eSpark-Backup/chrisbyrd-esp32iotproduct/Design Files/Adv-OLED-v2.1/Deliverables/Renderings/3D_Isometric_View.png

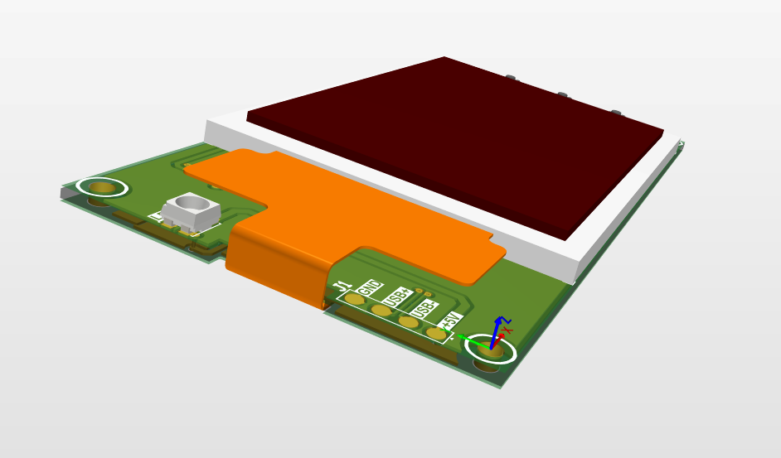
Design Files/Adv-OLED-v2.1/Deliverables/Renderings/3D_Isometric_View.png
