eSpark-Backup/chrisbyrd-esp32iotproduct/Design Files/Adv-OLED-v2.1/Deliverables/Renderings/3D_Top_View.PNG

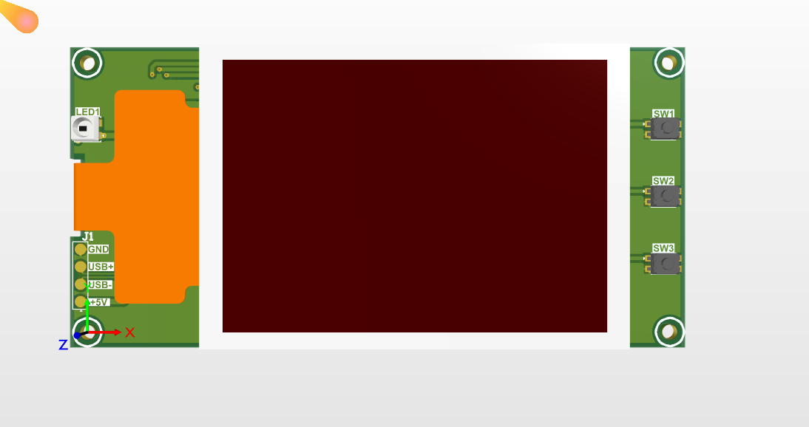
Design Files/Adv-OLED-v2.1/Deliverables/Renderings/3D_Top_View.PNG
