eSpark-Backup/chrisbyrd-esp32iotproduct/Design Files/Baseboard-v2.1/Deliverables/Renderings/2D_C_View.PNG.png

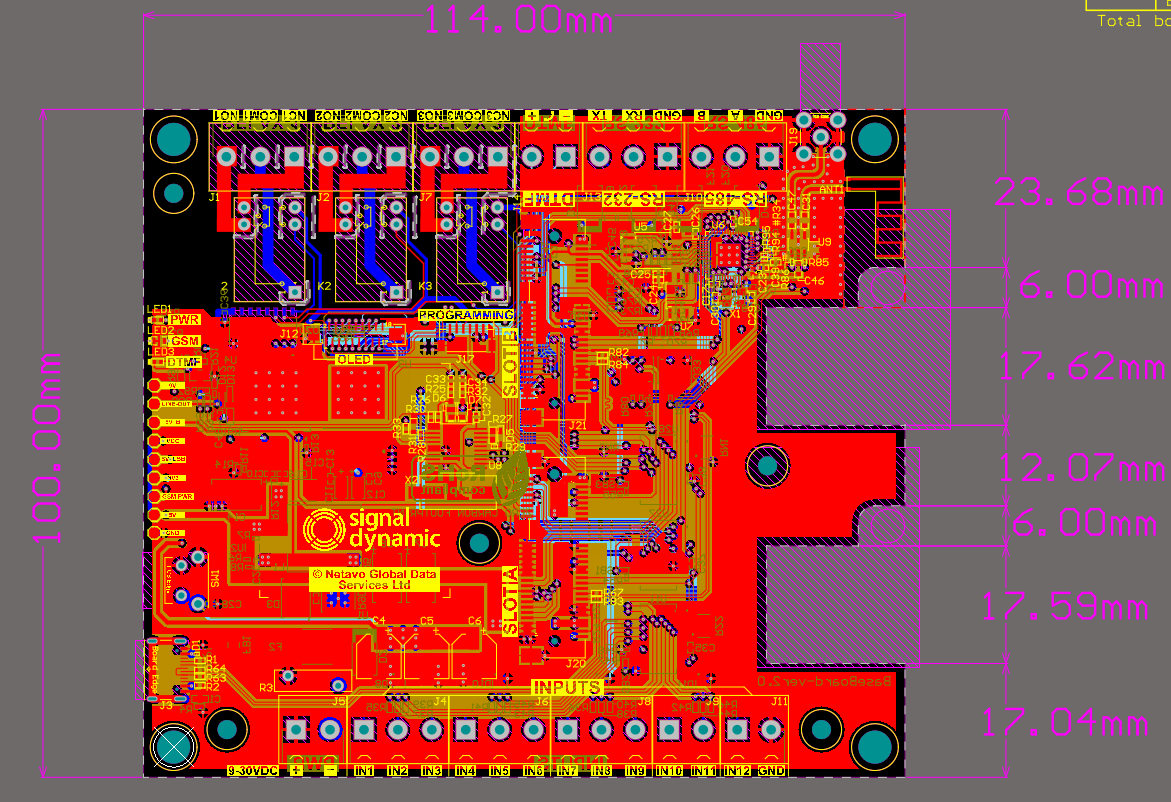
Design Files/Baseboard-v2.1/Deliverables/Renderings/2D_C_View.PNG.png
