eSpark-Backup/chrisbyrd-esp32iotproduct/Design Files/Baseboard-v2.1/Deliverables/Renderings/3D_Isometric_View.png

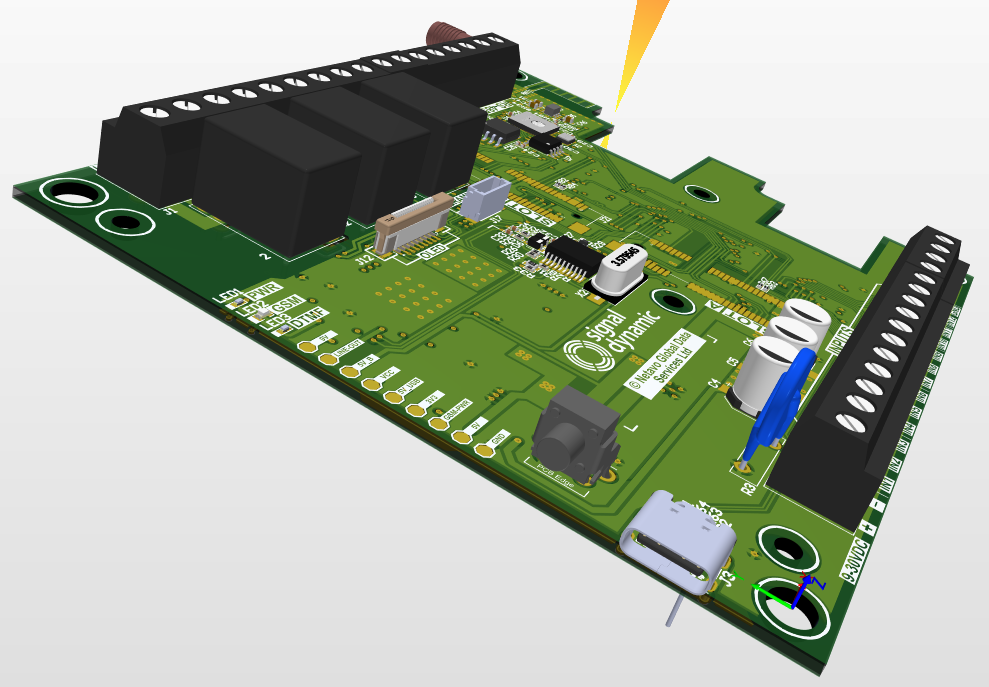
Design Files/Baseboard-v2.1/Deliverables/Renderings/3D_Isometric_View.png
