eSpark-Backup/chrisbyrd-esp32iotproduct/Design Files/LoRaWAN-Module-v2.0/Deliverables/Renderings/3d_Bottom_View.PNG

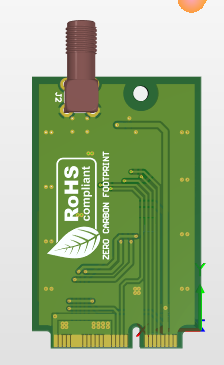
Design Files/LoRaWAN-Module-v2.0/Deliverables/Renderings/3d_Bottom_View.PNG
