eSpark-Backup/chrisbyrd-esp32iotproduct/Design Files/OLED-v2.1/Deliverables/Renderings/2D_Bottom_Layer.PNG

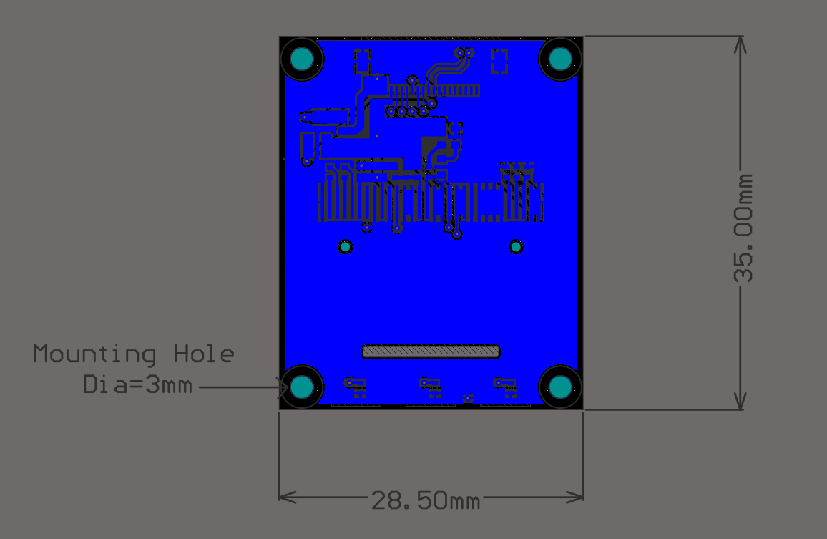
Design Files/OLED-v2.1/Deliverables/Renderings/2D_Bottom_Layer.PNG
