eSpark-Backup/chrisbyrd-esp32iotproduct/Design Files/OLED-v2.1/Deliverables/Renderings/2D_C_View.PNG

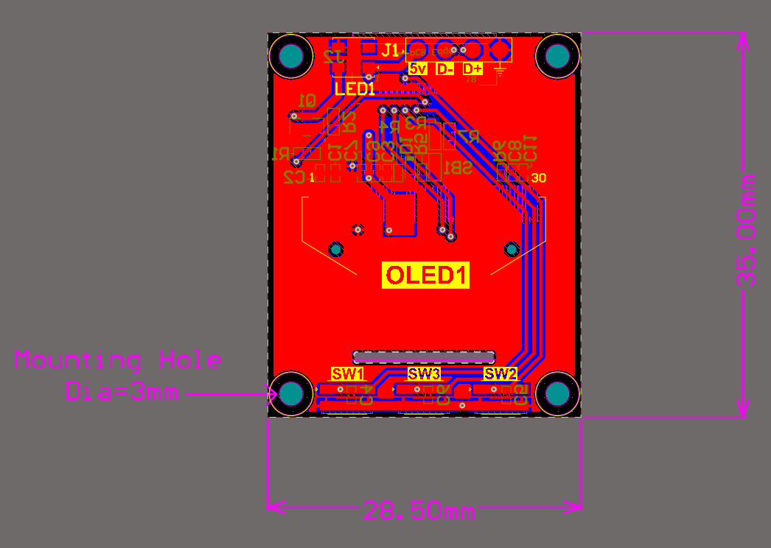
Design Files/OLED-v2.1/Deliverables/Renderings/2D_C_View.PNG
