eSpark-Backup/chrisbyrd-esp32iotproduct/Design Files/OLED-v2.1/Deliverables/Renderings/3D_Isometric_View.png

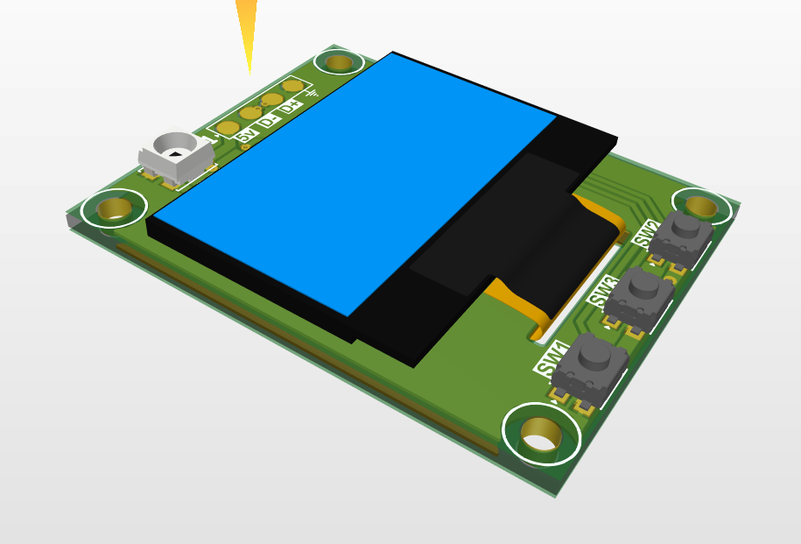
Design Files/OLED-v2.1/Deliverables/Renderings/3D_Isometric_View.png
