eSpark-Backup/chrisbyrd-esp32iotproduct/Design Files/Baseboard-v2.1/BOM/JLCPCB-BOM-Baseboard-v2.0.xlsx

Comment | Designator | Footprint | LCSC Part Number
Antenna | ANT1 | ANT*
4.7nF | C1 | Cap-0603 | C576818
0.1uf | C2, C9, C10, C13, C16, C17, C22, C23, C24, C27, C28, C32, C33, C34, C35, C36, C37, C38, C40, C41, C42, C43, C44, C45, C54 | Cap-0402 | C162178
10nF | C3, C19 | Cap-0402 | C60133
68uF | C4, C5, C6 | RVT1H680M0607 | C5221836
220uF | C7, C8 | Case-D | C8024
10uF | C11 | Case-A | C128253
47uF | C12 | Case-A | C129570
330uF | C14 | Case-E | C51599
100uF | C15 | Case-B | C7196
1uF | C18, C21, C26, C39 | Cap-0402 | C2880413
10uF | C20, C25, C48 | Cap-0402 | C315248
22PF | C29, C30 | Cap-0402 | C106203
330pF | C31, C46, C47 | Cap-0603 | C62784
PESD5V0H1BSFYL | D1 | DSN0603-2 | C477989
SMBJ36CA | D2 | SMB_ | C556189
ST20100L | D3 | TO-277 | C2693410
UDD32C03L01 | D4 | SOD-323 | C78439
1N4148WT | D5, D12, D13 | SOD-523F | C232841
BZT52C5V6S | D6, D7 | SOD-323 | C22612
BZX84C3V3TS-7-F | D8, D9, D10, D11 | SOT-363 | C5124989
SMBJ26CA | D40, D41, D42, D43 | SMB_ | C5331111
1206L300SLTHYR | F1 | Fuse 1206 (3216 Metric) | C207041
SHV2920P500-30-AA | F2 | Fuse-2920 | C495350
SMD0805P020TF | F19, F20, F21, F22 | Fuse-0805 | C20976
100MHz | FB1 | IND-1206 | C85841
DB128L-5.08-3P-BK-S | J1, J2, J4, J6, J7, J8, J10, J13 | DB128L-5.08-3P-BK-S | C430602
TYPE-C-31-M-12 | J3 | TYPE-C-31-M-12_ | C165948
DB128L-5.08-2P-BK-S | J5, J9, J11, J14 | DB128L-5.08-2P-BK-S | C430601
F0503-ZV-18-20T-R | J12 | F0503-ZV-18-20T-R | C481243
Voltlink Target | J17 | Voltlink Target | C145963
HJ-SMA175 | J19 | HJ-SMA175 | C1509213
91304-99-052R2 | J20, J21 | 91304-99-052R2 | C404126
J102K1CS35VDC.20 | K1, K2, K3 | J102K1CS35VDC.20
10uH | L1 | PSPMAA1040-100M-ANP | C2983105
2nH | L2 | IND-0603 (1608 Metric) | C370234
Green | LED1, LED3 | LED-0402 | C74338
RED | LED2 | LED-0603 | C1322287
TEST POINT | P1, P2, P3, P4, P5, P6, P7, P8, P9 | Test-point
MMBT4403LT1G | Q1 | sot-23 | C78864
5.1K | R1, R2 | Res-0402 | C542993
1M | R4 | Res-0402 | C144054
10K | R5, R7, R13, R34, R47, R48, R54, R55, R93, R94, R95, R96 | Res-0201 | C106225
1K | R6, R8, R10, R79, R80, R81, R85, R86 | Res-0201 | C3953443
3.24K | R9 | Res-0603 | C22994
100K | R11, R29 | Res-0201 | C106230
470R | R12, R20 | Res-0201 | C163491
47K | R14, R30 | Res-0402 | C93943
4.7K | R15, R16, R18, R19, R35, R36, R37, R38, R39, R40, R41, R42, R43, R44, R45, R46, R68, R69, R70, R71, R72, R77 | Res-0402 | C105871
499R | R17 | Res-0402 | C137970
0R | R21, R63, R64, R65, R66, R67, R82, R83, R84, R88, R89 | Res-0402 | C106231
100K | R22, R23, R24 | YC164-JR-070RL | C192933
56k | R25, R26, R32, R33 | Res-0402 | C114756
330K | R27 | Res-0603 | C114618
150K | R28 | Res-0402 | C137919
68K | R31 | Res-0603 | C705793
22R | R73, R74, R75, R76 | Res-0402 | C2086081
120R | R78 | Res-0603 | C114640
68R | R87 | Res-0402 | C445573
680R | R90, R91 | Res-0603 | C112310
3.3K | R92 | Res-0402 | C137992
10K | RN1, RN2 | YC164-FR-0710KL | C110924
Solder Bridge 0402 | SB1, SB2, SB3 | Solder Bridge 0402
1825027-8 | SW1 | 1825027-8 | C266196
TPS5450DDAR | U1 | 8-SO-EP_ | C114425
TPS2116DRLR | U2 | SOT-583 | C3235557
LM1084S-3.3/TR | U3 | TO263-3_ | C259972
MIC29302WU-TR | U4 | TO-263-5 (D2PAK) | C11149
W25Q64JVSSIQ TR | U5 | SOIC-8 (208 mil) | C179171
ESP32-S3R8 | U6 | 56-QFN (7x7)
ATECC608B-SSHDA-B | U7 | SOIC-8 | C5444784
MT8870DN1 | U8 | SSOP-20-208mil | C1522106
HMC221BETR | U9 | SOT-23-6 | C661296
MCP23017T-E/SS | U11, U27, U28 | SSOP-28-208mil | C558584
ULN2003A | U20 | SOP-16_150mil | C181730
MAX3232IDR | U30 | SOIC-16 | C18261
SP3485EIM/TR | U31 | SOP-8 | C519086
ADUM1201ARZ-RL7 | U32 | SOIC-8 | C9669
ADUM1200ARZ-RL7 | U33 | SOIC-8 | C15219
40MHz | X1 | X322540MPB4SI_ | C9010
3.579545MHz | X2 | HC-49S-SMD | C362352
