eSpark-Backup/chrisbyrd-esp32iotproduct/Design Files/LTE-Module-v2.0/BOM/JLCPCB-BOM-LTE_MODULE_v2.0.xlsx

Comment | Designator | Footprint | LCSC Part Number
W3011 | ANT1 | W3011
2.2pF | C1 | Cap-0603 | C282246
33pF | C2 | Cap-0402 | C441758
0.1uF | C5, C11, C13, C15, C16, C17 | Cap-0603 | C110022
220uF | C6 | Case-B | C30242
1uF | C7 | Cap-0603 | C14664
22PF | C8, C9, C10 | Cap-0402 | C106203
100nF | C12, C14 | cap-0402 | C361198
MMSZ5231BT1G | D1 | SOD-123 | C66198
ESD5651N-2/TR | D2, D3 | DFN1006-2L_ | C239784
PESD5V0H1BSFYL | D4 | DSN0603-2 | C477989
ESD5302F-3/TR | D5 | Sot-23 | C239643
SMD0603-050 | F1 | Fuse-0603 | C69679
HJ-SMA175 | J1 | HJ-SMA175 | C1509213
Mini PCIe | J2 | Mini PCIE Pad
POGO Connector 4 Pin | J3 | Pogo 4 Pin
XKNANO-113 | J4, J5 | XKNANO-113 | C381071
Yellow | LED1 | LED-0603 | C93689
RED | LED2 | LED-0603 | C1322287
MMBT3904M | Q1, Q2, Q3, Q4 | SOT-723 | C2923360
10K | R1, R2, R12 | Res-0603 | C140867
22R | R3, R5 | Res-0603 | C107701
0R | R4, R19 | Res-0603 | C100044
180R | R6, R9 | Res-0603 | C137786
4.7K | R7, R10, R13, R17 | Res-0603 | C105428
47K | R8, R11, R14, R18 | Res-0603 | C127447
SIM7500E | U1 | SIM7500E | C126259
FSA2567MPX | U2 | 16-MLP (3x3) | C512961
SMF05CT1G-ES | U3, U4 | SOT-363 | C5180312
TXB0102DCUT | U5 | VSSOP-8(2x2.3x0.5) | C2677366
