eSpark-Backup/chrisbyrd-esp32iotproduct/Design Files/OLED-v2.1/BOM/JLCPCB-BOM-OLED-v2.0.xlsx

Comment | Designator | Footprint | LCSC Part Number
1uF | C1, C2, C3, C9 | Cap-0402 | C106254
0.1uF | C4, C5, C6, C7 | Cap-0402 | C2181865
4.7uF | C8 | Cap-0402 | C326586
2.2uf | C11 | Cap-0402 | C385032
1SS355WT | D1 | SOD-523 | C2836063
POGO Connector 4 Pin | J1 | Pogo 4 Pin
F0502-B-18-15T-R | J2 | F0502-B-18-15T-R | C2889974
WS2812B-Mini | LED1 | WS2812B-Mini | C527089
N096-2864KSWEG01-H30 | OLED1 | N096-2864KSWEG01-H30 | C2890596
BSS138 | Q1 | Sot-23 | C426569
10K | R1, R2, R3, R7 | Res-0603 | C95204
4.7K | R4 | Res-0402 | C413001
0R | R5 | Res-0402 | C106231
412K | R6 | Res-0402 | C5126037
Solder Bridge 0603 | SB1 | Solder Bridge
TS-1185EC-C-D-B | SW1, SW2, SW3 | TS-1185EC-C-D-B_ | C318893
