eSpark-Backup/chrisbyrd-esp32iotproduct/Design Files/Adv-OLED-v2.1/BOM/Client_BOM_OLED-v2.0.xlsx

 |  | Component list |  | Bill of Materials for Project [OLED-v2.0.]
 |  | Source Data From: |  | OLED-v2.0.
 |  | Project: |  | OLED-v2.0.
 |  | Variant: |  | None
# | Item Type | Designator | Description | Footprint | Manufacturer Part Number | Manufacturer | Alternate Part Number | Value | Quantity | Quantity 5 Board | Remarks
1 | Capacitor | C4, C5, C6, C7 | CAP CER 0.1UF 50V X5R 0402 | Cap-0402 | C1005X5R1H104K050BB | TDK | - | 0.1uF | 4 | 20
2 | Capacitor | C9 | CAP CER 1UF 10V X5R 0402 | Cap-0402 | CC0402KRX5R6BB105 | Yageo | - | 1uF | 1 | 5
3 | Pogo Connector | ~~J1~~ | ~~Pogo Pad 2.5mm 4 Pin~~ | ~~Pogo 4 Pin~~ | ~~POGO Connector 4 Pin~~ | ~~-~~ | ~~-~~ | ~~-~~ | ~~1~~ | 5
4 | FPC Connector | J2, J3 | Clamshell -25℃~+85℃ 18P Bottom Contact Surface Mount 0.5mm SMD,P=0.5mm FFC/FPC Connectors ROHS | Custom | F0502-B-18-15T-R | XFCN | - | - | 2 | 10
5 | RGB LED | LED1 | SMD,3.5x3.5mm Light Emitting Diodes (LED) RoHS | Custom | WS2812B-Mini | Worldsemi | - | - | 1 | 5
6 | Mosfet | Q1 | 50V 220mA 3.5Ω@10V,220mA 225mW 1.6V@1mA N Channel SOT-23 MOSFETs ROHS | Sot-23 | BSS138 | Slkor(SLKORMICRO Elec.) | - | - | 1 | 5
7 | Mosfet | Q2 | Trans Gp Bjt NPN 25V 1.5A 300MW 3-PIN SOT-23 T/r | SOT-23 | SS8050-G | Comchip | - | - | 1 | 5
8 | Resistor | R1, R2, R3 | RES SMD 10K OHM 1% 1/20W 0201 | Res-0201 | RC0201FR-0710KL | Yageo | - | 10K | 3 | 15
9 | Resistor | R4 | RES 1K OHM 1% 1/20W 0201 | Res-0201 | RC0201FR-071KP | Yageo | RC0201FR-071KL | 1K | 1 | 5
10 | Resistor | R5, R6, R7, R8 | RES SMD 10 OHM 1% 1/5W 0402 | Res-0402 | CRCW040210R0FKEDHP | Vishay Dale | - | 10R | 4 | 20
11 | Switch | SW1, SW2, SW3 | 3mm 2mm Round Button 50mA Top3.65mm SPST 12V SMD Tactile Switches | Custom | TS-1185EC-C-D-B | XKB | - |  | 3 | 15
12 | Peripheral | - | 0.3mm~0.3mm 18 0.5mm Same Side 5cm P=0.5mm FFC/FPC Connect Cables ROHS | - | JS05A-18P-050-4-8 | JUSHUO | - | - | 1 | 5
12 | Peripheral | - | 2.4-inch tft LCD display SPI serial port color ST7789ILI9341 4IO port can be driven | - | ST7789ILI9341 | - | - | - | 1 | 5 | Reference Link (https://item.taobao.com/item.htm?spm=a1z09.2.0.0.41c32e8dRiNenm&id=45758568009&_u=2nd0n7r49f0)
