eSpark-Backup/chrisbyrd-esp32iotproduct/Design Files/Adv-OLED-v2.1/BOM/eSpark_BOM_OLED-v2.0.xlsx

 |  | Component list |  | Bill of Materials for Project [OLED-v2.0.]
 |  | Source Data From: |  | OLED-v2.0.
 |  | Project: |  | OLED-v2.0.
 |  | Variant: |  | None
# | Item Type | Designator | Description | Footprint | Manufacturer Part Number | Manufacturer | Alternate Part Number | LCSC Part Number | Value | Quantity | Quantity (5 Boards) | MOQ (5 Boards) | Links | Unit Cost (5 Boards) | Total Cost (5 Boards) | Remarks | Reviewer Remarks
1 | Capacitor | C4, C5, C6, C7 | CAP CER 0.1UF 50V X5R 0402 | Cap-0402 | C1005X5R1H104K050BB | TDK | - | C2181865 | 0.1uF | 4 | 20 | 25 | LCSC (https://www.lcsc.com/product-detail/Multilayer-Ceramic-Capacitors-MLCC-SMD-SMT_TDK-C1005X5R1H104K050BB_C2181865.html) | $0.0957 | $2.3925
2 | Capacitor | C9 | CAP CER 1UF 10V X5R 0402 | Cap-0402 | CC0402KRX5R6BB105 | Yageo | - | C106254 | 1uF | 1 | 5 | 100 | LCSC (https://www.lcsc.com/product-detail/Multilayer-Ceramic-Capacitors-MLCC-SMD-SMT_YAGEO-CC0402KRX5R6BB105_C106254.html) | $0.0024 | $0.2400
3 | Pogo Connector | ~~J1~~ | ~~Pogo Pad 2.5mm 4 Pin~~ | ~~Pogo 4 Pin~~ | ~~POGO Connector 4 Pin~~ | ~~-~~ | ~~-~~ | ~~-~~ | ~~-~~ | ~~1~~ | ~~5~~ | ~~-~~ | ~~-~~ | ~~-~~ | ~~-~~ | ~~-~~ | ~~-~~
4 | FPC Connector | J2, J3 | Clamshell -25℃~+85℃ 18P Bottom Contact Surface Mount 0.5mm SMD,P=0.5mm FFC/FPC Connectors ROHS | Custom | F0502-B-18-15T-R | XFCN | - | C2889974 | - | 2 | 10 | 15 | LCSC (https://www.lcsc.com/product-detail/FFC-FPC-Connectors_XFCN-F0502-B-18-15T-R_C2889974.html) | $0.0975 | $1.4625
5 | RGB LED | LED1 | SMD,3.5x3.5mm Light Emitting Diodes (LED) RoHS | Custom | WS2812B-Mini | Worldsemi | - | C527089 | - | 1 | 5 | 10 | LCSC (https://www.lcsc.com/product-detail/Light-Emitting-Diodes-LED_Worldsemi-WS2812B-Mini_C527089.html) | $0.1176 | $1.1760
6 | Mosfet | Q1 | 50V 220mA 3.5Ω@10V,220mA 225mW 1.6V@1mA N Channel SOT-23 MOSFETs ROHS | Sot-23 | BSS138 | Slkor(SLKORMICRO Elec.) | - | C426569 | - | 1 | 5 | 20 | LCSC (https://www.lcsc.com/product-detail/MOSFETs_Slkor-SLKORMICRO-Elec-BSS138_C426569.html) | $0.0215 | $0.4300
7 | Mosfet | Q2 | Trans Gp Bjt NPN 25V 1.5A 300MW 3-PIN SOT-23 T/r | SOT-23 | SS8050-G | Comchip | - | C105433 | - | 1 | 5 | 50 | LCSC (https://www.lcsc.com/product-detail/Bipolar-Transistors-BJT_Jiangsu-Changjing-Electronics-Technology-Co-Ltd-S8050_C105433.html) | $0.0154 | $0.7700
8 | Resistor | R1, R2, R3 | RES SMD 10K OHM 1% 1/20W 0201 | Res-0201 | RC0201FR-0710KL | Yageo | - | C106225 | 10K | 3 | 15 | 100 | LCSC (https://www.lcsc.com/product-detail/Chip-Resistor-Surface-Mount_YAGEO-RC0201FR-0710KL_C106225.html) | $0.0009 | $0.0900
9 | Resistor | R4 | RES 1K OHM 1% 1/20W 0201 | Res-0201 | RC0201FR-071KP | Yageo | RC0201FR-071KL | C138165 | 1K | 1 | 5 | 100 | LCSC (https://www.lcsc.com/product-detail/Chip-Resistor-Surface-Mount_YAGEO-RC0201FR-071KL_C138165.html) | $0.0009 | $0.0900
10 | Resistor | R5, R6, R7, R8 | RES SMD 10 OHM 1% 1/5W 0402 | Res-0402 | CRCW040210R0FKEDHP | Vishay Dale | - | C4013850 | 10R | 4 | 20 | 40 | LCSC (https://www.lcsc.com/product-detail/Chip-Resistor-Surface-Mount_Vishay-Intertech-CRCW040210R0FKEDHP_C4013850.html) | $0.0110 | $0.4400
11 | Switch | SW1, SW2, SW3 | 3mm 2mm Round Button 50mA Top3.65mm SPST 12V SMD Tactile Switches | Custom | TS-1185EC-C-D-B | XKB | - | C318893 |  | 3 | 15 | 20 | LCSC (https://www.lcsc.com/product-detail/Tactile-Switches_XKB-Connectivity-TS-1185EC-C-D-B_C318893.html) | $0.0555 | $1.1100
12 | Peripheral | - | 0.3mm~0.3mm 18 0.5mm Same Side 5cm P=0.5mm FFC/FPC Connect Cables ROHS | - | JS05A-18P-050-4-8 | JUSHUO | - | C2857498 | - | 1 | 5 | 10 | LCSC (https://www.lcsc.com/product-detail/FFC-FPC-Connect-Cables_JUSHUO-JS05A-18P-050-4-8_C2857498.html) | $0.0832 | $0.8320
13 | Peripheral | - | 2.4-inch tft LCD display SPI serial port color ST7789ILI9341 4IO port can be driven | - | - |  | - | - | - | 1 | 5 | 6 | Taobao (https://item.taobao.com/item.htm?spm=a1z09.2.0.0.41c32e8dRiNenm&id=45758568009&_u=2nd0n7r49f0) |  | $0.0000 |  | Quote Required
 |  |  |  |  |  |  |  |  |  |  |  | Total Component Cost |  |  | $9.03
 |  |  |  |  |  |  |  |  |  |  |  | Single Board Cost |  |  | $1.81
