eSpark-Backup/chrisbyrd-esp32iotproduct/Design Files/OLED-v2.1/BOM/Client_BOM_OLED-v2.0.xlsx

 |  | Component list |  | Bill of Materials for Project [OLED-v2.0.]
 |  | Source Data From: |  | OLED-v2.0.
 |  | Project: |  | OLED-v2.0.
 |  | Variant: |  | None
# | Item Type | Designator | Description | Footprint | Manufacturer Part Number | Alternate Part Number | Manufacturer | Value | Quantity | Quantity (10 Boards) | Remarks
1 | Capacitor | C1, C2, C3, C9 | CAP CER 1UF 10V X5R 0402 | Cap-0402 | CC0402KRX5R6BB105 | - | Yageo | 1uF | 4 | 40
2 | Capacitor | C4, C5, C6, C7 | CAP CER 0.1UF 50V X5R 0402 | Cap-0402 | C1005X5R1H104K050BB | - | TDK | 0.1uF | 4 | 40
3 | Capacitor | C8 | CAP CER 4.7UF 10V X5R 0402 | Cap-0402 | ~~CC0402KRX5R6BB475~~ | CL05A475KP5NRNC | Yageo | 4.7uF | 1 | 10
4 | Capacitor | C11 | CAP CER 2.2UF 25V X5R 0402 | Cap-0402 | GRM155R61E225KE11D | - | Murata | 2.2uf | 1 | 10
5 | Diode | D1 | 80V Single 1.2V@100mA 4ns 100mA SOD-523 Switching Diode ROHS | SOD-523 | 1SS355WT | - | CBI | - | 1 | 10
6 | Pogo Connector | ~~J1~~ | ~~Pogo Pad 2.5mm 4 Pin~~ | ~~Pogo 4 Pin~~ | ~~POGO Connector 4 Pin~~ | - | ~~-~~ | ~~-~~ | ~~1~~ | 10
7 | FPC Connector | J2 | Clamshell -25℃~+85℃ 18P Bottom Contact Surface Mount 0.5mm SMD,P=0.5mm FFC/FPC Connectors ROHS | Custom | F0502-B-18-15T-R | - | XFCN | - | 1 | 10
8 | RGB LED | LED1 | SMD,3.5x3.5mm Light Emitting Diodes (LED) RoHS | Custom | WS2812B-Mini | - | Worldsemi |  | 1 | 10
9 | OLED | OLED1 | SSD1306 0.96 - OLED Displays Modules ROHS | Custom | N096-2864KSWEG01-H30 | - | Newvisio |  | 1 | 10
10 | Mosfet | Q1 | 50V 220mA 3.5Ω@10V,220mA 225mW 1.6V@1mA N Channel SOT-23 MOSFETs ROHS | Sot-23 | BSS138 | - | Slkor(SLKORMICRO Elec.) |  | 1 | 10
11 | Resistor | R1, R2, R3, R7 | RES SMD 10K OHM 0.1% 1/10W 0603 | Res-0603 | RT0603BRD0710KL | - | Yageo | 10K | 4 | 40
12 | Resistor | R4 | RES SMD 4.7K OHM 5% 1/10W 0402 | Res-0402 | ERJ-2GEJ472X | - | Panasonic | 4.7K | 1 | 10
13 | Resistor | R5 | RES 0 OHM JUMPER 1/16W 0402 | Res-0402 | RC0402FR-070RL | - | Yageo | 0R | 1 | 10
14 | Resistor | R6 | ±1% 412kΩ 0402 Chip Resistor - Surface Mount ROHS | Res-0402 | FRC0402F4123TS | - | FOJAN | 412K | 1 | 10
15 | Solder Bridge | ~~SB1~~ | ~~Solder Bridge ON~~ | ~~Custom~~ | ~~Solder Bridge~~ | - | ~~-~~ | ~~-~~ | ~~1~~ | 10
16 | Switch | SW1, SW2, SW3 | 3mm 2mm Round Button 50mA Top3.65mm SPST 12V SMD Tactile Switches | Custom | TS-1185EC-C-D-B | - | XKB | - | 3 | 30
17 | Peripheral | - | 0.3mm~0.3mm 18 0.5mm Same Side 5cm P=0.5mm FFC/FPC Connect Cables ROHS | - | JS05A-18P-050-4-8 | - | JUSHUO | - | 1 | 10
