eSpark-Backup/chrisbyrd-esp32iotproduct/Design Files/OLED-v2.1/BOM/eSpark_BOM_OLED-v2.0.xlsx

Sheet: 5 Boards
 |  | Component list |  | Bill of Materials for Project [OLED-v2.0.]
 |  | Source Data From: |  | OLED-v2.0.
 |  | Project: |  | OLED-v2.0.
 |  | Variant: |  | None
# | Item Type | Designator | Description | Footprint | Manufacturer Part Number | Manufacturer | Alternate Part Number | LCSC Part Number | Value | Quantity | Quantity (5 Boards) | MOQ (5 Boards) | Links | Unit Cost (5 Boards) | Total Cost (5 Boards) | Remarks | Reviewer Remarks
1 | Capacitor | C1, C2, C3, C9 | CAP CER 1UF 10V X5R 0402 | Cap-0402 | CC0402KRX5R6BB105 | Yageo | - | C106254 | 1uF | 4 | 20 | 100 | LCSC (https://www.lcsc.com/product-detail/Multilayer-Ceramic-Capacitors-MLCC-SMD-SMT_YAGEO-CC0402KRX5R6BB105_C106254.html) | $0.0024 | $0.2400
2 | Capacitor | C4, C5, C6, C7 | CAP CER 0.1UF 50V X5R 0402 | Cap-0402 | C1005X5R1H104K050BB | TDK | - | C2181865 | 0.1uF | 4 | 20 | 25 | LCSC (https://www.lcsc.com/product-detail/Multilayer-Ceramic-Capacitors-MLCC-SMD-SMT_TDK-C1005X5R1H104K050BB_C2181865.html) | $0.0957 | $2.3925
3 | Capacitor | C8 | CAP CER 4.7UF 10V X5R 0402 | Cap-0402 | CC0402KRX5R6BB475 | Yageo | - | C326586 | 4.7uF | 1 | 5 | 50 | LCSC (https://www.lcsc.com/product-detail/Multilayer-Ceramic-Capacitors-MLCC-SMD-SMT_YAGEO-CC0402KRX5R6BB475_C326586.html) | $0.0146 | $0.7300
4 | Capacitor | C11 | CAP CER 2.2UF 25V X5R 0402 | Cap-0402 | GRM155R61E225KE11D | Murata | - | C385032 | 2.2uf | 1 | 5 | 20 | LCSC (https://www.lcsc.com/product-detail/Multilayer-Ceramic-Capacitors-MLCC-SMD-SMT_Murata-Electronics-GRM155R61E225KE11D_C385032.html) | $0.0317 | $0.6340
5 | Diode | D1 | 80V Single 1.2V@100mA 4ns 100mA SOD-523 Switching Diode ROHS | SOD-523 | 1SS355WT | CBI |  | C2836063 | - | 1 | 5 | 50 | LCSC (https://www.lcsc.com/product-detail/Switching-Diode_CBI-1SS355WT_C2836063.html) | $0.0099 | $0.4950
6 | Pogo Connector | ~~J1~~ | ~~Pogo Pad 2.5mm 4 Pin~~ | ~~Pogo 4 Pin~~ | ~~POGO Connector 4 Pin~~ | ~~-~~ | ~~-~~ | ~~-~~ | ~~-~~ | ~~1~~ | ~~5~~ | ~~-~~ | ~~-~~ | ~~-~~ | ~~-~~ | ~~-~~ | ~~-~~
7 | FPC Connector | J2 | Clamshell -25℃~+85℃ 18P Bottom Contact Surface Mount 0.5mm SMD,P=0.5mm FFC/FPC Connectors ROHS | Custom | F0502-B-18-15T-R | XFCN | - | C2889974 | - | 1 | 5 | 10 | LCSC (https://www.lcsc.com/product-detail/FFC-FPC-Connectors_XFCN-F0502-B-18-15T-R_C2889974.html) | $0.0981 | $0.9810
8 | RGB LED | LED1 | SMD,3.5x3.5mm Light Emitting Diodes (LED) RoHS | Custom | WS2812B-Mini | Worldsemi | - | C527089 | - | 1 | 5 | 10 | LCSC (https://www.lcsc.com/product-detail/Light-Emitting-Diodes-LED_Worldsemi-WS2812B-Mini_C527089.html) | $0.1176 | $1.1760
9 | OLED | OLED1 | SSD1306 0.96 - OLED Displays Modules ROHS | Custom | N096-2864KSWEG01-H30 | Newvisio | - | C2890596 | - | 1 | 5 | 6 | LCSC (https://www.lcsc.com/product-detail/OLED-Displays-Modules_Newvisio-N096-2864KSWEG01-H30_C2890596.html) | $1.9235 | $11.5410
10 | Mosfet | Q1 | 50V 220mA 3.5Ω@10V,220mA 225mW 1.6V@1mA N Channel SOT-23 MOSFETs ROHS | Sot-23 | BSS138 | Slkor(SLKORMICRO Elec.) | - | C426569 | - | 1 | 5 | 20 | LCSC (https://www.lcsc.com/product-detail/MOSFETs_Slkor-SLKORMICRO-Elec-BSS138_C426569.html) | $0.0215 | $0.4300
11 | Resistor | R1, R2, R3, R7 | RES SMD 10K OHM 0.1% 1/10W 0603 | Res-0603 | RT0603BRD0710KL | Yageo | - | C95204 | 10K | 4 | 20 | 40 | LCSC (https://www.lcsc.com/product-detail/Chip-Resistor-Surface-Mount_YAGEO-RT0603BRD0710KL_C95204.html) | $0.0217 | $0.8680
12 | Resistor | R4 | RES SMD 4.7K OHM 5% 1/10W 0402 | Res-0402 | ~~ERJ-2GEJ472X~~ | Panasonic | 0402WGF4701TCE | C25900 | 4.7K | 1 | 5 | 100 | LCSC (https://www.lcsc.com/product-detail/Chip-Resistor-Surface-Mount_UNI-ROYAL-Uniroyal-Elec-0402WGF4701TCE_C25900.html) | $0.0005 | $0.0500
13 | Resistor | R5 | RES 0 OHM JUMPER 1/16W 0402 | Res-0402 | RC0402FR-070RL | Yageo | - | C106231 | 0R | 1 | 5 | 100 | LCSC (https://www.lcsc.com/product-detail/Chip-Resistor-Surface-Mount_YAGEO-RC0402FR-070RL_C106231.html) | $0.0007 | $0.0700
14 | Resistor | R6 | ±1% 412kΩ 0402 Chip Resistor - Surface Mount ROHS | Res-0402 | FRC0402F4123TS | FOJAN | - | C5126037 | 412K | 1 | 5 | 100 | LCSC (https://www.lcsc.com/product-detail/Chip-Resistor-Surface-Mount_FOJAN-FRC0402F4123TS_C5126037.html) | $0.0006 | $0.0600
15 | Solder Bridge | ~~SB1~~ | ~~Solder Bridge ON~~ | ~~Custom~~ | ~~Solder Bridge~~ | ~~-~~ | ~~-~~ | ~~-~~ | ~~-~~ | ~~1~~ | ~~5~~ | ~~-~~ | ~~-~~ | ~~-~~ | ~~-~~
16 | Switch | SW1, SW2, SW3 | 3mm 2mm Round Button 50mA Top3.65mm SPST 12V SMD Tactile Switches | Custom | TS-1185EC-C-D-B | XKB | - | C318893 | - | 3 | 15 | 20 | LCSC (https://www.lcsc.com/product-detail/Tactile-Switches_XKB-Connectivity-TS-1185EC-C-D-B_C318893.html) | $0.0555 | $1.1100
17 | Peripheral | - | 0.3mm~0.3mm 18 0.5mm Same Side 5cm P=0.5mm FFC/FPC Connect Cables ROHS | - | JS05A-18P-050-4-8 | JUSHUO | - | C2857498 | - | 1 | 5 | 10 | LCSC (https://www.lcsc.com/product-detail/FFC-FPC-Connect-Cables_JUSHUO-JS05A-18P-050-4-8_C2857498.html) | $0.0832 | $0.8320
 |  |  |  |  |  |  |  |  |  |  |  | Total Component Cost |  |  | $21.61
 |  |  |  |  |  |  |  |  |  |  |  | Single Board Cost |  |  | $4.32

Sheet: 20 Boards
 |  | Component list |  | Bill of Materials for Project [OLED-v2.0.]
 |  | Source Data From: |  | OLED-v2.0.
 |  | Project: |  | OLED-v2.0.
 |  | Variant: |  | None
# | Item Type | Designator | Description | Footprint | Manufacturer Part Number | Manufacturer | Alternate Part Number | LCSC Part Number | Value | Quantity | Quantity (20 Boards) | MOQ (20 Boards) | Links | Unit Cost (20 Boards) | Total Cost (20 Boards) | Remarks | Reviewer Remarks
1 | Capacitor | C1, C2, C3, C9 | CAP CER 1UF 10V X5R 0402 | Cap-0402 | CC0402KRX5R6BB105 | Yageo | - | C106254 | 1uF | 4 | 80 | 100 | LCSC (https://www.lcsc.com/product-detail/Multilayer-Ceramic-Capacitors-MLCC-SMD-SMT_YAGEO-CC0402KRX5R6BB105_C106254.html) | $0.0024 | $0.2400
2 | Capacitor | C4, C5, C6, C7 | CAP CER 0.1UF 50V X5R 0402 | Cap-0402 | C1005X5R1H104K050BB | TDK | - | C2181865 | 0.1uF | 4 | 80 | 85 | LCSC (https://www.lcsc.com/product-detail/Multilayer-Ceramic-Capacitors-MLCC-SMD-SMT_TDK-C1005X5R1H104K050BB_C2181865.html) | $0.0790 | $6.7150
3 | Capacitor | C8 | CAP CER 4.7UF 10V X5R 0402 | Cap-0402 | CC0402KRX5R6BB475 | Yageo | - | C326586 | 4.7uF | 1 | 20 | 50 | LCSC (https://www.lcsc.com/product-detail/Multilayer-Ceramic-Capacitors-MLCC-SMD-SMT_YAGEO-CC0402KRX5R6BB475_C326586.html) | $0.0146 | $0.7300
4 | Capacitor | C11 | CAP CER 2.2UF 25V X5R 0402 | Cap-0402 | GRM155R61E225KE11D | Murata | - | C385032 | 2.2uf | 1 | 20 | 40 | LCSC (https://www.lcsc.com/product-detail/Multilayer-Ceramic-Capacitors-MLCC-SMD-SMT_Murata-Electronics-GRM155R61E225KE11D_C385032.html) | $0.0289 | $1.1560
5 | Diode | D1 | 80V Single 1.2V@100mA 4ns 100mA SOD-523 Switching Diode ROHS | SOD-523 | 1SS355WT | CBI |  | C2836063 | - | 1 | 20 | 50 | LCSC (https://www.lcsc.com/product-detail/Switching-Diode_CBI-1SS355WT_C2836063.html) | $0.0099 | $0.4950
6 | Pogo Connector | ~~J1~~ | ~~Pogo Pad 2.5mm 4 Pin~~ | ~~Pogo 4 Pin~~ | ~~POGO Connector 4 Pin~~ | ~~-~~ | ~~-~~ | ~~-~~ | ~~-~~ | ~~1~~ | ~~20~~ | ~~-~~ | ~~-~~ | ~~-~~ | ~~-~~ | ~~-~~ | ~~-~~
7 | FPC Connector | J2 | Clamshell -25℃~+85℃ 18P Bottom Contact Surface Mount 0.5mm SMD,P=0.5mm FFC/FPC Connectors ROHS | Custom | F0502-B-18-15T-R | XFCN | - | C2889974 | - | 1 | 20 | 25 | LCSC (https://www.lcsc.com/product-detail/FFC-FPC-Connectors_XFCN-F0502-B-18-15T-R_C2889974.html) | $0.0975 | $2.4375
8 | RGB LED | LED1 | SMD,3.5x3.5mm Light Emitting Diodes (LED) RoHS | Custom | WS2812B-Mini | Worldsemi | - | C527089 | - | 1 | 20 | 25 | LCSC (https://www.lcsc.com/product-detail/Light-Emitting-Diodes-LED_Worldsemi-WS2812B-Mini_C527089.html) | $0.1178 | $2.9450
9 | OLED | OLED1 | SSD1306 0.96 - OLED Displays Modules ROHS | Custom | N096-2864KSWEG01-H30 | Newvisio | - | C2890596 | - | 1 | 20 | 21 | LCSC (https://www.lcsc.com/product-detail/OLED-Displays-Modules_Newvisio-N096-2864KSWEG01-H30_C2890596.html) | $1.6689 | $35.0469
10 | Mosfet | Q1 | 50V 220mA 3.5Ω@10V,220mA 225mW 1.6V@1mA N Channel SOT-23 MOSFETs ROHS | Sot-23 | BSS138 | Slkor(SLKORMICRO Elec.) | - | C426569 | - | 1 | 20 | 40 | LCSC (https://www.lcsc.com/product-detail/MOSFETs_Slkor-SLKORMICRO-Elec-BSS138_C426569.html) | $0.0188 | $0.7520
11 | Resistor | R1, R2, R3, R7 | RES SMD 10K OHM 0.1% 1/10W 0603 | Res-0603 | RT0603BRD0710KL | Yageo | - | C95204 | 10K | 4 | 80 | 100 | LCSC (https://www.lcsc.com/product-detail/Chip-Resistor-Surface-Mount_YAGEO-RT0603BRD0710KL_C95204.html) | $0.0212 | $2.1200
12 | Resistor | R4 | RES SMD 4.7K OHM 5% 1/10W 0402 | Res-0402 | ~~ERJ-2GEJ472X~~ | Panasonic | 0402WGF4701TCE | C25900 | 4.7K | 1 | 20 | 100 | LCSC (https://www.lcsc.com/product-detail/Chip-Resistor-Surface-Mount_UNI-ROYAL-Uniroyal-Elec-0402WGF4701TCE_C25900.html) | $0.0005 | $0.0500
13 | Resistor | R5 | RES 0 OHM JUMPER 1/16W 0402 | Res-0402 | RC0402FR-070RL | Yageo | - | C106231 | 0R | 1 | 20 | 100 | LCSC (https://www.lcsc.com/product-detail/Chip-Resistor-Surface-Mount_YAGEO-RC0402FR-070RL_C106231.html) | $0.0007 | $0.0700
14 | Resistor | R6 | ±1% 412kΩ 0402 Chip Resistor - Surface Mount ROHS | Res-0402 | FRC0402F4123TS | FOJAN | - | C5126037 | 412K | 1 | 20 | 100 | LCSC (https://www.lcsc.com/product-detail/Chip-Resistor-Surface-Mount_FOJAN-FRC0402F4123TS_C5126037.html) | $0.0006 | $0.0600
15 | Solder Bridge | ~~SB1~~ | ~~Solder Bridge ON~~ | ~~Custom~~ | ~~Solder Bridge~~ | ~~-~~ | ~~-~~ | ~~-~~ | ~~-~~ | ~~1~~ | ~~20~~ | ~~-~~ | ~~-~~ | ~~-~~ | ~~-~~
16 | Switch | SW1, SW2, SW3 | 3mm 2mm Round Button 50mA Top3.65mm SPST 12V SMD Tactile Switches | Custom | TS-1185EC-C-D-B | XKB | - | C318893 | - | 3 | 60 | 70 | LCSC (https://www.lcsc.com/product-detail/Tactile-Switches_XKB-Connectivity-TS-1185EC-C-D-B_C318893.html) | $0.0555 | $3.8850
17 | Peripheral | - | 0.3mm~0.3mm 18 0.5mm Same Side 5cm P=0.5mm FFC/FPC Connect Cables ROHS | - | JS05A-18P-050-4-8 | JUSHUO | - | C2857498 | - | 1 | 20 | 25 | LCSC (https://www.lcsc.com/product-detail/FFC-FPC-Connect-Cables_JUSHUO-JS05A-18P-050-4-8_C2857498.html) | $0.0832 | $2.0800
 |  |  |  |  |  |  |  |  |  |  |  | Total Component Cost |  |  | $58.78
 |  |  |  |  |  |  |  |  |  |  |  | Single Board Cost |  |  | $2.94

Sheet: 50 Boards
 |  | Component list |  | Bill of Materials for Project [OLED-v2.0.]
 |  | Source Data From: |  | OLED-v2.0.
 |  | Project: |  | OLED-v2.0.
 |  | Variant: |  | None
# | Item Type | Designator | Description | Footprint | Manufacturer Part Number | Manufacturer | Alternate Part Number | LCSC Part Number | Value | Quantity | Quantity (50 Boards) | MOQ (50 Boards) | Links | Unit Cost (50 Boards) | Total Cost (50 Boards) | Remarks | Reviewer Remarks
1 | Capacitor | C1, C2, C3, C9 | CAP CER 1UF 10V X5R 0402 | Cap-0402 | CC0402KRX5R6BB105 | Yageo | - | C106254 | 1uF | 4 | 200 | 200 | LCSC (https://www.lcsc.com/product-detail/Multilayer-Ceramic-Capacitors-MLCC-SMD-SMT_YAGEO-CC0402KRX5R6BB105_C106254.html) | $0.0024 | $0.4800
2 | Capacitor | C4, C5, C6, C7 | CAP CER 0.1UF 50V X5R 0402 | Cap-0402 | C1005X5R1H104K050BB | TDK | - | C2181865 | 0.1uF | 4 | 200 | 205 | LCSC (https://www.lcsc.com/product-detail/Multilayer-Ceramic-Capacitors-MLCC-SMD-SMT_TDK-C1005X5R1H104K050BB_C2181865.html) | $0.0706 | $14.4730
3 | Capacitor | C8 | CAP CER 4.7UF 10V X5R 0402 | Cap-0402 | CC0402KRX5R6BB475 | Yageo | - | C326586 | 4.7uF | 1 | 50 | 100 | LCSC (https://www.lcsc.com/product-detail/Multilayer-Ceramic-Capacitors-MLCC-SMD-SMT_YAGEO-CC0402KRX5R6BB475_C326586.html) | $0.0148 | $1.4800
4 | Capacitor | C11 | CAP CER 2.2UF 25V X5R 0402 | Cap-0402 | GRM155R61E225KE11D | Murata | - | C385032 | 2.2uf | 1 | 50 | 60 | LCSC (https://www.lcsc.com/product-detail/Multilayer-Ceramic-Capacitors-MLCC-SMD-SMT_Murata-Electronics-GRM155R61E225KE11D_C385032.html) | $0.0289 | $1.7340
5 | Diode | D1 | 80V Single 1.2V@100mA 4ns 100mA SOD-523 Switching Diode ROHS | SOD-523 | 1SS355WT | CBI |  | C2836063 | - | 1 | 50 | 100 | LCSC (https://www.lcsc.com/product-detail/Switching-Diode_CBI-1SS355WT_C2836063.html) | $0.0090 | $0.9000
6 | Pogo Connector | ~~J1~~ | ~~Pogo Pad 2.5mm 4 Pin~~ | ~~Pogo 4 Pin~~ | ~~POGO Connector 4 Pin~~ | ~~-~~ | ~~-~~ | ~~-~~ | ~~-~~ | ~~1~~ | ~~50~~ | ~~-~~ | ~~-~~ | ~~-~~ | ~~-~~ | ~~-~~ | ~~-~~
7 | FPC Connector | J2 | Clamshell -25℃~+85℃ 18P Bottom Contact Surface Mount 0.5mm SMD,P=0.5mm FFC/FPC Connectors ROHS | Custom | F0502-B-18-15T-R | XFCN | - | C2889974 | - | 1 | 50 | 55 | LCSC (https://www.lcsc.com/product-detail/FFC-FPC-Connectors_XFCN-F0502-B-18-15T-R_C2889974.html) | $0.0792 | $4.3560
8 | RGB LED | LED1 | SMD,3.5x3.5mm Light Emitting Diodes (LED) RoHS | Custom | WS2812B-Mini | Worldsemi | - | C527089 | - | 1 | 50 | 55 | LCSC (https://www.lcsc.com/product-detail/Light-Emitting-Diodes-LED_Worldsemi-WS2812B-Mini_C527089.html) | $0.0987 | $5.4285
9 | OLED | OLED1 | SSD1306 0.96 - OLED Displays Modules ROHS | Custom | N096-2864KSWEG01-H30 | Newvisio | - | C2890596 | - | 1 | 50 | 51 | LCSC (https://www.lcsc.com/product-detail/OLED-Displays-Modules_Newvisio-N096-2864KSWEG01-H30_C2890596.html) | $1.6689 | $85.1139
10 | Mosfet | Q1 | 50V 220mA 3.5Ω@10V,220mA 225mW 1.6V@1mA N Channel SOT-23 MOSFETs ROHS | Sot-23 | BSS138 | Slkor(SLKORMICRO Elec.) | - | C426569 | - | 1 | 50 | 60 | LCSC (https://www.lcsc.com/product-detail/MOSFETs_Slkor-SLKORMICRO-Elec-BSS138_C426569.html) | $0.0188 | $1.1280
11 | Resistor | R1, R2, R3, R7 | RES SMD 10K OHM 0.1% 1/10W 0603 | Res-0603 | RT0603BRD0710KL | Yageo | - | C95204 | 10K | 4 | 200 | 300 | LCSC (https://www.lcsc.com/product-detail/Chip-Resistor-Surface-Mount_YAGEO-RT0603BRD0710KL_C95204.html) | $0.0212 | $6.3600
12 | Resistor | R4 | RES SMD 4.7K OHM 5% 1/10W 0402 | Res-0402 | ~~ERJ-2GEJ472X~~ | Panasonic | 0402WGF4701TCE | C25900 | 4.7K | 1 | 50 | 100 | LCSC (https://www.lcsc.com/product-detail/Chip-Resistor-Surface-Mount_UNI-ROYAL-Uniroyal-Elec-0402WGF4701TCE_C25900.html) | $0.0005 | $0.0500
13 | Resistor | R5 | RES 0 OHM JUMPER 1/16W 0402 | Res-0402 | RC0402FR-070RL | Yageo | - | C106231 | 0R | 1 | 50 | 100 | LCSC (https://www.lcsc.com/product-detail/Chip-Resistor-Surface-Mount_YAGEO-RC0402FR-070RL_C106231.html) | $0.0007 | $0.0700
14 | Resistor | R6 | ±1% 412kΩ 0402 Chip Resistor - Surface Mount ROHS | Res-0402 | FRC0402F4123TS | FOJAN | - | C5126037 | 412K | 1 | 50 | 100 | LCSC (https://www.lcsc.com/product-detail/Chip-Resistor-Surface-Mount_FOJAN-FRC0402F4123TS_C5126037.html) | $0.0006 | $0.0600
15 | Solder Bridge | ~~SB1~~ | ~~Solder Bridge ON~~ | ~~Custom~~ | ~~Solder Bridge~~ | ~~-~~ | ~~-~~ | ~~-~~ | ~~-~~ | ~~1~~ | ~~50~~ | ~~-~~ | ~~-~~ | ~~-~~ | ~~-~~
16 | Switch | SW1, SW2, SW3 | 3mm 2mm Round Button 50mA Top3.65mm SPST 12V SMD Tactile Switches | Custom | TS-1185EC-C-D-B | XKB | - | C318893 | - | 3 | 150 | 160 | LCSC (https://www.lcsc.com/product-detail/Tactile-Switches_XKB-Connectivity-TS-1185EC-C-D-B_C318893.html) | $0.0454 | $7.2640
17 | Peripheral | - | 0.3mm~0.3mm 18 0.5mm Same Side 5cm P=0.5mm FFC/FPC Connect Cables ROHS | - | JS05A-18P-050-4-8 | JUSHUO | - | C2857498 | - | 1 | 50 | 55 | LCSC (https://www.lcsc.com/product-detail/FFC-FPC-Connect-Cables_JUSHUO-JS05A-18P-050-4-8_C2857498.html) | $0.0618 | $3.3990
 |  |  |  |  |  |  |  |  |  |  |  | Total Component Cost |  |  | $132.30
 |  |  |  |  |  |  |  |  |  |  |  | Single Board Cost |  |  | $2.65

Sheet: 100 Boards
 |  | Component list |  | Bill of Materials for Project [OLED-v2.0.]
 |  | Source Data From: |  | OLED-v2.0.
 |  | Project: |  | OLED-v2.0.
 |  | Variant: |  | None
# | Item Type | Designator | Description | Footprint | Manufacturer Part Number | Manufacturer | Alternate Part Number | LCSC Part Number | Value | Quantity | Quantity (100 Boards) | MOQ (100 Boards) | Links | Unit Cost (100 Boards) | Total Cost (100 Boards) | Remarks | Reviewer Remarks
1 | Capacitor | C1, C2, C3, C9 | CAP CER 1UF 10V X5R 0402 | Cap-0402 | CC0402KRX5R6BB105 | Yageo | - | C106254 | 1uF | 4 | 400 | 500 | LCSC (https://www.lcsc.com/product-detail/Multilayer-Ceramic-Capacitors-MLCC-SMD-SMT_YAGEO-CC0402KRX5R6BB105_C106254.html) | $0.0024 | $1.2000
2 | Capacitor | C4, C5, C6, C7 | CAP CER 0.1UF 50V X5R 0402 | Cap-0402 | C1005X5R1H104K050BB | TDK | - | C2181865 | 0.1uF | 4 | 400 | 405 | LCSC (https://www.lcsc.com/product-detail/Multilayer-Ceramic-Capacitors-MLCC-SMD-SMT_TDK-C1005X5R1H104K050BB_C2181865.html) | $0.0706 | $28.5930
3 | Capacitor | C8 | CAP CER 4.7UF 10V X5R 0402 | Cap-0402 | CC0402KRX5R6BB475 | Yageo | - | C326586 | 4.7uF | 1 | 100 | 150 | LCSC (https://www.lcsc.com/product-detail/Multilayer-Ceramic-Capacitors-MLCC-SMD-SMT_YAGEO-CC0402KRX5R6BB475_C326586.html) | $0.0146 | $2.1900
4 | Capacitor | C11 | CAP CER 2.2UF 25V X5R 0402 | Cap-0402 | GRM155R61E225KE11D | Murata | - | C385032 | 2.2uf | 1 | 100 | 120 | LCSC (https://www.lcsc.com/product-detail/Multilayer-Ceramic-Capacitors-MLCC-SMD-SMT_Murata-Electronics-GRM155R61E225KE11D_C385032.html) | $0.0289 | $3.4680
5 | Diode | D1 | 80V Single 1.2V@100mA 4ns 100mA SOD-523 Switching Diode ROHS | SOD-523 | 1SS355WT | CBI |  | C2836063 | - | 1 | 100 | 150 | LCSC (https://www.lcsc.com/product-detail/Switching-Diode_CBI-1SS355WT_C2836063.html) | $0.0099 | $1.4850
6 | Pogo Connector | ~~J1~~ | ~~Pogo Pad 2.5mm 4 Pin~~ | ~~Pogo 4 Pin~~ | ~~POGO Connector 4 Pin~~ | ~~-~~ | ~~-~~ | ~~-~~ | ~~-~~ | ~~1~~ | ~~100~~ | ~~-~~ | ~~-~~ | ~~-~~ | ~~-~~ | ~~-~~ | ~~-~~
7 | FPC Connector | J2 | Clamshell -25℃~+85℃ 18P Bottom Contact Surface Mount 0.5mm SMD,P=0.5mm FFC/FPC Connectors ROHS | Custom | F0502-B-18-15T-R | XFCN | - | C2889974 | - | 1 | 100 | 105 | LCSC (https://www.lcsc.com/product-detail/FFC-FPC-Connectors_XFCN-F0502-B-18-15T-R_C2889974.html) | $0.0792 | $8.3160
8 | RGB LED | LED1 | SMD,3.5x3.5mm Light Emitting Diodes (LED) RoHS | Custom | WS2812B-Mini | Worldsemi | - | C527089 | - | 1 | 100 | 105 | LCSC (https://www.lcsc.com/product-detail/Light-Emitting-Diodes-LED_Worldsemi-WS2812B-Mini_C527089.html) | $0.0987 | $10.3635
9 | OLED | OLED1 | SSD1306 0.96 - OLED Displays Modules ROHS | Custom | N096-2864KSWEG01-H30 | Newvisio | - | C2890596 | - | 1 | 100 | 101 | LCSC (https://www.lcsc.com/product-detail/OLED-Displays-Modules_Newvisio-N096-2864KSWEG01-H30_C2890596.html) | $1.6371 | $165.3471
10 | Mosfet | Q1 | 50V 220mA 3.5Ω@10V,220mA 225mW 1.6V@1mA N Channel SOT-23 MOSFETs ROHS | Sot-23 | BSS138 | Slkor(SLKORMICRO Elec.) | - | C426569 | - | 1 | 100 | 120 | LCSC (https://www.lcsc.com/product-detail/MOSFETs_Slkor-SLKORMICRO-Elec-BSS138_C426569.html) | $0.0188 | $2.2560
11 | Resistor | R1, R2, R3, R7 | RES SMD 10K OHM 0.1% 1/10W 0603 | Res-0603 | RT0603BRD0710KL | Yageo | - | C95204 | 10K | 4 | 400 | 500 | LCSC (https://www.lcsc.com/product-detail/Chip-Resistor-Surface-Mount_YAGEO-RT0603BRD0710KL_C95204.html) | $0.0169 | $8.4500
12 | Resistor | R4 | RES SMD 4.7K OHM 5% 1/10W 0402 | Res-0402 | ~~ERJ-2GEJ472X~~ | Panasonic | 0402WGF4701TCE | C25900 | 4.7K | 1 | 100 | 200 | LCSC (https://www.lcsc.com/product-detail/Chip-Resistor-Surface-Mount_UNI-ROYAL-Uniroyal-Elec-0402WGF4701TCE_C25900.html) | $0.0005 | $0.1000
13 | Resistor | R5 | RES 0 OHM JUMPER 1/16W 0402 | Res-0402 | RC0402FR-070RL | Yageo | - | C106231 | 0R | 1 | 100 | 200 | LCSC (https://www.lcsc.com/product-detail/Chip-Resistor-Surface-Mount_YAGEO-RC0402FR-070RL_C106231.html) | $0.0007 | $0.1400
14 | Resistor | R6 | ±1% 412kΩ 0402 Chip Resistor - Surface Mount ROHS | Res-0402 | FRC0402F4123TS | FOJAN | - | C5126037 | 412K | 1 | 100 | 200 | LCSC (https://www.lcsc.com/product-detail/Chip-Resistor-Surface-Mount_FOJAN-FRC0402F4123TS_C5126037.html) | $0.0004 | $0.0800
15 | Solder Bridge | ~~SB1~~ | ~~Solder Bridge ON~~ | ~~Custom~~ | ~~Solder Bridge~~ | ~~-~~ | ~~-~~ | ~~-~~ | ~~-~~ | ~~1~~ | 100 | ~~-~~ | ~~-~~ | ~~-~~ | ~~-~~
16 | Switch | SW1, SW2, SW3 | 3mm 2mm Round Button 50mA Top3.65mm SPST 12V SMD Tactile Switches | Custom | TS-1185EC-C-D-B | XKB | - | C318893 | - | 3 | 300 | 320 | LCSC (https://www.lcsc.com/product-detail/Tactile-Switches_XKB-Connectivity-TS-1185EC-C-D-B_C318893.html) | $0.0403 | $12.8960
17 | Peripheral | - | 0.3mm~0.3mm 18 0.5mm Same Side 5cm P=0.5mm FFC/FPC Connect Cables ROHS | - | JS05A-18P-050-4-8 | JUSHUO | - | C2857498 | - | 1 | 100 | 105 | LCSC (https://www.lcsc.com/product-detail/FFC-FPC-Connect-Cables_JUSHUO-JS05A-18P-050-4-8_C2857498.html) | $0.0618 | $6.4890
 |  |  |  |  |  |  |  |  |  |  |  | Total Component Cost |  |  | $251.37
 |  |  |  |  |  |  |  |  |  |  |  | Single Board Cost |  |  | $2.51

Sheet: 500 Boards
 |  | Component list |  | Bill of Materials for Project [OLED-v2.0.]
 |  | Source Data From: |  | OLED-v2.0.
 |  | Project: |  | OLED-v2.0.
 |  | Variant: |  | None
# | Item Type | Designator | Description | Footprint | Manufacturer Part Number | Manufacturer | Alternate Part Number | LCSC Part Number | Value | Quantity | Quantity (500 Boards) | MOQ (500 Boards) | Links | Unit Cost (500 Boards) | Total Cost (500 Boards) | Remarks | Reviewer Remarks
1 | Capacitor | C1, C2, C3, C9 | CAP CER 1UF 10V X5R 0402 | Cap-0402 | CC0402KRX5R6BB105 | Yageo | - | C106254 | 1uF | 4 | 2000 | 2100 | LCSC (https://www.lcsc.com/product-detail/Multilayer-Ceramic-Capacitors-MLCC-SMD-SMT_YAGEO-CC0402KRX5R6BB105_C106254.html) | $0.0019 | $3.9900
2 | Capacitor | C4, C5, C6, C7 | CAP CER 0.1UF 50V X5R 0402 | Cap-0402 | C1005X5R1H104K050BB | TDK | - | C2181865 | 0.1uF | 4 | 2000 | 2005 | LCSC (https://www.lcsc.com/product-detail/Multilayer-Ceramic-Capacitors-MLCC-SMD-SMT_TDK-C1005X5R1H104K050BB_C2181865.html) | $0.0643 | $128.9215
3 | Capacitor | C8 | CAP CER 4.7UF 10V X5R 0402 | Cap-0402 | CC0402KRX5R6BB475 | Yageo | - | C326586 | 4.7uF | 1 | 500 | 550 | LCSC (https://www.lcsc.com/product-detail/Multilayer-Ceramic-Capacitors-MLCC-SMD-SMT_YAGEO-CC0402KRX5R6BB475_C326586.html) | $0.0121 | $6.6550
4 | Capacitor | C11 | CAP CER 2.2UF 25V X5R 0402 | Cap-0402 | GRM155R61E225KE11D | Murata | - | C385032 | 2.2uf | 1 | 500 | 520 | LCSC (https://www.lcsc.com/product-detail/Multilayer-Ceramic-Capacitors-MLCC-SMD-SMT_Murata-Electronics-GRM155R61E225KE11D_C385032.html) | $0.0235 | $12.2200
5 | Diode | D1 | 80V Single 1.2V@100mA 4ns 100mA SOD-523 Switching Diode ROHS | SOD-523 | 1SS355WT | CBI |  | C2836063 | - | 1 | 500 | 550 | LCSC (https://www.lcsc.com/product-detail/Switching-Diode_CBI-1SS355WT_C2836063.html) | $0.0072 | $3.9600
6 | Pogo Connector | ~~J1~~ | ~~Pogo Pad 2.5mm 4 Pin~~ | ~~Pogo 4 Pin~~ | ~~POGO Connector 4 Pin~~ | ~~-~~ | ~~-~~ | ~~-~~ | ~~-~~ | ~~1~~ | ~~500~~ | ~~-~~ | ~~-~~ | ~~-~~ | ~~-~~ | ~~-~~ | ~~-~~
7 | FPC Connector | J2 | Clamshell -25℃~+85℃ 18P Bottom Contact Surface Mount 0.5mm SMD,P=0.5mm FFC/FPC Connectors ROHS | Custom | F0502-B-18-15T-R | XFCN | - | C2889974 | - | 1 | 500 | 505 | LCSC (https://www.lcsc.com/product-detail/FFC-FPC-Connectors_XFCN-F0502-B-18-15T-R_C2889974.html) | $0.0632 | $31.9160
8 | RGB LED | LED1 | SMD,3.5x3.5mm Light Emitting Diodes (LED) RoHS | Custom | WS2812B-Mini | Worldsemi | - | C527089 | - | 1 | 500 | 505 | LCSC (https://www.lcsc.com/product-detail/Light-Emitting-Diodes-LED_Worldsemi-WS2812B-Mini_C527089.html) | $0.0742 | $37.4710
9 | OLED | OLED1 | SSD1306 0.96 - OLED Displays Modules ROHS | Custom | N096-2864KSWEG01-H30 | Newvisio | - | C2890596 | - | 1 | 500 | 501 | LCSC (https://www.lcsc.com/product-detail/OLED-Displays-Modules_Newvisio-N096-2864KSWEG01-H30_C2890596.html) | $1.3316 | $667.1316
10 | Mosfet | Q1 | 50V 220mA 3.5Ω@10V,220mA 225mW 1.6V@1mA N Channel SOT-23 MOSFETs ROHS | Sot-23 | BSS138 | Slkor(SLKORMICRO Elec.) | - | C426569 | - | 1 | 500 | 520 | LCSC (https://www.lcsc.com/product-detail/MOSFETs_Slkor-SLKORMICRO-Elec-BSS138_C426569.html) | $0.0150 | $7.8000
11 | Resistor | R1, R2, R3, R7 | RES SMD 10K OHM 0.1% 1/10W 0603 | Res-0603 | RT0603BRD0710KL | Yageo | - | C95204 | 10K | 4 | 2000 | 2020 | LCSC (https://www.lcsc.com/product-detail/Chip-Resistor-Surface-Mount_YAGEO-RT0603BRD0710KL_C95204.html) | $0.0150 | $30.3000
12 | Resistor | R4 | RES SMD 4.7K OHM 5% 1/10W 0402 | Res-0402 | ~~ERJ-2GEJ472X~~ | Panasonic | 0402WGF4701TCE | C25900 | 4.7K | 1 | 500 | 600 | LCSC (https://www.lcsc.com/product-detail/Chip-Resistor-Surface-Mount_UNI-ROYAL-Uniroyal-Elec-0402WGF4701TCE_C25900.html) | $0.0005 | $0.3000
13 | Resistor | R5 | RES 0 OHM JUMPER 1/16W 0402 | Res-0402 | RC0402FR-070RL | Yageo | - | C106231 | 0R | 1 | 500 | 600 | LCSC (https://www.lcsc.com/product-detail/Chip-Resistor-Surface-Mount_YAGEO-RC0402FR-070RL_C106231.html) | $0.0007 | $0.4200
14 | Resistor | R6 | ±1% 412kΩ 0402 Chip Resistor - Surface Mount ROHS | Res-0402 | FRC0402F4123TS | FOJAN | - | C5126037 | 412K | 1 | 500 | 600 | LCSC (https://www.lcsc.com/product-detail/Chip-Resistor-Surface-Mount_FOJAN-FRC0402F4123TS_C5126037.html) | $0.0006 | $0.3600
15 | Solder Bridge | ~~SB1~~ | ~~Solder Bridge ON~~ | ~~Custom~~ | ~~Solder Bridge~~ | ~~-~~ | ~~-~~ | ~~-~~ | ~~-~~ | ~~1~~ | ~~500~~ | ~~-~~ | ~~-~~ | ~~-~~ | ~~-~~
16 | Switch | SW1, SW2, SW3 | 3mm 2mm Round Button 50mA Top3.65mm SPST 12V SMD Tactile Switches | Custom | TS-1185EC-C-D-B | XKB | - | C318893 | - | 3 | 1500 | 1520 | LCSC (https://www.lcsc.com/product-detail/Tactile-Switches_XKB-Connectivity-TS-1185EC-C-D-B_C318893.html) | $0.0403 | $61.2560
17 | Peripheral | - | 0.3mm~0.3mm 18 0.5mm Same Side 5cm P=0.5mm FFC/FPC Connect Cables ROHS | - | JS05A-18P-050-4-8 | JUSHUO | - | C2857498 | - | 1 | 500 | 505 | LCSC (https://www.lcsc.com/product-detail/FFC-FPC-Connect-Cables_JUSHUO-JS05A-18P-050-4-8_C2857498.html) | $0.0483 | $24.3915
 |  |  |  |  |  |  |  |  |  |  |  | Total Component Cost |  |  | $1017.09
 |  |  |  |  |  |  |  |  |  |  |  | Single Board Cost |  |  | $2.03

Sheet: 1000 Boards
 |  | Component list |  | Bill of Materials for Project [OLED-v2.0.]
 |  | Source Data From: |  | OLED-v2.0.
 |  | Project: |  | OLED-v2.0.
 |  | Variant: |  | None
# | Item Type | Designator | Description | Footprint | Manufacturer Part Number | Manufacturer | Alternate Part Number | LCSC Part Number | Value | Quantity | Quantity (1000 Boards) | MOQ (1000 Boards) | Links | Unit Cost (1000 Boards) | Total Cost (1000 Boards) | Remarks | Reviewer Remarks
1 | Capacitor | C1, C2, C3, C9 | CAP CER 1UF 10V X5R 0402 | Cap-0402 | CC0402KRX5R6BB105 | Yageo | - | C106254 | 1uF | 4 | 4000 | 4100 | LCSC (https://www.lcsc.com/product-detail/Multilayer-Ceramic-Capacitors-MLCC-SMD-SMT_YAGEO-CC0402KRX5R6BB105_C106254.html) | $0.0016 | $6.5600
2 | Capacitor | C4, C5, C6, C7 | CAP CER 0.1UF 50V X5R 0402 | Cap-0402 | C1005X5R1H104K050BB | TDK | - | C2181865 | 0.1uF | 4 | 4000 | 4005 | LCSC (https://www.lcsc.com/product-detail/Multilayer-Ceramic-Capacitors-MLCC-SMD-SMT_TDK-C1005X5R1H104K050BB_C2181865.html) | $0.0568 | $227.4840
3 | Capacitor | C8 | CAP CER 4.7UF 10V X5R 0402 | Cap-0402 | CC0402KRX5R6BB475 | Yageo | - | C326586 | 4.7uF | 1 | 1000 | 1050 | LCSC (https://www.lcsc.com/product-detail/Multilayer-Ceramic-Capacitors-MLCC-SMD-SMT_YAGEO-CC0402KRX5R6BB475_C326586.html) | $0.0121 | $12.7050
4 | Capacitor | C11 | CAP CER 2.2UF 25V X5R 0402 | Cap-0402 | GRM155R61E225KE11D | Murata | - | C385032 | 2.2uf | 1 | 1000 | 1020 | LCSC (https://www.lcsc.com/product-detail/Multilayer-Ceramic-Capacitors-MLCC-SMD-SMT_Murata-Electronics-GRM155R61E225KE11D_C385032.html) | $0.0204 | $20.8080
5 | Diode | D1 | 80V Single 1.2V@100mA 4ns 100mA SOD-523 Switching Diode ROHS | SOD-523 | 1SS355WT | CBI |  | C2836063 | - | 1 | 1000 | 1050 | LCSC (https://www.lcsc.com/product-detail/Switching-Diode_CBI-1SS355WT_C2836063.html) | $0.0072 | $7.5600
6 | Pogo Connector | ~~J1~~ | ~~Pogo Pad 2.5mm 4 Pin~~ | ~~Pogo 4 Pin~~ | ~~POGO Connector 4 Pin~~ | ~~-~~ | ~~-~~ | ~~-~~ | ~~-~~ | ~~1~~ | ~~1000~~ | ~~-~~ | ~~-~~ | ~~-~~ | ~~-~~ | ~~-~~ | ~~-~~
7 | FPC Connector | J2 | Clamshell -25℃~+85℃ 18P Bottom Contact Surface Mount 0.5mm SMD,P=0.5mm FFC/FPC Connectors ROHS | Custom | F0502-B-18-15T-R | XFCN | - | C2889974 | - | 1 | 1000 | 1005 | LCSC (https://www.lcsc.com/product-detail/FFC-FPC-Connectors_XFCN-F0502-B-18-15T-R_C2889974.html) | $0.0632 | $63.5160
8 | RGB LED | LED1 | SMD,3.5x3.5mm Light Emitting Diodes (LED) RoHS | Custom | WS2812B-Mini | Worldsemi | - | C527089 | - | 1 | 1000 | 1005 | LCSC (https://www.lcsc.com/product-detail/Light-Emitting-Diodes-LED_Worldsemi-WS2812B-Mini_C527089.html) | $0.0742 | $74.5710
9 | OLED | OLED1 | SSD1306 0.96 - OLED Displays Modules ROHS | Custom | N096-2864KSWEG01-H30 | Newvisio | - | C2890596 | - | 1 | 1000 | 1001 | LCSC (https://www.lcsc.com/product-detail/OLED-Displays-Modules_Newvisio-N096-2864KSWEG01-H30_C2890596.html) | $1.3316 | $1332.9316
10 | Mosfet | Q1 | 50V 220mA 3.5Ω@10V,220mA 225mW 1.6V@1mA N Channel SOT-23 MOSFETs ROHS | Sot-23 | BSS138 | Slkor(SLKORMICRO Elec.) | - | C426569 | - | 1 | 1000 | 1020 | LCSC (https://www.lcsc.com/product-detail/MOSFETs_Slkor-SLKORMICRO-Elec-BSS138_C426569.html) | $0.0128 | $13.0560
11 | Resistor | R1, R2, R3, R7 | RES SMD 10K OHM 0.1% 1/10W 0603 | Res-0603 | RT0603BRD0710KL | Yageo | - | C95204 | 10K | 4 | 4000 | 4020 | LCSC (https://www.lcsc.com/product-detail/Chip-Resistor-Surface-Mount_YAGEO-RT0603BRD0710KL_C95204.html) | $0.0150 | $60.3000
12 | Resistor | R4 | RES SMD 4.7K OHM 5% 1/10W 0402 | Res-0402 | ~~ERJ-2GEJ472X~~ | Panasonic | 0402WGF4701TCE | C25900 | 4.7K | 1 | 1000 | 1100 | LCSC (https://www.lcsc.com/product-detail/Chip-Resistor-Surface-Mount_UNI-ROYAL-Uniroyal-Elec-0402WGF4701TCE_C25900.html) | $0.0004 | $0.4400
13 | Resistor | R5 | RES 0 OHM JUMPER 1/16W 0402 | Res-0402 | RC0402FR-070RL | Yageo | - | C106231 | 0R | 1 | 1000 | 1100 | LCSC (https://www.lcsc.com/product-detail/Chip-Resistor-Surface-Mount_YAGEO-RC0402FR-070RL_C106231.html) | $0.0006 | $0.6600
14 | Resistor | R6 | ±1% 412kΩ 0402 Chip Resistor - Surface Mount ROHS | Res-0402 | FRC0402F4123TS | FOJAN | - | C5126037 | 412K | 1 | 1000 | 1100 | LCSC (https://www.lcsc.com/product-detail/Chip-Resistor-Surface-Mount_FOJAN-FRC0402F4123TS_C5126037.html) | $0.0003 | $0.3300
15 | Solder Bridge | ~~SB1~~ | ~~Solder Bridge ON~~ | ~~Custom~~ | ~~Solder Bridge~~ | ~~-~~ | ~~-~~ | ~~-~~ | ~~-~~ | ~~1~~ | 1000 | ~~-~~ | ~~-~~ | ~~-~~ | ~~-~~
16 | Switch | SW1, SW2, SW3 | 3mm 2mm Round Button 50mA Top3.65mm SPST 12V SMD Tactile Switches | Custom | TS-1185EC-C-D-B | XKB | - | C318893 | - | 3 | 3000 | 3010 | LCSC (https://www.lcsc.com/product-detail/Tactile-Switches_XKB-Connectivity-TS-1185EC-C-D-B_C318893.html) | $0.0358 | $107.7580
17 | Peripheral | - | 0.3mm~0.3mm 18 0.5mm Same Side 5cm P=0.5mm FFC/FPC Connect Cables ROHS | - | JS05A-18P-050-4-8 | JUSHUO | - | C2857498 | - | 1 | 1000 | 1005 | LCSC (https://www.lcsc.com/product-detail/FFC-FPC-Connect-Cables_JUSHUO-JS05A-18P-050-4-8_C2857498.html) | $0.0483 | $48.5415
 |  |  |  |  |  |  |  |  |  |  |  | Total Component Cost |  |  | $1977.22
 |  |  |  |  |  |  |  |  |  |  |  | Single Board Cost |  |  | $1.98
