eSpark-Backup/chrisbyrd-esp32iotproduct/Design Files/LoRaWAN-Module-v2.0/BOM/Client_BOM_LoRaWAN-Module-v2.0.xlsx

 |  | Component list |  | Bill of Materials for Project [LoRaWAN-Module-v2.0.]
 |  | Source Data From: |  | LoRaWAN-Module-v2.0.
 |  | Project: |  | LoRaWAN-Module-v2.0.
 |  | Variant: |  | None
# | Item Type | Designator | Description | Footprint | Manufacturer Part Number | Alternate Part Number | Manufacturer | Value | Quantity | Quantity (5 Boards) | Links | Unit Cost (5 Boards) | Total Cost (5 Boards) | Remarks
1 | Capacitor | C1 | CAP CER 1UF 25V X5R 0603 | Cap-0603 | CC0603KRX5R8BB105 | - | Yageo | 1uF | 1 | 5 | Digikey (https://www.digikey.com/en/products/detail/yageo/CC0603KRX5R8BB105/2833610) | $0.1000 | $0.5000
2 | Capacitor | C2 | CAP CER 0.1UF 50V X5R 0603 | Cap-0603 | CC0603KRX5R9BB104 | - | Yageo | 0.1uF | 1 | 5 | Digikey (https://www.digikey.com/en/products/detail/yageo/CC0603KRX5R9BB104/5883729) | $0.1000 | $0.5000
3 | PCIE SMD PAD | ~~J1~~ | ~~PCI Express Mini Card (Mini PCIe)~~ | ~~Mini PCIE Pad~~ | ~~-~~ | - | ~~-~~ | ~~-~~ | ~~1~~ | ~~5~~ |  | ~~-~~ | ~~-~~
4 | SMA Connector | J2 | 1 Inner bore SMA Board Edge Bend 11mm 5.35mm Plugin RF Connectors / Coaxial Connectors ROHS | HJ-SMA175 | HJ-SMA175 | - | HJ Tech | - | 1 | 5 | Custom Supplier |  | $0.0000
5 | Resistor | R1, R2 | RES SMD 0R, 1%, 0.1W, 0603 | Res-0603 | RC0603FR-070RL | - | Yageo | 0R | 4 | 20 | Digikey (https://www.digikey.com/en/products/detail/yageo/RC0603FR-070RL/1304008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) | $0.1000 | $2.0000
6 | Module | U1 | SMD,16x16mm LoRa Modules ROHS | Custom | SX1276S8S+T-X1 | - | Vollgo | - | 1 | 5 | Custom Supplier |  | -
7 | Peripheral | - | 1.8 3dBi Vertical 50W - Antennas ROHS | - | BW868JWX105-10KJ | - | BAT WIRELESS | - | 1 | 5 | Custom Supplier |  | -
 |  |  |  |  |  |  |  |  |  |  |  |  | $3.00
 |  |  |  |  |  |  |  |  |  |  |  |  | $0.60
