eSpark-Backup/chrisbyrd-esp32iotproduct/Design Files/LoRaWAN-Module-v2.0/BOM/eSpark_BOM_LoRaWAN-Module-v2.0.xlsx

Sheet: 5 Boards
 |  | Component list |  | Bill of Materials for Project [LoRaWAN-Module-v2.0.]
 |  | Source Data From: |  | LoRaWAN-Module-v2.0.
 |  | Project: |  | LoRaWAN-Module-v2.0.
 |  | Variant: |  | None
# | Item Type | Designator | Description | Footprint | Manufacturer Part Number | Manufacturer | Alternate Part Number | LCSC Part Number | Value | Quantity | Quantity (5 Boards) | MOQ (5 Boards) | Links | Unit Cost (5 Boards) | Total Cost (5 Boards) | Remarks | Reviewer Remarks
1 | Capacitor | C1 | CAP CER 1UF 25V X5R 0603 | Cap-0603 | CC0603KRX5R8BB105 | Yageo | - | C14664 | 1uF | 1 | 5 | 100 | LCSC (https://www.lcsc.com/product-detail/Multilayer-Ceramic-Capacitors-MLCC-SMD-SMT_YAGEO-CC0603KRX5R8BB105_C14664.html) | $0.0052 | $0.5200
2 | Capacitor | C2 | CAP CER 0.1UF 50V X5R 0603 | Cap-0603 | ~~CC0603KRX5R9BB104~~ | Yageo | CC0603KRX7R9BB104 | C14663 | 0.1uF | 1 | 5 | 100 | LCSC (https://www.lcsc.com/product-detail/Multilayer-Ceramic-Capacitors-MLCC-SMD-SMT_YAGEO-CC0603KRX7R9BB104_C14663.html) | $0.0024 | $0.2400
3 | PCIE SMD PAD | ~~J1~~ | ~~PCI Express Mini Card (Mini PCIe)~~ | ~~Mini PCIE Pad~~ | ~~-~~ | ~~-~~ | ~~-~~ | ~~-~~ | ~~-~~ | ~~1~~ | ~~5~~ | ~~-~~ | ~~-~~ | ~~-~~ | ~~-~~
4 | SMA Connector | J2 | 1 Inner bore SMA Board Edge Bend 11mm 5.35mm Plugin RF Connectors / Coaxial Connectors ROHS | HJ-SMA175 | HJ-SMA175 | HJ Tech | - | C1509213 | - | 1 | 5 | 6 | LCSC (https://www.lcsc.com/product-detail/RF-Connectors-Coaxial-Connectors_HJ-Tech-HJ-SMA175_C1509213.html) | $0.8162 | $4.8972
5 | Resistor | R1, R2 | RES SMD 0R, 1%, 0.1W, 0603 | Res-0603 | RC0603FR-070RL | Yageo | - | C100044 | 0R | 2 | 10 | 100 | LCSC (https://www.lcsc.com/product-detail/Chip-Resistor-Surface-Mount_YAGEO-RC0603FR-070RL_C100044.html) | $0.0013 | $0.1300
6 | Module | U1 | SMD,16x16mm LoRa Modules ROHS | Custom | SX1276S8S+T-X1 | Vollgo | - | C718834 | - | 1 | 5 | 6 | LCSC (https://www.lcsc.com/product-detail/LoRa-Modules_Vollgo-SX1276S8S-T-X1_C718834.html) | $4.2380 | $25.4280
7 | Peripheral | - | 1.8 3dBi Vertical 50W - Antennas ROHS | - | BW868JWX105-10KJ | BAT WIRELESS | - | C496578 | - | 1 | 5 | 5 | LCSC (https://www.lcsc.com/product-detail/Antennas_BAT-WIRELESS-BW868JWX105-10KJ_C496578.html) | $1.0127 | $5.0635
 |  |  |  |  |  |  |  |  |  |  |  | Total Component Cost |  |  | $36.28
 |  |  |  |  |  |  |  |  |  |  |  | Single Board Cost |  |  | $7.26

Sheet: 20 Boards
 |  | Component list |  | Bill of Materials for Project [LoRaWAN-Module-v2.0.]
 |  | Source Data From: |  | LoRaWAN-Module-v2.0.
 |  | Project: |  | LoRaWAN-Module-v2.0.
 |  | Variant: |  | None
# | Item Type | Designator | Description | Footprint | Manufacturer Part Number | Manufacturer | Alternate Part Number | LCSC Part Number | Value | Quantity | Quantity (20 Boards) | MOQ (20 Boards) | Links | Unit Cost (20 Boards) | Total Cost (20 Boards) | Remarks | Reviewer Remarks
1 | Capacitor | C1 | CAP CER 1UF 25V X5R 0603 | Cap-0603 | CC0603KRX5R8BB105 | Yageo | - | C14664 | 1uF | 1 | 20 | 100 | LCSC (https://www.lcsc.com/product-detail/Multilayer-Ceramic-Capacitors-MLCC-SMD-SMT_YAGEO-CC0603KRX5R8BB105_C14664.html) | $0.0052 | $0.5200
2 | Capacitor | C2 | CAP CER 0.1UF 50V X5R 0603 | Cap-0603 | ~~CC0603KRX5R9BB104~~ | Yageo | CC0603KRX7R9BB104 | C14663 | 0.1uF | 1 | 20 | 100 | LCSC (https://www.lcsc.com/product-detail/Multilayer-Ceramic-Capacitors-MLCC-SMD-SMT_YAGEO-CC0603KRX7R9BB104_C14663.html) | $0.0024 | $0.2400
3 | PCIE SMD PAD | ~~J1~~ | ~~PCI Express Mini Card (Mini PCIe)~~ | ~~Mini PCIE Pad~~ | ~~-~~ | ~~-~~ | ~~-~~ | ~~-~~ | ~~-~~ | ~~1~~ | ~~20~~ | ~~-~~ | ~~-~~ | ~~-~~ | ~~-~~
4 | SMA Connector | J2 | 1 Inner bore SMA Board Edge Bend 11mm 5.35mm Plugin RF Connectors / Coaxial Connectors ROHS | HJ-SMA175 | HJ-SMA175 | HJ Tech | - | C1509213 | - | 1 | 20 | 21 | LCSC (https://www.lcsc.com/product-detail/RF-Connectors-Coaxial-Connectors_HJ-Tech-HJ-SMA175_C1509213.html) | $0.6666 | $13.9986
5 | Resistor | R1, R2 | RES SMD 0R, 1%, 0.1W, 0603 | Res-0603 | RC0603FR-070RL | Yageo | - | C100044 | 0R | 2 | 40 | 100 | LCSC (https://www.lcsc.com/product-detail/Chip-Resistor-Surface-Mount_YAGEO-RC0603FR-070RL_C100044.html) | $0.0013 | $0.1300
6 | Module | U1 | SMD,16x16mm LoRa Modules ROHS | Custom | SX1276S8S+T-X1 | Vollgo | - | C718834 | - | 1 | 20 | 21 | LCSC (https://www.lcsc.com/product-detail/LoRa-Modules_Vollgo-SX1276S8S-T-X1_C718834.html) | $4.4610 | $93.6810
7 | Peripheral | - | 1.8 3dBi Vertical 50W - Antennas ROHS | - | BW868JWX105-10KJ | BAT WIRELESS | - | C496578 | - | 1 | 20 | 20 | LCSC (https://www.lcsc.com/product-detail/Antennas_BAT-WIRELESS-BW868JWX105-10KJ_C496578.html) | $0.8540 | $17.0800
 |  |  |  |  |  |  |  |  |  |  |  | Total Component Cost |  |  | $125.65
 |  |  |  |  |  |  |  |  |  |  |  | Single Board Cost |  |  | $6.28

Sheet: 50 Boards
 |  | Component list |  | Bill of Materials for Project [LoRaWAN-Module-v2.0.]
 |  | Source Data From: |  | LoRaWAN-Module-v2.0.
 |  | Project: |  | LoRaWAN-Module-v2.0.
 |  | Variant: |  | None
# | Item Type | Designator | Description | Footprint | Manufacturer Part Number | Manufacturer | Alternate Part Number | LCSC Part Number | Value | Quantity | Quantity (50 Boards) | MOQ (50 Boards) | Links | Unit Cost (50 Boards) | Total Cost (50 Boards) | Remarks | Reviewer Remarks
1 | Capacitor | C1 | CAP CER 1UF 25V X5R 0603 | Cap-0603 | CC0603KRX5R8BB105 | Yageo | - | C14664 | 1uF | 1 | 50 | 100 | LCSC (https://www.lcsc.com/product-detail/Multilayer-Ceramic-Capacitors-MLCC-SMD-SMT_YAGEO-CC0603KRX5R8BB105_C14664.html) | $0.0052 | $0.5200
2 | Capacitor | C2 | CAP CER 0.1UF 50V X5R 0603 | Cap-0603 | ~~CC0603KRX5R9BB104~~ | Yageo | CC0603KRX7R9BB104 | C14663 | 0.1uF | 1 | 50 | 100 | LCSC (https://www.lcsc.com/product-detail/Multilayer-Ceramic-Capacitors-MLCC-SMD-SMT_YAGEO-CC0603KRX7R9BB104_C14663.html) | $0.0024 | $0.2400
3 | PCIE SMD PAD | ~~J1~~ | ~~PCI Express Mini Card (Mini PCIe)~~ | ~~Mini PCIE Pad~~ | ~~-~~ | ~~-~~ | ~~-~~ | ~~-~~ | ~~-~~ | ~~1~~ | ~~50~~ | ~~-~~ | ~~-~~ | ~~-~~ | ~~-~~
4 | SMA Connector | J2 | 1 Inner bore SMA Board Edge Bend 11mm 5.35mm Plugin RF Connectors / Coaxial Connectors ROHS | HJ-SMA175 | HJ-SMA175 | HJ Tech | - | C1509213 | - | 1 | 50 | 51 | LCSC (https://www.lcsc.com/product-detail/RF-Connectors-Coaxial-Connectors_HJ-Tech-HJ-SMA175_C1509213.html) | $0.5919 | $30.1869
5 | Resistor | R1, R2 | RES SMD 0R, 1%, 0.1W, 0603 | Res-0603 | RC0603FR-070RL | Yageo | - | C100044 | 0R | 2 | 100 | 200 | LCSC (https://www.lcsc.com/product-detail/Chip-Resistor-Surface-Mount_YAGEO-RC0603FR-070RL_C100044.html) | $0.0013 | $0.2600
6 | Module | U1 | SMD,16x16mm LoRa Modules ROHS | Custom | SX1276S8S+T-X1 | Vollgo | - | C718834 | - | 1 | 50 | 51 | LCSC (https://www.lcsc.com/product-detail/LoRa-Modules_Vollgo-SX1276S8S-T-X1_C718834.html) | $4.3241 | $220.5291
7 | Peripheral | - | 1.8 3dBi Vertical 50W - Antennas ROHS | - | BW868JWX105-10KJ | BAT WIRELESS | - | C496578 | - | 1 | 50 | 50 | LCSC (https://www.lcsc.com/product-detail/Antennas_BAT-WIRELESS-BW868JWX105-10KJ_C496578.html) | $0.7678 | $38.3900
 |  |  |  |  |  |  |  |  |  |  |  | Total Component Cost |  |  | $290.13
 |  |  |  |  |  |  |  |  |  |  |  | Single Board Cost |  |  | $5.80

Sheet: 100 Boards
 |  | Component list |  | Bill of Materials for Project [LoRaWAN-Module-v2.0.]
 |  | Source Data From: |  | LoRaWAN-Module-v2.0.
 |  | Project: |  | LoRaWAN-Module-v2.0.
 |  | Variant: |  | None
# | Item Type | Designator | Description | Footprint | Manufacturer Part Number | Manufacturer | Alternate Part Number | LCSC Part Number | Value | Quantity | Quantity (100 Boards) | MOQ (100 Boards) | Links | Unit Cost (100 Boards) | Total Cost (100 Boards) | Remarks | Reviewer Remarks
1 | Capacitor | C1 | CAP CER 1UF 25V X5R 0603 | Cap-0603 | CC0603KRX5R8BB105 | Yageo | - | C14664 | 1uF | 1 | 100 | 200 | LCSC (https://www.lcsc.com/product-detail/Multilayer-Ceramic-Capacitors-MLCC-SMD-SMT_YAGEO-CC0603KRX5R8BB105_C14664.html) | $0.0052 | $1.0400
2 | Capacitor | C2 | CAP CER 0.1UF 50V X5R 0603 | Cap-0603 | ~~CC0603KRX5R9BB104~~ | Yageo | CC0603KRX7R9BB104 | C14663 | 0.1uF | 1 | 100 | 200 | LCSC (https://www.lcsc.com/product-detail/Multilayer-Ceramic-Capacitors-MLCC-SMD-SMT_YAGEO-CC0603KRX7R9BB104_C14663.html) | $0.0024 | $0.4800
3 | PCIE SMD PAD | ~~J1~~ | ~~PCI Express Mini Card (Mini PCIe)~~ | ~~Mini PCIE Pad~~ | ~~-~~ | ~~-~~ | ~~-~~ | ~~-~~ | ~~-~~ | ~~1~~ | ~~100~~ | ~~-~~ | ~~-~~ | ~~-~~ | ~~-~~
4 | SMA Connector | J2 | 1 Inner bore SMA Board Edge Bend 11mm 5.35mm Plugin RF Connectors / Coaxial Connectors ROHS | HJ-SMA175 | HJ-SMA175 | HJ Tech | - | C1509213 | - | 1 | 100 | 101 | LCSC (https://www.lcsc.com/product-detail/RF-Connectors-Coaxial-Connectors_HJ-Tech-HJ-SMA175_C1509213.html) | $0.5187 | $52.3887
5 | Resistor | R1, R2 | RES SMD 0R, 1%, 0.1W, 0603 | Res-0603 | RC0603FR-070RL | Yageo | - | C100044 | 0R | 2 | 200 | 300 | LCSC (https://www.lcsc.com/product-detail/Chip-Resistor-Surface-Mount_YAGEO-RC0603FR-070RL_C100044.html) | $0.0013 | $0.3900
6 | Module | U1 | SMD,16x16mm LoRa Modules ROHS | Custom | SX1276S8S+T-X1 | Vollgo | - | C718834 | - | 1 | 100 | 101 | LCSC (https://www.lcsc.com/product-detail/LoRa-Modules_Vollgo-SX1276S8S-T-X1_C718834.html) | $4.3241 | $436.7341
7 | Peripheral | - | 1.8 3dBi Vertical 50W - Antennas ROHS | - | BW868JWX105-10KJ | BAT WIRELESS | - | C496578 | - | 1 | 100 | 100 | LCSC (https://www.lcsc.com/product-detail/Antennas_BAT-WIRELESS-BW868JWX105-10KJ_C496578.html) | $0.6409 | $64.0900
 |  |  |  |  |  |  |  |  |  |  |  | Total Component Cost |  |  | $555.12
 |  |  |  |  |  |  |  |  |  |  |  | Single Board Cost |  |  | $5.55

Sheet: 500 Boards
 |  | Component list |  | Bill of Materials for Project [LoRaWAN-Module-v2.0.]
 |  | Source Data From: |  | LoRaWAN-Module-v2.0.
 |  | Project: |  | LoRaWAN-Module-v2.0.
 |  | Variant: |  | None
# | Item Type | Designator | Description | Footprint | Manufacturer Part Number | Manufacturer | Alternate Part Number | LCSC Part Number | Value | Quantity | Quantity (500 Boards) | MOQ (500 Boards) | Links | Unit Cost (500 Boards) | Total Cost (500 Boards) | Remarks | Reviewer Remarks
1 | Capacitor | C1 | CAP CER 1UF 25V X5R 0603 | Cap-0603 | CC0603KRX5R8BB105 | Yageo | - | C14664 | 1uF | 1 | 500 | 600 | LCSC (https://www.lcsc.com/product-detail/Multilayer-Ceramic-Capacitors-MLCC-SMD-SMT_YAGEO-CC0603KRX5R8BB105_C14664.html) | $0.0052 | $3.1200
2 | Capacitor | C2 | CAP CER 0.1UF 50V X5R 0603 | Cap-0603 | ~~CC0603KRX5R9BB104~~ | Yageo | CC0603KRX7R9BB104 | C14663 | 0.1uF | 1 | 500 | 600 | LCSC (https://www.lcsc.com/product-detail/Multilayer-Ceramic-Capacitors-MLCC-SMD-SMT_YAGEO-CC0603KRX7R9BB104_C14663.html) | $0.0024 | $1.4400
3 | PCIE SMD PAD | ~~J1~~ | ~~PCI Express Mini Card (Mini PCIe)~~ | ~~Mini PCIE Pad~~ | ~~-~~ | ~~-~~ | ~~-~~ | ~~-~~ | ~~-~~ | ~~1~~ | 500 | ~~-~~ | ~~-~~ | ~~-~~ | ~~-~~
4 | SMA Connector | J2 | 1 Inner bore SMA Board Edge Bend 11mm 5.35mm Plugin RF Connectors / Coaxial Connectors ROHS | HJ-SMA175 | HJ-SMA175 | HJ Tech | - | C1509213 | - | 1 | 500 | 502 | LCSC (https://www.lcsc.com/product-detail/RF-Connectors-Coaxial-Connectors_HJ-Tech-HJ-SMA175_C1509213.html) | $0.4741 | $237.9982
5 | Resistor | R1, R2 | RES SMD 0R, 1%, 0.1W, 0603 | Res-0603 | RC0603FR-070RL | Yageo | - | C100044 | 0R | 2 | 1000 | 1100 | LCSC (https://www.lcsc.com/product-detail/Chip-Resistor-Surface-Mount_YAGEO-RC0603FR-070RL_C100044.html) | $0.0010 | $1.1000
6 | Module | U1 | SMD,16x16mm LoRa Modules ROHS | Custom | SX1276S8S+T-X1 | Vollgo | - | C718834 | - | 1 | 500 | 502 | LCSC (https://www.lcsc.com/product-detail/LoRa-Modules_Vollgo-SX1276S8S-T-X1_C718834.html) | $4.3241 | $2170.6982
7 | Peripheral | - | 1.8 3dBi Vertical 50W - Antennas ROHS | - | BW868JWX105-10KJ | BAT WIRELESS | - | C496578 | - | 1 | 500 | 500 | LCSC (https://www.lcsc.com/product-detail/Antennas_BAT-WIRELESS-BW868JWX105-10KJ_C496578.html) | $0.5971 | $298.5500
 |  |  |  |  |  |  |  |  |  |  |  | Total Component Cost |  |  | $2712.91
 |  |  |  |  |  |  |  |  |  |  |  | Single Board Cost |  |  | $5.43

Sheet: 1000 Boards
 |  | Component list |  | Bill of Materials for Project [LoRaWAN-Module-v2.0.]
 |  | Source Data From: |  | LoRaWAN-Module-v2.0.
 |  | Project: |  | LoRaWAN-Module-v2.0.
 |  | Variant: |  | None
# | Item Type | Designator | Description | Footprint | Manufacturer Part Number | Manufacturer | Alternate Part Number | LCSC Part Number | Value | Quantity | Quantity (1000 Boards) | MOQ (1000 Boards) | Links | Unit Cost (1000 Boards) | Total Cost (1000 Boards) | Remarks | Reviewer Remarks
1 | Capacitor | C1 | CAP CER 1UF 25V X5R 0603 | Cap-0603 | CC0603KRX5R8BB105 | Yageo | - | C14664 | 1uF | 1 | 1000 | 1100 | LCSC (https://www.lcsc.com/product-detail/Multilayer-Ceramic-Capacitors-MLCC-SMD-SMT_YAGEO-CC0603KRX5R8BB105_C14664.html) | $0.0041 | $4.5100
2 | Capacitor | C2 | CAP CER 0.1UF 50V X5R 0603 | Cap-0603 | ~~CC0603KRX5R9BB104~~ | Yageo | CC0603KRX7R9BB104 | C14663 | 0.1uF | 1 | 1000 | 1100 | LCSC (https://www.lcsc.com/product-detail/Multilayer-Ceramic-Capacitors-MLCC-SMD-SMT_YAGEO-CC0603KRX7R9BB104_C14663.html) | $0.0018 | $1.9800
3 | PCIE SMD PAD | ~~J1~~ | ~~PCI Express Mini Card (Mini PCIe)~~ | ~~Mini PCIE Pad~~ | ~~-~~ | ~~-~~ | ~~-~~ | ~~-~~ | ~~-~~ | ~~1~~ | ~~1000~~ | ~~-~~ | ~~-~~ | ~~-~~ | ~~-~~
4 | SMA Connector | J2 | 1 Inner bore SMA Board Edge Bend 11mm 5.35mm Plugin RF Connectors / Coaxial Connectors ROHS | HJ-SMA175 | HJ-SMA175 | HJ Tech | - | C1509213 | - | 1 | 1000 | 1002 | LCSC (https://www.lcsc.com/product-detail/RF-Connectors-Coaxial-Connectors_HJ-Tech-HJ-SMA175_C1509213.html) | $0.4519 | $452.8038
5 | Resistor | R1, R2 | RES SMD 0R, 1%, 0.1W, 0603 | Res-0603 | RC0603FR-070RL | Yageo | - | C100044 | 0R | 2 | 2000 | 2100 | LCSC (https://www.lcsc.com/product-detail/Chip-Resistor-Surface-Mount_YAGEO-RC0603FR-070RL_C100044.html) | $0.0010 | $2.1000
6 | Module | U1 | SMD,16x16mm LoRa Modules ROHS | Custom | SX1276S8S+T-X1 | Vollgo | - | C718834 | - | 1 | 1000 | 1002 | LCSC (https://www.lcsc.com/product-detail/LoRa-Modules_Vollgo-SX1276S8S-T-X1_C718834.html) | $4.3241 | $4332.7482
7 | Peripheral | - | 1.8 3dBi Vertical 50W - Antennas ROHS | - | BW868JWX105-10KJ | BAT WIRELESS | - | C496578 | - | 1 | 1000 | 1000 | LCSC (https://www.lcsc.com/product-detail/Antennas_BAT-WIRELESS-BW868JWX105-10KJ_C496578.html) | $0.5775 | $577.5000
 |  |  |  |  |  |  |  |  |  |  |  | Total Component Cost |  |  | $5371.64
 |  |  |  |  |  |  |  |  |  |  |  | Single Board Cost |  |  | $5.37
