eSpark-Backup/chrisbyrd-esp32iotproduct/Design Files/EthPoE-Module-v2.0/BOM/Client_BOM_EthPoE-Module-v2.0.xlsx

 |  | Component list |  | Bill of Materials for Project [EthPoE-Module-v2.0.]
 |  | Source Data From: |  | EthPoE-Module-v2.0.
 |  | Project: |  | EthPoE-Module-v2.0
 |  | Variant: |  | None
# | Item Type | Designator | Description | Footprint | Manufacturer Part Number | Manufacturer | Value | Quantity (1 Board) | Quantity (5 Boards) | Remarks
1 | Capacitor | C1, C3, C8, C9, C10, C11, C12, C13, C14, C17 | CAP CER 0.1UF 100V X5R 0402 | Cap-0402 | GRM155R62A104KE14D | Murata | 0.1uf | 10 | 50
2 | Capacitor | C2 | 15uF 63V ±20% SMD,D6.3xL5.7mm Aluminum Electrolytic Capacitors - SMD ROHS | Custom | VMMC0571J150MV | Ymin | 15uF | 1 | 5
3 | Capacitor | C4, C24, C25 | CAP CER 12PF 100V C0G/NP0 0603 | Cap-0603 | GCM1885C2A120JA16D | Murata | 12pF | 3 | 15
4 | Capacitor | C5 | CAP TANT 470UF 10% 10V 2917 | Case-E | TAJE477K010RNJ | Kyocera AVX | 470uF | 1 | 5
5 | Capacitor | C6 | CAP CER 220PF 50V C0G/NPO 0402 | Cap-0402 | CC0402JRNPO9BN221 | Yageo | 220pF | 1 | 5
6 | Capacitor | C7, C15, C20 | CAP CER 0.022UF 16V X5R 0402 | Cap-0402 | CC0402KRX5R7BB223 | Yageo | 22nF | 3 | 15
7 | Capacitor | C16 | CAP CER 10UF 25V X5R 0603 | Cap-0603 | C1608X5R1E106M080AC | TDK | 10uF | 1 | 5
8 | Capacitor | C18, C19 | 50V 6.8nF X7R ±10% 0603 | Cap-0603 | 0603B682K500NT | FH | 6.8nF | 2 | 10
9 | Capacitor | C21, C22 | CAP CER 10000PF 100V X7R 0603 | Cap-0603 | AC0603KRX7R0BB103 | Yageo | 10nF | 2 | 10
10 | Capacitor | C23 | CAP CER, 4.7 µF, 25 V, 0603 | Cap-0603 | C1608X5R1E475KT000E | TDK | 4.7uF | 1 | 5
11 | Diode | D1 | 93.6V 64.4V 58V SMA(DO-214AC) TVS ROHS | SMA | SMAJ58A | Yangzhou Yangjie Elec Tech | - | 1 | 5
12 | Diode | D2 | SCHOTTKY DIODE SMB 100V 5A | SMB_ | SS510B | MDD | - | 1 | 5
13 | TVS Diode | D3, D4 | TVS DIODE 5.5VWM 8.5VC SOT23-3 | SOT-23 | SP0502BAHTG | Littelfuse | - | 2 | 10
14 | Fuse | F1 | 6V 2A 50A 1W -40℃~+85℃ 4A 4mΩ 5s 45mΩ 0805 Resettable Fuses ROHS | Fuse-0805 | BSMD0805L-200 | BHFUSE | - | 1 | 5
15 | Ferrite Bead | FB1, FB2 | FERRITE BEAD 600 OHM 1210 1LN | IND-1210 | FBMH3225HM601NT | Taiyo Yuden | - | 2 | 10
16 | Mini PCIe Connector | ~~J1~~ | ~~PCI Express Mini Card (Mini PCIe)~~ | ~~Custom~~ | ~~Mini PCIE Pad~~ | ~~-~~ | ~~-~~ | 1 | 5
17 | Ethernet Connector | J2 | CONN JACK 1PORT 100 BASE-T PCB | Custom | ARJM11D7-114-AB-EW2 | Abracon | - | 1 | 5
18 | Inductor | L1 | 33uH 2.3A ±20% SMD,6.6x7.3mm Inductors | Custom | MDA7050-330M | KOHERelec | 33uH | 1 | 5
19 | Mosfet | Q1 | 40V 100mW 100@10mA,1V 200mA 300MHz 300mV@50mA,5mA NPN -55℃~+150℃@(Tj) SOT-723 Bipolar Transistors - BJT ROHS | SOT-723 | MMBT3904M | TECH PUBLIC | - | 1 | 5
20 | Mosfet | Q2 | MOSFET P-CH 12V 2.6A SUPERSOT3 | SOT-23 | FDN306P | ON Semiconductor / Fairchild | - | 1 | 5
21 | Resistor | R1 | 50mW ±5% -100ppm/℃~+350ppm/℃ 4.7Ω 0201 Chip Resistor - Surface Mount ROHS | Res-0201 | NQ01WMJ047JTEE | UNI-ROYAL | 4.7R | 1 | 5
22 | Resistor | R2 | RES 24.9K OHM 0.5% 1/20W 0201 | Res-0201 | RC0201DR-0724K9L | Yageo | 24.9K | 1 | 5
23 | Resistor | R3, R11 | RES 4.7K OHM 1% 1/16W 0402 | Res-0402 | RC0402FR-074K7L | Yageo | 4.7K | 2 | 10
24 | Resistor | R4 | RES 0.03 OHM 1% 1/2W 0805 | RES-0805 | PE0805FRF470R03L | Yageo | 30mR | 1 | 5
25 | Resistor | R5 | RES 180K OHM 5% 1/20W 0201 | Res-0201 | RC0201JR-07180KL | Yageo | 180K | 1 | 5
26 | Resistor | R6 | 4.42kΩ 0201 Chip Resistor - Surface Mount ROHS | Res-0201 | 0201WMF4421TEE | UNI-ROYAL | 4.42k | 1 | 5
27 | Resistor | R7 | RES SMD 22 OHM 5% 1/3W 0603 | Res-0603 | CRCW060322R0JNEAHP | Vishay Dale | 22R | 1 | 5
28 | Resistor | R8 | RES 300K OHM 1% 1/20W 0201 | Res-0201 | RC0201FR-07300KL | Yageo | 300K | 1 | 5
29 | Resistor | R9 | RES 57.6K OHM 0.5% 1/20W 0201 | Res-0201 | RC0201DR-0757K6L | Yageo | 57.6k | 1 | 5
30 | Resistor | R10, R14, R23, R25, R29, R30, R31, R34, R35, R36, R37, R38, R39 | RES SMD 10K OHM 1% 1/20W 0201 | Res-0201 | RC0201FR-0710KL | Yageo | 10K | 13 | 65
31 | Resistor | R12, R17, R33 | RES SMD 0R, 1%, 0.1W, 0603 | Res-0603 | RC0603FR-070RL | Yageo | 0R | 3 | 15
32 | Resistor | R13 | RES SMD 1K OHM 1% 1/10W 0603 | Res-0603 | RC0603FR-071KL | Yageo | 1K | 1 | 5
33 | Resistor | R15, R16 | RES SMD 330R 100 mW 0603 | Res-0603 | RC0603JR-07330RL | Yageo | 330R | 2 | 10
34 | Resistor | R18, R19, R27, R28 | RES SMD 49.9 OHM 1% 1/20W 0201 | Res-0201 | RC0201FR-0749R9L | Yageo | 49.9R | 4 | 20
35 | Resistor | R20 | RES SMD 10 OHM 1% 1/10W 0603 | Res-0603 | RC0603FR-0710RL | Yageo | 10R | 1 | 5
36 | Resistor | R21, R22, R24, R26 | RES SMD 0603 33 Ohm 1% 1/10W | Res-0603 | RC0603FR-0733RL | Yageo | 33R | 4 | 20
37 | Resistor | R32 | RES SMD 1M OHM 1% 1/10W 0603 | Res-0603 | RC0603FR-071ML | Yageo | 1M | 1 | 5
38 | Resistor | R40 | RES SMD 12.4K OHM 1% 1/10W 0603 | Res-0603 | RC0603FR-0712K4L | Yageo | 12.4K | 1 | 5
39 | IC | U1 | IC POE CNTRL 1 CHANNEL 8SOIC | SOIC-8 | TPS2375DR | Texas Instruments | - | 1 | 5
40 | IC | U2 | Step-down type SOIC-8-EP DC-DC Converters ROHS | 8-SOIC-EP | TX4138 | XDS | - | 1 | 5
41 | IC | U3 | SPI LQFP-48(7x7) Ethernet ICs ROHS | 48-LQFP (7x7)_ | W5500 | WIZNET | - | 1 | 5
42 | Crystal | X1 | SMD3225-4P Crystals ROHS | Custom | NX3225GA-25MHZ-STD-CRG-2 | NDK | - | 1 | 5
43 | Peripheral | - | - | - | LC-2030C | Shengwei | - | 1 | 5
44 | Peripheral | - | - | - | POE Injector |  | - | 1 | 1 | Refrence Link (https://fr.aliexpress.com/item/1005001356576287.html?pdp_n)
