eSpark-Backup/chrisbyrd-esp32iotproduct/Design Files/Ethernet-Module-v2.0/BOM/Client_BOM_Ethernet-Module-v2.0.xlsx

 |  | Component list |  | Bill of Materials for Project [Ethernet-Module-v2.0.]
 |  | Source Data From: |  | Ethernet-Module-v2.0.
 |  | Project: |  | Ethernet-Module-v2.0.
 |  | Variant: |  | None
# | Item Type | Designator | Description | Footprint | Manufacturer Part Number | Alternate Part Number | Manufacturer | Value | Quantity | Quantity (5 Boards) | Remarks
1 | Capacitor | C1, C9 | CAP CER 22UF 10V X5R 0603 | Cap-0603 | CC0603MRX5R6BB226 | - | Yageo | 22uF | 2 | 10
2 | Capacitor | C2, C3, C4, C5, C6, C7, C11 | CAP CER 0.1UF 50V X5R 0603 | Cap-0603 | CC0603KRX5R9BB104 | - | Yageo | 0.1uF | 7 | 35
3 | Capacitor | C8, C10 | CAP CER 10UF 25V X5R 0603 | Cap-0603 | C1608X5R1E106M080AC | - | TDK | 10uF | 2 | 10
4 | Capacitor | C12, C13 | 50V 6.8nF X7R ±10% 0603 | Cap-0603 | 0603B682K500NT | - | FH | 6.8nF | 2 | 10
5 | Capacitor | C14 | CAP CER 0.022UF 100V X7R 0603 | Cap-0603 | CGA3E2X7R2A223K080AA | - | TDK | 22nF | 1 | 5
6 | Capacitor | C15, C16 | CAP CER 10000PF 100V X7R 0603 | Cap-0603 | AC0603KRX7R0BB103 | - | Yageo | 10nF | 2 | 10
7 | Capacitor | C17 | CAP CER, 4.7 µF, 25 V, 0603 | Cap-0603 | C1608X5R1E475KT000E | - | TDK | 4.7uF | 1 | 5
8 | Capacitor | C18, C19 | CAP CER 12PF 100V C0G/NP0 0603 | Cap-0603 | GCM1885C2A120JA16D | - | Murata | 12pF | 2 | 10
9 | TVS Diode | D1, D2 | TVS DIODE 5.5VWM 8.5VC SOT23-3 | SOT-23 | SP0502BAHTG | - | Littelfuse | - | 2 | 10
10 | Ferrite Bead | FB1, FB2 | FERRITE BEAD 600 OHM 1210 1LN | IND-1210 | FBMH3225HM601NT | - | Taiyo Yuden | - | 2 | 10
11 | Ethernet Connector | J1 | CONN JACK 1PORT 100 BASE-T PCB | Custom | ARJM11D7-114-AB-EW2 | - | Abracon | - | 1 | 5
12 | Mini PCIe SMD Pad | ~~J3~~ | ~~PCI Express Mini Card (Mini PCIe)~~ | ~~Custom~~ | ~~-~~ | ~~-~~ | ~~-~~ | ~~-~~ | ~~1~~ | ~~5~~ | ~~DO NOT MOUNT~~
13 | Mosfet | Q1 | 40V 100mW 100@10mA,1V 200mA 300MHz 300mV@50mA,5mA NPN -55℃~+150℃@(Tj) SOT-723 Bipolar Transistors - BJT ROHS | SOT-723 | MMBT3904M | - | TECH PUBLIC | - | 1 | 5
14 | Mosfet | Q2 | MOSFET P-CH 12V 2.6A SUPERSOT3 | SOT-23 | FDN306P | - | ON Semiconductor / Fairchild | - | 1 | 5
15 | Resistor | R1 | RES SMD 1K OHM 1% 1/10W 0603 | Res-0603 | RC0603FR-071KL | - | Yageo | 1K | 1 | 5
16 | Resistor | R2, R9, R12, R17, R18, R19, R22, R23, R24, R25, R26, R27 | RES SMD 10K OHM 1% 1/20W 0201 | Res-0201 | RC0201FR-0710KL | - | Yageo | 10K | 12 | 60
17 | Resistor | R3, R21, R29 | RES SMD 0R, 1%, 0.1W, 0603 | Res-0603 | RC0603FR-070RL | - | Yageo | 0R | 3 | 15
18 | Resistor | R4, R5, R15, R16 | RES 49.9 OHM 1% 1/10W 0603 | Res-0603 | RC0603FR-0749R9L | - | Yageo | 49.9R | 4 | 20
19 | Resistor | R6 | RES SMD 10 OHM 1% 1/10W 0603 | Res-0603 | RC0603FR-0710RL | - | Yageo | 10R | 1 | 5
20 | Resistor | R7, R8, R11, R13 | RES SMD 0603 33 Ohm 1% 1/10W | Res-0603 | RC0603FR-0733RL | - | Yageo | 33R | 4 | 20
21 | Resistor | R10, R14 | RES SMD 330R 100 mW 0603 | Res-0603 | RC0603JR-07330RL | - | Yageo | 330R | 2 | 10
22 | Resistor | R20 | RES SMD 1M OHM 1% 1/10W 0603 | Res-0603 | RC0603FR-071ML | - | Yageo | 1M | 1 | 5
23 | Resistor | R28 | RES SMD 12.4K OHM 1% 1/10W 0603 | Res-0603 | RC0603FR-0712K4L | - | Yageo | 12.4K | 1 | 5
24 | Resistor | R30 | RES 4.7K OHM 1% 1/16W 0402 | Res-0402 | RC0402FR-074K7L | - | Yageo | 4.7K | 1 | 5
25 | IC | U1 | SPI LQFP-48(7x7) Ethernet ICs ROHS | 48-LQFP (7x7)_ | W5500 | - | WIZNET | - | 1 | 5
26 | Crystal | X1 | SMD3225-4P Crystals ROHS | Custom | NX3225GA-25MHZ-STD-CRG-2 | - | NDK | 25MHZ | 1 | 5
27 | Peripheral | - | Eternet Cable | - | LC-2030C | - | Shengwei | - | 1 | 5
