eSpark-Backup/chrisbyrd-esp32iotproduct/Design Files/Ethernet-Module-v2.0/BOM/eSpark_BOM_Ethernet-Module-v2.0.xlsx

Sheet: 5 Boards
 |  | Component list |  | Bill of Materials for Project [Ethernet-Module-v2.0.]
 |  | Source Data From: |  | Ethernet-Module-v2.0.
 |  | Project: |  | Ethernet-Module-v2.0.
 |  | Variant: |  | None
# | Item Type | Designator | Description | Footprint | Manufacturer Part Number | Manufacturer | Alternate Part Number | LCSC Part Number | Value | Quantity | Quantity (5 Boards) | MOQ (5 Boards) | Links | Unit Cost (5 Boards) | Total Cost (5 Boards) | Remarks | Reviewer Remarks
1 | Capacitor | C1, C9 | CAP CER 22UF 10V X5R 0603 | Cap-0603 | CC0603MRX5R6BB226 | Yageo | - | C109447 | 22uF | 2 | 10 | 20 | LCSC (https://www.lcsc.com/product-detail/Multilayer-Ceramic-Capacitors-MLCC-SMD-SMT_YAGEO-CC0603MRX5R6BB226_C109447.html) | $0.0352 | $0.7040
2 | Capacitor | C2, C3, C4, C5, C6, C7, C11 | CAP CER 0.1UF 50V X5R 0603 | Cap-0603 | CC0603KRX5R9BB104 | Yageo | - | C110022 | 0.1uF | 7 | 35 | 100 | LCSC (https://www.lcsc.com/product-detail/Multilayer-Ceramic-Capacitors-MLCC-SMD-SMT_YAGEO-CC0603KRX5R9BB104_C110022.html) | $0.0036 | $0.3600
3 | Capacitor | C8, C10 | CAP CER 10UF 25V X5R 0603 | Cap-0603 | C1608X5R1E106M080AC | TDK | - | C2168289 | 10uF | 2 | 10 | 11 | LCSC (https://www.lcsc.com/product-detail/Multilayer-Ceramic-Capacitors-MLCC-SMD-SMT_TDK-C1608X5R1E106M080AC_C2168289.html) | $0.7526 | $8.2786
4 | Capacitor | C12, C13 | 50V 6.8nF X7R ±10% 0603 | Cap-0603 | 0603B682K500NT | FH | - | C1631 | 6.8nF | 2 | 10 | 100 | LCSC (https://www.lcsc.com/product-detail/Multilayer-Ceramic-Capacitors-MLCC-SMD-SMT_FH-Guangdong-Fenghua-Advanced-Tech-0603B682K500NT_C1631.html) | $0.0028 | $0.2800
5 | Capacitor | C14 | CAP CER 0.022UF 100V X7R 0603 | Cap-0603 | ~~CGA3E2X7R2A223K080AA~~ | TDK |  | C426087 | 22nF | 1 | 5 | 50 | LCSC (https://www.lcsc.com/product-detail/Multilayer-Ceramic-Capacitors-MLCC-SMD-SMT_Murata-Electronics-GRM188R72A223KAC4D_C426087.html) | $0.0158 | $0.7900
6 | Capacitor | C15, C16 | CAP CER 10000PF 100V X7R 0603 | Cap-0603 | AC0603KRX7R0BB103 | Yageo | - | C149602 | 10nF | 2 | 10 | 100 | LCSC (https://www.lcsc.com/product-detail/Multilayer-Ceramic-Capacitors-MLCC-SMD-SMT_YAGEO-AC0603KRX7R0BB103_C149602.html) | $0.0074 | $0.7400
7 | Capacitor | C17 | CAP CER, 4.7 µF, 25 V, 0603 | Cap-0603 | C1608X5R1E475KT000E | TDK | - | C76615 | 4.7uF | 1 | 5 | 10 | LCSC (https://www.lcsc.com/product-detail/Multilayer-Ceramic-Capacitors-MLCC-SMD-SMT_TDK-C1608X5R1E475KT000E_C76615.html) | $0.0423 | $0.4230
8 | Capacitor | C18, C19 | CAP CER 12PF 100V C0G/NP0 0603 | Cap-0603 | ~~GCM1885C2A120JA16D~~ | Murata | 0603N120J101CT | C3858995 | 12pF | 2 | 10 | 100 | LCSC (https://www.lcsc.com/product-detail/Multilayer-Ceramic-Capacitors-MLCC-SMD-SMT_Walsin-Tech-Corp-0603N120J101CT_C3858995.html) | $0.0058 | $0.5800
9 | TVS Diode | D1, D2 | TVS DIODE 5.5VWM 8.5VC SOT23-3 | SOT-23 | SP0502BAHTG | Littelfuse | - | C207261 | - | 2 | 10 | 15 | LCSC (https://www.lcsc.com/product-detail/TVS_Littelfuse-SP0502BAHTG_C207261.html) | $0.1379 | $2.0685
10 | Ferrite Bead | FB1, FB2 | FERRITE BEAD 600 OHM 1210 1LN | IND-1210 | FBMH3225HM601NT | Taiyo Yuden | - | C268004 | - | 2 | 10 | 15 | LCSC (https://www.lcsc.com/product-detail/Ferrite-Beads_Taiyo-Yuden-FBMH3225HM601NT_C268004.html) | $0.1879 | $2.8185
11 | Ethernet Connector | J1 | CONN JACK 1PORT 100 BASE-T PCB | Custom | ARJM11D7-114-AB-EW2 | Abracon | - | - | - | 1 | 5 | 6 | Mouser (https://eu.mouser.com/ProductDetail/ABRACON/ARJM11D7-114-AB-EW2?qs=YCa%2FAAYMW02ICsJcHu%252BNJg%3D%3D) | $3.4700 | $20.8200
12 | Mini PCIe SMD Pad | ~~J2~~ | ~~PCI Express Mini Card (Mini PCIe)~~ | ~~Custom~~ | ~~-~~ | ~~-~~ | ~~-~~ | ~~-~~ | - | ~~1~~ | ~~5~~ | ~~-~~ | ~~-~~ | ~~-~~ | ~~-~~ | ~~DO NOT MOUNT~~
13 | Mosfet | Q1 | 40V 100mW 100@10mA,1V 200mA 300MHz 300mV@50mA,5mA NPN -55℃~+150℃@(Tj) SOT-723 Bipolar Transistors - BJT ROHS | SOT-723 | MMBT3904M | TECH PUBLIC | - | C2923360 | - | 1 | 5 | 20 | LCSC (https://www.lcsc.com/product-detail/Bipolar-Transistors-BJT_TECH-PUBLIC-MMBT3904M_C2923360.html) | $0.0335 | $0.6700
14 | Mosfet | Q2 | MOSFET P-CH 12V 2.6A SUPERSOT3 | SOT-23 | FDN306P | ON Semiconductor / Fairchild | - | C5236682 | - | 1 | 5 | 10 | LCSC (https://www.lcsc.com/product-detail/MOSFETs_UMW-Youtai-Semiconductor-Co-Ltd-FDN306P_C5236682.html) | $0.0605 | $0.6050
15 | Resistor | R1 | RES SMD 1K OHM 1% 1/10W 0603 | Res-0603 | RC0603FR-071KL | Yageo | - | C22548 | 1K | 1 | 5 | 100 | LCSC (https://www.lcsc.com/product-detail/Chip-Resistor-Surface-Mount_YAGEO-RC0603FR-071KL_C22548.html) | $0.0010 | $0.1000
16 | Resistor | R2, R9, R12, R17, R18, R19, R22, R23, R24, R25, R26, R27 | RES SMD 10K OHM 1% 1/20W 0201 | Res-0201 | RC0201FR-0710KL | Yageo | - | C106225 | 10K | 12 | 60 | 100 | LCSC (https://www.lcsc.com/product-detail/Chip-Resistor-Surface-Mount_YAGEO-RC0201FR-0710KL_C106225.html) | $0.0009 | $0.0900
17 | Resistor | R3, R21, R29 | RES SMD 0R, 1%, 0.1W, 0603 | Res-0603 | RC0603FR-070RL | Yageo | - | C100044 | 0R | 3 | 15 | 100 | LCSC (https://www.lcsc.com/product-detail/Chip-Resistor-Surface-Mount_YAGEO-RC0603FR-070RL_C100044.html) | $0.0013 | $0.1300
18 | Resistor | R4, R5, R15, R16 | RES 49.9 OHM 1% 1/10W 0603 | Res-0603 | RC0603FR-0749R9L | Yageo | - | C114625 | 49.9R | 4 | 20 | 100 | LCSC (https://www.lcsc.com/product-detail/Chip-Resistor-Surface-Mount_YAGEO-RC0603FR-0749R9L_C114625.html) | $0.0012 | $0.1200
19 | Resistor | R6 | RES SMD 10 OHM 1% 1/10W 0603 | Res-0603 | RC0603FR-0710RL | Yageo | - | C109318 | 10R | 1 | 5 | 100 | LCSC (https://www.lcsc.com/product-detail/Chip-Resistor-Surface-Mount_YAGEO-RC0603FR-0710RL_C109318.html) | $0.0032 | $0.3200
20 | Resistor | R7, R8, R11, R13 | RES SMD 0603 33 Ohm 1% 1/10W | Res-0603 | RC0603FR-0733RL | Yageo | - | C108661 | 33R | 4 | 20 | 100 | LCSC (https://www.lcsc.com/product-detail/Chip-Resistor-Surface-Mount_YAGEO-RC0603FR-0733RL_C108661.html) | $0.0012 | $0.1200
21 | Resistor | R10, R14 | RES SMD 330R 100 mW 0603 | Res-0603 | RC0603JR-07330RL | Yageo | - | C105879 | 330R | 2 | 10 | 100 | LCSC (https://www.lcsc.com/product-detail/Chip-Resistor-Surface-Mount_YAGEO-RC0603JR-07330RL_C105879.html) | $0.0011 | $0.1100
22 | Resistor | R20 | RES SMD 1M OHM 1% 1/10W 0603 | Res-0603 | RC0603FR-071ML | Yageo | - | C105578 | 1M | 1 | 5 | 100 | LCSC (https://www.lcsc.com/product-detail/Chip-Resistor-Surface-Mount_YAGEO-RC0603FR-071ML_C105578.html) | $0.0013 | $0.1300
23 | Resistor | R28 | RES SMD 12.4K OHM 1% 1/10W 0603 | Res-0603 | RC0603FR-0712K4L | Yageo | - | C137798 | 12.4K | 1 | 5 | 100 | LCSC (https://www.lcsc.com/product-detail/Chip-Resistor-Surface-Mount_YAGEO-RC0603FR-0712K4L_C137798.html) | $0.0012 | $0.1200
24 | Resistor | R30 | RES 4.7K OHM 1% 1/16W 0402 | Res-0402 | RC0402FR-074K7L | Yageo | - | C105871 | 4.7K | 1 | 5 | 100 | LCSC (https://www.lcsc.com/product-detail/Chip-Resistor-Surface-Mount_YAGEO-RC0402FR-074K7L_C105871.html) | $0.0007 | $0.0700
25 | IC | U1 | SPI LQFP-48(7x7) Ethernet ICs ROHS | 48-LQFP (7x7)_ | W5500 | WIZNET | - | C32843 | - | 1 | 5 | 6 | LCSC (https://www.lcsc.com/product-detail/Ethernet-ICs_WIZNET-W5500_C32843.html) | $2.6410 | $15.8460
26 | Crystal | X1 | SMD3225-4P Crystals ROHS | Custom | NX3225GA-25MHZ-STD-CRG-2 | NDK | - | C438901 | 25MHZ | 1 | 5 | 6 | LCSC (https://www.lcsc.com/product-detail/Crystals_NDK-NX3225GA-25MHZ-STD-CRG-2_C438901.html) | $0.2524 | $1.5144
27 | Peripheral | - | Eternet Cable | - | LC-2030C | Shengwei | - | C3011736 | - | 1 | 5 | 5 | LCSC (https://www.lcsc.com/product-detail/Cable_Shengwei-LC-2030C_C3011736.html) | $1.3189 | $6.5945
 |  |  |  |  |  |  |  |  |  |  |  | Total Component Cost |  |  | $64.40
 |  |  |  |  |  |  |  |  |  |  |  | Single Board Cost |  |  | $12.88

Sheet: 20 Boards
 |  | Component list |  | Bill of Materials for Project [Ethernet-Module-v2.0.]
 |  | Source Data From: |  | Ethernet-Module-v2.0.
 |  | Project: |  | Ethernet-Module-v2.0.
 |  | Variant: |  | None
# | Item Type | Designator | Description | Footprint | Manufacturer Part Number | Manufacturer | Alternate Part Number | LCSC Part Number | Value | Quantity | Quantity (20 Boards) | MOQ (20 Boards) | Links | Unit Cost (20 Boards) | Total Cost (20 Boards) | Remarks | Reviewer Remarks
1 | Capacitor | C1, C9 | CAP CER 22UF 10V X5R 0603 | Cap-0603 | CC0603MRX5R6BB226 | Yageo | - | C109447 | 22uF | 2 | 40 | 60 | LCSC (https://www.lcsc.com/product-detail/Multilayer-Ceramic-Capacitors-MLCC-SMD-SMT_YAGEO-CC0603MRX5R6BB226_C109447.html) | $0.0352 | $2.1120
2 | Capacitor | C2, C3, C4, C5, C6, C7, C11 | CAP CER 0.1UF 50V X5R 0603 | Cap-0603 | CC0603KRX5R9BB104 | Yageo | - | C110022 | 0.1uF | 7 | 140 | 200 | LCSC (https://www.lcsc.com/product-detail/Multilayer-Ceramic-Capacitors-MLCC-SMD-SMT_YAGEO-CC0603KRX5R9BB104_C110022.html) | $0.0036 | $0.7200
3 | Capacitor | C8, C10 | CAP CER 10UF 25V X5R 0603 | Cap-0603 | C1608X5R1E106M080AC | TDK | - | C2168289 | 10uF | 2 | 40 | 41 | LCSC (https://www.lcsc.com/product-detail/Multilayer-Ceramic-Capacitors-MLCC-SMD-SMT_TDK-C1608X5R1E106M080AC_C2168289.html) | $0.7366 | $30.2006
4 | Capacitor | C12, C13 | 50V 6.8nF X7R ±10% 0603 | Cap-0603 | 0603B682K500NT | FH | - | C1631 | 6.8nF | 2 | 40 | 100 | LCSC (https://www.lcsc.com/product-detail/Multilayer-Ceramic-Capacitors-MLCC-SMD-SMT_FH-Guangdong-Fenghua-Advanced-Tech-0603B682K500NT_C1631.html) | $0.0028 | $0.2800
5 | Capacitor | C14 | CAP CER 0.022UF 100V X7R 0603 | Cap-0603 | ~~CGA3E2X7R2A223K080AA~~ | TDK |  | C426087 | 22nF | 1 | 20 | 50 | LCSC (https://www.lcsc.com/product-detail/Multilayer-Ceramic-Capacitors-MLCC-SMD-SMT_Murata-Electronics-GRM188R72A223KAC4D_C426087.html) | $0.0154 | $0.7700
6 | Capacitor | C15, C16 | CAP CER 10000PF 100V X7R 0603 | Cap-0603 | AC0603KRX7R0BB103 | Yageo | - | C149602 | 10nF | 2 | 40 | 100 | LCSC (https://www.lcsc.com/product-detail/Multilayer-Ceramic-Capacitors-MLCC-SMD-SMT_YAGEO-AC0603KRX7R0BB103_C149602.html) | $0.0068 | $0.6800
7 | Capacitor | C17 | CAP CER, 4.7 µF, 25 V, 0603 | Cap-0603 | C1608X5R1E475KT000E | TDK | - | C76615 | 4.7uF | 1 | 20 | 30 | LCSC (https://www.lcsc.com/product-detail/Multilayer-Ceramic-Capacitors-MLCC-SMD-SMT_TDK-C1608X5R1E475KT000E_C76615.html) | $0.0417 | $1.2510
8 | Capacitor | C18, C19 | CAP CER 12PF 100V C0G/NP0 0603 | Cap-0603 | ~~GCM1885C2A120JA16D~~ | Murata | 0603N120J101CT | C3858995 | 12pF | 2 | 40 | 100 | LCSC (https://www.lcsc.com/product-detail/Multilayer-Ceramic-Capacitors-MLCC-SMD-SMT_Walsin-Tech-Corp-0603N120J101CT_C3858995.html) | $0.0058 | $0.5800
9 | TVS Diode | D1, D2 | TVS DIODE 5.5VWM 8.5VC SOT23-3 | SOT-23 | SP0502BAHTG | Littelfuse | - | C207261 |  | 2 | 40 | 45 | LCSC (https://www.lcsc.com/product-detail/TVS_Littelfuse-SP0502BAHTG_C207261.html) | $0.1379 | $6.2055
10 | Ferrite Bead | FB1, FB2 | FERRITE BEAD 600 OHM 1210 1LN | IND-1210 | FBMH3225HM601NT | Taiyo Yuden | - | C268004 | - | 2 | 40 | 45 | LCSC (https://www.lcsc.com/product-detail/Ferrite-Beads_Taiyo-Yuden-FBMH3225HM601NT_C268004.html) | $0.1422 | $6.3990
11 | Ethernet Connector | J1 | CONN JACK 1PORT 100 BASE-T PCB | Custom | ARJM11D7-114-AB-EW2 | Abracon | - | - | - | 1 | 20 | 21 | Mouser (https://eu.mouser.com/ProductDetail/ABRACON/ARJM11D7-114-AB-EW2?qs=YCa%2FAAYMW02ICsJcHu%252BNJg%3D%3D) | $3.3200 | $69.7200
12 | Mini PCIe SMD Pad | ~~J2~~ | ~~PCI Express Mini Card (Mini PCIe)~~ | ~~Custom~~ | ~~-~~ | ~~-~~ | ~~-~~ | ~~-~~ | - | ~~1~~ | ~~20~~ | ~~-~~ | ~~-~~ | ~~-~~ | ~~-~~ | ~~DO NOT MOUNT~~
13 | Mosfet | Q1 | 40V 100mW 100@10mA,1V 200mA 300MHz 300mV@50mA,5mA NPN -55℃~+150℃@(Tj) SOT-723 Bipolar Transistors - BJT ROHS | SOT-723 | MMBT3904M | TECH PUBLIC | - | C2923360 | - | 1 | 20 | 40 | LCSC (https://www.lcsc.com/product-detail/Bipolar-Transistors-BJT_TECH-PUBLIC-MMBT3904M_C2923360.html) | $0.0335 | $1.3400
14 | Mosfet | Q2 | MOSFET P-CH 12V 2.6A SUPERSOT3 | SOT-23 | FDN306P | ON Semiconductor / Fairchild | - | C5236682 | - | 1 | 20 | 30 | LCSC (https://www.lcsc.com/product-detail/MOSFETs_UMW-Youtai-Semiconductor-Co-Ltd-FDN306P_C5236682.html) | $0.0605 | $1.8150
15 | Resistor | R1 | RES SMD 1K OHM 1% 1/10W 0603 | Res-0603 | RC0603FR-071KL | Yageo | - | C22548 | 1K | 1 | 20 | 100 | LCSC (https://www.lcsc.com/product-detail/Chip-Resistor-Surface-Mount_YAGEO-RC0603FR-071KL_C22548.html) | $0.0010 | $0.1000
16 | Resistor | R2, R9, R12, R17, R18, R19, R22, R23, R24, R25, R26, R27 | RES SMD 10K OHM 1% 1/20W 0201 | Res-0201 | RC0201FR-0710KL | Yageo | - | C106225 | 10K | 12 | 240 | 300 | LCSC (https://www.lcsc.com/product-detail/Chip-Resistor-Surface-Mount_YAGEO-RC0201FR-0710KL_C106225.html) | $0.0009 | $0.2700
17 | Resistor | R3, R21, R29 | RES SMD 0R, 1%, 0.1W, 0603 | Res-0603 | RC0603FR-070RL | Yageo | - | C100044 | 0R | 3 | 60 | 100 | LCSC (https://www.lcsc.com/product-detail/Chip-Resistor-Surface-Mount_YAGEO-RC0603FR-070RL_C100044.html) | $0.0013 | $0.1300
18 | Resistor | R4, R5, R15, R16 | RES 49.9 OHM 1% 1/10W 0603 | Res-0603 | RC0603FR-0749R9L | Yageo | - | C114625 | 49.9R | 4 | 80 | 100 | LCSC (https://www.lcsc.com/product-detail/Chip-Resistor-Surface-Mount_YAGEO-RC0603FR-0749R9L_C114625.html) | $0.0012 | $0.1200
19 | Resistor | R6 | RES SMD 10 OHM 1% 1/10W 0603 | Res-0603 | RC0603FR-0710RL | Yageo | - | C109318 | 10R | 1 | 20 | 100 | LCSC (https://www.lcsc.com/product-detail/Chip-Resistor-Surface-Mount_YAGEO-RC0603FR-0710RL_C109318.html) | $0.0032 | $0.3200
20 | Resistor | R7, R8, R11, R13 | RES SMD 0603 33 Ohm 1% 1/10W | Res-0603 | RC0603FR-0733RL | Yageo | - | C108661 | 33R | 4 | 80 | 100 | LCSC (https://www.lcsc.com/product-detail/Chip-Resistor-Surface-Mount_YAGEO-RC0603FR-0733RL_C108661.html) | $0.0012 | $0.1200
21 | Resistor | R10, R14 | RES SMD 330R 100 mW 0603 | Res-0603 | RC0603JR-07330RL | Yageo | - | C105879 | 330R | 2 | 40 | 100 | LCSC (https://www.lcsc.com/product-detail/Chip-Resistor-Surface-Mount_YAGEO-RC0603JR-07330RL_C105879.html) | $0.0011 | $0.1100
22 | Resistor | R20 | RES SMD 1M OHM 1% 1/10W 0603 | Res-0603 | RC0603FR-071ML | Yageo | - | C105578 | 1M | 1 | 20 | 100 | LCSC (https://www.lcsc.com/product-detail/Chip-Resistor-Surface-Mount_YAGEO-RC0603FR-071ML_C105578.html) | $0.0013 | $0.1300
23 | Resistor | R28 | RES SMD 12.4K OHM 1% 1/10W 0603 | Res-0603 | RC0603FR-0712K4L | Yageo | - | C137798 | 12.4K | 1 | 20 | 100 | LCSC (https://www.lcsc.com/product-detail/Chip-Resistor-Surface-Mount_YAGEO-RC0603FR-0712K4L_C137798.html) | $0.0012 | $0.1200
24 | Resistor | R30 | RES 4.7K OHM 1% 1/16W 0402 | Res-0402 | RC0402FR-074K7L | Yageo | - | C105871 | 4.7K | 1 | 20 | 100 | LCSC (https://www.lcsc.com/product-detail/Chip-Resistor-Surface-Mount_YAGEO-RC0402FR-074K7L_C105871.html) | $0.0007 | $0.0700
25 | IC | U1 | SPI LQFP-48(7x7) Ethernet ICs ROHS | 48-LQFP (7x7)_ | W5500 | WIZNET | - | C32843 | - | 1 | 20 | 21 | LCSC (https://www.lcsc.com/product-detail/Ethernet-ICs_WIZNET-W5500_C32843.html) | $2.3896 | $50.1816
26 | Crystal | X1 | SMD3225-4P Crystals ROHS | Custom | NX3225GA-25MHZ-STD-CRG-2 | NDK | - | C438901 | 25MHZ | 1 | 20 | 21 | LCSC (https://www.lcsc.com/product-detail/Crystals_NDK-NX3225GA-25MHZ-STD-CRG-2_C438901.html) | $0.2036 | $4.2756
27 | Peripheral | - | Eternet Cable | - | LC-2030C | Shengwei | - | C3011736 | - | 1 | 20 | 20 | LCSC (https://www.lcsc.com/product-detail/Cable_Shengwei-LC-2030C_C3011736.html) | $1.2712 | $25.4240
 |  |  |  |  |  |  |  |  |  |  |  | Total Component Cost |  |  | $203.44
 |  |  |  |  |  |  |  |  |  |  |  | Single Board Cost |  |  | $10.17

Sheet: 50 Boards
 |  | Component list |  | Bill of Materials for Project [Ethernet-Module-v2.0.]
 |  | Source Data From: |  | Ethernet-Module-v2.0.
 |  | Project: |  | Ethernet-Module-v2.0.
 |  | Variant: |  | None
# | Item Type | Designator | Description | Footprint | Manufacturer Part Number | Manufacturer | Alternate Part Number | LCSC Part Number | Value | Quantity | Quantity (50 Boards) | MOQ (50 Boards) | Links | Unit Cost (50 Boards) | Total Cost (50 Boards) | Remarks | Reviewer Remarks
1 | Capacitor | C1, C9 | CAP CER 22UF 10V X5R 0603 | Cap-0603 | CC0603MRX5R6BB226 | Yageo | - | C109447 | 22uF | 2 | 100 | 120 | LCSC (https://www.lcsc.com/product-detail/Multilayer-Ceramic-Capacitors-MLCC-SMD-SMT_YAGEO-CC0603MRX5R6BB226_C109447.html) | $0.0352 | $4.2240
2 | Capacitor | C2, C3, C4, C5, C6, C7, C11 | CAP CER 0.1UF 50V X5R 0603 | Cap-0603 | CC0603KRX5R9BB104 | Yageo | - | C110022 | 0.1uF | 7 | 350 | 400 | LCSC (https://www.lcsc.com/product-detail/Multilayer-Ceramic-Capacitors-MLCC-SMD-SMT_YAGEO-CC0603KRX5R9BB104_C110022.html) | $0.0036 | $1.4400
3 | Capacitor | C8, C10 | CAP CER 10UF 25V X5R 0603 | Cap-0603 | C1608X5R1E106M080AC | TDK | - | C2168289 | 10uF | 2 | 100 | 101 | LCSC (https://www.lcsc.com/product-detail/Multilayer-Ceramic-Capacitors-MLCC-SMD-SMT_TDK-C1608X5R1E106M080AC_C2168289.html) | $0.6746 | $68.1346
4 | Capacitor | C12, C13 | 50V 6.8nF X7R ±10% 0603 | Cap-0603 | 0603B682K500NT | FH | - | C1631 | 6.8nF | 2 | 100 | 200 | LCSC (https://www.lcsc.com/product-detail/Multilayer-Ceramic-Capacitors-MLCC-SMD-SMT_FH-Guangdong-Fenghua-Advanced-Tech-0603B682K500NT_C1631.html) | $0.0028 | $0.5600
5 | Capacitor | C14 | CAP CER 0.022UF 100V X7R 0603 | Cap-0603 | ~~CGA3E2X7R2A223K080AA~~ | TDK |  | C426087 | 22nF | 1 | 50 | 100 | LCSC (https://www.lcsc.com/product-detail/Multilayer-Ceramic-Capacitors-MLCC-SMD-SMT_Murata-Electronics-GRM188R72A223KAC4D_C426087.html) | $0.0154 | $1.5400
6 | Capacitor | C15, C16 | CAP CER 10000PF 100V X7R 0603 | Cap-0603 | AC0603KRX7R0BB103 | Yageo | - | C149602 | 10nF | 2 | 100 | 200 | LCSC (https://www.lcsc.com/product-detail/Multilayer-Ceramic-Capacitors-MLCC-SMD-SMT_YAGEO-AC0603KRX7R0BB103_C149602.html) | $0.0068 | $1.3600
7 | Capacitor | C17 | CAP CER, 4.7 µF, 25 V, 0603 | Cap-0603 | C1608X5R1E475KT000E | TDK | - | C76615 | 4.7uF | 1 | 50 | 60 | LCSC (https://www.lcsc.com/product-detail/Multilayer-Ceramic-Capacitors-MLCC-SMD-SMT_TDK-C1608X5R1E475KT000E_C76615.html) | $0.0417 | $2.5020
8 | Capacitor | C18, C19 | CAP CER 12PF 100V C0G/NP0 0603 | Cap-0603 | ~~GCM1885C2A120JA16D~~ | Murata | 0603N120J101CT | C3858995 | 12pF | 2 | 100 | 200 | LCSC (https://www.lcsc.com/product-detail/Multilayer-Ceramic-Capacitors-MLCC-SMD-SMT_Walsin-Tech-Corp-0603N120J101CT_C3858995.html) | $0.0058 | $1.1600
9 | TVS Diode | D1, D2 | TVS DIODE 5.5VWM 8.5VC SOT23-3 | SOT-23 | SP0502BAHTG | Littelfuse | - | C207261 |  | 2 | 100 | 105 | LCSC (https://www.lcsc.com/product-detail/TVS_Littelfuse-SP0502BAHTG_C207261.html) | $0.1108 | $11.6340
10 | Ferrite Bead | FB1, FB2 | FERRITE BEAD 600 OHM 1210 1LN | IND-1210 | FBMH3225HM601NT | Taiyo Yuden | - | C268004 | - | 2 | 100 | 105 | LCSC (https://www.lcsc.com/product-detail/Ferrite-Beads_Taiyo-Yuden-FBMH3225HM601NT_C268004.html) | $0.1179 | $12.3795
11 | Ethernet Connector | J1 | CONN JACK 1PORT 100 BASE-T PCB | Custom | ARJM11D7-114-AB-EW2 | Abracon | - | - | - | 1 | 50 | 51 | Mouser (https://eu.mouser.com/ProductDetail/ABRACON/ARJM11D7-114-AB-EW2?qs=YCa%2FAAYMW02ICsJcHu%252BNJg%3D%3D) | $2.9000 | $147.9000
12 | Mini PCIe SMD Pad | ~~J2~~ | ~~PCI Express Mini Card (Mini PCIe)~~ | ~~Custom~~ | ~~-~~ | ~~-~~ | ~~-~~ | ~~-~~ | - | ~~1~~ | ~~50~~ | ~~-~~ | ~~-~~ | ~~-~~ | ~~-~~ | ~~DO NOT MOUNT~~
13 | Mosfet | Q1 | 40V 100mW 100@10mA,1V 200mA 300MHz 300mV@50mA,5mA NPN -55℃~+150℃@(Tj) SOT-723 Bipolar Transistors - BJT ROHS | SOT-723 | MMBT3904M | TECH PUBLIC | - | C2923360 | - | 1 | 50 | 60 | LCSC (https://www.lcsc.com/product-detail/Bipolar-Transistors-BJT_TECH-PUBLIC-MMBT3904M_C2923360.html) | $0.0335 | $2.0100
14 | Mosfet | Q2 | MOSFET P-CH 12V 2.6A SUPERSOT3 | SOT-23 | FDN306P | ON Semiconductor / Fairchild |  | C5236682 | - | 1 | 50 | 60 | LCSC (https://www.lcsc.com/product-detail/MOSFETs_UMW-Youtai-Semiconductor-Co-Ltd-FDN306P_C5236682.html) | $0.0605 | $3.6300
15 | Resistor | R1 | RES SMD 1K OHM 1% 1/10W 0603 | Res-0603 | RC0603FR-071KL | Yageo | - | C22548 | 1K | 1 | 50 | 100 | LCSC (https://www.lcsc.com/product-detail/Chip-Resistor-Surface-Mount_YAGEO-RC0603FR-071KL_C22548.html) | $0.0010 | $0.1000
16 | Resistor | R2, R9, R12, R17, R18, R19, R22, R23, R24, R25, R26, R27 | RES SMD 10K OHM 1% 1/20W 0201 | Res-0201 | RC0201FR-0710KL | Yageo | - | C106225 | 10K | 12 | 600 | 700 | LCSC (https://www.lcsc.com/product-detail/Chip-Resistor-Surface-Mount_YAGEO-RC0201FR-0710KL_C106225.html) | $0.0009 | $0.6300
17 | Resistor | R3, R21, R29 | RES SMD 0R, 1%, 0.1W, 0603 | Res-0603 | RC0603FR-070RL | Yageo | - | C100044 | 0R | 3 | 150 | 200 | LCSC (https://www.lcsc.com/product-detail/Chip-Resistor-Surface-Mount_YAGEO-RC0603FR-070RL_C100044.html) | $0.0013 | $0.2600
18 | Resistor | R4, R5, R15, R16 | RES 49.9 OHM 1% 1/10W 0603 | Res-0603 | RC0603FR-0749R9L | Yageo | - | C114625 | 49.9R | 4 | 200 | 300 | LCSC (https://www.lcsc.com/product-detail/Chip-Resistor-Surface-Mount_YAGEO-RC0603FR-0749R9L_C114625.html) | $0.0012 | $0.3600
19 | Resistor | R6 | RES SMD 10 OHM 1% 1/10W 0603 | Res-0603 | RC0603FR-0710RL | Yageo | - | C109318 | 10R | 1 | 50 | 100 | LCSC (https://www.lcsc.com/product-detail/Chip-Resistor-Surface-Mount_YAGEO-RC0603FR-0710RL_C109318.html) | $0.0030 | $0.3000
20 | Resistor | R7, R8, R11, R13 | RES SMD 0603 33 Ohm 1% 1/10W | Res-0603 | RC0603FR-0733RL | Yageo | - | C108661 | 33R | 4 | 200 | 300 | LCSC (https://www.lcsc.com/product-detail/Chip-Resistor-Surface-Mount_YAGEO-RC0603FR-0733RL_C108661.html) | $0.0012 | $0.3600
21 | Resistor | R10, R14 | RES SMD 330R 100 mW 0603 | Res-0603 | RC0603JR-07330RL | Yageo | - | C105879 | 330R | 2 | 100 | 200 | LCSC (https://www.lcsc.com/product-detail/Chip-Resistor-Surface-Mount_YAGEO-RC0603JR-07330RL_C105879.html) | $0.0011 | $0.2200
22 | Resistor | R20 | RES SMD 1M OHM 1% 1/10W 0603 | Res-0603 | RC0603FR-071ML | Yageo | - | C105578 | 1M | 1 | 50 | 100 | LCSC (https://www.lcsc.com/product-detail/Chip-Resistor-Surface-Mount_YAGEO-RC0603FR-071ML_C105578.html) | $0.0012 | $0.1200
23 | Resistor | R28 | RES SMD 12.4K OHM 1% 1/10W 0603 | Res-0603 | RC0603FR-0712K4L | Yageo | - | C137798 | 12.4K | 1 | 50 | 100 | LCSC (https://www.lcsc.com/product-detail/Chip-Resistor-Surface-Mount_YAGEO-RC0603FR-0712K4L_C137798.html) | $0.0012 | $0.1200
24 | Resistor | R30 | RES 4.7K OHM 1% 1/16W 0402 | Res-0402 | RC0402FR-074K7L | Yageo | - | C105871 | 4.7K | 1 | 50 | 100 | LCSC (https://www.lcsc.com/product-detail/Chip-Resistor-Surface-Mount_YAGEO-RC0402FR-074K7L_C105871.html) | $0.0007 | $0.0700
25 | IC | U1 | SPI LQFP-48(7x7) Ethernet ICs ROHS | 48-LQFP (7x7)_ | W5500 | WIZNET | - | C32843 | - | 1 | 50 | 51 | LCSC (https://www.lcsc.com/product-detail/Ethernet-ICs_WIZNET-W5500_C32843.html) | $2.2337 | $113.9187
26 | Crystal | X1 | SMD3225-4P Crystals ROHS | Custom | NX3225GA-25MHZ-STD-CRG-2 | NDK | - | C438901 | 25MHZ | 1 | 50 | 51 | LCSC (https://www.lcsc.com/product-detail/Crystals_NDK-NX3225GA-25MHZ-STD-CRG-2_C438901.html) | $0.1827 | $9.3177
27 | Peripheral | - | Eternet Cable | - | LC-2030C | Shengwei | - | C3011736 | - | 1 | 50 | 50 | LCSC (https://www.lcsc.com/product-detail/Cable_Shengwei-LC-2030C_C3011736.html) | $1.2712 | $63.5600
 |  |  |  |  |  |  |  |  |  |  |  | Total Component Cost |  |  | $447.81
 |  |  |  |  |  |  |  |  |  |  |  | Single Board Cost |  |  | $8.96

Sheet: 100 Boards
 |  | Component list |  | Bill of Materials for Project [Ethernet-Module-v2.0.]
 |  | Source Data From: |  | Ethernet-Module-v2.0.
 |  | Project: |  | Ethernet-Module-v2.0.
 |  | Variant: |  | None
# | Item Type | Designator | Description | Footprint | Manufacturer Part Number | Manufacturer | Alternate Part Number | LCSC Part Number | Value | Quantity | Quantity (100 Boards) | MOQ (100 Boards) | Links | Unit Cost (100 Boards) | Total Cost (100 Boards) | Remarks | Reviewer Remarks
1 | Capacitor | C1, C9 | CAP CER 22UF 10V X5R 0603 | Cap-0603 | CC0603MRX5R6BB226 | Yageo | - | C109447 | 22uF | 2 | 200 | 220 | LCSC (https://www.lcsc.com/product-detail/Multilayer-Ceramic-Capacitors-MLCC-SMD-SMT_YAGEO-CC0603MRX5R6BB226_C109447.html) | $0.0289 | $6.3580
2 | Capacitor | C2, C3, C4, C5, C6, C7, C11 | CAP CER 0.1UF 50V X5R 0603 | Cap-0603 | CC0603KRX5R9BB104 | Yageo | - | C110022 | 0.1uF | 7 | 700 | 800 | LCSC (https://www.lcsc.com/product-detail/Multilayer-Ceramic-Capacitors-MLCC-SMD-SMT_YAGEO-CC0603KRX5R9BB104_C110022.html) | $0.0036 | $2.8800
3 | Capacitor | C8, C10 | CAP CER 10UF 25V X5R 0603 | Cap-0603 | C1608X5R1E106M080AC | TDK | - | C2168289 | 10uF | 2 | 200 | 202 | LCSC (https://www.lcsc.com/product-detail/Multilayer-Ceramic-Capacitors-MLCC-SMD-SMT_TDK-C1608X5R1E106M080AC_C2168289.html) | $0.6746 | $136.2692
4 | Capacitor | C12, C13 | 50V 6.8nF X7R ±10% 0603 | Cap-0603 | 0603B682K500NT | FH | - | C1631 | 6.8nF | 2 | 200 | 300 | LCSC (https://www.lcsc.com/product-detail/Multilayer-Ceramic-Capacitors-MLCC-SMD-SMT_FH-Guangdong-Fenghua-Advanced-Tech-0603B682K500NT_C1631.html) | $0.0028 | $0.8400
5 | Capacitor | C14 | CAP CER 0.022UF 100V X7R 0603 | Cap-0603 | ~~CGA3E2X7R2A223K080AA~~ | TDK |  | C426087 | 22nF | 1 | 100 | 150 | LCSC (https://www.lcsc.com/product-detail/Multilayer-Ceramic-Capacitors-MLCC-SMD-SMT_Murata-Electronics-GRM188R72A223KAC4D_C426087.html) | $0.0158 | $2.3700
6 | Capacitor | C15, C16 | CAP CER 10000PF 100V X7R 0603 | Cap-0603 | AC0603KRX7R0BB103 | Yageo | - | C149602 | 10nF | 2 | 200 | 300 | LCSC (https://www.lcsc.com/product-detail/Multilayer-Ceramic-Capacitors-MLCC-SMD-SMT_YAGEO-AC0603KRX7R0BB103_C149602.html) | $0.0074 | $2.2200
7 | Capacitor | C17 | CAP CER, 4.7 µF, 25 V, 0603 | Cap-0603 | C1608X5R1E475KT000E | TDK | - | C76615 | 4.7uF | 1 | 100 | 110 | LCSC (https://www.lcsc.com/product-detail/Multilayer-Ceramic-Capacitors-MLCC-SMD-SMT_TDK-C1608X5R1E475KT000E_C76615.html) | $0.0350 | $3.8500
8 | Capacitor | C18, C19 | CAP CER 12PF 100V C0G/NP0 0603 | Cap-0603 | ~~GCM1885C2A120JA16D~~ | Murata | 0603N120J101CT | C3858995 | 12pF | 2 | 200 | 300 | LCSC (https://www.lcsc.com/product-detail/Multilayer-Ceramic-Capacitors-MLCC-SMD-SMT_Walsin-Tech-Corp-0603N120J101CT_C3858995.html) | $0.0058 | $1.7400
9 | TVS Diode | D1, D2 | TVS DIODE 5.5VWM 8.5VC SOT23-3 | SOT-23 | SP0502BAHTG | Littelfuse | - | C207261 |  | 2 | 200 | 205 | LCSC (https://www.lcsc.com/product-detail/TVS_Littelfuse-SP0502BAHTG_C207261.html) | $0.0992 | $20.3360
10 | Ferrite Bead | FB1, FB2 | FERRITE BEAD 600 OHM 1210 1LN | IND-1210 | FBMH3225HM601NT | Taiyo Yuden | - | C268004 | - | 2 | 200 | 205 | LCSC (https://www.lcsc.com/product-detail/Ferrite-Beads_Taiyo-Yuden-FBMH3225HM601NT_C268004.html) | $0.1058 | $21.6890
11 | Ethernet Connector | J1 | CONN JACK 1PORT 100 BASE-T PCB | Custom | ARJM11D7-114-AB-EW2 | Abracon | - | - | - | 1 | 100 | 101 | Mouser (https://eu.mouser.com/ProductDetail/ABRACON/ARJM11D7-114-AB-EW2?qs=YCa%2FAAYMW02ICsJcHu%252BNJg%3D%3D) | $2.7600 | $278.7600
12 | Mini PCIe SMD Pad | ~~J2~~ | ~~PCI Express Mini Card (Mini PCIe)~~ | ~~Custom~~ | ~~-~~ | ~~-~~ | ~~-~~ | ~~-~~ | - | ~~1~~ | ~~100~~ | ~~-~~ | ~~-~~ | ~~-~~ | ~~-~~ | ~~DO NOT MOUNT~~
13 | Mosfet | Q1 | 40V 100mW 100@10mA,1V 200mA 300MHz 300mV@50mA,5mA NPN -55℃~+150℃@(Tj) SOT-723 Bipolar Transistors - BJT ROHS | SOT-723 | MMBT3904M | TECH PUBLIC | - | C2923360 | - | 1 | 100 | 120 | LCSC (https://www.lcsc.com/product-detail/Bipolar-Transistors-BJT_TECH-PUBLIC-MMBT3904M_C2923360.html) | $0.0335 | $4.0200
14 | Mosfet | Q2 | MOSFET P-CH 12V 2.6A SUPERSOT3 | SOT-23 | FDN306P | ON Semiconductor / Fairchild | - | C5236682 | - | 1 | 100 | 110 | LCSC (https://www.lcsc.com/product-detail/Bipolar-Transistors-BJT_TECH-PUBLIC-MMBT3904M_C2923360.html) | $0.0490 | $5.3900
15 | Resistor | R1 | RES SMD 1K OHM 1% 1/10W 0603 | Res-0603 | RC0603FR-071KL | Yageo | - | C22548 | 1K | 1 | 100 | 200 | LCSC (https://www.lcsc.com/product-detail/Chip-Resistor-Surface-Mount_YAGEO-RC0603FR-071KL_C22548.html) | $0.0010 | $0.2000
16 | Resistor | R2, R9, R12, R17, R18, R19, R22, R23, R24, R25, R26, R27 | RES SMD 10K OHM 1% 1/20W 0201 | Res-0201 | RC0201FR-0710KL | Yageo | - | C106225 | 10K | 12 | 1200 | 1300 | LCSC (https://www.lcsc.com/product-detail/Chip-Resistor-Surface-Mount_YAGEO-RC0201FR-0710KL_C106225.html) | $0.0007 | $0.9100
17 | Resistor | R3, R21, R29 | RES SMD 0R, 1%, 0.1W, 0603 | Res-0603 | RC0603FR-070RL | Yageo | - | C100044 | 0R | 3 | 300 | 400 | LCSC (https://www.lcsc.com/product-detail/Chip-Resistor-Surface-Mount_YAGEO-RC0603FR-070RL_C100044.html) | $0.0013 | $0.5200
18 | Resistor | R4, R5, R15, R16 | RES 49.9 OHM 1% 1/10W 0603 | Res-0603 | RC0603FR-0749R9L | Yageo | - | C114625 | 49.9R | 4 | 400 | 500 | LCSC (https://www.lcsc.com/product-detail/Chip-Resistor-Surface-Mount_YAGEO-RC0603FR-0749R9L_C114625.html) | $0.0012 | $0.6000
19 | Resistor | R6 | RES SMD 10 OHM 1% 1/10W 0603 | Res-0603 | RC0603FR-0710RL | Yageo | - | C109318 | 10R | 1 | 100 | 200 | LCSC (https://www.lcsc.com/product-detail/Chip-Resistor-Surface-Mount_YAGEO-RC0603FR-0710RL_C109318.html) | $0.0032 | $0.6400
20 | Resistor | R7, R8, R11, R13 | RES SMD 0603 33 Ohm 1% 1/10W | Res-0603 | RC0603FR-0733RL | Yageo | - | C108661 | 33R | 4 | 400 | 500 | LCSC (https://www.lcsc.com/product-detail/Chip-Resistor-Surface-Mount_YAGEO-RC0603FR-0733RL_C108661.html) | $0.0012 | $0.6000
21 | Resistor | R10, R14 | RES SMD 330R 100 mW 0603 | Res-0603 | RC0603JR-07330RL | Yageo | - | C105879 | 330R | 2 | 200 | 300 | LCSC (https://www.lcsc.com/product-detail/Chip-Resistor-Surface-Mount_YAGEO-RC0603JR-07330RL_C105879.html) | $0.0011 | $0.3300
22 | Resistor | R20 | RES SMD 1M OHM 1% 1/10W 0603 | Res-0603 | RC0603FR-071ML | Yageo | - | C105578 | 1M | 1 | 100 | 200 | LCSC (https://www.lcsc.com/product-detail/Chip-Resistor-Surface-Mount_YAGEO-RC0603FR-071ML_C105578.html) | $0.0012 | $0.2400
23 | Resistor | R28 | RES SMD 12.4K OHM 1% 1/10W 0603 | Res-0603 | RC0603FR-0712K4L | Yageo | - | C137798 | 12.4K | 1 | 100 | 200 | LCSC (https://www.lcsc.com/product-detail/Chip-Resistor-Surface-Mount_YAGEO-RC0603FR-0712K4L_C137798.html) | $0.0012 | $0.2400
24 | Resistor | R30 | RES 4.7K OHM 1% 1/16W 0402 | Res-0402 | RC0402FR-074K7L | Yageo | - | C105871 | 4.7K | 1 | 100 | 200 | LCSC (https://www.lcsc.com/product-detail/Chip-Resistor-Surface-Mount_YAGEO-RC0402FR-074K7L_C105871.html) | $0.0007 | $0.1400
25 | IC | U1 | SPI LQFP-48(7x7) Ethernet ICs ROHS | 48-LQFP (7x7)_ | W5500 | WIZNET | - | C32843 | - | 1 | 100 | 101 | LCSC (https://www.lcsc.com/product-detail/Ethernet-ICs_WIZNET-W5500_C32843.html) | $2.0237 | $204.3937
26 | Crystal | X1 | SMD3225-4P Crystals ROHS | Custom | NX3225GA-25MHZ-STD-CRG-2 | NDK | - | C438901 | 25MHZ | 1 | 100 | 101 | LCSC (https://www.lcsc.com/product-detail/Crystals_NDK-NX3225GA-25MHZ-STD-CRG-2_C438901.html) | $0.1566 | $15.8166
27 | Peripheral | - | Eternet Cable | - | LC-2030C | Shengwei | - | C3011736 | - | 1 | 100 | 100 | LCSC (https://www.lcsc.com/product-detail/Cable_Shengwei-LC-2030C_C3011736.html) | $1.2712 | $127.1200
 |  |  |  |  |  |  |  |  |  |  |  | Total Component Cost |  |  | $838.47
 |  |  |  |  |  |  |  |  |  |  |  | Single Board Cost |  |  | $8.38

Sheet: 500 Boards
 |  | Component list |  | Bill of Materials for Project [Ethernet-Module-v2.0.]
 |  | Source Data From: |  | Ethernet-Module-v2.0.
 |  | Project: |  | Ethernet-Module-v2.0.
 |  | Variant: |  | None
# | Item Type | Designator | Description | Footprint | Manufacturer Part Number | Manufacturer | Alternate Part Number | LCSC Part Number | Value | Quantity | Quantity (500 Boards) | MOQ (500 Boards) | Links | Unit Cost (500 Boards) | Total Cost (500 Boards) | Remarks | Reviewer Remarks
1 | Capacitor | C1, C9 | CAP CER 22UF 10V X5R 0603 | Cap-0603 | CC0603MRX5R6BB226 | Yageo | - | C109447 | 22uF | 2 | 1000 | 1020 | LCSC (https://www.lcsc.com/product-detail/Multilayer-Ceramic-Capacitors-MLCC-SMD-SMT_YAGEO-CC0603MRX5R6BB226_C109447.html) | $0.0254 | $25.9080
2 | Capacitor | C2, C3, C4, C5, C6, C7, C11 | CAP CER 0.1UF 50V X5R 0603 | Cap-0603 | CC0603KRX5R9BB104 | Yageo | - | C110022 | 0.1uF | 7 | 3500 | 3600 | LCSC (https://www.lcsc.com/product-detail/Multilayer-Ceramic-Capacitors-MLCC-SMD-SMT_YAGEO-CC0603KRX5R9BB104_C110022.html) | $0.0029 | $10.4400
3 | Capacitor | C8, C10 | CAP CER 10UF 25V X5R 0603 | Cap-0603 | C1608X5R1E106M080AC | TDK | - | C2168289 | 10uF | 2 | 1000 | 1010 | LCSC (https://www.lcsc.com/product-detail/Multilayer-Ceramic-Capacitors-MLCC-SMD-SMT_TDK-C1608X5R1E106M080AC_C2168289.html) | $0.6746 | $681.3460
4 | Capacitor | C12, C13 | 50V 6.8nF X7R ±10% 0603 | Cap-0603 | 0603B682K500NT | FH | - | C1631 | 6.8nF | 2 | 1000 | 1100 | LCSC (https://www.lcsc.com/product-detail/Multilayer-Ceramic-Capacitors-MLCC-SMD-SMT_FH-Guangdong-Fenghua-Advanced-Tech-0603B682K500NT_C1631.html) | $0.0022 | $2.4200
5 | Capacitor | C14 | CAP CER 0.022UF 100V X7R 0603 | Cap-0603 | ~~CGA3E2X7R2A223K080AA~~ | TDK |  | C426087 | 22nF | 1 | 500 | 550 | LCSC (https://www.lcsc.com/product-detail/Multilayer-Ceramic-Capacitors-MLCC-SMD-SMT_Murata-Electronics-GRM188R72A223KAC4D_C426087.html) | $0.0127 | $6.9850
6 | Capacitor | C15, C16 | CAP CER 10000PF 100V X7R 0603 | Cap-0603 | AC0603KRX7R0BB103 | Yageo | - | C149602 | 10nF | 2 | 1000 | 1100 | LCSC (https://www.lcsc.com/product-detail/Multilayer-Ceramic-Capacitors-MLCC-SMD-SMT_YAGEO-AC0603KRX7R0BB103_C149602.html) | $0.0056 | $6.1600
7 | Capacitor | C17 | CAP CER, 4.7 µF, 25 V, 0603 | Cap-0603 | C1608X5R1E475KT000E | TDK | - | C76615 | 4.7uF | 1 | 500 | 510 | LCSC (https://www.lcsc.com/product-detail/Multilayer-Ceramic-Capacitors-MLCC-SMD-SMT_TDK-C1608X5R1E475KT000E_C76615.html) | $0.0316 | $16.1160
8 | Capacitor | C18, C19 | CAP CER 12PF 100V C0G/NP0 0603 | Cap-0603 | ~~GCM1885C2A120JA16D~~ | Murata | 0603N120J101CT | C3858995 | 12pF | 2 | 1000 | 1100 | LCSC (https://www.lcsc.com/product-detail/Multilayer-Ceramic-Capacitors-MLCC-SMD-SMT_Walsin-Tech-Corp-0603N120J101CT_C3858995.html) | $0.0047 | $5.1700
9 | TVS Diode | D1, D2 | TVS DIODE 5.5VWM 8.5VC SOT23-3 | SOT-23 | SP0502BAHTG | Littelfuse | - | C207261 |  | 2 | 1000 | 1010 | LCSC (https://www.lcsc.com/product-detail/TVS_Littelfuse-SP0502BAHTG_C207261.html) | $0.0847 | $85.5470
10 | Ferrite Bead | FB1, FB2 | FERRITE BEAD 600 OHM 1210 1LN | IND-1210 | FBMH3225HM601NT | Taiyo Yuden | - | C268004 | - | 2 | 1000 | 1010 | LCSC (https://www.lcsc.com/product-detail/Ferrite-Beads_Taiyo-Yuden-FBMH3225HM601NT_C268004.html) | $0.0967 | $97.6670
11 | Ethernet Connector | J1 | CONN JACK 1PORT 100 BASE-T PCB | Custom | ARJM11D7-114-AB-EW2 | Abracon | - | - | - | 1 | 500 | 501 | Mouser (https://eu.mouser.com/ProductDetail/ABRACON/ARJM11D7-114-AB-EW2?qs=YCa%2FAAYMW02ICsJcHu%252BNJg%3D%3D) | $2.1400 | $1072.1400
12 | Mini PCIe SMD Pad | ~~J2~~ | ~~PCI Express Mini Card (Mini PCIe)~~ | ~~Custom~~ | ~~-~~ | ~~-~~ | ~~-~~ | ~~-~~ | - | ~~1~~ | 500 | ~~-~~ | ~~-~~ | ~~-~~ | ~~-~~ | ~~DO NOT MOUNT~~
13 | Mosfet | Q1 | 40V 100mW 100@10mA,1V 200mA 300MHz 300mV@50mA,5mA NPN -55℃~+150℃@(Tj) SOT-723 Bipolar Transistors - BJT ROHS | SOT-723 | MMBT3904M | TECH PUBLIC | - | C2923360 | - | 1 | 500 | 520 | LCSC (https://www.lcsc.com/product-detail/Bipolar-Transistors-BJT_TECH-PUBLIC-MMBT3904M_C2923360.html) | $0.0271 | $14.0920
14 | Mosfet | Q2 | MOSFET P-CH 12V 2.6A SUPERSOT3 | SOT-23 | FDN306P | ON Semiconductor / Fairchild | - | C5236682 | - | 1 | 500 | 510 | LCSC (https://www.lcsc.com/product-detail/Bipolar-Transistors-BJT_TECH-PUBLIC-MMBT3904M_C2923360.html) | $0.0432 | $22.0320
15 | Resistor | R1 | RES SMD 1K OHM 1% 1/10W 0603 | Res-0603 | RC0603FR-071KL | Yageo | - | C22548 | 1K | 1 | 500 | 600 | LCSC (https://www.lcsc.com/product-detail/Chip-Resistor-Surface-Mount_YAGEO-RC0603FR-071KL_C22548.html) | $0.0010 | $0.6000
16 | Resistor | R2, R9, R12, R17, R18, R19, R22, R23, R24, R25, R26, R27 | RES SMD 10K OHM 1% 1/20W 0201 | Res-0201 | RC0201FR-0710KL | Yageo | - | C106225 | 10K | 12 | 6000 | 6100 | LCSC (https://www.lcsc.com/product-detail/Chip-Resistor-Surface-Mount_YAGEO-RC0201FR-0710KL_C106225.html) | $0.0005 | $3.0500
17 | Resistor | R3, R21, R29 | RES SMD 0R, 1%, 0.1W, 0603 | Res-0603 | RC0603FR-070RL | Yageo | - | C100044 | 0R | 3 | 1500 | 1600 | LCSC (https://www.lcsc.com/product-detail/Chip-Resistor-Surface-Mount_YAGEO-RC0603FR-070RL_C100044.html) | $0.0010 | $1.6000
18 | Resistor | R4, R5, R15, R16 | RES 49.9 OHM 1% 1/10W 0603 | Res-0603 | RC0603FR-0749R9L | Yageo | - | C114625 | 49.9R | 4 | 2000 | 2100 | LCSC (https://www.lcsc.com/product-detail/Chip-Resistor-Surface-Mount_YAGEO-RC0603FR-0749R9L_C114625.html) | $0.0010 | $2.1000
19 | Resistor | R6 | RES SMD 10 OHM 1% 1/10W 0603 | Res-0603 | RC0603FR-0710RL | Yageo | - | C109318 | 10R | 1 | 500 | 600 | LCSC (https://www.lcsc.com/product-detail/Chip-Resistor-Surface-Mount_YAGEO-RC0603FR-0710RL_C109318.html) | $0.0030 | $1.8000
20 | Resistor | R7, R8, R11, R13 | RES SMD 0603 33 Ohm 1% 1/10W | Res-0603 | RC0603FR-0733RL | Yageo | - | C108661 | 33R | 4 | 2000 | 2100 | LCSC (https://www.lcsc.com/product-detail/Chip-Resistor-Surface-Mount_YAGEO-RC0603FR-0733RL_C108661.html) | $0.0010 | $2.1000
21 | Resistor | R10, R14 | RES SMD 330R 100 mW 0603 | Res-0603 | RC0603JR-07330RL | Yageo | - | C105879 | 330R | 2 | 1000 | 1100 | LCSC (https://www.lcsc.com/product-detail/Chip-Resistor-Surface-Mount_YAGEO-RC0603JR-07330RL_C105879.html) | $0.0008 | $0.8800
22 | Resistor | R20 | RES SMD 1M OHM 1% 1/10W 0603 | Res-0603 | RC0603FR-071ML | Yageo | - | C105578 | 1M | 1 | 500 | 600 | LCSC (https://www.lcsc.com/product-detail/Chip-Resistor-Surface-Mount_YAGEO-RC0603FR-071ML_C105578.html) | $0.0012 | $0.7200
23 | Resistor | R28 | RES SMD 12.4K OHM 1% 1/10W 0603 | Res-0603 | RC0603FR-0712K4L | Yageo | - | C137798 | 12.4K | 1 | 500 | 600 | LCSC (https://www.lcsc.com/product-detail/Chip-Resistor-Surface-Mount_YAGEO-RC0603FR-0712K4L_C137798.html) | $0.0012 | $0.7200
24 | Resistor | R30 | RES 4.7K OHM 1% 1/16W 0402 | Res-0402 | RC0402FR-074K7L | Yageo | - | C105871 | 4.7K | 1 | 500 | 600 | LCSC (https://www.lcsc.com/product-detail/Chip-Resistor-Surface-Mount_YAGEO-RC0402FR-074K7L_C105871.html) | $0.0007 | $0.4200
25 | IC | U1 | SPI LQFP-48(7x7) Ethernet ICs ROHS | 48-LQFP (7x7)_ | W5500 | WIZNET | - | C32843 | - | 1 | 500 | 502 | LCSC (https://www.lcsc.com/product-detail/Ethernet-ICs_WIZNET-W5500_C32843.html) | $1.9489 | $978.3478
26 | Crystal | X1 | SMD3225-4P Crystals ROHS | Custom | NX3225GA-25MHZ-STD-CRG-2 | NDK | - | C438901 | 25MHZ | 1 | 500 | 502 | LCSC (https://www.lcsc.com/product-detail/Crystals_NDK-NX3225GA-25MHZ-STD-CRG-2_C438901.html) | $0.1450 | $72.7900
27 | Peripheral | - | Eternet Cable | - | LC-2030C | Shengwei | - | C3011736 | - | 1 | 500 | 502 | LCSC (https://www.lcsc.com/product-detail/Cable_Shengwei-LC-2030C_C3011736.html) | $1.2712 | $638.1424
 |  |  |  |  |  |  |  |  |  |  |  | Total Component Cost |  |  | $3749.29
 |  |  |  |  |  |  |  |  |  |  |  | Single Board Cost |  |  | $7.50

Sheet: 1000 Boards
 |  | Component list |  | Bill of Materials for Project [Ethernet-Module-v2.0.]
 |  | Source Data From: |  | Ethernet-Module-v2.0.
 |  | Project: |  | Ethernet-Module-v2.0.
 |  | Variant: |  | None
# | Item Type | Designator | Description | Footprint | Manufacturer Part Number | Manufacturer | Alternate Part Number | LCSC Part Number | Value | Quantity | Quantity (1000 Boards) | MOQ (1000 Boards) | Links | Unit Cost (1000 Boards) | Total Cost (1000 Boards) | Remarks | Reviewer Remarks
1 | Capacitor | C1, C9 | CAP CER 22UF 10V X5R 0603 | Cap-0603 | CC0603MRX5R6BB226 | Yageo | - | C109447 | 22uF | 2 | 2000 | 2020 | LCSC (https://www.lcsc.com/product-detail/Multilayer-Ceramic-Capacitors-MLCC-SMD-SMT_YAGEO-CC0603MRX5R6BB226_C109447.html) | $0.0254 | $51.3080
2 | Capacitor | C2, C3, C4, C5, C6, C7, C11 | CAP CER 0.1UF 50V X5R 0603 | Cap-0603 | CC0603KRX5R9BB104 | Yageo | - | C110022 | 0.1uF | 7 | 7000 | 7100 | LCSC (https://www.lcsc.com/product-detail/Multilayer-Ceramic-Capacitors-MLCC-SMD-SMT_YAGEO-CC0603KRX5R9BB104_C110022.html) | $0.0026 | $18.4600
3 | Capacitor | C8, C10 | CAP CER 10UF 25V X5R 0603 | Cap-0603 | C1608X5R1E106M080AC | TDK | - | C2168289 | 10uF | 2 | 2000 | 2010 | LCSC (https://www.lcsc.com/product-detail/Multilayer-Ceramic-Capacitors-MLCC-SMD-SMT_TDK-C1608X5R1E106M080AC_C2168289.html) | $0.6746 | $1355.9460
4 | Capacitor | C12, C13 | 50V 6.8nF X7R ±10% 0603 | Cap-0603 | 0603B682K500NT | FH | - | C1631 | 6.8nF | 2 | 2000 | 2100 | LCSC (https://www.lcsc.com/product-detail/Multilayer-Ceramic-Capacitors-MLCC-SMD-SMT_FH-Guangdong-Fenghua-Advanced-Tech-0603B682K500NT_C1631.html) | $0.0022 | $4.6200
5 | Capacitor | C14 | CAP CER 0.022UF 100V X7R 0603 | Cap-0603 | ~~CGA3E2X7R2A223K080AA~~ | TDK |  | C426087 | 22nF | 1 | 1000 | 1050 | LCSC (https://www.lcsc.com/product-detail/Multilayer-Ceramic-Capacitors-MLCC-SMD-SMT_Murata-Electronics-GRM188R72A223KAC4D_C426087.html) | $0.0127 | $13.3350
6 | Capacitor | C15, C16 | CAP CER 10000PF 100V X7R 0603 | Cap-0603 | AC0603KRX7R0BB103 | Yageo | - | C149602 | 10nF | 2 | 2000 | 2100 | LCSC (https://www.lcsc.com/product-detail/Multilayer-Ceramic-Capacitors-MLCC-SMD-SMT_YAGEO-AC0603KRX7R0BB103_C149602.html) | $0.0056 | $11.7600
7 | Capacitor | C17 | CAP CER, 4.7 µF, 25 V, 0603 | Cap-0603 | C1608X5R1E475KT000E | TDK | - | C76615 | 4.7uF | 1 | 1000 | 1010 | LCSC (https://www.lcsc.com/product-detail/Multilayer-Ceramic-Capacitors-MLCC-SMD-SMT_TDK-C1608X5R1E475KT000E_C76615.html) | $0.0290 | $29.2900
8 | Capacitor | C18, C19 | CAP CER 12PF 100V C0G/NP0 0603 | Cap-0603 | ~~GCM1885C2A120JA16D~~ | Murata | 0603N120J101CT | C3858995 | 12pF | 2 | 2000 | 2100 | LCSC (https://www.lcsc.com/product-detail/Multilayer-Ceramic-Capacitors-MLCC-SMD-SMT_Walsin-Tech-Corp-0603N120J101CT_C3858995.html) | $0.0047 | $9.8700
9 | TVS Diode | D1, D2 | TVS DIODE 5.5VWM 8.5VC SOT23-3 | SOT-23 | SP0502BAHTG | Littelfuse | - | C207261 |  | 2 | 2000 | 2010 | LCSC (https://www.lcsc.com/product-detail/TVS_Littelfuse-SP0502BAHTG_C207261.html) | $0.0847 | $170.2470
10 | Ferrite Bead | FB1, FB2 | FERRITE BEAD 600 OHM 1210 1LN | IND-1210 | FBMH3225HM601NT | Taiyo Yuden | - | C268004 | - | 2 | 2000 | 2100 | LCSC (https://www.lcsc.com/product-detail/Ferrite-Beads_Taiyo-Yuden-FBMH3225HM601NT_C268004.html) | $0.0967 | $203.0700
11 | Ethernet Connector | J1 | CONN JACK 1PORT 100 BASE-T PCB | Custom | ARJM11D7-114-AB-EW2 | Abracon | - | - | - | 1 | 1000 | 1001 | Mouser (https://eu.mouser.com/ProductDetail/ABRACON/ARJM11D7-114-AB-EW2?qs=YCa%2FAAYMW02ICsJcHu%252BNJg%3D%3D) | $1.9900 | $1991.9900
12 | Mini PCIe SMD Pad | ~~J2~~ | ~~PCI Express Mini Card (Mini PCIe)~~ | ~~Custom~~ | ~~-~~ | ~~-~~ | ~~-~~ | ~~-~~ | - | ~~1~~ | 1000 | ~~-~~ | ~~-~~ | ~~-~~ | ~~-~~ | ~~DO NOT MOUNT~~
13 | Mosfet | Q1 | 40V 100mW 100@10mA,1V 200mA 300MHz 300mV@50mA,5mA NPN -55℃~+150℃@(Tj) SOT-723 Bipolar Transistors - BJT ROHS | SOT-723 | MMBT3904M | TECH PUBLIC | - | C2923360 | - | 1 | 1000 | 1020 | LCSC (https://www.lcsc.com/product-detail/Bipolar-Transistors-BJT_TECH-PUBLIC-MMBT3904M_C2923360.html) | $0.0235 | $23.9700
14 | Mosfet | Q2 | MOSFET P-CH 12V 2.6A SUPERSOT3 | SOT-23 | FDN306P | ON Semiconductor / Fairchild | - | C5236682 | - | 1 | 1000 | 1010 | LCSC (https://www.lcsc.com/product-detail/Bipolar-Transistors-BJT_TECH-PUBLIC-MMBT3904M_C2923360.html) | $0.0432 | $43.6320
15 | Resistor | R1 | RES SMD 1K OHM 1% 1/10W 0603 | Res-0603 | RC0603FR-071KL | Yageo | - | C22548 | 1K | 1 | 1000 | 1100 | LCSC (https://www.lcsc.com/product-detail/Chip-Resistor-Surface-Mount_YAGEO-RC0603FR-071KL_C22548.html) | $0.0010 | $1.1000
16 | Resistor | R2, R9, R12, R17, R18, R19, R22, R23, R24, R25, R26, R27 | RES SMD 10K OHM 1% 1/20W 0201 | Res-0201 | RC0201FR-0710KL | Yageo | - | C106225 | 10K | 12 | 12000 | 12100 | LCSC (https://www.lcsc.com/product-detail/Chip-Resistor-Surface-Mount_YAGEO-RC0201FR-0710KL_C106225.html) | $0.0005 | $6.0500
17 | Resistor | R3, R21, R29 | RES SMD 0R, 1%, 0.1W, 0603 | Res-0603 | RC0603FR-070RL | Yageo | - | C100044 | 0R | 3 | 3000 | 3100 | LCSC (https://www.lcsc.com/product-detail/Chip-Resistor-Surface-Mount_YAGEO-RC0603FR-070RL_C100044.html) | $0.0010 | $3.1000
18 | Resistor | R4, R5, R15, R16 | RES 49.9 OHM 1% 1/10W 0603 | Res-0603 | RC0603FR-0749R9L | Yageo | - | C114625 | 49.9R | 4 | 4000 | 4100 | LCSC (https://www.lcsc.com/product-detail/Chip-Resistor-Surface-Mount_YAGEO-RC0603FR-0749R9L_C114625.html) | $0.0010 | $4.1000
19 | Resistor | R6 | RES SMD 10 OHM 1% 1/10W 0603 | Res-0603 | RC0603FR-0710RL | Yageo | - | C109318 | 10R | 1 | 1000 | 1100 | LCSC (https://www.lcsc.com/product-detail/Chip-Resistor-Surface-Mount_YAGEO-RC0603FR-0710RL_C109318.html) | $0.0024 | $2.6400
20 | Resistor | R7, R8, R11, R13 | RES SMD 0603 33 Ohm 1% 1/10W | Res-0603 | RC0603FR-0733RL | Yageo | - | C108661 | 33R | 4 | 4000 | 4100 | LCSC (https://www.lcsc.com/product-detail/Chip-Resistor-Surface-Mount_YAGEO-RC0603FR-0733RL_C108661.html) | $0.0010 | $4.1000
21 | Resistor | R10, R14 | RES SMD 330R 100 mW 0603 | Res-0603 | RC0603JR-07330RL | Yageo | - | C105879 | 330R | 2 | 2000 | 2100 | LCSC (https://www.lcsc.com/product-detail/Chip-Resistor-Surface-Mount_YAGEO-RC0603JR-07330RL_C105879.html) | $0.0008 | $1.6800
22 | Resistor | R20 | RES SMD 1M OHM 1% 1/10W 0603 | Res-0603 | RC0603FR-071ML | Yageo | - | C105578 | 1M | 1 | 1000 | 1100 | LCSC (https://www.lcsc.com/product-detail/Chip-Resistor-Surface-Mount_YAGEO-RC0603FR-071ML_C105578.html) | $0.0010 | $1.1000
23 | Resistor | R28 | RES SMD 12.4K OHM 1% 1/10W 0603 | Res-0603 | RC0603FR-0712K4L | Yageo | - | C137798 | 12.4K | 1 | 1000 | 1100 | LCSC (https://www.lcsc.com/product-detail/Chip-Resistor-Surface-Mount_YAGEO-RC0603FR-0712K4L_C137798.html) | $0.0010 | $1.1000
24 | Resistor | R30 | RES 4.7K OHM 1% 1/16W 0402 | Res-0402 | RC0402FR-074K7L | Yageo | - | C105871 | 4.7K | 1 | 1000 | 1100 | LCSC (https://www.lcsc.com/product-detail/Chip-Resistor-Surface-Mount_YAGEO-RC0402FR-074K7L_C105871.html) | $0.0005 | $0.5500
25 | IC | U1 | SPI LQFP-48(7x7) Ethernet ICs ROHS | 48-LQFP (7x7)_ | W5500 | WIZNET | - | C32843 | - | 1 | 1000 | 1002 | LCSC (https://www.lcsc.com/product-detail/Ethernet-ICs_WIZNET-W5500_C32843.html) | $1.9155 | $1919.3310
26 | Crystal | X1 | SMD3225-4P Crystals ROHS | Custom | NX3225GA-25MHZ-STD-CRG-2 | NDK | - | C438901 | 25MHZ | 1 | 1000 | 1002 | LCSC (https://www.lcsc.com/product-detail/Crystals_NDK-NX3225GA-25MHZ-STD-CRG-2_C438901.html) | $0.1381 | $138.3762
27 | Peripheral | - | Eternet Cable | - | LC-2030C | Shengwei | - | C3011736 | - | 1 | 1000 | 1002 | LCSC (https://www.lcsc.com/product-detail/Cable_Shengwei-LC-2030C_C3011736.html) | $1.2712 | $1273.7424
 |  |  |  |  |  |  |  |  |  |  |  | Total Component Cost |  |  | $7284.47
 |  |  |  |  |  |  |  |  |  |  |  | Single Board Cost |  |  | $7.28
