eSpark-Backup/chrisbyrd-esp32iotproduct/Design Files/LTE-Module-v2.0/BOM/Client_BOM_v2.0.xlsx

 |  | Component list |  | Bill of Materials for Project [LTE_MODULE_v2.0.]
 |  | Source Data From: |  | LTE_MODULE_v2.0
 |  | Project: |  | LTE_MODULE_v2.0
 |  | Variant: |  | None
# | Item Type | Designator | Description | Footprint | Manufacturer Part Number | Manufacturer | Value | Quantity | Quantity (5 Boards) | Remarks
1 | Antenna | ANT1 | RF ANT 1.575GHZ CHIP SOLDER SMD | Custom | W3011 | Pulse | - | 1 | 5
2 | Capacitor | C1 | CAP CER 2.2PF 50V C0G/NPO 0603 | Cap-0603 | CC0603CRNPO9BN2R2 | Yageo | 2.2pF | 1 | 5
3 | Capacitor | C2 | CAP CER 33PF 25V C0G/NP0 0402 | Cap-0402 | GRM1555C1E330JA01D | Murata | 33pF | 1 | 5
4 | Capacitor | C5, C11, C13, C15, C16, C17 | CAP CER 0.1UF 50V X5R 0603 | Cap-0603 | CC0603KRX5R9BB104 | Yageo | 0.1uF | 6 | 30
5 | Capacitor | C6 | CAP TANT 220UF 20% 6.3V SMD | Case-B | TLJB227M006R0500 | Kyocera AVX | 220uF | 1 | 5
6 | Capacitor | C7 | CAP CER 1UF 25V X5R 0603 | Cap-0603 | CC0603KRX5R8BB105 | Yageo | 1uF | 1 | 5
7 | Capacitor | C8, C9, C10 | CAP CER 22PF 50V C0G/NPO 0402 | Cap-0402 | CC0402JRNPO9BN220 | Yageo | 22PF | 3 | 15
8 | Capacitor | C12, C14 | CAP CER 0.1UF 50V X7R 0402 | cap-0402 | C1005X7R1H104KT000F | TDK | 100nF | 2 | 10
9 | Diode | D1 | DIODE ZENER 5.1V 500MW SOD123 | SOD-123 | MMSZ5231BT1G | ON Semiconductor | - | 1 | 5
10 | Diode | D2, D3 | 35A@8/20us 15V 4.5V@Max Unidirectional DFN1006 TVS ROHS | DFN1006-2L_ | ESD5651N-2/TR | WILLSEMI(Will Semicon) | - | 2 | 10
11 | Diode | D4 | TVS DIODE 5VWM 6.3VC DSN0603-2 | DSN0603-2 | PESD5V0H1BSFYL | Nexperia | - | 1 | 5
12 | Diode | D5 | 16A 20V 7V 5V@Max Unidirectional SOT-23 TVS ROHS | Sot-23 | ESD5302F-3/TR | WILLSEMI | - | 1 | 5
13 | Fuse | F1 | 6V 500mA 40A 1A 0603 Resettable Fuses ROHS | Fuse-0603 | SMD0603-050 | TECHFUSE | - | 1 | 5
14 | SMA Connector | J1 | 1 Inner bore SMA Board Edge Bend 11mm 5.35mm Plugin RF Connectors / Coaxial Connectors ROHS | Custom | HJ-SMA175 | HJ Tech | - | 1 | 5
15 | PCIE SMD PAD | J2 | PCI Express Mini Card (Mini PCIe) | ~~Custom~~ | - | - | ~~-~~ | 1 | 5
16 | Pogo Connector | J3 | Pogo Pad 2.5mm 4 Pin | Custom | POGO Connector 4 Pin | - | ~~-~~ | 1 | 5
17 | SIM Card Connectors | J4, J5 | Copper Alloy Self bomb Gold plating 1.25mm Deck -40℃~+85℃ 260℃ NanoSIM SMD SIM Card Connectors ROHS | Custom | XKNANO-113 | XKB Connectivity | - | 2 | 10
18 | LED | LED1 | Yellow-Green 572nm LED Indication - Discrete 2.05V 0603 (1608 Metric) | LED-0603 | 19-21/G6C-FM1N2B/3T | Everlight Elec | - | 1 | 5
19 | LED | LED2 | Red 632nm LED Indication - Discrete 2.05V 0603 (1608 Metric) | LED-0603 | 19-21/R7C-AK1L2BY/3T | Everlight Elec | - | 1 | 5
20 | Mosfet | Q1, Q2, Q3, Q4 | 40V 100mW 100@10mA,1V 200mA 300MHz 300mV@50mA,5mA NPN -55℃~+150℃@(Tj) SOT-723 Bipolar Transistors - BJT ROHS | SOT-723 | MMBT3904M | TECH PUBLIC | - | 4 | 20
21 | Resistor | R1, R2, R12 | RES SMD 10K OHM 5% 1/10W 0603 | Res-0603 | AC0603JR-0710KL | Yageo | 10K | 3 | 15
22 | Resistor | R3, R5 | RES 22 OHM 1% 1/10W 0603 | Res-0603 | RC0603FR-0722RL | Yageo | 22R | 2 | 10
23 | Resistor | R4, R19 | RES SMD 0R, 1%, 0.1W, 0603 | Res-0603 | RC0603FR-070RL | Yageo | 0R | 2 | 10
24 | Resistor | R6, R9 | RES 180 OHM 1% 1/10W 0603 | Res-0603 | RC0603FR-07180RL | Yageo | 180R | 2 | 10
25 | Resistor | R7, R10, R13, R17 | RES SMD 4.7K OHM 5% 1/10W 0603 | Res-0603 | RC0603JR-074K7L | Yageo | 4.7K | 4 | 20
26 | Resistor | R8, R11, R14, R18 | RES 47K OHM 5% 1/10W 0603 | Res-0603 | RC0603JR-0747KL | Yageo | 47K | 4 | 20
27 | IC | U1 | SMD,30x30mm 2G/3G/4G/5G Modules ROHS | Custom | SIM7500E | SIMCom | - | 1 | 5
28 | IC | U2 | IC SWITCH 4PDT 16MLP | 16-MLP (3x3) | FSA2567MPX | ON Semiconductor / Fairchild | - | 1 | 5
29 | ESD Diode | U3,U4 | 15V 5 Unidirectional 5V SOT-363 ESD Protection Devices ROHS | SOT-363 | SMF05CT1G-ES | ElecSuper | - | 1 | 5
30 | IC | U5 | IC TRNSLTR BIDIRECTIONAL US8 | VSSOP-8(2x2.3x0.5) | TXB0102DCUT | Texas Instruments | - | 1 | 5
31 | Peripheral | - | 1.8 3dBi Vertical 50W - Antennas ROHS |  | BWGSMJWX105-7KJ | BAT WIRELESS | - | 1 | 5
32 | Peripheral | - | 2 5dBi 4GAntenna Vertical 2.4GHz 10W - Antennas ROHS | - | 801-4G | DreamLNK | - | 1 | 5
