eSpark-Backup/chrisbyrd-esp32iotproduct/Design Files/LTE-Module-v2.0/BOM/eSpark_BOM_v2.0.xlsx

Sheet: 5 Boards
 |  | Component list |  | Bill of Materials for Project [LTE_MODULE_v2.0.]
 |  | Source Data From: |  | LTE_MODULE_v2.0
 |  | Project: |  | LTE_MODULE_v2.0
 |  | Variant: |  | None
# | Item Type | Designator | Description | Footprint | Manufacturer Part Number | Manufacturer | Alternate Part Number | LCSC Part Number | Value | Quantity | Quantity (5 Boards) | MOQ (5 Boards) | Links | Unit Cost (5 Boards) | Total Cost (5 Boards) | Remarks | Reviewer Remarks
1 | Antenna | ANT1 | RF ANT 1.575GHZ CHIP SOLDER SMD | Custom | W3011 | Pulse | - | - | - | 1 | 5 | 6 | Digikey (https://www.digikey.com/en/products/detail/pulse-electronics/W3011/3025804) | $1.5900 | $9.5400 | Not Available in LCSC
2 | Capacitor | C1 | CAP CER 2.2PF 50V C0G/NPO 0603 | Cap-0603 | CC0603CRNPO9BN2R2 | Yageo | - | C282246 | 2.2pF | 1 | 5 | 100 | LCSC (https://www.lcsc.com/product-detail/Multilayer-Ceramic-Capacitors-MLCC-SMD-SMT_YAGEO-CC0603CRNPO9BN2R2_C282246.html) | $0.0040 | $0.4000
3 | Capacitor | C2 | CAP CER 33PF 25V C0G/NP0 0402 | Cap-0402 | ~~GRM1555C1E330JA01D~~ | Murata | 0402N330J250CT | C458864 | 33pF | 1 | 5 | 100 | LCSC (https://www.lcsc.com/product-detail/Multilayer-Ceramic-Capacitors-MLCC-SMD-SMT_Walsin-Tech-Corp-0402N330J250CT_C458864.html) | $0.0016 | $0.1600
4 | Capacitor | C5, C11, C13, C15, C16, C17 | CAP CER 0.1UF 50V X5R 0603 | Cap-0603 | ~~CC0603KRX5R9BB104~~ | Yageo | CC0603KRX7R9BB104 | C14663 | 0.1uF | 6 | 30 | 100 | LCSC (https://www.lcsc.com/product-detail/Multilayer-Ceramic-Capacitors-MLCC-SMD-SMT_YAGEO-CC0603KRX7R9BB104_C14663.html) | $0.0024 | $0.2400
5 | Capacitor | C6 | CAP TANT 220UF 20% 6.3V SMD | Case-B | TLJB227M006R0500 | Kyocera AVX | - | C30242 | 220uF | 1 | 5 | 10 | LCSC (https://www.lcsc.com/product-detail/Tantalum-Capacitors_Kyocera-AVX-TLJB227M006R0500_C30242.html) | $0.2178 | $2.1780
6 | Capacitor | C7 | CAP CER 1UF 25V X5R 0603 | Cap-0603 | CC0603KRX5R8BB105 | Yageo | - | C14664 | 1uF | 1 | 5 | 100 | LCSC (https://www.lcsc.com/product-detail/Multilayer-Ceramic-Capacitors-MLCC-SMD-SMT_YAGEO-CC0603KRX5R8BB105_C14664.html) | $0.0052 | $0.5200
7 | Capacitor | C8, C9, C10 | CAP CER 22PF 50V C0G/NPO 0402 | Cap-0402 | CC0402JRNPO9BN220 | Yageo | - | C106203 | 22PF | 3 | 15 | 100 | LCSC (https://www.lcsc.com/product-detail/Multilayer-Ceramic-Capacitors-MLCC-SMD-SMT_YAGEO-CC0402JRNPO9BN220_C106203.html) | $0.0010 | $0.1000
8 | Capacitor | C12, C14 | CAP CER 0.1UF 50V X7R 0402 | cap-0402 | C1005X7R1H104KT000F | TDK | - | C361198 | 100nF | 2 | 10 | 50 | LCSC (https://www.lcsc.com/product-detail/Multilayer-Ceramic-Capacitors-MLCC-SMD-SMT_TDK-C1005X7R1H104KT000F_C361198.html) | $0.0141 | $0.7050
9 | Diode | D1 | DIODE ZENER 5.1V 500MW SOD123 | SOD-123 | ~~MMSZ5231BT1G~~ | ON Semiconductor | SZMMSZ5231BT1G | C231290 | - | 1 | 5 | 10 | LCSC (https://www.lcsc.com/product-detail/Zener-Diodes_onsemi-SZMMSZ5231BT1G_C231290.html) | $0.1037 | $1.0370
10 | Diode | D2, D3 | 35A@8/20us 15V 4.5V@Max Unidirectional DFN1006 TVS ROHS | DFN1006-2L_ | ESD5651N-2/TR | WILLSEMI(Will Semicon) | - | C239784 | - | 2 | 10 | 20 | LCSC (https://www.lcsc.com/product-detail/TVS_WILLSEMI-Will-Semicon-ESD5651N-2-TR_C239784.html) | $0.0317 | $0.6340
11 | Diode | D4 | TVS DIODE 5VWM 6.3VC DSN0603-2 | DSN0603-2 | PESD5V0H1BSFYL | Nexperia | - | C477989 | - | 1 | 5 | 10 | LCSC (https://www.lcsc.com/product-detail/ESD-Protection-Devices_Nexperia-PESD5V0H1BSF_C477989.html) | $0.0556 | $0.5560
12 | Diode | D5 | 16A 20V 7V 5V@Max Unidirectional SOT-23 TVS ROHS | Sot-23 | ESD5302F-3/TR | WILLSEMI | - | C239643 | - | 1 | 5 | 10 | LCSC (https://www.lcsc.com/product-detail/TVS_WILLSEMI-Will-Semicon-ESD5302F-3-TR_C239643.html) | $0.0864 | $0.8640
13 | Fuse | F1 | 6V 500mA 40A 1A 0603 Resettable Fuses ROHS | Fuse-0603 | SMD0603-050 | TECHFUSE | - | C69679 | - | 1 | 5 | 10 | LCSC (https://www.lcsc.com/product-detail/Resettable-Fuses_TECHFUSE-SMD0603-050_C69679.html) | $0.0432 | $0.4320
14 | SMA Connector | J1 | 1 Inner bore SMA Board Edge Bend 11mm 5.35mm Plugin RF Connectors / Coaxial Connectors ROHS | Custom | HJ-SMA175 | HJ Tech | - | C1509213 | - | 1 | 5 | 6 | LCSC (https://www.lcsc.com/product-detail/RF-Connectors-Coaxial-Connectors_HJ-Tech-HJ-SMA175_C1509213.html) | $0.8162 | $4.8972
15 | PCIE SMD PAD | ~~J2~~ | ~~PCI Express Mini Card (Mini PCIe)~~ | ~~Custom~~ | ~~-~~ | ~~-~~ | ~~-~~ | ~~-~~ | ~~-~~ | ~~1~~ | ~~5~~ | ~~-~~ | ~~-~~ | ~~-~~ | ~~-~~
16 | Pogo Connector | ~~J3~~ | ~~Pogo Pad 2.5mm 4 Pin~~ | ~~Custom~~ | ~~POGO Connector 4 Pin~~ | ~~-~~ | ~~-~~ | ~~-~~ | ~~-~~ | ~~1~~ | ~~5~~ | ~~-~~ | ~~-~~ | ~~-~~ | ~~-~~
17 | SIM Card Connectors | J4, J5 | Copper Alloy Self bomb Gold plating 1.25mm Deck -40℃~+85℃ 260℃ NanoSIM SMD SIM Card Connectors ROHS | Custom | XKNANO-113 | XKB Connectivity | - | C381071 | - | 2 | 10 | 11 | LCSC (https://www.lcsc.com/product-detail/SIM-Card-Connectors_XKB-Connectivity-XKNANO-113_C381071.html) | $0.6714 | $7.3854
18 | LED | LED1 | Yellow-Green 572nm LED Indication - Discrete 2.05V 0603 (1608 Metric) | LED-0603 | 19-21/G6C-FM1N2B/3T | Everlight Elec | - | C93689 | - | 1 | 5 | 20 | LCSC (https://www.lcsc.com/product-detail/Light-Emitting-Diodes-LED_Everlight-Elec-19-21-G6C-FM1N2B-3T_C93689.html) | $0.0348 | $0.6960
19 | LED | LED2 | Red 632nm LED Indication - Discrete 2.05V 0603 (1608 Metric) | LED-0603 | 19-21/R7C-AK1L2BY/3T | Everlight Elec | - | C1322287 | - | 1 | 5 | 10 | LCSC (https://www.lcsc.com/product-detail/Light-Emitting-Diodes-LED_Everlight-Elec-19-21-R7C-AK1L2BY-3T_C1322287.html) | $0.0515 | $0.5150
20 | Transistor | Q1, Q2, Q3, Q4 | 40V 100mW 100@10mA,1V 200mA 300MHz 300mV@50mA,5mA NPN -55℃~+150℃@(Tj) SOT-723 Bipolar Transistors - BJT ROHS | SOT-723 | MMBT3904M | TECH PUBLIC | - | C2923360 | - | 4 | 20 | 40 | LCSC (https://www.lcsc.com/product-detail/Bipolar-Transistors-BJT_TECH-PUBLIC-MMBT3904M_C2923360.html) | $0.0335 | $1.3400
21 | Resistor | R1, R2, R12 | RES SMD 10K OHM 5% 1/10W 0603 | Res-0603 | AC0603JR-0710KL | Yageo | - | C140867 | 10K | 3 | 15 | 100 | LCSC (https://www.lcsc.com/product-detail/Chip-Resistor-Surface-Mount_YAGEO-AC0603JR-0710KL_C140867.html) | $0.0015 | $0.1500
22 | Resistor | R3, R5 | RES 22 OHM 1% 1/10W 0603 | Res-0603 | RC0603FR-0722RL | Yageo | - | C107701 | 22R | 2 | 10 | 100 | LCSC (https://www.lcsc.com/product-detail/Chip-Resistor-Surface-Mount_YAGEO-RC0603FR-0722RL_C107701.html) | $0.0012 | $0.1200
23 | Resistor | R4, R19 | RES SMD 0R, 1%, 0.1W, 0603 | Res-0603 | RC0603FR-070RL | Yageo | - | C100044 | 0R | 2 | 10 | 100 | LCSC (https://www.lcsc.com/product-detail/Chip-Resistor-Surface-Mount_YAGEO-RC0603FR-070RL_C100044.html) | $0.0013 | $0.1300
24 | Resistor | R6, R9 | RES 180 OHM 1% 1/10W 0603 | Res-0603 | RC0603FR-07180RL | Yageo | - | C137786 | 180R | 2 | 10 | 100 | LCSC (https://www.lcsc.com/product-detail/Chip-Resistor-Surface-Mount_YAGEO-RC0603FR-07180RL_C137786.html) | $0.0013 | $0.1300
25 | Resistor | R7, R10, R13, R17 | RES SMD 4.7K OHM 5% 1/10W 0603 | Res-0603 | RC0603JR-074K7L | Yageo | - | C105428 | 4.7K | 4 | 20 | 100 | LCSC (https://www.lcsc.com/product-detail/Chip-Resistor-Surface-Mount_YAGEO-RC0603JR-074K7L_C105428.html) | $0.0012 | $0.1200
26 | Resistor | R8, R11, R14, R18 | RES 47K OHM 5% 1/10W 0603 | Res-0603 | RC0603JR-0747KL | Yageo | - | C127447 | 47K | 4 | 20 | 100 | LCSC (https://www.lcsc.com/product-detail/Chip-Resistor-Surface-Mount_YAGEO-RC0603JR-0747KL_C127447.html) | $0.0011 | $0.1100
27 | IC | U1 | SMD,30x30mm 2G/3G/4G/5G Modules ROHS | Custom | SIM7500E | SIMCom | - | - | - | 1 | 5 | 6 | Chipsmall (https://www.chipsmall.com/Products/SIM7500E_SIMCom-Wireless-Solutions_20290450.html) | $62.9870 | $377.9220
28 | IC | U2 | IC SWITCH 4PDT 16MLP | 16-MLP (3x3) | FSA2567MPX | ON Semiconductor / Fairchild | - | C512961 | - | 1 | 5 | 6 | LCSC (https://www.lcsc.com/product-detail/Analog-Switches-Multiplexers_onsemi-FSA2567MPX_C512961.html) | $0.6460 | $3.8760
29 | ESD Diode | U3,U4 | 15V 5 Unidirectional 5V SOT-363 ESD Protection Devices ROHS | SOT-363 | SMF05CT1G-ES | ElecSuper | - | C5180312 | - | 2 | 10 | 20 | LCSC (https://www.lcsc.com/product-detail/ESD-Protection-Devices_ElecSuper-SMF05CT1G-ES_C5180312.html) | $0.0385 | $0.7700
30 | IC | U5 | IC TRNSLTR BIDIRECTIONAL US8 | VSSOP-8(2x2.3x0.5) | TXB0102DCUT | Texas Instruments | - | C2677366 | - | 1 | 5 | 6 | LCSC (https://www.lcsc.com/product-detail/Translators-Level-Shifters_Texas-Instruments-TXB0102DCUT_C2677366.html) | $0.4328 | $2.5968
31 | Peripheral | - | 2 5dBi 4GAntenna Vertical 2.4GHz 10W - Antennas ROHS | - | 801-4G | DreamLNK | - | C779858 | - | 1 | 5 | 5 | LCSC (https://www.lcsc.com/product-detail/Antennas_DreamLNK-801-4G_C779858.html) | $1.8885 | $9.4425
32 | Peripheral | - | 1.8 3dBi Vertical 50W - Antennas ROHS |  | BWGSMJWX105-7KJ | BAT WIRELESS | - | C497021 | - | 1 | 5 | 5 | LCSC (https://www.lcsc.com/product-detail/Antennas_BAT-WIRELESS-BWGSMJWX105-7KJ_C497021.html) | $1.0505 | $5.2525
 |  |  |  |  |  |  |  |  |  |  |  | Total Component Cost |  |  | $432.82
 |  |  |  |  |  |  |  |  |  |  |  | Single Board Cost |  |  | $86.56

Sheet: 20 Boards
 |  | Component list |  | Bill of Materials for Project [LTE_MODULE_v2.0.]
 |  | Source Data From: |  | LTE_MODULE_v2.0
 |  | Project: |  | LTE_MODULE_v2.0
 |  | Variant: |  | None
# | Item Type | Designator | Description | Footprint | Manufacturer Part Number | Manufacturer | Alternate Part Number | LCSC Part Number | Value | Quantity | Quantity (20 Boards) | MOQ (20 Boards) | Links | Unit Cost (20 Boards) | Total Cost (20 Boards) | Remarks | Reviewer Remarks
1 | Antenna | ANT1 | RF ANT 1.575GHZ CHIP SOLDER SMD | Custom | W3011 | Pulse | - | - | - | 1 | 20 | 21 | Digikey (https://www.digikey.com/en/products/detail/pulse-electronics/W3011/3025804) | $1.4310 | $30.0510 | Not Available in LCSC
2 | Capacitor | C1 | CAP CER 2.2PF 50V C0G/NPO 0603 | Cap-0603 | CC0603CRNPO9BN2R2 | Yageo | - | C282246 | 2.2pF | 1 | 20 | 100 | LCSC (https://www.lcsc.com/product-detail/Multilayer-Ceramic-Capacitors-MLCC-SMD-SMT_YAGEO-CC0603CRNPO9BN2R2_C282246.html) | $0.0040 | $0.4000
3 | Capacitor | C2 | CAP CER 33PF 25V C0G/NP0 0402 | Cap-0402 | ~~GRM1555C1E330JA01D~~ | Murata | 0402N330J250CT | C458864 | 33pF | 1 | 20 | 100 | LCSC (https://www.lcsc.com/product-detail/Multilayer-Ceramic-Capacitors-MLCC-SMD-SMT_Walsin-Tech-Corp-0402N330J250CT_C458864.html) | $0.0016 | $0.1600
4 | Capacitor | C5, C11, C13, C15, C16, C17 | CAP CER 0.1UF 50V X5R 0603 | Cap-0603 | ~~CC0603KRX5R9BB104~~ | Yageo | CC0603KRX7R9BB104 | C14663 | 0.1uF | 6 | 120 | 200 | LCSC (https://www.lcsc.com/product-detail/Multilayer-Ceramic-Capacitors-MLCC-SMD-SMT_YAGEO-CC0603KRX7R9BB104_C14663.html) | $0.0023 | $0.4600
5 | Capacitor | C6 | CAP TANT 220UF 20% 6.3V SMD | Case-B | TLJB227M006R0500 | Kyocera AVX | - | C30242 | 220uF | 1 | 20 | 25 | LCSC (https://www.lcsc.com/product-detail/Tantalum-Capacitors_Kyocera-AVX-TLJB227M006R0500_C30242.html) | $0.2178 | $5.4450
6 | Capacitor | C7 | CAP CER 1UF 25V X5R 0603 | Cap-0603 | CC0603KRX5R8BB105 | Yageo | - | C14664 | 1uF | 1 | 20 | 100 | LCSC (https://www.lcsc.com/product-detail/Multilayer-Ceramic-Capacitors-MLCC-SMD-SMT_YAGEO-CC0603KRX5R8BB105_C14664.html) | $0.0052 | $0.5200
7 | Capacitor | C8, C9, C10 | CAP CER 22PF 50V C0G/NPO 0402 | Cap-0402 | CC0402JRNPO9BN220 | Yageo | - | C106203 | 22PF | 3 | 60 | 100 | LCSC (https://www.lcsc.com/product-detail/Multilayer-Ceramic-Capacitors-MLCC-SMD-SMT_YAGEO-CC0402JRNPO9BN220_C106203.html) | $0.0010 | $0.1000
8 | Capacitor | C12, C14 | CAP CER 0.1UF 50V X7R 0402 | cap-0402 | C1005X7R1H104KT000F | TDK | - | C361198 | 100nF | 2 | 40 | 50 | LCSC (https://www.lcsc.com/product-detail/Multilayer-Ceramic-Capacitors-MLCC-SMD-SMT_TDK-C1005X7R1H104KT000F_C361198.html) | $0.0141 | $0.7050
9 | Diode | D1 | DIODE ZENER 5.1V 500MW SOD123 | SOD-123 | ~~MMSZ5231BT1G~~ | ON Semiconductor | SZMMSZ5231BT1G | C231290 | - | 1 | 20 | 25 | LCSC (https://www.lcsc.com/product-detail/Zener-Diodes_onsemi-SZMMSZ5231BT1G_C231290.html) | $0.1037 | $2.5925
10 | Diode | D2, D3 | 35A@8/20us 15V 4.5V@Max Unidirectional DFN1006 TVS ROHS | DFN1006-2L_ | ESD5651N-2/TR | WILLSEMI(Will Semicon) | - | C239784 | - | 2 | 40 | 60 | LCSC (https://www.lcsc.com/product-detail/TVS_WILLSEMI-Will-Semicon-ESD5651N-2-TR_C239784.html) | $0.0317 | $1.9020
11 | Diode | D4 | TVS DIODE 5VWM 6.3VC DSN0603-2 | DSN0603-2 | PESD5V0H1BSFYL | Nexperia | - | C477989 | - | 1 | 20 | 30 | LCSC (https://www.lcsc.com/product-detail/ESD-Protection-Devices_Nexperia-PESD5V0H1BSF_C477989.html) | $0.0544 | $1.6320
12 | Diode | D5 | 16A 20V 7V 5V@Max Unidirectional SOT-23 TVS ROHS | Sot-23 | ESD5302F-3/TR | WILLSEMI | - | C239643 | - | 1 | 20 | 30 | LCSC (https://www.lcsc.com/product-detail/TVS_WILLSEMI-Will-Semicon-ESD5302F-3-TR_C239643.html) | $0.0864 | $2.5920
13 | Fuse | F1 | 6V 500mA 40A 1A 0603 Resettable Fuses ROHS | Fuse-0603 | SMD0603-050 | TECHFUSE | - | C69679 | - | 1 | 20 | 30 | LCSC (https://www.lcsc.com/product-detail/Resettable-Fuses_TECHFUSE-SMD0603-050_C69679.html) | $0.0451 | $1.3530
14 | SMA Connector | J1 | 1 Inner bore SMA Board Edge Bend 11mm 5.35mm Plugin RF Connectors / Coaxial Connectors ROHS | Custom | HJ-SMA175 | HJ Tech | - | C1509213 | - | 1 | 20 | 21 | LCSC (https://www.lcsc.com/product-detail/RF-Connectors-Coaxial-Connectors_HJ-Tech-HJ-SMA175_C1509213.html) | $0.6666 | $13.9986
15 | PCIE SMD PAD | ~~J2~~ | ~~PCI Express Mini Card (Mini PCIe)~~ | ~~Custom~~ | ~~-~~ | ~~-~~ | ~~-~~ | ~~-~~ | ~~-~~ | ~~1~~ | 20 | ~~-~~ | ~~-~~ | ~~-~~ | ~~-~~
16 | Pogo Connector | ~~J3~~ | ~~Pogo Pad 2.5mm 4 Pin~~ | ~~Custom~~ | ~~POGO Connector 4 Pin~~ | ~~-~~ | ~~-~~ | ~~-~~ | ~~-~~ | ~~1~~ | 20 | ~~-~~ | ~~-~~ | ~~-~~ | ~~-~~
17 | SIM Card Connectors | J4, J5 | Copper Alloy Self bomb Gold plating 1.25mm Deck -40℃~+85℃ 260℃ NanoSIM SMD SIM Card Connectors ROHS | Custom | XKNANO-113 | XKB Connectivity | - | C381071 | - | 2 | 40 | 41 | LCSC (https://www.lcsc.com/product-detail/SIM-Card-Connectors_XKB-Connectivity-XKNANO-113_C381071.html) | $0.5028 | $20.6148
18 | LED | LED1 | Yellow-Green 572nm LED Indication - Discrete 2.05V 0603 (1608 Metric) | LED-0603 | 19-21/G6C-FM1N2B/3T | Everlight Elec | - | C93689 | - | 1 | 20 | 40 | LCSC (https://www.lcsc.com/product-detail/Light-Emitting-Diodes-LED_Everlight-Elec-19-21-G6C-FM1N2B-3T_C93689.html) | $0.0348 | $1.3920
19 | LED | LED2 | Red 632nm LED Indication - Discrete 2.05V 0603 (1608 Metric) | LED-0603 | 19-21/R7C-AK1L2BY/3T | Everlight Elec | - | C1322287 | - | 1 | 20 | 30 | LCSC (https://www.lcsc.com/product-detail/Light-Emitting-Diodes-LED_Everlight-Elec-19-21-R7C-AK1L2BY-3T_C1322287.html) | $0.0515 | $1.5450
20 | Transistor | Q1, Q2, Q3, Q4 | 40V 100mW 100@10mA,1V 200mA 300MHz 300mV@50mA,5mA NPN -55℃~+150℃@(Tj) SOT-723 Bipolar Transistors - BJT ROHS | SOT-723 | MMBT3904M | TECH PUBLIC | - | C2923360 | - | 4 | 80 | 100 | LCSC (https://www.lcsc.com/product-detail/Bipolar-Transistors-BJT_TECH-PUBLIC-MMBT3904M_C2923360.html) | $0.0335 | $3.3500
21 | Resistor | R1, R2, R12 | RES SMD 10K OHM 5% 1/10W 0603 | Res-0603 | AC0603JR-0710KL | Yageo | - | C140867 | 10K | 3 | 60 | 100 | LCSC (https://www.lcsc.com/product-detail/Chip-Resistor-Surface-Mount_YAGEO-AC0603JR-0710KL_C140867.html) | $0.0015 | $0.1500
22 | Resistor | R3, R5 | RES 22 OHM 1% 1/10W 0603 | Res-0603 | RC0603FR-0722RL | Yageo | - | C107701 | 22R | 2 | 40 | 100 | LCSC (https://www.lcsc.com/product-detail/Chip-Resistor-Surface-Mount_YAGEO-RC0603FR-0722RL_C107701.html) | $0.0012 | $0.1200
23 | Resistor | R4, R19 | RES SMD 0R, 1%, 0.1W, 0603 | Res-0603 | RC0603FR-070RL | Yageo | - | C100044 | 0R | 2 | 40 | 100 | LCSC (https://www.lcsc.com/product-detail/Chip-Resistor-Surface-Mount_YAGEO-RC0603FR-070RL_C100044.html) | $0.0013 | $0.1300
24 | Resistor | R6, R9 | RES 180 OHM 1% 1/10W 0603 | Res-0603 | RC0603FR-07180RL | Yageo | - | C137786 | 180R | 2 | 40 | 100 | LCSC (https://www.lcsc.com/product-detail/Chip-Resistor-Surface-Mount_YAGEO-RC0603FR-07180RL_C137786.html) | $0.0013 | $0.1300
25 | Resistor | R7, R10, R13, R17 | RES SMD 4.7K OHM 5% 1/10W 0603 | Res-0603 | RC0603JR-074K7L | Yageo | - | C105428 | 4.7K | 4 | 80 | 100 | LCSC (https://www.lcsc.com/product-detail/Chip-Resistor-Surface-Mount_YAGEO-RC0603JR-074K7L_C105428.html) | $0.0012 | $0.1200
26 | Resistor | R8, R11, R14, R18 | RES 47K OHM 5% 1/10W 0603 | Res-0603 | RC0603JR-0747KL | Yageo | - | C127447 | 47K | 4 | 80 | 100 | LCSC (https://www.lcsc.com/product-detail/Chip-Resistor-Surface-Mount_YAGEO-RC0603JR-0747KL_C127447.html) | $0.0011 | $0.1100
27 | IC | U1 | SMD,30x30mm 2G/3G/4G/5G Modules ROHS | Custom | SIM7500E | SIMCom | - | C126259 | - | 1 | 20 | 21 | Chipsmall (https://www.chipsmall.com/Products/SIM7500E_SIMCom-Wireless-Solutions_20290450.html) | $47.2403 | $992.0453
28 | IC | U2 | IC SWITCH 4PDT 16MLP | 16-MLP (3x3) | FSA2567MPX | ON Semiconductor / Fairchild | - | C512961 | - | 1 | 20 | 21 | LCSC (https://www.lcsc.com/product-detail/Analog-Switches-Multiplexers_onsemi-FSA2567MPX_C512961.html) | $0.5330 | $11.1930
29 | ESD Diode | U3,U4 | 15V 5 Unidirectional 5V SOT-363 ESD Protection Devices ROHS | SOT-363 | SMF05CT1G-ES | ElecSuper | - | C5180312 | - | 2 | 40 | 60 | LCSC (https://www.lcsc.com/product-detail/ESD-Protection-Devices_ElecSuper-SMF05CT1G-ES_C5180312.html) | $0.0538 | $3.2280
30 | IC | U5 | IC TRNSLTR BIDIRECTIONAL US8 | VSSOP-8(2x2.3x0.5) | TXB0102DCUT | Texas Instruments | - | C2677366 | - | 1 | 20 | 21 | LCSC (https://www.lcsc.com/product-detail/Translators-Level-Shifters_Texas-Instruments-TXB0102DCUT_C2677366.html) | $0.4328 | $9.0888
31 | Peripheral | - | 2 5dBi 4GAntenna Vertical 2.4GHz 10W - Antennas ROHS | - | 801-4G | DreamLNK | - | C779858 | - | 1 | 20 | 20 | LCSC (https://www.lcsc.com/product-detail/Antennas_DreamLNK-801-4G_C779858.html) | $1.6785 | $33.5700
32 | Peripheral | - | 1.8 3dBi Vertical 50W - Antennas ROHS |  | BWGSMJWX105-7KJ | BAT WIRELESS | - | C497021 | - | 1 | 20 | 5 | LCSC (https://www.lcsc.com/product-detail/Antennas_BAT-WIRELESS-BWGSMJWX105-7KJ_C497021.html) | $0.8918 | $4.4590
 |  |  |  |  |  |  |  |  |  |  |  | Total Component Cost |  |  | $1143.16
 |  |  |  |  |  |  |  |  |  |  |  | Single Board Cost |  |  | $57.16

Sheet: 50 Boards
 |  | Component list |  | Bill of Materials for Project [LTE_MODULE_v2.0.]
 |  | Source Data From: |  | LTE_MODULE_v2.0
 |  | Project: |  | LTE_MODULE_v2.0
 |  | Variant: |  | None
# | Item Type | Designator | Description | Footprint | Manufacturer Part Number | Manufacturer | Alternate Part Number | LCSC Part Number | Value | Quantity | Quantity (50 Boards) | MOQ (50 Boards) | Links | Unit Cost (50 Boards) | Total Cost (50 Boards) | Remarks | Reviewer Remarks
1 | Antenna | ANT1 | RF ANT 1.575GHZ CHIP SOLDER SMD | Custom | W3011 | Pulse | - | - | - | 1 | 50 | 51 | Digikey (https://www.digikey.com/en/products/detail/pulse-electronics/W3011/3025804) | $1.3500 | $68.8500 | Not Available in LCSC
2 | Capacitor | C1 | CAP CER 2.2PF 50V C0G/NPO 0603 | Cap-0603 | CC0603CRNPO9BN2R2 | Yageo | - | C282246 | 2.2pF | 1 | 50 | 100 | LCSC (https://www.lcsc.com/product-detail/Multilayer-Ceramic-Capacitors-MLCC-SMD-SMT_YAGEO-CC0603CRNPO9BN2R2_C282246.html) | $0.0040 | $0.4000
3 | Capacitor | C2 | CAP CER 33PF 25V C0G/NP0 0402 | Cap-0402 | ~~GRM1555C1E330JA01D~~ | Murata | 0402N330J250CT | C458864 | 33pF | 1 | 50 | 100 | LCSC (https://www.lcsc.com/product-detail/Multilayer-Ceramic-Capacitors-MLCC-SMD-SMT_Walsin-Tech-Corp-0402N330J250CT_C458864.html) | $0.0016 | $0.1600
4 | Capacitor | C5, C11, C13, C15, C16, C17 | CAP CER 0.1UF 50V X5R 0603 | Cap-0603 | ~~CC0603KRX5R9BB104~~ | Yageo | CC0603KRX7R9BB104 | C14663 | 0.1uF | 6 | 300 | 400 | LCSC (https://www.lcsc.com/product-detail/Multilayer-Ceramic-Capacitors-MLCC-SMD-SMT_YAGEO-CC0603KRX7R9BB104_C14663.html) | $0.0024 | $0.9600
5 | Capacitor | C6 | CAP TANT 220UF 20% 6.3V SMD | Case-B | TLJB227M006R0500 | Kyocera AVX | - | C30242 | 220uF | 1 | 50 | 55 | LCSC (https://www.lcsc.com/product-detail/Tantalum-Capacitors_Kyocera-AVX-TLJB227M006R0500_C30242.html) | $0.1684 | $9.2620
6 | Capacitor | C7 | CAP CER 1UF 25V X5R 0603 | Cap-0603 | CC0603KRX5R8BB105 | Yageo | - | C14664 | 1uF | 1 | 50 | 100 | LCSC (https://www.lcsc.com/product-detail/Multilayer-Ceramic-Capacitors-MLCC-SMD-SMT_YAGEO-CC0603KRX5R8BB105_C14664.html) | $0.0052 | $0.5200
7 | Capacitor | C8, C9, C10 | CAP CER 22PF 50V C0G/NPO 0402 | Cap-0402 | CC0402JRNPO9BN220 | Yageo | - | C106203 | 22PF | 3 | 150 | 200 | LCSC (https://www.lcsc.com/product-detail/Multilayer-Ceramic-Capacitors-MLCC-SMD-SMT_YAGEO-CC0402JRNPO9BN220_C106203.html) | $0.0010 | $0.2000
8 | Capacitor | C12, C14 | CAP CER 0.1UF 50V X7R 0402 | cap-0402 | C1005X7R1H104KT000F | TDK | - | C361198 | 100nF | 2 | 100 | 150 | LCSC (https://www.lcsc.com/product-detail/Multilayer-Ceramic-Capacitors-MLCC-SMD-SMT_TDK-C1005X7R1H104KT000F_C361198.html) | $0.0141 | $2.1150
9 | Diode | D1 | DIODE ZENER 5.1V 500MW SOD123 | SOD-123 | ~~MMSZ5231BT1G~~ | ON Semiconductor | SZMMSZ5231BT1G | C231290 | - | 1 | 50 | 55 | LCSC (https://www.lcsc.com/product-detail/Zener-Diodes_onsemi-SZMMSZ5231BT1G_C231290.html) | $0.0848 | $4.6640
10 | Diode | D2, D3 | 35A@8/20us 15V 4.5V@Max Unidirectional DFN1006 TVS ROHS | DFN1006-2L_ | ESD5651N-2/TR | WILLSEMI(Will Semicon) | - | C239784 | - | 2 | 100 | 20 | LCSC (https://www.lcsc.com/product-detail/TVS_WILLSEMI-Will-Semicon-ESD5651N-2-TR_C239784.html) | $0.0317 | $0.6340
11 | Diode | D4 | TVS DIODE 5VWM 6.3VC DSN0603-2 | DSN0603-2 | PESD5V0H1BSFYL | Nexperia | - | C477989 | - | 1 | 50 | 10 | LCSC (https://www.lcsc.com/product-detail/ESD-Protection-Devices_Nexperia-PESD5V0H1BSF_C477989.html) | $0.0556 | $0.5560
12 | Diode | D5 | 16A 20V 7V 5V@Max Unidirectional SOT-23 TVS ROHS | Sot-23 | ESD5302F-3/TR | WILLSEMI | - | C239643 | - | 1 | 50 | 10 | LCSC (https://www.lcsc.com/product-detail/TVS_WILLSEMI-Will-Semicon-ESD5302F-3-TR_C239643.html) | $0.0864 | $0.8640
13 | Fuse | F1 | 6V 500mA 40A 1A 0603 Resettable Fuses ROHS | Fuse-0603 | SMD0603-050 | TECHFUSE | - | C69679 | - | 1 | 50 | 10 | LCSC (https://www.lcsc.com/product-detail/Resettable-Fuses_TECHFUSE-SMD0603-050_C69679.html) | $0.0432 | $0.4320
14 | SMA Connector | J1 | 1 Inner bore SMA Board Edge Bend 11mm 5.35mm Plugin RF Connectors / Coaxial Connectors ROHS | Custom | HJ-SMA175 | HJ Tech | - | C1509213 |  | 1 | 50 | 51 | LCSC (https://www.lcsc.com/product-detail/RF-Connectors-Coaxial-Connectors_HJ-Tech-HJ-SMA175_C1509213.html) | $0.5919 | $30.1869
15 | PCIE SMD PAD | ~~J2~~ | ~~PCI Express Mini Card (Mini PCIe)~~ | ~~Custom~~ | ~~-~~ | ~~-~~ | ~~-~~ | ~~-~~ | ~~-~~ | ~~1~~ | 50 | ~~-~~ | ~~-~~ | ~~-~~ | ~~-~~
16 | Pogo Connector | ~~J3~~ | ~~Pogo Pad 2.5mm 4 Pin~~ | ~~Custom~~ | ~~POGO Connector 4 Pin~~ | ~~-~~ | ~~-~~ | ~~-~~ | ~~-~~ | ~~1~~ | 50 | ~~-~~ | ~~-~~ | ~~-~~ | ~~-~~
17 | SIM Card Connectors | J4, J5 | Copper Alloy Self bomb Gold plating 1.25mm Deck -40℃~+85℃ 260℃ NanoSIM SMD SIM Card Connectors ROHS | Custom | XKNANO-113 | XKB Connectivity | - | C381071 | - | 2 | 100 | 101 | LCSC (https://www.lcsc.com/product-detail/SIM-Card-Connectors_XKB-Connectivity-XKNANO-113_C381071.html) | $0.2236 | $22.5836
18 | LED | LED1 | Yellow-Green 572nm LED Indication - Discrete 2.05V 0603 (1608 Metric) | LED-0603 | 19-21/G6C-FM1N2B/3T | Everlight Elec | - | C93689 | - | 1 | 50 | 60 | LCSC (https://www.lcsc.com/product-detail/Light-Emitting-Diodes-LED_Everlight-Elec-19-21-G6C-FM1N2B-3T_C93689.html) | $0.0348 | $2.0880
19 | LED | LED2 | Red 632nm LED Indication - Discrete 2.05V 0603 (1608 Metric) | LED-0603 | 19-21/R7C-AK1L2BY/3T | Everlight Elec | - | C1322287 | - | 1 | 50 | 60 | LCSC (https://www.lcsc.com/product-detail/Light-Emitting-Diodes-LED_Everlight-Elec-19-21-R7C-AK1L2BY-3T_C1322287.html) | $0.0515 | $3.0900
20 | Transistor | Q1, Q2, Q3, Q4 | 40V 100mW 100@10mA,1V 200mA 300MHz 300mV@50mA,5mA NPN -55℃~+150℃@(Tj) SOT-723 Bipolar Transistors - BJT ROHS | SOT-723 | MMBT3904M | TECH PUBLIC | - | C2923360 | - | 4 | 200 | 220 | LCSC (https://www.lcsc.com/product-detail/Bipolar-Transistors-BJT_TECH-PUBLIC-MMBT3904M_C2923360.html) | $0.0271 | $5.9620
21 | Resistor | R1, R2, R12 | RES SMD 10K OHM 5% 1/10W 0603 | Res-0603 | AC0603JR-0710KL | Yageo | - | C140867 | 10K | 3 | 150 | 200 | LCSC (https://www.lcsc.com/product-detail/Chip-Resistor-Surface-Mount_YAGEO-AC0603JR-0710KL_C140867.html) | $0.0015 | $0.3000
22 | Resistor | R3, R5 | RES 22 OHM 1% 1/10W 0603 | Res-0603 | RC0603FR-0722RL | Yageo | - | C107701 | 22R | 2 | 100 | 200 | LCSC (https://www.lcsc.com/product-detail/Chip-Resistor-Surface-Mount_YAGEO-RC0603FR-0722RL_C107701.html) | $0.0012 | $0.2400
23 | Resistor | R4, R19 | RES SMD 0R, 1%, 0.1W, 0603 | Res-0603 | RC0603FR-070RL | Yageo | - | C100044 | 0R | 2 | 100 | 200 | LCSC (https://www.lcsc.com/product-detail/Chip-Resistor-Surface-Mount_YAGEO-RC0603FR-070RL_C100044.html) | $0.0013 | $0.2600
24 | Resistor | R6, R9 | RES 180 OHM 1% 1/10W 0603 | Res-0603 | RC0603FR-07180RL | Yageo | - | C137786 | 180R | 2 | 100 | 200 | LCSC (https://www.lcsc.com/product-detail/Chip-Resistor-Surface-Mount_YAGEO-RC0603FR-07180RL_C137786.html) | $0.0013 | $0.2600
25 | Resistor | R7, R10, R13, R17 | RES SMD 4.7K OHM 5% 1/10W 0603 | Res-0603 | RC0603JR-074K7L | Yageo | - | C105428 | 4.7K | 4 | 200 | 300 | LCSC (https://www.lcsc.com/product-detail/Chip-Resistor-Surface-Mount_YAGEO-RC0603JR-074K7L_C105428.html) | $0.0012 | $0.3600
26 | Resistor | R8, R11, R14, R18 | RES 47K OHM 5% 1/10W 0603 | Res-0603 | RC0603JR-0747KL | Yageo | - | C127447 | 47K | 4 | 200 | 300 | LCSC (https://www.lcsc.com/product-detail/Chip-Resistor-Surface-Mount_YAGEO-RC0603JR-0747KL_C127447.html) | $0.0011 | $0.3300
27 | IC | U1 | SMD,30x30mm 2G/3G/4G/5G Modules ROHS | Custom | SIM7500E | SIMCom | - | C126259 | - | 1 | 50 | 51 | Chipsmall (https://www.chipsmall.com/Products/SIM7500E_SIMCom-Wireless-Solutions_20290450.html) | $40.9415 | $2088.0190
28 | IC | U2 | IC SWITCH 4PDT 16MLP | 16-MLP (3x3) | FSA2567MPX | ON Semiconductor / Fairchild | - | C512961 | - | 1 | 50 | 51 | LCSC (https://www.lcsc.com/product-detail/Analog-Switches-Multiplexers_onsemi-FSA2567MPX_C512961.html) | $0.4741 | $24.1791
29 | ESD Diode | U3,U4 | 15V 5 Unidirectional 5V SOT-363 ESD Protection Devices ROHS | SOT-363 | SMF05CT1G-ES | ElecSuper | - | C5180312 | - | 2 | 100 | 120 | LCSC (https://www.lcsc.com/product-detail/ESD-Protection-Devices_ElecSuper-SMF05CT1G-ES_C5180312.html) | $0.0538 | $6.4560
30 | IC | U5 | IC TRNSLTR BIDIRECTIONAL US8 | VSSOP-8(2x2.3x0.5) | TXB0102DCUT | Texas Instruments | - | C2677366 | - | 1 | 50 | 51 | LCSC (https://www.lcsc.com/product-detail/Translators-Level-Shifters_Texas-Instruments-TXB0102DCUT_C2677366.html) | $0.3866 | $19.7166
31 | Peripheral | - | 2 5dBi 4GAntenna Vertical 2.4GHz 10W - Antennas ROHS | - | 801-4G | DreamLNK | - | C779858 | - | 1 | 50 | 50 | LCSC (https://www.lcsc.com/product-detail/Antennas_DreamLNK-801-4G_C779858.html) | $1.6466 | $82.3300
32 | Peripheral | - | 1.8 3dBi Vertical 50W - Antennas ROHS |  | BWGSMJWX105-7KJ | BAT WIRELESS | - | C497021 | - | 1 | 50 | 50 | LCSC (https://www.lcsc.com/product-detail/Antennas_BAT-WIRELESS-BWGSMJWX105-7KJ_C497021.html) | $0.8056 | $40.2800
 |  |  |  |  |  |  |  |  |  |  |  | Total Component Cost |  |  | $2416.26
 |  |  |  |  |  |  |  |  |  |  |  | Single Board Cost |  |  | $48.33

Sheet: 100 Boards
 |  | Component list |  | Bill of Materials for Project [LTE_MODULE_v2.0.]
 |  | Source Data From: |  | LTE_MODULE_v2.0
 |  | Project: |  | LTE_MODULE_v2.0
 |  | Variant: |  | None
# | Item Type | Designator | Description | Footprint | Manufacturer Part Number | Manufacturer | Alternate Part Number | LCSC Part Number | Value | Quantity | Quantity (100 Boards) | MOQ (100 Boards) | Links | Unit Cost (100 Boards) | Total Cost (100 Boards) | Remarks | Reviewer Remarks
1 | Antenna | ANT1 | RF ANT 1.575GHZ CHIP SOLDER SMD | Custom | W3011 | Pulse | - | - | - | 1 | 100 | 101 | Digikey (https://www.digikey.com/en/products/detail/pulse-electronics/W3011/3025804) | $1.1502 | $116.1702 | Not Available in LCSC
2 | Capacitor | C1 | CAP CER 2.2PF 50V C0G/NPO 0603 | Cap-0603 | CC0603CRNPO9BN2R2 | Yageo | - | C282246 | 2.2pF | 1 | 100 | 200 | LCSC (https://www.lcsc.com/product-detail/Multilayer-Ceramic-Capacitors-MLCC-SMD-SMT_YAGEO-CC0603CRNPO9BN2R2_C282246.html) | $0.0040 | $0.8000
3 | Capacitor | C2 | CAP CER 33PF 25V C0G/NP0 0402 | Cap-0402 | ~~GRM1555C1E330JA01D~~ | Murata | 0402N330J250CT | C458864 | 33pF | 1 | 100 | 200 | LCSC (https://www.lcsc.com/product-detail/Multilayer-Ceramic-Capacitors-MLCC-SMD-SMT_Walsin-Tech-Corp-0402N330J250CT_C458864.html) | $0.0016 | $0.3200
4 | Capacitor | C5, C11, C13, C15, C16, C17 | CAP CER 0.1UF 50V X5R 0603 | Cap-0603 | ~~CC0603KRX5R9BB104~~ | Yageo | CC0603KRX7R9BB104 | C14663 | 0.1uF | 6 | 600 | 700 | LCSC (https://www.lcsc.com/product-detail/Multilayer-Ceramic-Capacitors-MLCC-SMD-SMT_YAGEO-CC0603KRX7R9BB104_C14663.html) | $0.0024 | $1.6800
5 | Capacitor | C6 | CAP TANT 220UF 20% 6.3V SMD | Case-B | TLJB227M006R0500 | Kyocera AVX | - | C30242 | 220uF | 1 | 100 | 105 | LCSC (https://www.lcsc.com/product-detail/Tantalum-Capacitors_Kyocera-AVX-TLJB227M006R0500_C30242.html) | $0.1684 | $17.6820
6 | Capacitor | C7 | CAP CER 1UF 25V X5R 0603 | Cap-0603 | CC0603KRX5R8BB105 | Yageo | - | C14664 | 1uF | 1 | 100 | 200 | LCSC (https://www.lcsc.com/product-detail/Multilayer-Ceramic-Capacitors-MLCC-SMD-SMT_YAGEO-CC0603KRX5R8BB105_C14664.html) | $0.0052 | $1.0400
7 | Capacitor | C8, C9, C10 | CAP CER 22PF 50V C0G/NPO 0402 | Cap-0402 | CC0402JRNPO9BN220 | Yageo | - | C106203 | 22PF | 3 | 300 | 400 | LCSC (https://www.lcsc.com/product-detail/Multilayer-Ceramic-Capacitors-MLCC-SMD-SMT_YAGEO-CC0402JRNPO9BN220_C106203.html) | $0.0010 | $0.4000
8 | Capacitor | C12, C14 | CAP CER 0.1UF 50V X7R 0402 | cap-0402 | C1005X7R1H104KT000F | TDK | - | C361198 | 100nF | 2 | 200 | 250 | LCSC (https://www.lcsc.com/product-detail/Multilayer-Ceramic-Capacitors-MLCC-SMD-SMT_TDK-C1005X7R1H104KT000F_C361198.html) | $0.0141 | $3.5250
9 | Diode | D1 | DIODE ZENER 5.1V 500MW SOD123 | SOD-123 | ~~MMSZ5231BT1G~~ | ON Semiconductor | SZMMSZ5231BT1G | C231290 | - | 1 | 100 | 105 | LCSC (https://www.lcsc.com/product-detail/Zener-Diodes_onsemi-SZMMSZ5231BT1G_C231290.html) | $0.0848 | $8.9040
10 | Diode | D2, D3 | 35A@8/20us 15V 4.5V@Max Unidirectional DFN1006 TVS ROHS | DFN1006-2L_ | ESD5651N-2/TR | WILLSEMI(Will Semicon) | - | C239784 | - | 2 | 200 | 220 | LCSC (https://www.lcsc.com/product-detail/TVS_WILLSEMI-Will-Semicon-ESD5651N-2-TR_C239784.html) | $0.0257 | $5.6540
11 | Diode | D4 | TVS DIODE 5VWM 6.3VC DSN0603-2 | DSN0603-2 | PESD5V0H1BSFYL | Nexperia | - | C477989 | - | 1 | 100 | 110 | LCSC (https://www.lcsc.com/product-detail/ESD-Protection-Devices_Nexperia-PESD5V0H1BSF_C477989.html) | $0.0439 | $4.8290
12 | Diode | D5 | 16A 20V 7V 5V@Max Unidirectional SOT-23 TVS ROHS | Sot-23 | ESD5302F-3/TR | WILLSEMI | - | C239643 | - | 1 | 100 | 110 | LCSC (https://www.lcsc.com/product-detail/TVS_WILLSEMI-Will-Semicon-ESD5302F-3-TR_C239643.html) | $0.0710 | $7.8100
13 | Fuse | F1 | 6V 500mA 40A 1A 0603 Resettable Fuses ROHS | Fuse-0603 | SMD0603-050 | TECHFUSE | - | C69679 | - | 1 | 100 | 110 | LCSC (https://www.lcsc.com/product-detail/Resettable-Fuses_TECHFUSE-SMD0603-050_C69679.html) | $0.0377 | $4.1470
14 | SMA Connector | J1 | 1 Inner bore SMA Board Edge Bend 11mm 5.35mm Plugin RF Connectors / Coaxial Connectors ROHS | Custom | HJ-SMA175 | HJ Tech | - | C1509213 | - | 1 | 100 | 101 | LCSC (https://www.lcsc.com/product-detail/RF-Connectors-Coaxial-Connectors_HJ-Tech-HJ-SMA175_C1509213.html) | $0.5187 | $52.3887
15 | PCIE SMD PAD | ~~J2~~ | ~~PCI Express Mini Card (Mini PCIe)~~ | ~~Custom~~ | ~~-~~ | ~~-~~ | ~~-~~ | ~~-~~ | ~~-~~ | ~~1~~ | 100 | ~~-~~ | ~~-~~ | ~~-~~ | ~~-~~
16 | Pogo Connector | ~~J3~~ | ~~Pogo Pad 2.5mm 4 Pin~~ | ~~Custom~~ | ~~POGO Connector 4 Pin~~ | ~~-~~ | ~~-~~ | ~~-~~ | ~~-~~ | ~~1~~ | 100 | ~~-~~ | ~~-~~ | ~~-~~ | ~~-~~
17 | SIM Card Connectors | J4, J5 | Copper Alloy Self bomb Gold plating 1.25mm Deck -40℃~+85℃ 260℃ NanoSIM SMD SIM Card Connectors ROHS | Custom | XKNANO-113 | XKB Connectivity | - | C381071 | - | 2 | 200 | 201 | LCSC (https://www.lcsc.com/product-detail/SIM-Card-Connectors_XKB-Connectivity-XKNANO-113_C381071.html) | $0.2236 | $44.9436
18 | LED | LED1 | Yellow-Green 572nm LED Indication - Discrete 2.05V 0603 (1608 Metric) | LED-0603 | 19-21/G6C-FM1N2B/3T | Everlight Elec | - | C93689 | - | 1 | 100 | 120 | LCSC (https://www.lcsc.com/product-detail/Light-Emitting-Diodes-LED_Everlight-Elec-19-21-G6C-FM1N2B-3T_C93689.html) | $0.0313 | $3.7560
19 | LED | LED2 | Red 632nm LED Indication - Discrete 2.05V 0603 (1608 Metric) | LED-0603 | 19-21/R7C-AK1L2BY/3T | Everlight Elec | - | C1322287 | - | 1 | 100 | 110 | LCSC (https://www.lcsc.com/product-detail/Light-Emitting-Diodes-LED_Everlight-Elec-19-21-R7C-AK1L2BY-3T_C1322287.html) | $0.0426 | $4.6860
20 | Transistor | Q1, Q2, Q3, Q4 | 40V 100mW 100@10mA,1V 200mA 300MHz 300mV@50mA,5mA NPN -55℃~+150℃@(Tj) SOT-723 Bipolar Transistors - BJT ROHS | SOT-723 | MMBT3904M | TECH PUBLIC | - | C2923360 | - | 4 | 400 | 420 | LCSC (https://www.lcsc.com/product-detail/Bipolar-Transistors-BJT_TECH-PUBLIC-MMBT3904M_C2923360.html) | $0.0271 | $11.3820
21 | Resistor | R1, R2, R12 | RES SMD 10K OHM 5% 1/10W 0603 | Res-0603 | AC0603JR-0710KL | Yageo | - | C140867 | 10K | 3 | 300 | 400 | LCSC (https://www.lcsc.com/product-detail/Chip-Resistor-Surface-Mount_YAGEO-AC0603JR-0710KL_C140867.html) | $0.0015 | $0.6000
22 | Resistor | R3, R5 | RES 22 OHM 1% 1/10W 0603 | Res-0603 | RC0603FR-0722RL | Yageo | - | C107701 | 22R | 2 | 200 | 300 | LCSC (https://www.lcsc.com/product-detail/Chip-Resistor-Surface-Mount_YAGEO-RC0603FR-0722RL_C107701.html) | $0.0012 | $0.3600
23 | Resistor | R4, R19 | RES SMD 0R, 1%, 0.1W, 0603 | Res-0603 | RC0603FR-070RL | Yageo | - | C100044 | 0R | 2 | 200 | 300 | LCSC (https://www.lcsc.com/product-detail/Chip-Resistor-Surface-Mount_YAGEO-RC0603FR-070RL_C100044.html) | $0.0013 | $0.3900
24 | Resistor | R6, R9 | RES 180 OHM 1% 1/10W 0603 | Res-0603 | RC0603FR-07180RL | Yageo | - | C137786 | 180R | 2 | 200 | 300 | LCSC (https://www.lcsc.com/product-detail/Chip-Resistor-Surface-Mount_YAGEO-RC0603FR-07180RL_C137786.html) | $0.0013 | $0.3900
25 | Resistor | R7, R10, R13, R17 | RES SMD 4.7K OHM 5% 1/10W 0603 | Res-0603 | RC0603JR-074K7L | Yageo | - | C105428 | 4.7K | 4 | 400 | 500 | LCSC (https://www.lcsc.com/product-detail/Chip-Resistor-Surface-Mount_YAGEO-RC0603JR-074K7L_C105428.html) | $0.0012 | $0.6000
26 | Resistor | R8, R11, R14, R18 | RES 47K OHM 5% 1/10W 0603 | Res-0603 | RC0603JR-0747KL | Yageo | - | C127447 | 47K | 4 | 400 | 500 | LCSC (https://www.lcsc.com/product-detail/Chip-Resistor-Surface-Mount_YAGEO-RC0603JR-0747KL_C127447.html) | $0.0011 | $0.5500
27 | IC | U1 | SMD,30x30mm 2G/3G/4G/5G Modules ROHS | Custom | SIM7500E | SIMCom | - | C126259 | - | 1 | 100 | 101 | Chipsmall (https://www.chipsmall.com/Products/SIM7500E_SIMCom-Wireless-Solutions_20290450.html) | $36.2175 | $3657.9695
28 | IC | U2 | IC SWITCH 4PDT 16MLP | 16-MLP (3x3) | FSA2567MPX | ON Semiconductor / Fairchild | - | C512961 | - | 1 | 100 | 101 | LCSC (https://www.lcsc.com/product-detail/Analog-Switches-Multiplexers_onsemi-FSA2567MPX_C512961.html) | $0.4128 | $41.6928
29 | ESD Diode | U3,U4 | 15V 5 Unidirectional 5V SOT-363 ESD Protection Devices ROHS | SOT-363 | SMF05CT1G-ES | ElecSuper | - | C5180312 | - | 2 | 200 | 220 | LCSC (https://www.lcsc.com/product-detail/ESD-Protection-Devices_ElecSuper-SMF05CT1G-ES_C5180312.html) | $0.0427 | $9.3940
30 | IC | U5 | IC TRNSLTR BIDIRECTIONAL US8 | VSSOP-8(2x2.3x0.5) | TXB0102DCUT | Texas Instruments | - | C2677366 | - | 1 | 100 | 101 | LCSC (https://www.lcsc.com/product-detail/Translators-Level-Shifters_Texas-Instruments-TXB0102DCUT_C2677366.html) | $0.3866 | $39.0466
31 | Peripheral | - | 2 5dBi 4GAntenna Vertical 2.4GHz 10W - Antennas ROHS | - | 801-4G | DreamLNK | - | C779858 | - | 1 | 100 | 100 | LCSC (https://www.lcsc.com/product-detail/Antennas_DreamLNK-801-4G_C779858.html) | $1.4732 | $147.3200
32 | Peripheral | - | 1.8 3dBi Vertical 50W - Antennas ROHS |  | BWGSMJWX105-7KJ | BAT WIRELESS | - | C497021 | - | 1 | 100 | 100 | LCSC (https://www.lcsc.com/product-detail/Antennas_BAT-WIRELESS-BWGSMJWX105-7KJ_C497021.html) | $0.6379 | $63.7900
 |  |  |  |  |  |  |  |  |  |  |  | Total Component Cost |  |  | $4252.22
 |  |  |  |  |  |  |  |  |  |  |  | Single Board Cost |  |  | $42.52

Sheet: 500 Boards
 |  | Component list |  | Bill of Materials for Project [LTE_MODULE_v2.0.]
 |  | Source Data From: |  | LTE_MODULE_v2.0
 |  | Project: |  | LTE_MODULE_v2.0
 |  | Variant: |  | None
# | Item Type | Designator | Description | Footprint | Manufacturer Part Number | Manufacturer | Alternate Part Number | LCSC Part Number | Value | Quantity | Quantity (500 Boards) | MOQ (500 Boards) | Links | Unit Cost (500 Boards) | Total Cost (500 Boards) | Remarks | Reviewer Remarks
1 | Antenna | ANT1 | RF ANT 1.575GHZ CHIP SOLDER SMD | Custom | W3011 | Pulse | - | - | - | 1 | 500 | 501 | Digikey (https://www.digikey.com/en/products/detail/pulse-electronics/W3011/3025804) | $0.9450 | $473.4450 | Not Available in LCSC
2 | Capacitor | C1 | CAP CER 2.2PF 50V C0G/NPO 0603 | Cap-0603 | CC0603CRNPO9BN2R2 | Yageo | - | C282246 | 2.2pF | 1 | 500 | 600 | LCSC (https://www.lcsc.com/product-detail/Multilayer-Ceramic-Capacitors-MLCC-SMD-SMT_YAGEO-CC0603CRNPO9BN2R2_C282246.html) | $0.0040 | $2.4000
3 | Capacitor | C2 | CAP CER 33PF 25V C0G/NP0 0402 | Cap-0402 | ~~GRM1555C1E330JA01D~~ | Murata | 0402N330J250CT | C458864 | 33pF | 1 | 500 | 600 | LCSC (https://www.lcsc.com/product-detail/Multilayer-Ceramic-Capacitors-MLCC-SMD-SMT_Walsin-Tech-Corp-0402N330J250CT_C458864.html) | $0.0016 | $0.9600
4 | Capacitor | C5, C11, C13, C15, C16, C17 | CAP CER 0.1UF 50V X5R 0603 | Cap-0603 | ~~CC0603KRX5R9BB104~~ | Yageo | CC0603KRX7R9BB104 | C14663 | 0.1uF | 6 | 3000 | 3100 | LCSC (https://www.lcsc.com/product-detail/Multilayer-Ceramic-Capacitors-MLCC-SMD-SMT_YAGEO-CC0603KRX7R9BB104_C14663.html) | $0.0018 | $5.5800
5 | Capacitor | C6 | CAP TANT 220UF 20% 6.3V SMD | Case-B | TLJB227M006R0500 | Kyocera AVX | - | C30242 | 220uF | 1 | 500 | 505 | LCSC (https://www.lcsc.com/product-detail/Tantalum-Capacitors_Kyocera-AVX-TLJB227M006R0500_C30242.html) | $0.1271 | $64.1855
6 | Capacitor | C7 | CAP CER 1UF 25V X5R 0603 | Cap-0603 | CC0603KRX5R8BB105 | Yageo | - | C14664 | 1uF | 1 | 500 | 600 | LCSC (https://www.lcsc.com/product-detail/Multilayer-Ceramic-Capacitors-MLCC-SMD-SMT_YAGEO-CC0603KRX5R8BB105_C14664.html) | $0.0052 | $3.1200
7 | Capacitor | C8, C9, C10 | CAP CER 22PF 50V C0G/NPO 0402 | Cap-0402 | CC0402JRNPO9BN220 | Yageo | - | C106203 | 22PF | 3 | 1500 | 1600 | LCSC (https://www.lcsc.com/product-detail/Multilayer-Ceramic-Capacitors-MLCC-SMD-SMT_YAGEO-CC0402JRNPO9BN220_C106203.html) | $0.0008 | $1.2800
8 | Capacitor | C12, C14 | CAP CER 0.1UF 50V X7R 0402 | cap-0402 | C1005X7R1H104KT000F | TDK | - | C361198 | 100nF | 2 | 1000 | 1050 | LCSC (https://www.lcsc.com/product-detail/Multilayer-Ceramic-Capacitors-MLCC-SMD-SMT_TDK-C1005X7R1H104KT000F_C361198.html) | $0.0112 | $11.7600
9 | Diode | D1 | DIODE ZENER 5.1V 500MW SOD123 | SOD-123 | ~~MMSZ5231BT1G~~ | ON Semiconductor | SZMMSZ5231BT1G | C231290 | - | 1 | 500 | 510 | LCSC (https://www.lcsc.com/product-detail/Zener-Diodes_onsemi-SZMMSZ5231BT1G_C231290.html) | $0.0652 | $33.2520
10 | Diode | D2, D3 | 35A@8/20us 15V 4.5V@Max Unidirectional DFN1006 TVS ROHS | DFN1006-2L_ | ESD5651N-2/TR | WILLSEMI(Will Semicon) | - | C239784 | - | 2 | 1000 | 1020 | LCSC (https://www.lcsc.com/product-detail/TVS_WILLSEMI-Will-Semicon-ESD5651N-2-TR_C239784.html) | $0.0213 | $21.7260
11 | Diode | D4 | TVS DIODE 5VWM 6.3VC DSN0603-2 | DSN0603-2 | PESD5V0H1BSFYL | Nexperia | - | C477989 | - | 1 | 500 | 510 | LCSC (https://www.lcsc.com/product-detail/ESD-Protection-Devices_Nexperia-PESD5V0H1BSF_C477989.html) | $0.0387 | $19.7370
12 | Diode | D5 | 16A 20V 7V 5V@Max Unidirectional SOT-23 TVS ROHS | Sot-23 | ESD5302F-3/TR | WILLSEMI | - | C239643 | - | 1 | 500 | 510 | LCSC (https://www.lcsc.com/product-detail/TVS_WILLSEMI-Will-Semicon-ESD5302F-3-TR_C239643.html) | $0.0598 | $30.4980
13 | Fuse | F1 | 6V 500mA 40A 1A 0603 Resettable Fuses ROHS | Fuse-0603 | SMD0603-050 | TECHFUSE | - | C69679 | - | 1 | 500 | 510 | LCSC (https://www.lcsc.com/product-detail/Resettable-Fuses_TECHFUSE-SMD0603-050_C69679.html) | $0.0339 | $17.2890
14 | SMA Connector | J1 | 1 Inner bore SMA Board Edge Bend 11mm 5.35mm Plugin RF Connectors / Coaxial Connectors ROHS | Custom | HJ-SMA175 | HJ Tech | - | C1509213 | - | 1 | 500 | 501 | LCSC (https://www.lcsc.com/product-detail/RF-Connectors-Coaxial-Connectors_HJ-Tech-HJ-SMA175_C1509213.html) | $0.4741 | $237.5241
15 | PCIE SMD PAD | ~~J2~~ | ~~PCI Express Mini Card (Mini PCIe)~~ | ~~Custom~~ | ~~-~~ | ~~-~~ | ~~-~~ | ~~-~~ | ~~-~~ | ~~1~~ | 500 | ~~-~~ | ~~-~~ | ~~-~~ | ~~-~~
16 | Pogo Connector | ~~J3~~ | ~~Pogo Pad 2.5mm 4 Pin~~ | ~~Custom~~ | ~~POGO Connector 4 Pin~~ | ~~-~~ | ~~-~~ | ~~-~~ | ~~-~~ | ~~1~~ | 500 | ~~-~~ | ~~-~~ | ~~-~~ | ~~-~~
17 | SIM Card Connectors | J4, J5 | Copper Alloy Self bomb Gold plating 1.25mm Deck -40℃~+85℃ 260℃ NanoSIM SMD SIM Card Connectors ROHS | Custom | XKNANO-113 | XKB Connectivity | - | C381071 | - | 2 | 1000 | 1001 | LCSC (https://www.lcsc.com/product-detail/SIM-Card-Connectors_XKB-Connectivity-XKNANO-113_C381071.html) | $0.2061 | $206.3061
18 | LED | LED1 | Yellow-Green 572nm LED Indication - Discrete 2.05V 0603 (1608 Metric) | LED-0603 | 19-21/G6C-FM1N2B/3T | Everlight Elec | - | C93689 | - | 1 | 500 | 520 | LCSC (https://www.lcsc.com/product-detail/Light-Emitting-Diodes-LED_Everlight-Elec-19-21-G6C-FM1N2B-3T_C93689.html) | $0.0251 | $13.0520
19 | LED | LED2 | Red 632nm LED Indication - Discrete 2.05V 0603 (1608 Metric) | LED-0603 | 19-21/R7C-AK1L2BY/3T | Everlight Elec | - | C1322287 | - | 1 | 500 | 510 | LCSC (https://www.lcsc.com/product-detail/Light-Emitting-Diodes-LED_Everlight-Elec-19-21-R7C-AK1L2BY-3T_C1322287.html) | $0.0381 | $19.4310
20 | Transistor | Q1, Q2, Q3, Q4 | 40V 100mW 100@10mA,1V 200mA 300MHz 300mV@50mA,5mA NPN -55℃~+150℃@(Tj) SOT-723 Bipolar Transistors - BJT ROHS | SOT-723 | MMBT3904M | TECH PUBLIC | - | C2923360 | - | 4 | 2000 | 2020 | LCSC (https://www.lcsc.com/product-detail/Bipolar-Transistors-BJT_TECH-PUBLIC-MMBT3904M_C2923360.html) | $0.0190 | $38.3800
21 | Resistor | R1, R2, R12 | RES SMD 10K OHM 5% 1/10W 0603 | Res-0603 | AC0603JR-0710KL | Yageo | - | C140867 | 10K | 3 | 1500 | 1600 | LCSC (https://www.lcsc.com/product-detail/Chip-Resistor-Surface-Mount_YAGEO-AC0603JR-0710KL_C140867.html) | $0.0015 | $2.4000
22 | Resistor | R3, R5 | RES 22 OHM 1% 1/10W 0603 | Res-0603 | RC0603FR-0722RL | Yageo | - | C107701 | 22R | 2 | 1000 | 1100 | LCSC (https://www.lcsc.com/product-detail/Chip-Resistor-Surface-Mount_YAGEO-RC0603FR-0722RL_C107701.html) | $0.0010 | $1.1000
23 | Resistor | R4, R19 | RES SMD 0R, 1%, 0.1W, 0603 | Res-0603 | RC0603FR-070RL | Yageo | - | C100044 | 0R | 2 | 1000 | 1100 | LCSC (https://www.lcsc.com/product-detail/Chip-Resistor-Surface-Mount_YAGEO-RC0603FR-070RL_C100044.html) | $0.0010 | $1.1000
24 | Resistor | R6, R9 | RES 180 OHM 1% 1/10W 0603 | Res-0603 | RC0603FR-07180RL | Yageo | - | C137786 | 180R | 2 | 1000 | 1100 | LCSC (https://www.lcsc.com/product-detail/Chip-Resistor-Surface-Mount_YAGEO-RC0603FR-07180RL_C137786.html) | $0.0010 | $1.1000
25 | Resistor | R7, R10, R13, R17 | RES SMD 4.7K OHM 5% 1/10W 0603 | Res-0603 | RC0603JR-074K7L | Yageo | - | C105428 | 4.7K | 4 | 2000 | 2100 | LCSC (https://www.lcsc.com/product-detail/Chip-Resistor-Surface-Mount_YAGEO-RC0603JR-074K7L_C105428.html) | $0.0009 | $1.8900
26 | Resistor | R8, R11, R14, R18 | RES 47K OHM 5% 1/10W 0603 | Res-0603 | RC0603JR-0747KL | Yageo | - | C127447 | 47K | 4 | 2000 | 2100 | LCSC (https://www.lcsc.com/product-detail/Chip-Resistor-Surface-Mount_YAGEO-RC0603JR-0747KL_C127447.html) | $0.0008 | $1.6800
27 | IC | U1 | SMD,30x30mm 2G/3G/4G/5G Modules ROHS | Custom | SIM7500E | SIMCom | - | C126259 | - | 1 | 500 | 501 | Chipsmall (https://www.chipsmall.com/Products/SIM7500E_SIMCom-Wireless-Solutions_20290450.html) | $34.0130 | $17040.5030
28 | IC | U2 | IC SWITCH 4PDT 16MLP | 16-MLP (3x3) | FSA2567MPX | ON Semiconductor / Fairchild | - | C512961 | - | 1 | 500 | 501 | LCSC (https://www.lcsc.com/product-detail/Analog-Switches-Multiplexers_onsemi-FSA2567MPX_C512961.html) | $0.3781 | $189.4281
29 | ESD Diode | U3,U4 | 15V 5 Unidirectional 5V SOT-363 ESD Protection Devices ROHS | SOT-363 | SMF05CT1G-ES | ElecSuper | - | C5180312 | - | 2 | 1000 | 1020 | LCSC (https://www.lcsc.com/product-detail/ESD-Protection-Devices_ElecSuper-SMF05CT1G-ES_C5180312.html) | $0.0371 | $37.8420
30 | IC | U5 | IC TRNSLTR BIDIRECTIONAL US8 | VSSOP-8(2x2.3x0.5) | TXB0102DCUT | Texas Instruments | - | C2677366 | - | 1 | 500 | 501 | LCSC (https://www.lcsc.com/product-detail/Translators-Level-Shifters_Texas-Instruments-TXB0102DCUT_C2677366.html) | $0.4328 | $216.8328
31 | Peripheral | - | 2 5dBi 4GAntenna Vertical 2.4GHz 10W - Antennas ROHS | - | 801-4G | DreamLNK | - | C779858 | - | 1 | 500 | 500 | LCSC (https://www.lcsc.com/product-detail/Antennas_DreamLNK-801-4G_C779858.html) | $1.4732 | $736.6000
32 | Peripheral | - | 1.8 3dBi Vertical 50W - Antennas ROHS |  | BWGSMJWX105-7KJ | BAT WIRELESS | - | C497021 | - | 1 | 500 | 500 | LCSC (https://www.lcsc.com/product-detail/Antennas_BAT-WIRELESS-BWGSMJWX105-7KJ_C497021.html) | $0.5941 | $297.0500
 |  |  |  |  |  |  |  |  |  |  |  | Total Component Cost |  |  | $19727.45
 |  |  |  |  |  |  |  |  |  |  |  | Single Board Cost |  |  | $39.45

Sheet: 1000 Boards
 |  | Component list |  | Bill of Materials for Project [LTE_MODULE_v2.0.]
 |  | Source Data From: |  | LTE_MODULE_v2.0
 |  | Project: |  | LTE_MODULE_v2.0
 |  | Variant: |  | None
# | Item Type | Designator | Description | Footprint | Manufacturer Part Number | Manufacturer | Alternate Part Number | LCSC Part Number | Value | Quantity | Quantity (1000 Boards) | MOQ (1000 Boards) | Links | Unit Cost (1000 Boards) | Total Cost (1000 Boards) | Remarks | Reviewer Remarks
1 | Antenna | ANT1 | RF ANT 1.575GHZ CHIP SOLDER SMD | Custom | W3011 | Pulse | - | - | - | 1 | 1000 | 1002 | Digikey (https://www.digikey.com/en/products/detail/pulse-electronics/W3011/3025804) | $0.7830 | $784.5660 | Not Available in LCSC
2 | Capacitor | C1 | CAP CER 2.2PF 50V C0G/NPO 0603 | Cap-0603 | CC0603CRNPO9BN2R2 | Yageo | - | C282246 | 2.2pF | 1 | 1000 | 1100 | LCSC (https://www.lcsc.com/product-detail/Multilayer-Ceramic-Capacitors-MLCC-SMD-SMT_YAGEO-CC0603CRNPO9BN2R2_C282246.html) | $0.0032 | $3.5200
3 | Capacitor | C2 | CAP CER 33PF 25V C0G/NP0 0402 | Cap-0402 | ~~GRM1555C1E330JA01D~~ | Murata | 0402N330J250CT | C458864 | 33pF | 1 | 1000 | 1100 | LCSC (https://www.lcsc.com/product-detail/Multilayer-Ceramic-Capacitors-MLCC-SMD-SMT_Walsin-Tech-Corp-0402N330J250CT_C458864.html) | $0.0013 | $1.4300
4 | Capacitor | C5, C11, C13, C15, C16, C17 | CAP CER 0.1UF 50V X5R 0603 | Cap-0603 | ~~CC0603KRX5R9BB104~~ | Yageo | CC0603KRX7R9BB104 | C14663 | 0.1uF | 6 | 6000 | 6100 | LCSC (https://www.lcsc.com/product-detail/Multilayer-Ceramic-Capacitors-MLCC-SMD-SMT_YAGEO-CC0603KRX7R9BB104_C14663.html) | $0.0024 | $14.6400
5 | Capacitor | C6 | CAP TANT 220UF 20% 6.3V SMD | Case-B | TLJB227M006R0500 | Kyocera AVX | - | C30242 | 220uF | 1 | 1000 | 1005 | LCSC (https://www.lcsc.com/product-detail/Tantalum-Capacitors_Kyocera-AVX-TLJB227M006R0500_C30242.html) | $0.1271 | $127.7355
6 | Capacitor | C7 | CAP CER 1UF 25V X5R 0603 | Cap-0603 | CC0603KRX5R8BB105 | Yageo | - | C14664 | 1uF | 1 | 1000 | 1100 | LCSC (https://www.lcsc.com/product-detail/Multilayer-Ceramic-Capacitors-MLCC-SMD-SMT_YAGEO-CC0603KRX5R8BB105_C14664.html) | $0.0041 | $4.5100
7 | Capacitor | C8, C9, C10 | CAP CER 22PF 50V C0G/NPO 0402 | Cap-0402 | CC0402JRNPO9BN220 | Yageo | - | C106203 | 22PF | 3 | 3000 | 3100 | LCSC (https://www.lcsc.com/product-detail/Multilayer-Ceramic-Capacitors-MLCC-SMD-SMT_YAGEO-CC0402JRNPO9BN220_C106203.html) | $0.0007 | $2.1700
8 | Capacitor | C12, C14 | CAP CER 0.1UF 50V X7R 0402 | cap-0402 | C1005X7R1H104KT000F | TDK | - | C361198 | 100nF | 2 | 2000 | 2050 | LCSC (https://www.lcsc.com/product-detail/Multilayer-Ceramic-Capacitors-MLCC-SMD-SMT_TDK-C1005X7R1H104KT000F_C361198.html) | $0.0095 | $19.4750
9 | Diode | D1 | DIODE ZENER 5.1V 500MW SOD123 | SOD-123 | ~~MMSZ5231BT1G~~ | ON Semiconductor | SZMMSZ5231BT1G | C231290 | - | 1 | 1000 | 1005 | LCSC (https://www.lcsc.com/product-detail/Zener-Diodes_onsemi-SZMMSZ5231BT1G_C231290.html) | $0.0652 | $65.5260
10 | Diode | D2, D3 | 35A@8/20us 15V 4.5V@Max Unidirectional DFN1006 TVS ROHS | DFN1006-2L_ | ESD5651N-2/TR | WILLSEMI(Will Semicon) | - | C239784 | - | 2 | 2000 | 2060 | LCSC (https://www.lcsc.com/product-detail/TVS_WILLSEMI-Will-Semicon-ESD5651N-2-TR_C239784.html) | $0.0176 | $36.2560
11 | Diode | D4 | TVS DIODE 5VWM 6.3VC DSN0603-2 | DSN0603-2 | PESD5V0H1BSFYL | Nexperia | - | C477989 | - | 1 | 1000 | 1010 | LCSC (https://www.lcsc.com/product-detail/ESD-Protection-Devices_Nexperia-PESD5V0H1BSF_C477989.html) | $0.0347 | $35.0470
12 | Diode | D5 | 16A 20V 7V 5V@Max Unidirectional SOT-23 TVS ROHS | Sot-23 | ESD5302F-3/TR | WILLSEMI | - | C239643 | - | 1 | 1000 | 1010 | LCSC (https://www.lcsc.com/product-detail/TVS_WILLSEMI-Will-Semicon-ESD5302F-3-TR_C239643.html) | $0.0506 | $51.1060
13 | Fuse | F1 | 6V 500mA 40A 1A 0603 Resettable Fuses ROHS | Fuse-0603 | SMD0603-050 | TECHFUSE | - | C69679 | - | 1 | 1000 | 1010 | LCSC (https://www.lcsc.com/product-detail/Resettable-Fuses_TECHFUSE-SMD0603-050_C69679.html) | $0.0311 | $31.4110
14 | SMA Connector | J1 | 1 Inner bore SMA Board Edge Bend 11mm 5.35mm Plugin RF Connectors / Coaxial Connectors ROHS | Custom | HJ-SMA175 | HJ Tech | - | C1509213 | - | 1 | 1000 | 1001 | LCSC (https://www.lcsc.com/product-detail/RF-Connectors-Coaxial-Connectors_HJ-Tech-HJ-SMA175_C1509213.html) | $0.4519 | $452.3519
15 | PCIE SMD PAD | ~~J2~~ | ~~PCI Express Mini Card (Mini PCIe)~~ | ~~Custom~~ | ~~-~~ | ~~-~~ | ~~-~~ | ~~-~~ | ~~-~~ | ~~1~~ | 1000 | ~~-~~ | ~~-~~ | ~~-~~ | ~~-~~
16 | Pogo Connector | ~~J3~~ | ~~Pogo Pad 2.5mm 4 Pin~~ | ~~Custom~~ | ~~POGO Connector 4 Pin~~ | ~~-~~ | ~~-~~ | ~~-~~ | ~~-~~ | ~~1~~ | 1000 | ~~-~~ | ~~-~~ | ~~-~~ | ~~-~~
17 | SIM Card Connectors | J4, J5 | Copper Alloy Self bomb Gold plating 1.25mm Deck -40℃~+85℃ 260℃ NanoSIM SMD SIM Card Connectors ROHS | Custom | XKNANO-113 | XKB Connectivity | - | C381071 | - | 2 | 2000 | 2001 | LCSC (https://www.lcsc.com/product-detail/SIM-Card-Connectors_XKB-Connectivity-XKNANO-113_C381071.html) | $0.1981 | $396.3981
18 | LED | LED1 | Yellow-Green 572nm LED Indication - Discrete 2.05V 0603 (1608 Metric) | LED-0603 | 19-21/G6C-FM1N2B/3T | Everlight Elec | - | C93689 | - | 1 | 1000 | 1020 | LCSC (https://www.lcsc.com/product-detail/Light-Emitting-Diodes-LED_Everlight-Elec-19-21-G6C-FM1N2B-3T_C93689.html) | $0.0217 | $22.1340
19 | LED | LED2 | Red 632nm LED Indication - Discrete 2.05V 0603 (1608 Metric) | LED-0603 | 19-21/R7C-AK1L2BY/3T | Everlight Elec | - | C1322287 | - | 1 | 1000 | 1010 | LCSC (https://www.lcsc.com/product-detail/Light-Emitting-Diodes-LED_Everlight-Elec-19-21-R7C-AK1L2BY-3T_C1322287.html) | $0.0381 | $38.4810
20 | Transistor | Q1, Q2, Q3, Q4 | 40V 100mW 100@10mA,1V 200mA 300MHz 300mV@50mA,5mA NPN -55℃~+150℃@(Tj) SOT-723 Bipolar Transistors - BJT ROHS | SOT-723 | MMBT3904M | TECH PUBLIC | - | C2923360 | - | 4 | 4000 | 4020 | LCSC (https://www.lcsc.com/product-detail/Bipolar-Transistors-BJT_TECH-PUBLIC-MMBT3904M_C2923360.html) | $0.0190 | $76.3800
21 | Resistor | R1, R2, R12 | RES SMD 10K OHM 5% 1/10W 0603 | Res-0603 | AC0603JR-0710KL | Yageo | - | C140867 | 10K | 3 | 3000 | 3100 | LCSC (https://www.lcsc.com/product-detail/Chip-Resistor-Surface-Mount_YAGEO-AC0603JR-0710KL_C140867.html) | $0.0012 | $3.7200
22 | Resistor | R3, R5 | RES 22 OHM 1% 1/10W 0603 | Res-0603 | RC0603FR-0722RL | Yageo | - | C107701 | 22R | 2 | 2000 | 2100 | LCSC (https://www.lcsc.com/product-detail/Chip-Resistor-Surface-Mount_YAGEO-RC0603FR-0722RL_C107701.html) | $0.0012 | $2.5200
23 | Resistor | R4, R19 | RES SMD 0R, 1%, 0.1W, 0603 | Res-0603 | RC0603FR-070RL | Yageo | - | C100044 | 0R | 2 | 2000 | 2100 | LCSC (https://www.lcsc.com/product-detail/Chip-Resistor-Surface-Mount_YAGEO-RC0603FR-070RL_C100044.html) | $0.0010 | $2.1000
24 | Resistor | R6, R9 | RES 180 OHM 1% 1/10W 0603 | Res-0603 | RC0603FR-07180RL | Yageo | - | C137786 | 180R | 2 | 2000 | 2100 | LCSC (https://www.lcsc.com/product-detail/Chip-Resistor-Surface-Mount_YAGEO-RC0603FR-07180RL_C137786.html) | $0.0010 | $2.1000
25 | Resistor | R7, R10, R13, R17 | RES SMD 4.7K OHM 5% 1/10W 0603 | Res-0603 | RC0603JR-074K7L | Yageo | - | C105428 | 4.7K | 4 | 4000 | 4100 | LCSC (https://www.lcsc.com/product-detail/Chip-Resistor-Surface-Mount_YAGEO-RC0603JR-074K7L_C105428.html) | $0.0009 | $3.6900
26 | Resistor | R8, R11, R14, R18 | RES 47K OHM 5% 1/10W 0603 | Res-0603 | RC0603JR-0747KL | Yageo | - | C127447 | 47K | 4 | 4000 | 4100 | LCSC (https://www.lcsc.com/product-detail/Chip-Resistor-Surface-Mount_YAGEO-RC0603JR-0747KL_C127447.html) | $0.0008 | $3.2800
27 | IC | U1 | SMD,30x30mm 2G/3G/4G/5G Modules ROHS | Custom | SIM7500E | SIMCom | - | C126259 | - | 1 | 1000 | 1001 | Chipsmall (https://www.chipsmall.com/Products/SIM7500E_SIMCom-Wireless-Solutions_20290450.html) | $31.4935 | $31524.9935
28 | IC | U2 | IC SWITCH 4PDT 16MLP | 16-MLP (3x3) | FSA2567MPX | ON Semiconductor / Fairchild | - | C512961 | - | 1 | 1000 | 1001 | LCSC (https://www.lcsc.com/product-detail/Analog-Switches-Multiplexers_onsemi-FSA2567MPX_C512961.html) | $0.3608 | $361.1608
29 | ESD Diode | U3,U4 | 15V 5 Unidirectional 5V SOT-363 ESD Protection Devices ROHS | SOT-363 | SMF05CT1G-ES | ElecSuper | - | C5180312 | - | 2 | 2000 | 2020 | LCSC (https://www.lcsc.com/product-detail/ESD-Protection-Devices_ElecSuper-SMF05CT1G-ES_C5180312.html) | $0.0371 | $74.9420
30 | IC | U5 | IC TRNSLTR BIDIRECTIONAL US8 | VSSOP-8(2x2.3x0.5) | TXB0102DCUT | Texas Instruments | - | C2677366 | - | 1 | 1000 | 1001 | LCSC (https://www.lcsc.com/product-detail/Translators-Level-Shifters_Texas-Instruments-TXB0102DCUT_C2677366.html) | $0.3866 | $386.9866
31 | Peripheral | - | 2 5dBi 4GAntenna Vertical 2.4GHz 10W - Antennas ROHS | - | 801-4G | DreamLNK | - | C779858 | - | 1 | 1000 | 1000 | LCSC (https://www.lcsc.com/product-detail/Antennas_DreamLNK-801-4G_C779858.html) | $1.4732 | $1473.2000
32 | Peripheral | - | 1.8 3dBi Vertical 50W - Antennas ROHS |  | BWGSMJWX105-7KJ | BAT WIRELESS | - | C497021 | - | 1 | 1000 | 1000 | LCSC (https://www.lcsc.com/product-detail/Antennas_BAT-WIRELESS-BWGSMJWX105-7KJ_C497021.html) | $0.5744 | $574.4000
 |  |  |  |  |  |  |  |  |  |  |  | Total Component Cost |  |  | $36576.23
 |  |  |  |  |  |  |  |  |  |  |  | Single Board Cost |  |  | $36.58
