eSpark-Backup/chrisbyrd-esp32iotproduct/Design Files/Baseboard-v2.1/BOM/Client_BOM_Baseboard-v2.0.xlsx

 |  | Component list |  | Bill of Materials for Project [Baseboard-v2.0.]
 |  | Source Data From: |  | Baseboard-v2.0
 |  | Project: |  | Baseboard-v2.0
 |  | Variant: |  | None
# | Item Type | Designator | Description | Footprint | Manufacturer Part Number | Alternate Part Number | Manufacturer | Value | Quantity | Quantity (5 Boards) | Remarks
1 | Antenna | ~~ANT1~~ | ~~-~~ | ~~ANT*~~ | ~~Antenna~~ | ~~-~~ | ~~-~~ | ~~-~~ | ~~1~~ | ~~5~~ | DO NOT MOUNT
2 | Capacitor | C1 | CAP CER 4700PF 50V C0G/NPO 0603 | Cap-0603 | CC0603JRNPO9BN472 | - | Yageo | 4.7nF | 1 | 5
3 | Capacitor | C2, C9, C10, C13, C16, C17, C22, C23, C24, C27, C28, C32, C33, C34, C35, C36, C37, C38, C40, C41, C42, C43, C44, C45, C54 | CAP CER 0.1UF 100V X5R 0402 | Cap-0402 | GRM155R62A104KE14D | - | Murata | 0.1uf | 25 | 125
4 | Capacitor | C3, C19 | CAP CER 10000PF 50V X7R 0402 | Cap-0402 | CC0402KRX7R9BB103 | - | Yageo | 10nF | 2 | 10
5 | Capacitor | C4, C5, C6 | 68uF 50V SMD,D6.3xL7.7mm Aluminum Electrolytic Capacitors - SMD ROHS | Custom | RVT1H680M0607 | - | ROQANG | 68uF | 3 | 15
6 | Capacitor | C7, C8 | CAP TANT 220UF 10% 10V 2917 | Case-D | TAJD227K010RNJ | - | Kyocera AVX | 220uF | 2 | 10
7 | Capacitor | C11 | 10uF 10V 8Ω@100kHz ±10% CASE-A-3216 Tantalum Capacitors ROHS | Case-A | CA45-A-10V-10uF-K | - | CEC(Shenzhen Zhenhua XinYun Elec) | 10uF | 1 | 5
8 | Capacitor | C12 | 47uF 6.3V 5Ω@100kHz ±10% CASE-A-3216 Tantalum Capacitors ROHS | Case-A | CA45-A-6.3V-47uF-K | - | CEC | 47uF | 1 | 5
9 | Capacitor | C14 | CAP TANT 330UF 20% 16V 2917 | Case-E | TAJE337M016RNJ | - | Kyocera AVX | 330uF | 1 | 5
10 | Capacitor | C15 | CAP TANT 100UF 20% 10V 1411 | Case-B | TAJB107M010RNJ | - | Kyocera AVX | 100uF | 1 | 5
11 | Capacitor | C18, C21, C26, C39 | CAP CER 1UF 50V X5R 0402 | Cap-0402 | ~~UMK105CBJ105MV-F~~ | GRM155R61H105KE05D | Taiyo Yuden | 1uF | 4 | 20
12 | Capacitor | C20, C25, C48 | CAP CER 10UF 10V X5R 0402 | Cap-0402 | CL05A106MP5NUNC | - | Samsung | 10uF | 3 | 15
13 | Capacitor | C29, C30 | CAP CER 22PF 50V C0G/NPO 0402 | Cap-0402 | CC0402JRNPO9BN220 | - | Yageo | 22PF | 2 | 10
14 | Capacitor | C31, C46, C47 | CAP CER 330PF 50V C0G/NPO 0603 | Cap-0603 | CC0603JRNPO9BN331 | - | Yageo | 330pF | 3 | 15
15 | Diode | D1 | TVS DIODE 5VWM 6.3VC DSN0603-2 | DSN0603-2 | PESD5V0H1BSFYL | - | Nexperia | - | 1 | 5
16 | Diode | D2 | 58.1V 40V 36V Bi-Directional SMB(DO-214AA) TVS ROHS | SMB_ | SMBJ36CA | - | Slkor(SLKORMICRO Elec.) | - | 1 | 5
17 | Diode | D3 | 100V Single 650mV@20A 20A TO-277 Schottky Barrier Diodes (SBD) ROHS | TO-277 | ST20100L | - | Jiangsu Changjing Electronics Technology Co., Ltd. | - | 1 | 5
18 | Diode | D4 | 15V 19A 3.3V 4V Bidirectional SOD-323 ESD Protection Devices ROHS | SOD-323 | UDD32C03L01 | - | Brightking | - | 1 | 5
19 | Diode | D5, D12, D13 | DIODE GEN PURP 75V 200MA SOD523F | SOD-523F | 1N4148WT | - | ON Semiconductor / Fairchild | - | 3 | 15
20 | Diode | D6, D7 | Single 5.2V~6V 200mW 5.6V SOD-323 Zener Diodes ROHS | SOD-323 | BZT52C5V6S | - | Jiangsu Changjing Electronics Technology Co. | - | 2 | 10
21 | Diode | D8, D9, D10, D11 | DIODE ZENER ARRAY 3.3V SOT363 | SOT-363 | BZX84C3V3TS-7-F | - | Diodes Incorporated | - | 4 | 20
22 | Diode | D40, D41, D42, D43 | SMB(DO-214AA) TVS ROHS | SMB_ | SMBJ26CA | - | MSKSEMI | - | 4 | 20
23 | Fuse | F1 | PTC RESET FUSE 6V 3A 1206 | Fuse 1206 (3216 Metric) | 1206L300SLTHYR | - | Littelfuse | - | 1 | 5
24 | Fuse | F2 | 30V 5A 5A 2920 Resettable Fuses ROHS | Fuse-2920 | SHV2920P500-30-AA | - | PTTC(Polytronics Tech) | - | 1 | 5
25 | Fuse | F19, F20, F21, F22 | 9V 200mA 100A 500mA 0805 Resettable Fuses ROHS | Fuse-0805 | SMD0805P020TF | - | RUILON | - | 4 | 20
26 | Ferrite Bead | FB1 | FERRITE BEAD 120 OHM 1206 1LN | IND-1206 | BLM31PG121SN1L | -- | Murata | 100MHz | 1 | 5
27 | Terminal Block | J1, J2, J4, J6, J7, J8, J10, J13 | 1x3P 18A -40℃~+105℃ 250V Black 12~30 Straight pin 5.08mm 2.5 1 3 Plugin,P=5.08mm Screw terminal ROHS | Custom | DB128L-5.08-3P-BK-S | - | DIBO | - | 8 | 40
28 | USB Connector | J3 | 250mA 1 16 Female Type-C SMD USB Connectors ROHS | Custom | TYPE-C-31-M-12 | - | Korean Hroparts Elec | - | 1 | 5
29 | Terminal Block | J5, J9, J11, J14 | 1x2P 18A -40℃~+105℃ 250V Black 12~30 Straight pin 5.08mm 2.5 1 2 Plugin,P=5.08mm Screw terminal ROHS | Custom | DB128L-5.08-2P-BK-S | - | DIBO | - | 4 | 20
30 | FPC Connector | J12 | Slide Lock 18P Contact, Vertical - One Side Brick nogging 0.5mm SMD,P=0.5mm FFC/FPC Connectors ROHS | Custom | F0503-ZV-18-20T-R | - | XFCN | - | 1 | 5
31 | Connector | J17 | 1x6P SH 1 1mm 6 SMD,P=1mm Wire To Board / Wire To Wire Connector ROHS | Custom | C145963 | - | BOOMELE | - | 1 | 5
32 | SMA Connector | J19 | 1 Inner bore SMA Board Edge Bend 11mm 5.35mm Plugin RF Connectors / Coaxial Connectors ROHS | Custom | HJ-SMA175 |  | HJ Tech | - | 1 | 5
33 | mPCI-E Connector | J20, J21 | 0.8mm mPCI-E Surface Mount 52 SMD,P=0.8mm Card Edge Connectors ROHS | Custom | 91304-99-052R2 | - | UMAX | - | 2 | 10
34 | Relay | K1, K2, K3 | RELAY GEN PURPOSE SPDT 3A 5V | Custom | J102K1CS35VDC.20 | - | CIT Relay & Switch | - | 3 | 15
35 | Inductor | L1 | 7A 10uH ±20% 10A SMD,10.3x10.5mm Power Inductors ROHS | Custom | PSPMAA1040-100M-ANP | - | PROD Tech | 10uH | 1 | 5
36 | Inductor | L2 | 2nH ±0.3nH 0603 Inductors | IND-0603 (1608 Metric) | SDCL1608C2N0STDF | - | Sunlord | 2nH | 1 | 5
37 | LED | LED1, LED3 | Green 520~535nm 0402 Light Emitting Diodes (LED) RoHS | LED-0402 | 16-213/GHC-YR1S1/3T | - | Everlight Elec | - | 2 | 10
38 | LED | LED2 | Red 632nm LED Indication - Discrete 2.05V 0603 (1608 Metric) | LED-0603 | 19-21/R7C-AK1L2BY/3T | -- | Everlight Elec | - | 1 | 5
39 | Test Point | ~~P1, P2, P3, P4, P5, P6, P7, P8, P9, P10~~ | ~~Test Point ON~~ | ~~Custom~~ | ~~Test-point~~ | ~~-~~ | ~~-~~ | ~~-~~ | ~~10~~ | ~~50~~ | DO NOT MOUNT
40 | Mosfet | Q1 | TRANS PNP 40V 600MA SOT23-3 | sot-23 | MMBT4403LT1G | - | ON Semiconductor | - | 1 | 5
41 | Resistor | R1, R2 | RES SMD 5.1 KOHM 1% 1/5W 0402 | Res-0402 | ~~ERJ-PA2F5101X~~ | RT0402BRE075K1L | Panasonic | 5.1K | 2 | 10
42 | Varistor | R3 | VARISTOR 47V 500A DISC 10MM | Custom | B72210S0300K101 | - | TDK EPCOS | - | 1 | 5 | DO NOT MOUNT
43 | Resistor | R4 | RES SMD 1M OHM 5% 1/16W 0402 | Res-0402 | AF0402JR-071ML | - | Yageo | 1M | 1 | 5
44 | Resistor | R5, R7, R13, R34, R47, R48, R54, R55, R93, R94, R95, R96 | RES SMD 10K OHM 1% 1/20W 0201 | Res-0201 | RC0201FR-0710KL | - | Yageo | 10K | 12 | 60
45 | Resistor | R6, R8, R10, R79, R80, R81, R85, R86 | RES 1K OHM 1% 1/20W 0201 | Res-0201 | ~~RC0201FR-071KP~~ | RC0201FR-071KL | Yageo | 1K | 8 | 40
46 | Resistor | R9 | 100mW Thick Film Resistors ±1% 3.24kΩ 0603 Chip Resistor - Surface Mount ROHS | Res-0603 | 0603WAF3241T5E | - | UNI-ROYAL | 3.24K | 1 | 5
47 | Resistor | R11, R29 | RES SMD 100K OHM 5% 1/20W 0201 | Res-0201 | RC0201JR-07100KL | - | Yageo | 100K | 2 | 10
48 | Resistor | R12, R20 | RES 470 OHM 5% 1/20W 0201 | Res-0201 | RC0201JR-07470RL | - | Yageo | 470R | 2 | 10
49 | Resistor | R14, R30 | RES 47K OHM 1% 1/16W 0402 | Res-0402 | RC0402FR-0747KL | - | Yageo | 47K | 2 | 10
50 | Resistor | R15, R16, R18, R19, R35, R36, R37, R38, R39, R40, R41, R42, R43, R44, R45, R46, R68, R69, R70, R71, R72, R77 | RES 4.7K OHM 1% 1/16W 0402 | Res-0402 | RC0402FR-074K7L | - | Yageo | 4.7K | 22 | 110
51 | Resistor | R17 | RES 499 OHM 1% 1/16W 0402 | Res-0402 | RC0402FR-07499RL | - | Yageo | 499R | 1 | 5
52 | Resistor | R21, R63, R64, R65, R66, R67, R82, R83, R84, R88, R89 | RES 0 OHM JUMPER 1/16W 0402 | Res-0402 | RC0402FR-070RL | - | Yageo | 0R | 11 | 55
53 | Resistor Array | R22, R23, R24 | RES ARRAY 4 RES 100K OHM 1206 | Custom | YC164-JR-07100KL | - | Yageo | 100K | 3 | 15
54 | Resistor | R25, R26, R32, R33 | RES 56K OHM 1% 1/16W 0402 | Res-0402 | RC0402FR-0756KL | - | Yageo | 56k | 4 | 20
55 | Resistor | R27 | RES 330K OHM 1% 1/10W 0603 | Res-0603 | RC0603FR-07330KL | - | Yageo | 330K | 1 | 5
56 | Resistor | R28 | RES SMD 0402 150kOhm 5% Paper T/R | Res-0402 | RC0402JR-07150KL | - | Yageo | 150K | 1 | 5
57 | Resistor | R31 | RES SMD 68K OHM 0.1% 1/10W 0603 | Res-0603 | RT0603BRD0768KL | - | Yageo | 68K | 1 | 5
58 | Resistor | R73, R74, R75, R76 | RES SMD 22 OHM 1% 1/5W 0402 | Res-0402 | RCS040222R0FKED | CRCW040222R0FKEDHP | Vishay Dale | 22R | 4 | 20
59 | Resistor | R78 | RES 120 OHM 1% 1/10W 0603 | Res-0603 | RC0603FR-07120RL | - | Yageo | 120R | 1 | 5
60 | Resistor | R87 | RES SMD 68 OHM 0.1% 1/16W 0402 | Res-0402 | ERA-2AEB680X | - | Panasonic | 68R | 1 | 5
61 | Resistor | R90, R91 | RES SMD 680 OHM 1% 1/10W 0603 | Res-0603 | RC0603FR-07680RL | - | Yageo | 680R | 2 | 10
62 | Resistor | R92 | RES 3.3K OHM 1% 1/16W 0402 | Res-0402 | RC0402FR-073K3L | - | Yageo | 3.3K | 1 | 5
63 | Resistor Array | RN1, RN2, RN3, RN4, RN5 | RES ARRAY 4 RES 10K OHM 1206 | Custom | YC164-FR-0710KL | - | Yageo | 10K | 5 | 25
64 | Solder Bridge | ~~SB1, SB2~~ | ~~Solder Bridge ON~~ | ~~Custom~~ | ~~Solder Bridge 0402~~ | ~~-~~ | ~~-~~ | ~~-~~ | ~~2~~ | ~~10~~
65 | Tactile Switch | SW1 | 50mA Lying SPST 24V Plugin Tactile Switches ROHS | Custom | 1825027-8 | - | TE Connectivity | - | 1 | 5
66 | IC | U1 | IC REG BUCK ADJUSTABLE 5A 8SOPWR | 8-SO-EP_ | TPS5450DDAR | - | Texas Instruments | - | 1 | 5
67 | IC | U2 | 1.6-V TO 5.5-V, 40-M, 2.5-A, LOW | SOT-583 | TPS2116DRLR | - | Texas Instruments | - | 1 | 5
68 | IC | U3 | 72dB@(120Hz) 5A Fixed 3.3V~3.3V Positive 12V TO-263-3 Linear Voltage Regulators (LDO) ROHS | TO263-3_ | LM1084S-3.3/TR | - | HGSEMI | - | 1 | 5
69 | IC | U4 | IC REG LDO ADJ 3A TO263-5 | TO-263-5 (D2PAK) | MIC29302WU-TR | - | Microchip | - | 1 | 5
70 | IC | U5 | IC FLASH 64M SPI 133MHZ 8SOIC | SOIC-8 (208 mil) | W25Q64JVSSIQ TR |  | Winbond | - | 1 | 5
71 | IC | U6 | SMD IC ESP32-S3R8, DUAL-CORE MCU | 56-QFN (7x7) | ESP32-S3R8 | - | Espressif Systems | - | 1 | 5
72 | IC | U7 | IC AUTHENTICATION CHIP 8SOIC | SOIC-8 | ATECC608B-SSHDA-B | - | Microchip | - | 1 | 5
73 | IC | U8 | IC TELECOM INTERFACE 20SSOP | SSOP-20-5.2mm | MT8870DN1 |  | Microsemi | - | 1 | 5
74 | IC | U9 | IC RF SWITCH SPDT 3GHZ SOT23-6 | SOT-23-6 | HMC221BETR | - | Analog Devices | - | 1 | 5
75 | IC | U11, U27, U28 | IC XPNDR 1.7MHZ I2C 28SSOP | SSOP-28-208mil | MCP23017T-E/SS | - | Microchip | - | 3 | 15
76 | IC | U20 | 100uA@50V 3V@2V,300mA 1.6V@350mA 4mA@12V 100uA@50V 1.25V@350mA 500mA 25pF SOP-16_150mil Darlington Transistor Arrays ROHS | SOP-16_150mil | ULN2003A | - | Mixic | - | 1 | 5
77 | IC | U30 | IC TRANSCEIVER FULL 2/2 16SOIC | SOIC-16 | MAX3232IDR | - | Texas Instruments | - | 1 | 5
78 | IC | U31 | SOP-8 RS-485/RS-422 ICs ROHS | SOP-8 | SP3485EIM/TR | - | HGSEMI | - | 1 | 5
79 | IC | U32 | DGTL ISO 2.5KV GEN PURP 8SOIC | SOIC-8 | ADUM1201ARZ-RL7 | - | Analog Devices | - | 1 | 5
80 | IC | U33 | DGTL ISO 2.5KV GEN PURP 8SOIC | SOIC-8 | ADUM1200ARZ-RL7 | - | Analog Devices | - | 1 | 5
81 | Crystal | X1 | 40MHz SMD Crystal Resonator 15pF SMD3225-4P Crystals ROHS | Custom | X322540MPB4SI | - | Yangxing Tech | 40MHz | 1 | 5
82 | Crystal | X2 | 3.579545MHz 20pF ±30ppm HC-49S-SMD Crystals ROHS | HC-49S-SMD | TAXM3.579M2ILFBET2T | - | TAE | 3.579545MHz | 1 | 5
83 | peripheral | - | 1.8 8dBi Vertical 50W - Antennas ROHS | - | BW2.4JWX195-13KJ | - | BAT WIRELESS | - | 1 | 5
84 | peripheral |  | DIA 2mm Light Pipe Plastic LED Light Pipe RoHS Light Pipe Guide PDPLC-2.0-Series (PDPLC-2.0-2.54) | - | PDPLC-2.0-2.54 | - | - | - | 3 | 15
