eSpark-Backup/chrisbyrd-esp32iotproduct/Design Files/Adv-OLED-v2.1/Deliverables/Supporting Files/Adv-OLED_v2.0.step

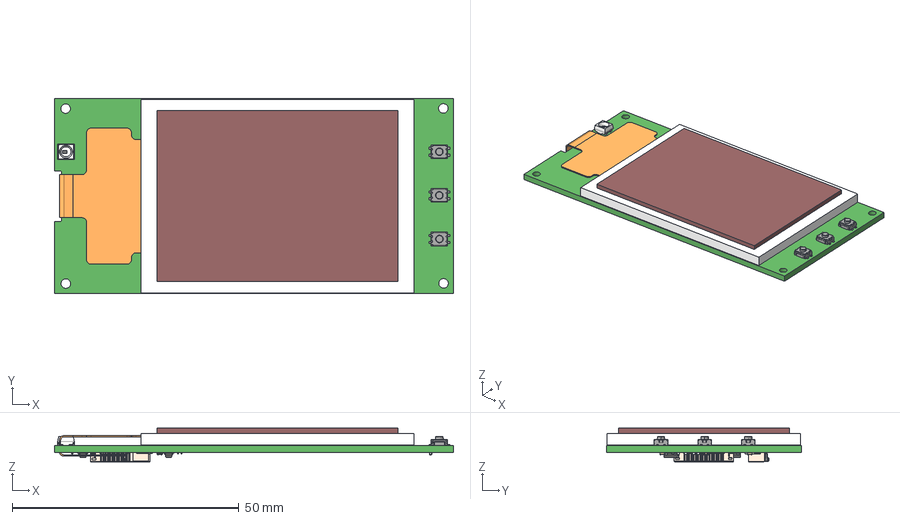
[picture p27: CAD file, 2024-01-11]
Design Files/Adv-OLED-v2.1/Deliverables/Supporting Files/Adv-OLED_v2.0.step
88.0 x 43.0 x 7.43 mm
ts-1185ec-c-d-b_RGB6710886 x 3
User_Library-RES_1005-0402 x 4
User_Library-0201(0603M)_Res x 4
CircuitWorks-SOT-23 x 2
SMD_WS2812B_Mini
COMPOUND.step x 2
User_Library-Capacitor_0402 x 5
eBom-FreeParts
COMPOUND$1$ATF.dwg
