eSpark-Backup/chrisbyrd-esp32iotproduct/Design Files/Adv-OLED-v2.1/Sample PCB.step

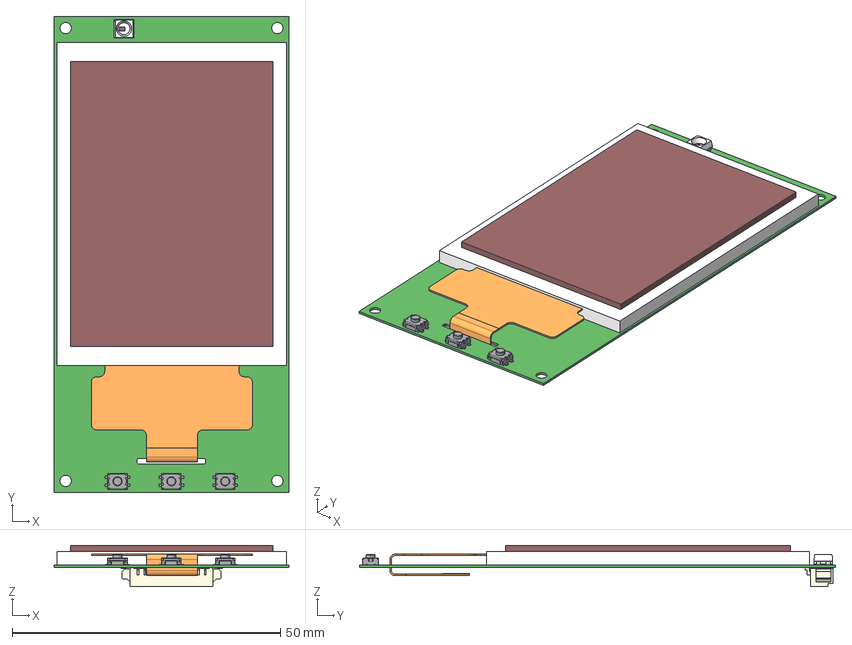
[picture p28: CAD file, 2024-01-11]
Design Files/Adv-OLED-v2.1/Sample PCB.step
43.7 x 88.6 x 7.72 mm
SMD_WS2812B_Mini
Tab
Pins
New_Marking
Molex_Logo-LAPTOP-NQA1DCQ3
ts-1185ec-c-d-b_RGB6710886 x 3
HT240S030
