eSpark-Backup/chrisbyrd-esp32iotproduct/Design Files/Ethernet-Module-v2.0/Deliverables/Supporting_Files/Ethernet-Module.step

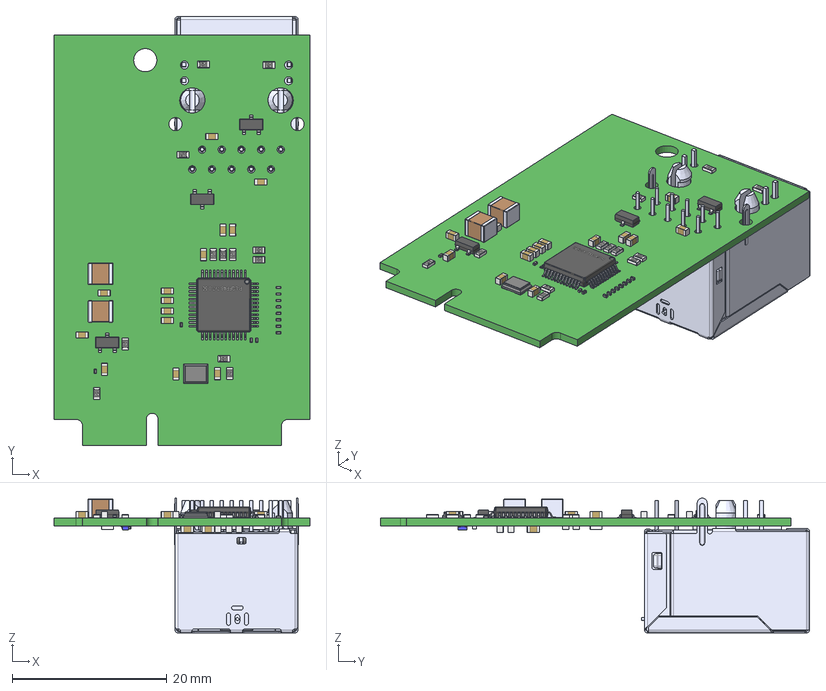
[picture p29: CAD file, 2024-01-11]
Design Files/Ethernet-Module-v2.0/Deliverables/Supporting_Files/Ethernet-Module.step
33.0 x 55.4 x 17.4 mm
CircuitWorks-SOT-23 x 3
User Library-RES_1005-0402
NX3225GA-25MHZ-STD-CRG-2
User Library-P-LQFP48-7x7-0_50
User Library-RESC1608X05N x 17
User Library-0201(0603M) Res x 12
VESM
11H_HOUSING_1^11H_HOUSING_LED_ASM_7_ASM_ASM_11H_HOUSING_LED_COVER_ASM_ 1_ASM_ASM_11H_HOUSING_MODULE_ASM_1_ASM_ASM_11H_ASSEMBLE_BOTTOM_PCB_ASM_ 2_A_ASM_11H_ASSY_
11H_LED_LEFT_2^11H_HOUSING_LED_ASM_7_ASM_ASM_11H_HOUSING_LED_COVER_ASM_ 1_ASM_ASM_11H_HOUSING_MODULE_ASM_1_ASM_ASM_11H_ASSEMBLE_BOTTOM_PCB_ASM_ 2_A_ASM_11H_ASSY
11H_LED_RIGHT_3^11H_HOUSING_LED_ASM_7_ASM_ASM_11H_HOUSING_LED_COVER_ ASM_1_ASM_ASM_11H_HOUSING_MODULE_ASM_1_ASM_ASM_11H_ASSEMBLE_BOTTOM_PCB_ ASM_2_A_ASM_11H_ASS
PCB_3^PCBA_ASM_3_ASM_ASM_11H_MODULE_PCBA_ASM_3_ASM_ASM_11H_MODULE_ INSERT_ASM_5_ASM_ASM_11H_HOUSING_MODULE_ASM_1_ASM_ASM_11H_ASSEMBLE_ BOTTOM_PCB_ASM_2_A_ASM_11
4D03_3^PCBA_ASM_3_ASM_ASM_11H_MODULE_PCBA_ASM_3_ASM_ASM_11H_MODULE_ INSERT_ASM_5_ASM_ASM_11H_HOUSING_MODULE_ASM_1_ASM_ASM_11H_ASSEMBLE_ BOTTOM_PCB_ASM_2_A_ASM_1
C_1206_3^PCBA_ASM_3_ASM_ASM_11H_MODULE_PCBA_ASM_3_ASM_ASM_11H_MODULE_ INSERT_ASM_5_ASM_ASM_11H_HOUSING_MODULE_ASM_1_ASM_ASM_11H_ASSEMBLE_ BOTTOM_PCB_ASM_2_A_ASM
MANIFOLD_SOLID_BREP_57161^CP_1_3_ASM_ASM_MODULE_CASE_11H_ASM_9_AF0_ASM_ ASM_MODULE_11H_ASM_3_ASM_ASM_11H_MODULE_PCBA_ASM_3_ASM_ASM_11H_MODULE_ INSERT_ASM_5_ASM_
MANIFOLD_SOLID_BREP_57406^CP_1_3_ASM_ASM_MODULE_CASE_11H_ASM_9_AF0_ASM_ ASM_MODULE_11H_ASM_3_ASM_ASM_11H_MODULE_PCBA_ASM_3_ASM_ASM_11H_MODULE_ INSERT_ASM_5_ASM_
MANIFOLD_SOLID_BREP_57651^CP_1_3_ASM_ASM_MODULE_CASE_11H_ASM_9_AF0_ASM_ ASM_MODULE_11H_ASM_3_ASM_ASM_11H_MODULE_PCBA_ASM_3_ASM_ASM_11H_MODULE_ INSERT_ASM_5_ASM_
MANIFOLD_SOLID_BREP_57896^CP_1_3_ASM_ASM_MODULE_CASE_11H_ASM_9_AF0_ASM_ ASM_MODULE_11H_ASM_3_ASM_ASM_11H_MODULE_PCBA_ASM_3_ASM_ASM_11H_MODULE_ INSERT_ASM_5_ASM_
MANIFOLD_SOLID_BREP_58141^CP_1_3_ASM_ASM_MODULE_CASE_11H_ASM_9_AF0_ASM_ ASM_MODULE_11H_ASM_3_ASM_ASM_11H_MODULE_PCBA_ASM_3_ASM_ASM_11H_MODULE_ INSERT_ASM_5_ASM_
MANIFOLD_SOLID_BREP_58386^CP_1_3_ASM_ASM_MODULE_CASE_11H_ASM_9_AF0_ASM_ ASM_MODULE_11H_ASM_3_ASM_ASM_11H_MODULE_PCBA_ASM_3_ASM_ASM_11H_MODULE_ INSERT_ASM_5_ASM_
MANIFOLD_SOLID_BREP_57161_AF0^CP_1_3_AF0_ASM_ASM_MODULE_CASE_11H_ASM_9_ AF0_ASM_ASM_MODULE_11H_ASM_3_ASM_ASM_11H_MODULE_PCBA_ASM_3_ASM_ASM_11H_ MODULE_INSERT_AS
MANIFOLD_SOLID_BREP_57406_AF0^CP_1_3_AF0_ASM_ASM_MODULE_CASE_11H_ASM_9_ AF0_ASM_ASM_MODULE_11H_ASM_3_ASM_ASM_11H_MODULE_PCBA_ASM_3_ASM_ASM_11H_ MODULE_INSERT_AS
MANIFOLD_SOLID_BREP_57651_AF0^CP_1_3_AF0_ASM_ASM_MODULE_CASE_11H_ASM_9_ AF0_ASM_ASM_MODULE_11H_ASM_3_ASM_ASM_11H_MODULE_PCBA_ASM_3_ASM_ASM_11H_ MODULE_INSERT_AS
MANIFOLD_SOLID_BREP_57896_AF0^CP_1_3_AF0_ASM_ASM_MODULE_CASE_11H_ASM_9_ AF0_ASM_ASM_MODULE_11H_ASM_3_ASM_ASM_11H_MODULE_PCBA_ASM_3_ASM_ASM_11H_ MODULE_INSERT_AS
MANIFOLD_SOLID_BREP_58141_AF0^CP_1_3_AF0_ASM_ASM_MODULE_CASE_11H_ASM_9_ AF0_ASM_ASM_MODULE_11H_ASM_3_ASM_ASM_11H_MODULE_PCBA_ASM_3_ASM_ASM_11H_ MODULE_INSERT_AS
MANIFOLD_SOLID_BREP_58386_AF0^CP_1_3_AF0_ASM_ASM_MODULE_CASE_11H_ASM_9_ AF0_ASM_ASM_MODULE_11H_ASM_3_ASM_ASM_11H_MODULE_PCBA_ASM_3_ASM_ASM_11H_ MODULE_INSERT_AS
MANIFOLD_SOLID_BREP_58677^CP_2_11_ASM_ASM_MODULE_CASE_11H_ASM_9_AF0_ ASM_ASM_MODULE_11H_ASM_3_ASM_ASM_11H_MODULE_PCBA_ASM_3_ASM_ASM_11H_ MODULE_INSERT_ASM_5_ASM
MANIFOLD_SOLID_BREP_58922^CP_2_11_ASM_ASM_MODULE_CASE_11H_ASM_9_AF0_ ASM_ASM_MODULE_11H_ASM_3_ASM_ASM_11H_MODULE_PCBA_ASM_3_ASM_ASM_11H_ MODULE_INSERT_ASM_5_ASM
MANIFOLD_SOLID_BREP_59167^CP_2_11_ASM_ASM_MODULE_CASE_11H_ASM_9_AF0_ ASM_ASM_MODULE_11H_ASM_3_ASM_ASM_11H_MODULE_PCBA_ASM_3_ASM_ASM_11H_ MODULE_INSERT_ASM_5_ASM
MANIFOLD_SOLID_BREP_59412^CP_2_11_ASM_ASM_MODULE_CASE_11H_ASM_9_AF0_ ASM_ASM_MODULE_11H_ASM_3_ASM_ASM_11H_MODULE_PCBA_ASM_3_ASM_ASM_11H_ MODULE_INSERT_ASM_5_ASM
MANIFOLD_SOLID_BREP_59657^CP_2_11_ASM_ASM_MODULE_CASE_11H_ASM_9_AF0_ ASM_ASM_MODULE_11H_ASM_3_ASM_ASM_11H_MODULE_PCBA_ASM_3_ASM_ASM_11H_ MODULE_INSERT_ASM_5_ASM
MODULE_CASE_6_AF0^MODULE_CASE_11H_ASM_9_AF0_ASM_ASM_MODULE_11H_ASM_3_ ASM_ASM_11H_MODULE_PCBA_ASM_3_ASM_ASM_11H_MODULE_INSERT_ASM_5_ASM_ASM_ 11H_HOUSING_MODULE_
CP_4_3^MODULE_CASE_11H_ASM_9_AF0_ASM_ASM_MODULE_11H_ASM_3_ASM_ASM_11H_ MODULE_PCBA_ASM_3_ASM_ASM_11H_MODULE_INSERT_ASM_5_ASM_ASM_11H_HOUSING_ MODULE_ASM_1_ASM_A
CP_3_GND_1067_3^MODULE_CASE_11H_ASM_9_AF0_ASM_ASM_MODULE_11H_ASM_3_ASM_ ASM_11H_MODULE_PCBA_ASM_3_ASM_ASM_11H_MODULE_INSERT_ASM_5_ASM_ASM_11H_ HOUSING_MODULE_AS
MANIFOLD_SOLID_BREP_60505_AF0^CORE_T_3_AF0_ASM_ASM_COIL_ASM_3_AF0_ASM_ ASM_MODULE_11H_ASM_3_ASM_ASM_11H_MODULE_PCBA_ASM_3_ASM_ASM_11H_MODULE_ INSERT_ASM_5_ASM_A
MANIFOLD_SOLID_BREP_60966_AF0^CORE_T_3_AF0_ASM_ASM_COIL_ASM_3_AF0_ASM_ ASM_MODULE_11H_ASM_3_ASM_ASM_11H_MODULE_PCBA_ASM_3_ASM_ASM_11H_MODULE_ INSERT_ASM_5_ASM_A
MANIFOLD_SOLID_BREP_61427_AF0^CORE_T_3_AF0_ASM_ASM_COIL_ASM_3_AF0_ASM_ ASM_MODULE_11H_ASM_3_ASM_ASM_11H_MODULE_PCBA_ASM_3_ASM_ASM_11H_MODULE_ INSERT_ASM_5_ASM_A
MANIFOLD_SOLID_BREP_61888_AF0^CORE_T_3_AF0_ASM_ASM_COIL_ASM_3_AF0_ASM_ ASM_MODULE_11H_ASM_3_ASM_ASM_11H_MODULE_PCBA_ASM_3_ASM_ASM_11H_MODULE_ INSERT_ASM_5_ASM_A
MANIFOLD_SOLID_BREP_62349_AF0^CORE_T_3_AF0_ASM_ASM_COIL_ASM_3_AF0_ASM_ ASM_MODULE_11H_ASM_3_ASM_ASM_11H_MODULE_PCBA_ASM_3_ASM_ASM_11H_MODULE_ INSERT_ASM_5_ASM_A
MANIFOLD_SOLID_BREP_62810_AF0^CORE_T_3_AF0_ASM_ASM_COIL_ASM_3_AF0_ASM_ ASM_MODULE_11H_ASM_3_ASM_ASM_11H_MODULE_PCBA_ASM_3_ASM_ASM_11H_MODULE_ INSERT_ASM_5_ASM_A
MANIFOLD_SOLID_BREP_63271_AF0^CORE_T_3_AF0_ASM_ASM_COIL_ASM_3_AF0_ASM_ ASM_MODULE_11H_ASM_3_ASM_ASM_11H_MODULE_PCBA_ASM_3_ASM_ASM_11H_MODULE_ INSERT_ASM_5_ASM_A
MANIFOLD_SOLID_BREP_63732_AF0^CORE_T_3_AF0_ASM_ASM_COIL_ASM_3_AF0_ASM_ ASM_MODULE_11H_ASM_3_ASM_ASM_11H_MODULE_PCBA_ASM_3_ASM_ASM_11H_MODULE_ INSERT_ASM_5_ASM_A
MANIFOLD_SOLID_BREP_64193_AF0^CORE_T_3_AF0_ASM_ASM_COIL_ASM_3_AF0_ASM_ ASM_MODULE_11H_ASM_3_ASM_ASM_11H_MODULE_PCBA_ASM_3_ASM_ASM_11H_MODULE_ INSERT_ASM_5_ASM_A
MANIFOLD_SOLID_BREP_64654_AF0^CORE_T_3_AF0_ASM_ASM_COIL_ASM_3_AF0_ASM_ ASM_MODULE_11H_ASM_3_ASM_ASM_11H_MODULE_PCBA_ASM_3_ASM_ASM_11H_MODULE_ INSERT_ASM_5_ASM_A
MANIFOLD_SOLID_BREP_65115_AF0^CORE_T_3_AF0_ASM_ASM_COIL_ASM_3_AF0_ASM_ ASM_MODULE_11H_ASM_3_ASM_ASM_11H_MODULE_PCBA_ASM_3_ASM_ASM_11H_MODULE_ INSERT_ASM_5_ASM_A
MANIFOLD_SOLID_BREP_65521_AF0^CORE_K_3_AF0_ASM_ASM_COIL_ASM_3_AF0_ASM_ ASM_MODULE_11H_ASM_3_ASM_ASM_11H_MODULE_PCBA_ASM_3_ASM_ASM_11H_MODULE_ INSERT_ASM_5_ASM_A
MANIFOLD_SOLID_BREP_65982^CORE_K_3_AF0_ASM_ASM_COIL_ASM_3_AF0_ASM_ASM_ MODULE_11H_ASM_3_ASM_ASM_11H_MODULE_PCBA_ASM_3_ASM_ASM_11H_MODULE_ INSERT_ASM_5_ASM_ASM_1
MANIFOLD_SOLID_BREP_66443_AF0^CORE_K_3_AF0_ASM_ASM_COIL_ASM_3_AF0_ASM_ ASM_MODULE_11H_ASM_3_ASM_ASM_11H_MODULE_PCBA_ASM_3_ASM_ASM_11H_MODULE_ INSERT_ASM_5_ASM_A
MANIFOLD_SOLID_BREP_66904_AF0^CORE_K_3_AF0_ASM_ASM_COIL_ASM_3_AF0_ASM_ ASM_MODULE_11H_ASM_3_ASM_ASM_11H_MODULE_PCBA_ASM_3_ASM_ASM_11H_MODULE_ INSERT_ASM_5_ASM_A
MANIFOLD_SOLID_BREP_67365_AF0^CORE_K_3_AF0_ASM_ASM_COIL_ASM_3_AF0_ASM_ ASM_MODULE_11H_ASM_3_ASM_ASM_11H_MODULE_PCBA_ASM_3_ASM_ASM_11H_MODULE_ INSERT_ASM_5_ASM_A
MANIFOLD_SOLID_BREP_67826_AF0^CORE_K_3_AF0_ASM_ASM_COIL_ASM_3_AF0_ASM_ ASM_MODULE_11H_ASM_3_ASM_ASM_11H_MODULE_PCBA_ASM_3_ASM_ASM_11H_MODULE_ INSERT_ASM_5_ASM_A
MANIFOLD_SOLID_BREP_68287^CORE_K_3_AF0_ASM_ASM_COIL_ASM_3_AF0_ASM_ASM_ MODULE_11H_ASM_3_ASM_ASM_11H_MODULE_PCBA_ASM_3_ASM_ASM_11H_MODULE_ INSERT_ASM_5_ASM_ASM_1
MANIFOLD_SOLID_BREP_68748^CORE_K_3_AF0_ASM_ASM_COIL_ASM_3_AF0_ASM_ASM_ MODULE_11H_ASM_3_ASM_ASM_11H_MODULE_PCBA_ASM_3_ASM_ASM_11H_MODULE_ INSERT_ASM_5_ASM_ASM_1
MANIFOLD_SOLID_BREP_69209^CORE_K_3_AF0_ASM_ASM_COIL_ASM_3_AF0_ASM_ASM_ MODULE_11H_ASM_3_ASM_ASM_11H_MODULE_PCBA_ASM_3_ASM_ASM_11H_MODULE_ INSERT_ASM_5_ASM_ASM_1
MANIFOLD_SOLID_BREP_69670^CORE_K_3_AF0_ASM_ASM_COIL_ASM_3_AF0_ASM_ASM_ MODULE_11H_ASM_3_ASM_ASM_11H_MODULE_PCBA_ASM_3_ASM_ASM_11H_MODULE_ INSERT_ASM_5_ASM_ASM_1
MANIFOLD_SOLID_BREP_70131^CORE_K_3_AF0_ASM_ASM_COIL_ASM_3_AF0_ASM_ASM_ MODULE_11H_ASM_3_ASM_ASM_11H_MODULE_PCBA_ASM_3_ASM_ASM_11H_MODULE_ INSERT_ASM_5_ASM_ASM_1
MANIFOLD_SOLID_BREP_60505_AF1^CORE_T_3_AF1_ASM_ASM_COIL_ASM_3_AF1_ASM_ ASM_MODULE_11H_ASM_3_ASM_ASM_11H_MODULE_PCBA_ASM_3_ASM_ASM_11H_MODULE_ INSERT_ASM_5_ASM_A
MANIFOLD_SOLID_BREP_64193_AF1^CORE_T_3_AF1_ASM_ASM_COIL_ASM_3_AF1_ASM_ ASM_MODULE_11H_ASM_3_ASM_ASM_11H_MODULE_PCBA_ASM_3_ASM_ASM_11H_MODULE_ INSERT_ASM_5_ASM_A
MANIFOLD_SOLID_BREP_64654_AF1^CORE_T_3_AF1_ASM_ASM_COIL_ASM_3_AF1_ASM_ ASM_MODULE_11H_ASM_3_ASM_ASM_11H_MODULE_PCBA_ASM_3_ASM_ASM_11H_MODULE_ INSERT_ASM_5_ASM_A
MANIFOLD_SOLID_BREP_60505_AF2^CORE_T_3_AF2_ASM_ASM_COIL_ASM_3_AF2_ASM_ ASM_MODULE_11H_ASM_3_ASM_ASM_11H_MODULE_PCBA_ASM_3_ASM_ASM_11H_MODULE_ INSERT_ASM_5_ASM_A
MANIFOLD_SOLID_BREP_64193_AF2^CORE_T_3_AF2_ASM_ASM_COIL_ASM_3_AF2_ASM_ ASM_MODULE_11H_ASM_3_ASM_ASM_11H_MODULE_PCBA_ASM_3_ASM_ASM_11H_MODULE_ INSERT_ASM_5_ASM_A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
