eSpark-Backup/chrisbyrd-esp32iotproduct/Design Files/LoRaWAN-Module-v2.0/Deliverables/Supporting_Files/LoRaWAN_v2.0.step

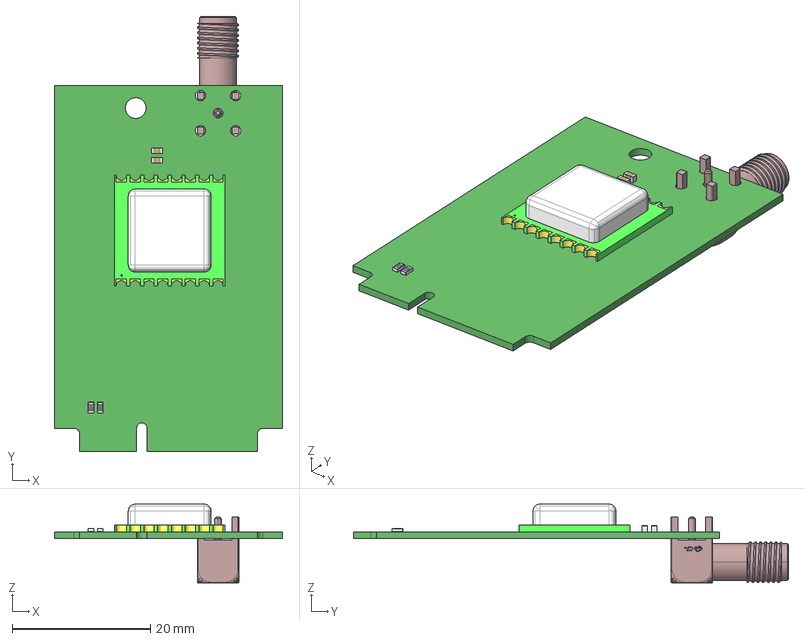
[picture p31: CAD file, 2024-01-11]
Design Files/LoRaWAN-Module-v2.0/Deliverables/Supporting_Files/LoRaWAN_v2.0.step
33.0 x 63.0 x 11.4 mm
Vollgo SX1276S8S+T-X1
User Library-RESC1608X05N x 2
COMPOUND.step.STEP
User Library-CAPC1608X09 x 2
