eSpark-Backup/chrisbyrd-esp32iotproduct/Design Files/LTE-Module-v2.0/Deliverables/Supporting_Files/LTE-Module.step

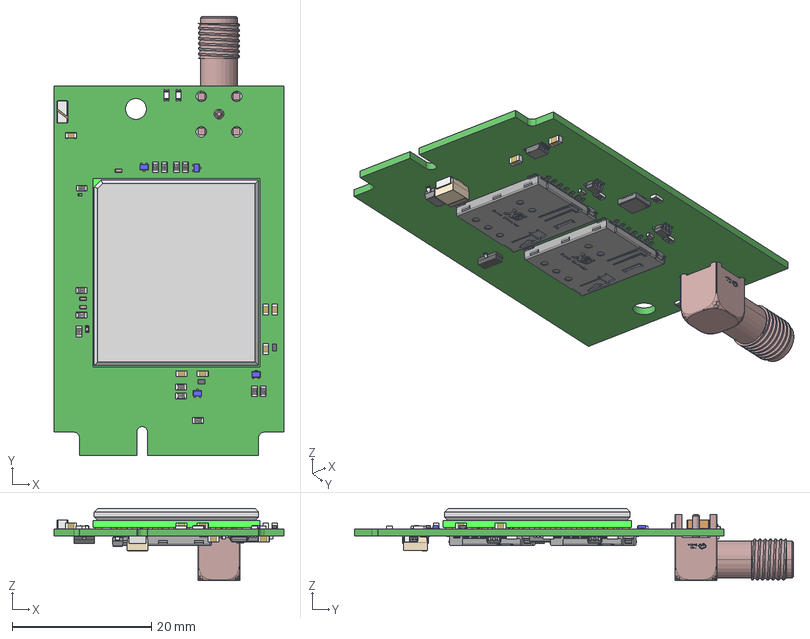
[picture p32: CAD file, 2024-01-11]
Design Files/LTE-Module-v2.0/Deliverables/Supporting_Files/LTE-Module.step
33.0 x 63.0 x 10.4 mm
CircuitWorks-SOT-23
xb-xknano-113_RGB6710886 x 2
User Library-sot363 x 2
SIM7500E
FSA2567MPX
User Library-CAPC1608X09 x 8
User Library-RESC1608X05N x 18
PESD5V0H1BSF
COMPOUND.step.STEP
Ant_PulseLarsen_Antennas_W3011A_eec x 10
PCA9306DCUR
VESM x 4
User Library-LED SMD0603 x 2
SOD882 body x 2
SOD882A3 singulated LF unit x 2
1N5819HW-7-F--3DModel-STEP-56544
User Library-Capacitor 0402 x 6
TAJB_AVX
