eSpark-Backup/chrisbyrd-esp32iotproduct/Design Files/OLED-v2.1/Deliverables/Supporting Files/OLED_v2.0.step

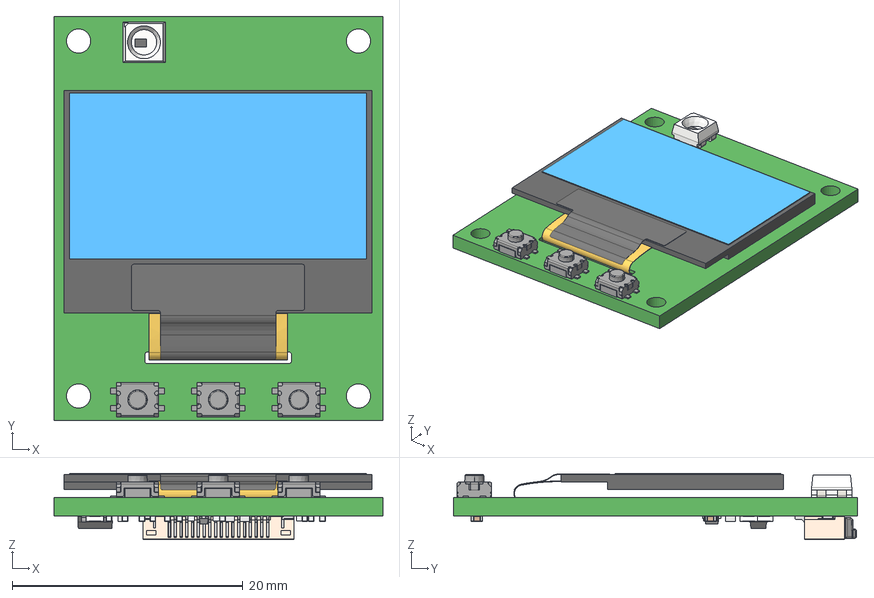
[picture p33: CAD file, 2024-01-11]
Design Files/OLED-v2.1/Deliverables/Supporting Files/OLED_v2.0.step
28.5 x 35.0 x 5.73 mm
ts-1185ec-c-d-b_RGB6710886 x 3
User_Library-RESC1608X05N x 4
User_Library-RES_1005-0402 x 3
CircuitWorks-SOT-23
lcd_curve_ribbon
SMD_WS2812B_Mini
COMPOUND.step
User_Library-SOD-523F
User_Library-Capacitor_0402 x 10
