eSpark-Backup/chrisbyrd-esp32iotproduct/(list of files, cad)

Other CAD files:
Design Files/Baseboard-v2.1/Deliverables/Supporting Files/Baseboard-v2.0.DWG
Design Files/Adv-OLED-v2.1/Deliverables/Supporting Files/Adv-OLED_v2.0.DWG
Design Files/Adv-OLED-v2.1/Deliverables/Supporting Files/Adv-OLED_v2.0.DXF
Design Files/EthPoE-Module-v2.0/Deliverables/Supporting_Files/Eth_PoE.DWG
Design Files/EthPoE-Module-v2.0/Deliverables/Supporting_Files/Eth_PoE.DXF
Design Files/Ethernet-Module-v2.0/Deliverables/Supporting_Files/Ethernet-Module.DWG
Design Files/Ethernet-Module-v2.0/Deliverables/Supporting_Files/Ethernet-Module.DXF
Design Files/LTE-Module-v2.0/Deliverables/Supporting_Files/LTE-Module.DWG
Design Files/LTE-Module-v2.0/Deliverables/Supporting_Files/LTE-Module.DXF
Design Files/LoRaWAN-Module-v2.0/Deliverables/Supporting_Files/LoRaWAN_v2.0.DWG
Design Files/LoRaWAN-Module-v2.0/Deliverables/Supporting_Files/LoRaWAN_v2.0.DXF
Design Files/OLED-v2.1/Deliverables/Supporting Files/OLED_v2.0.DWG
Design Files/OLED-v2.1/Deliverables/Supporting Files/OLED_v2.0.DXF
