eSpark-Backup/chrisbyrd-esp32iotproduct/Design Files/Baseboard-v2.1/Deliverables/Schematics/Baseboard-v2.0.pdf

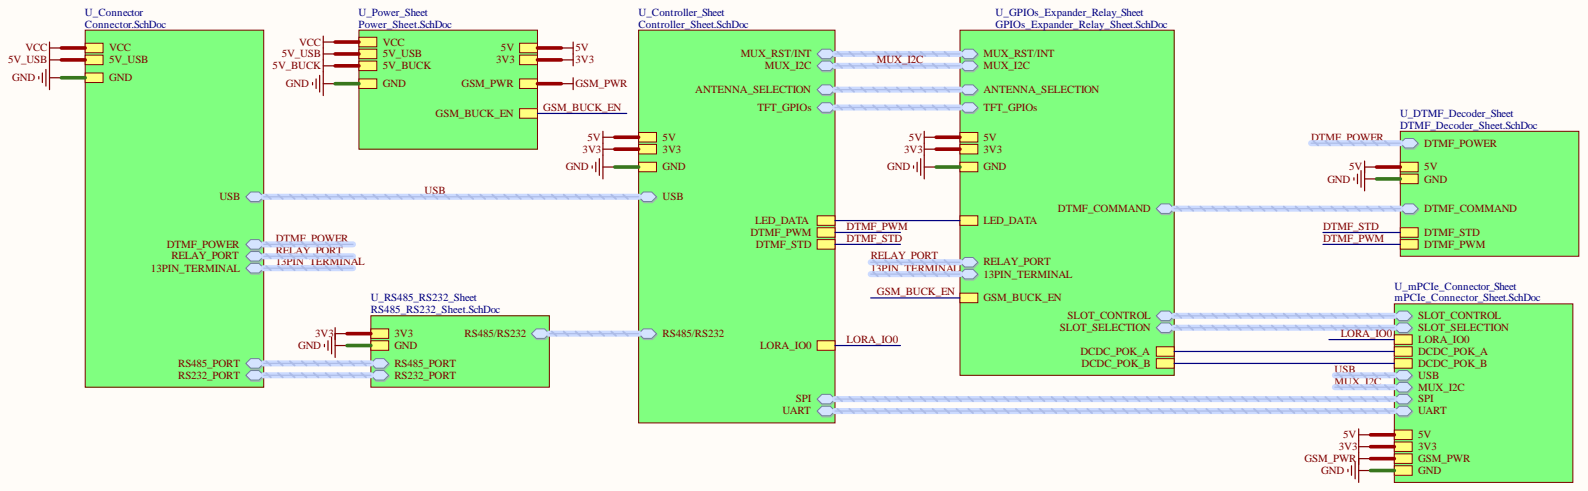
[picture p34: page 1]

Date: 2/13/2024 | Page Num: 1

Drawn By: Huzaifa Ali | Page Total: 8

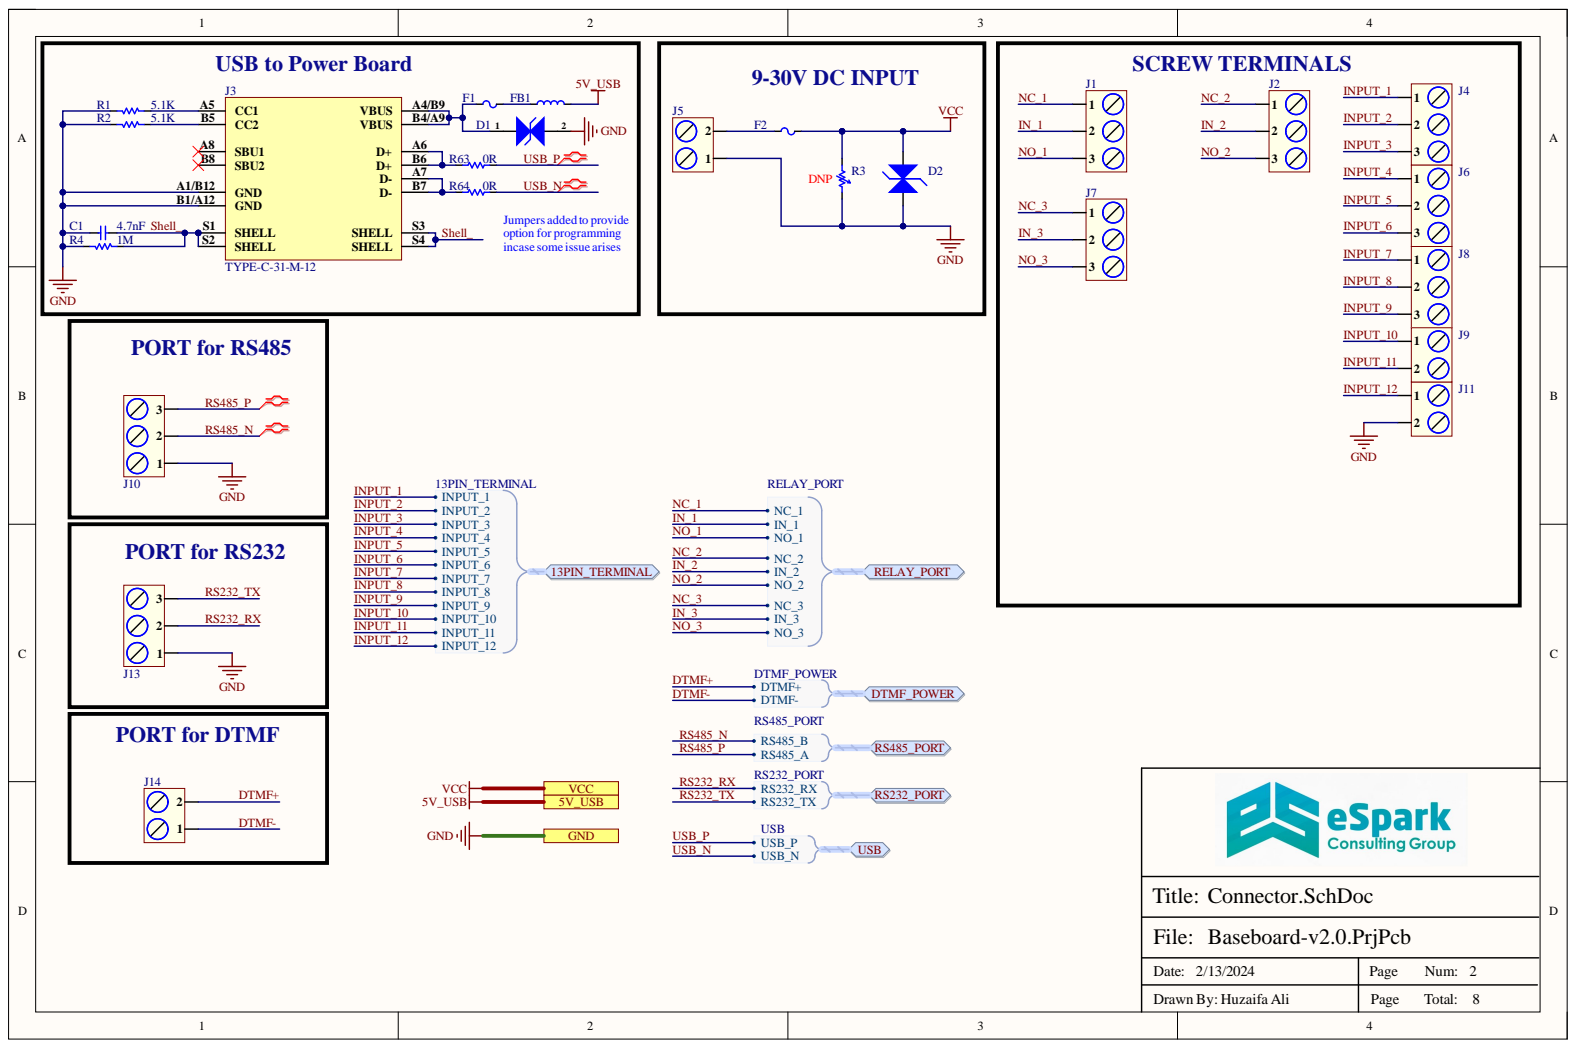
[picture p35: page 2]

Dat e : 2 / 1 3 / 2 0 2 4 | Pag e N u m : 28

D raw n B y : H uzai fa A l i | Pag e To t al :

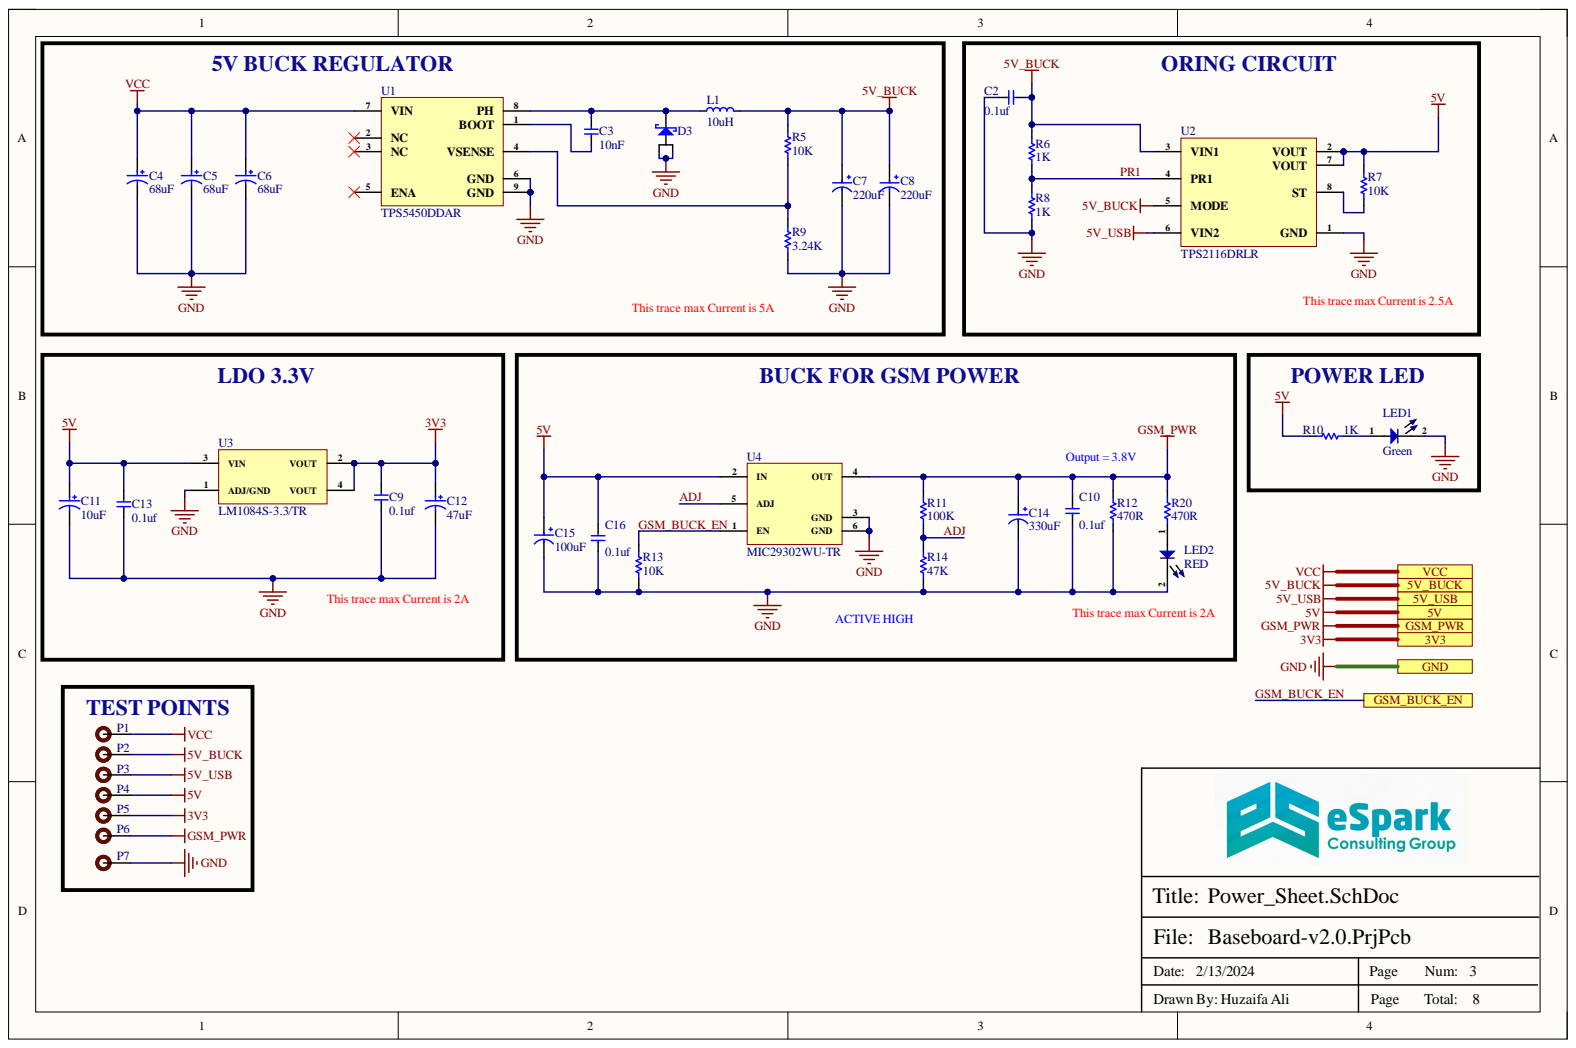
[picture p36: page 3]

This trace max Current is 5A

This trace max Current is 2.5A

BUCK FOR GSM POWER

This trace max Current is 2A

This trace max Current is 2A ACTIVE HIGH

Date: 2/13/2024 | Page Num: 3

Drawn By: Huzaifa Ali | Page Total: 8

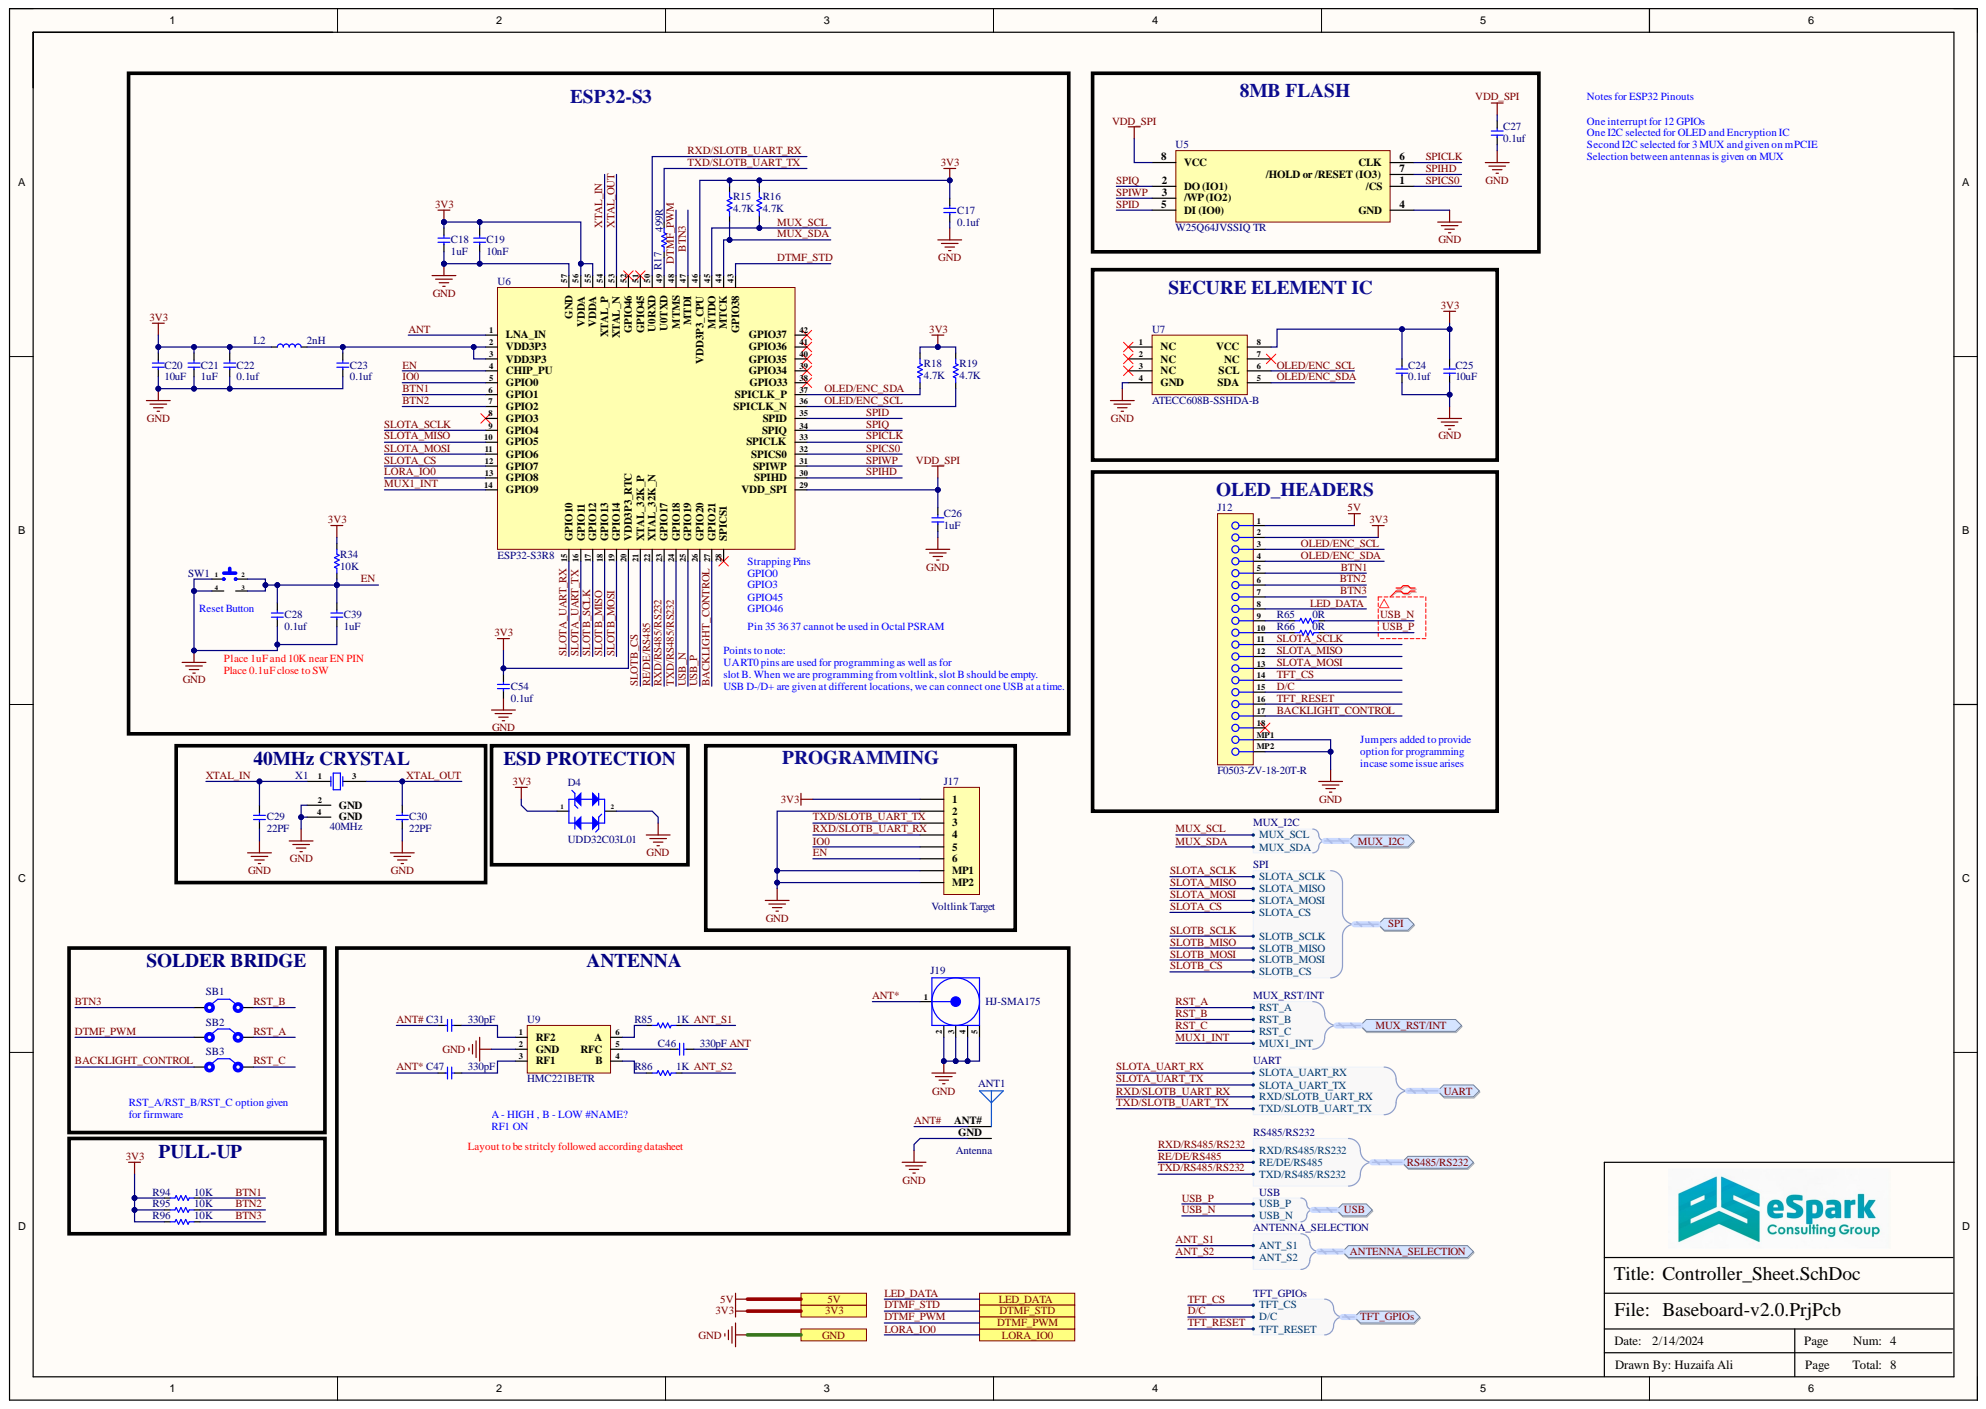
[picture p37: page 4]

One interrupt for 12 GPIOs
One I2C selected for OLED and Encryption IC
Second I2C selected for 3 MUX and given on mPCIE
Selection between antennas is given on MUX

42 PIO38 43 MTCK 44 MTDO 45 VDD3P3_CPU 46 MTDI 47 MTMS 48 U0TXD 49 U0RXD 50 GPIO45 51 GPIO46 52 XTAL_N 53 XTAL_P 54 VDDA 55 VDDA 56 GND 57

Points to note:
UART0 pins are used for programming as well as for
slot B. When we are programming from voltlink,slot B should be empty.
USB D-/D+ are given at different locations, we can connect one USB at a time.

Place 1uF and 10K near EN PIN
Place 0.1uF close to SW

Jumpers added to provide
option for programming
incase some issue arises

Layout to be stritcly followed according datasheet

Date: 2/14/2024 | Page Num: 4

Drawn By: Huzaifa Ali | Page Total: 8

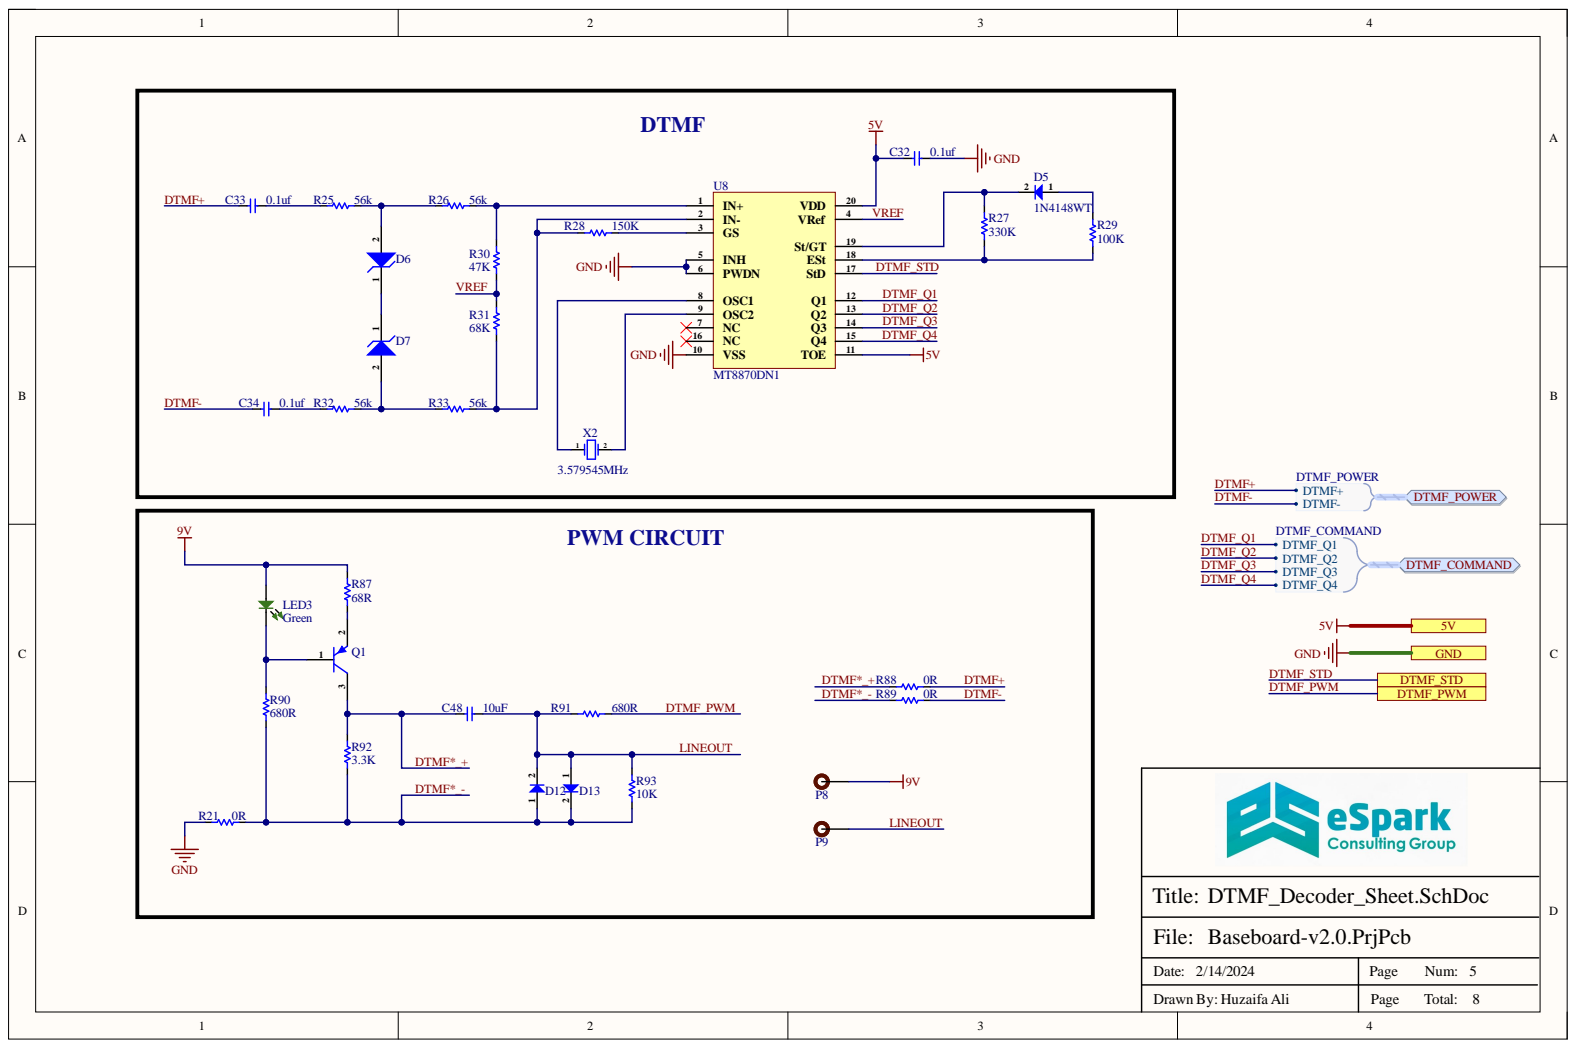
[picture p38: page 5]

Dat e : 2 / 1 4 / 2 0 2 4 | Pag e N u m :

D raw n B y : H uzai fa A l i | Pag e To t al :

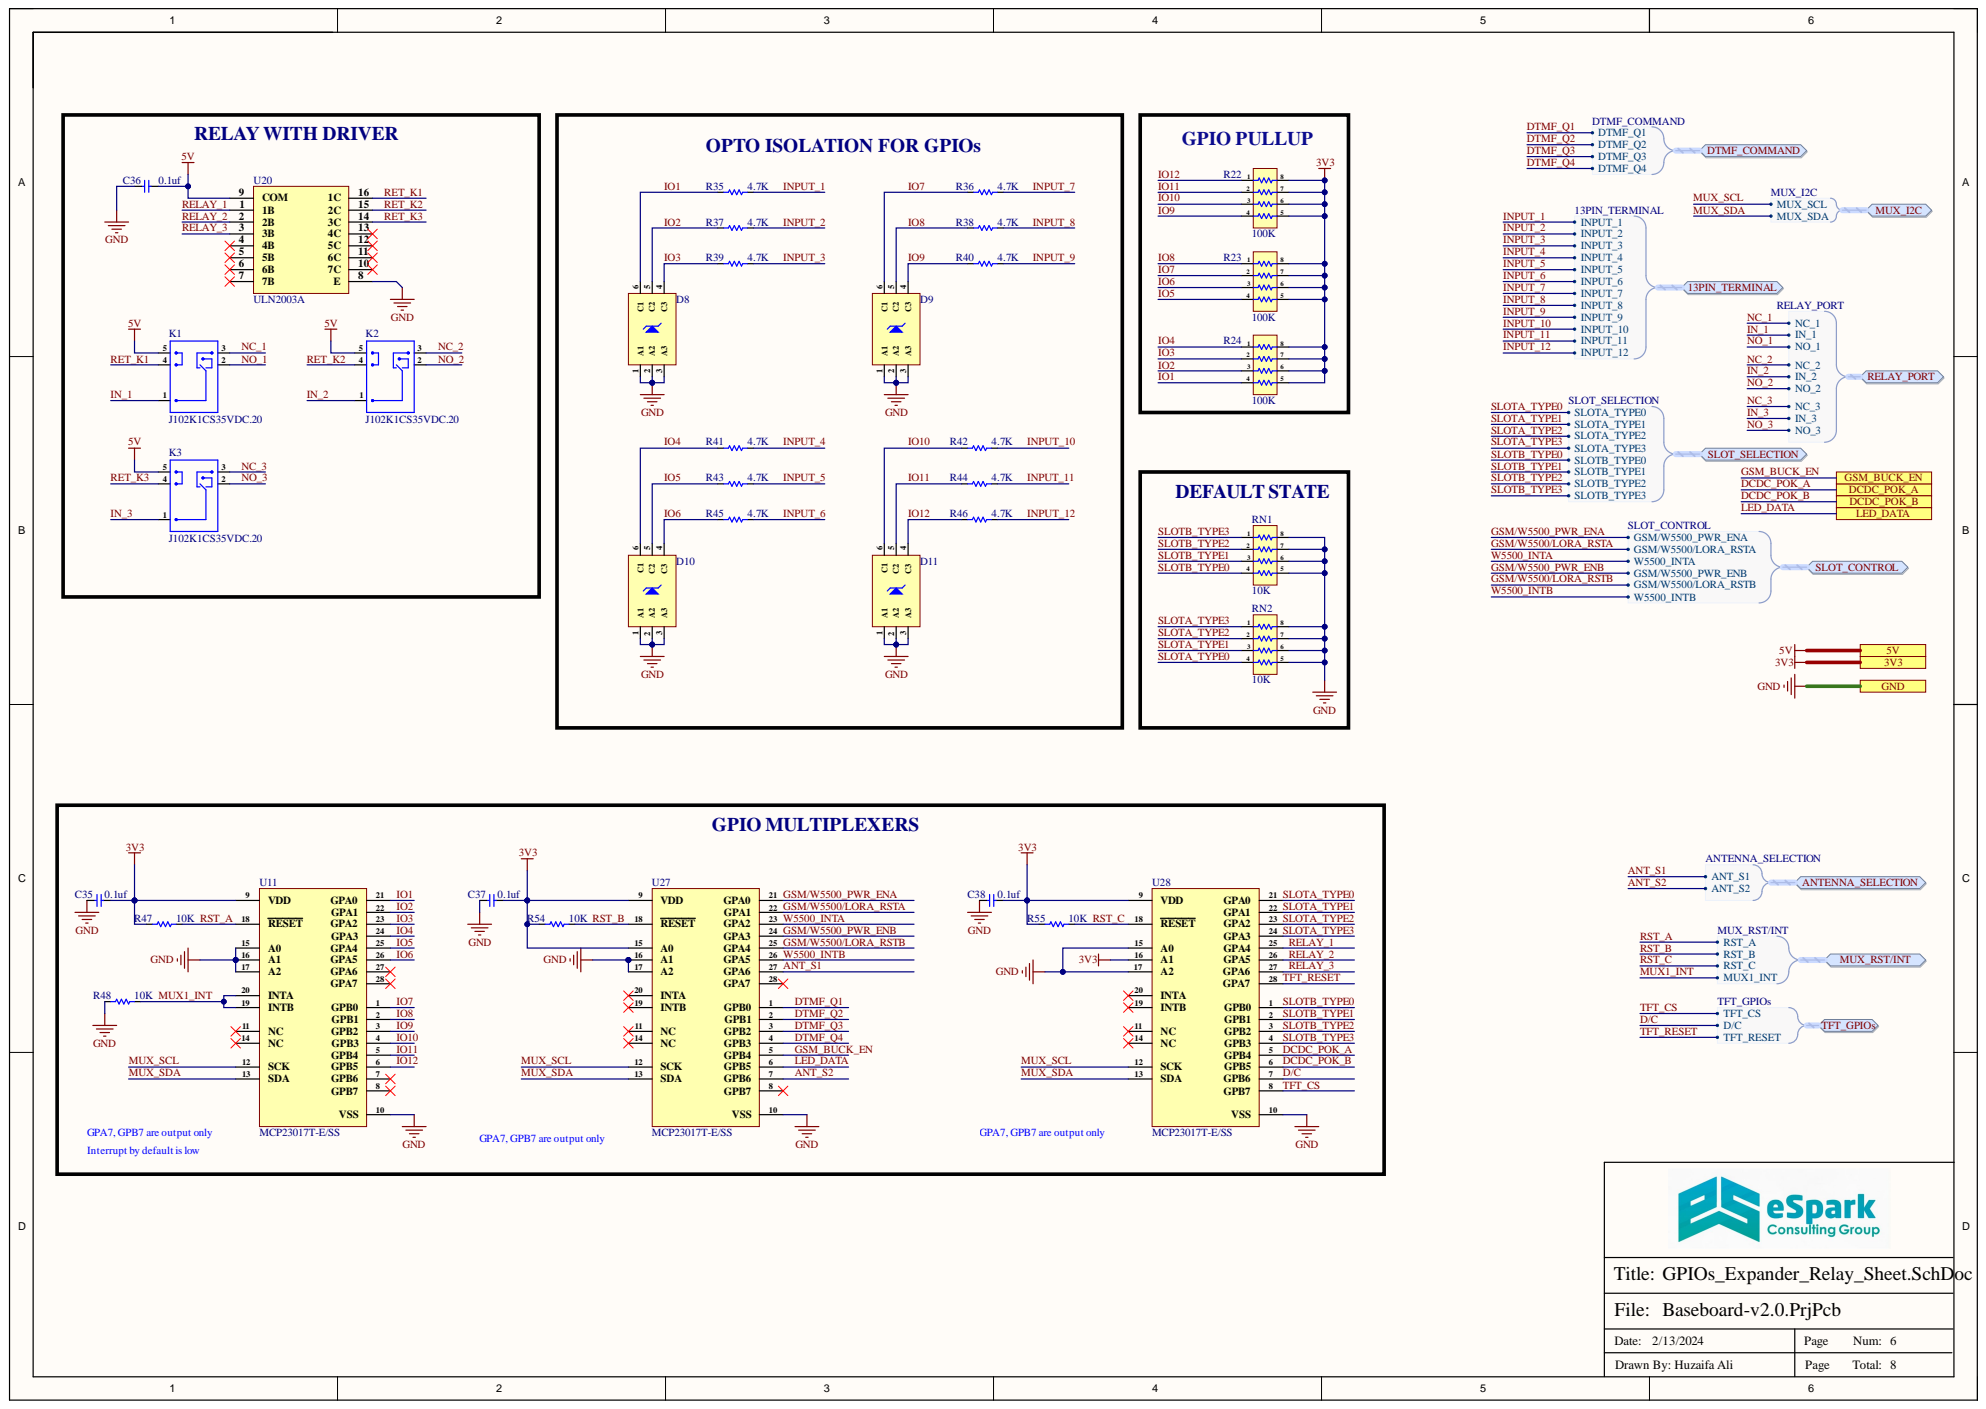
[picture p39: page 6]

OPTO ISOLATION FOR GPIOs

GPA7, GPB7 are output only
Interrupt by default is low

Date: 2/13/2024 | Page Num: 6

Drawn By: Huzaifa Ali | Page Total: 8

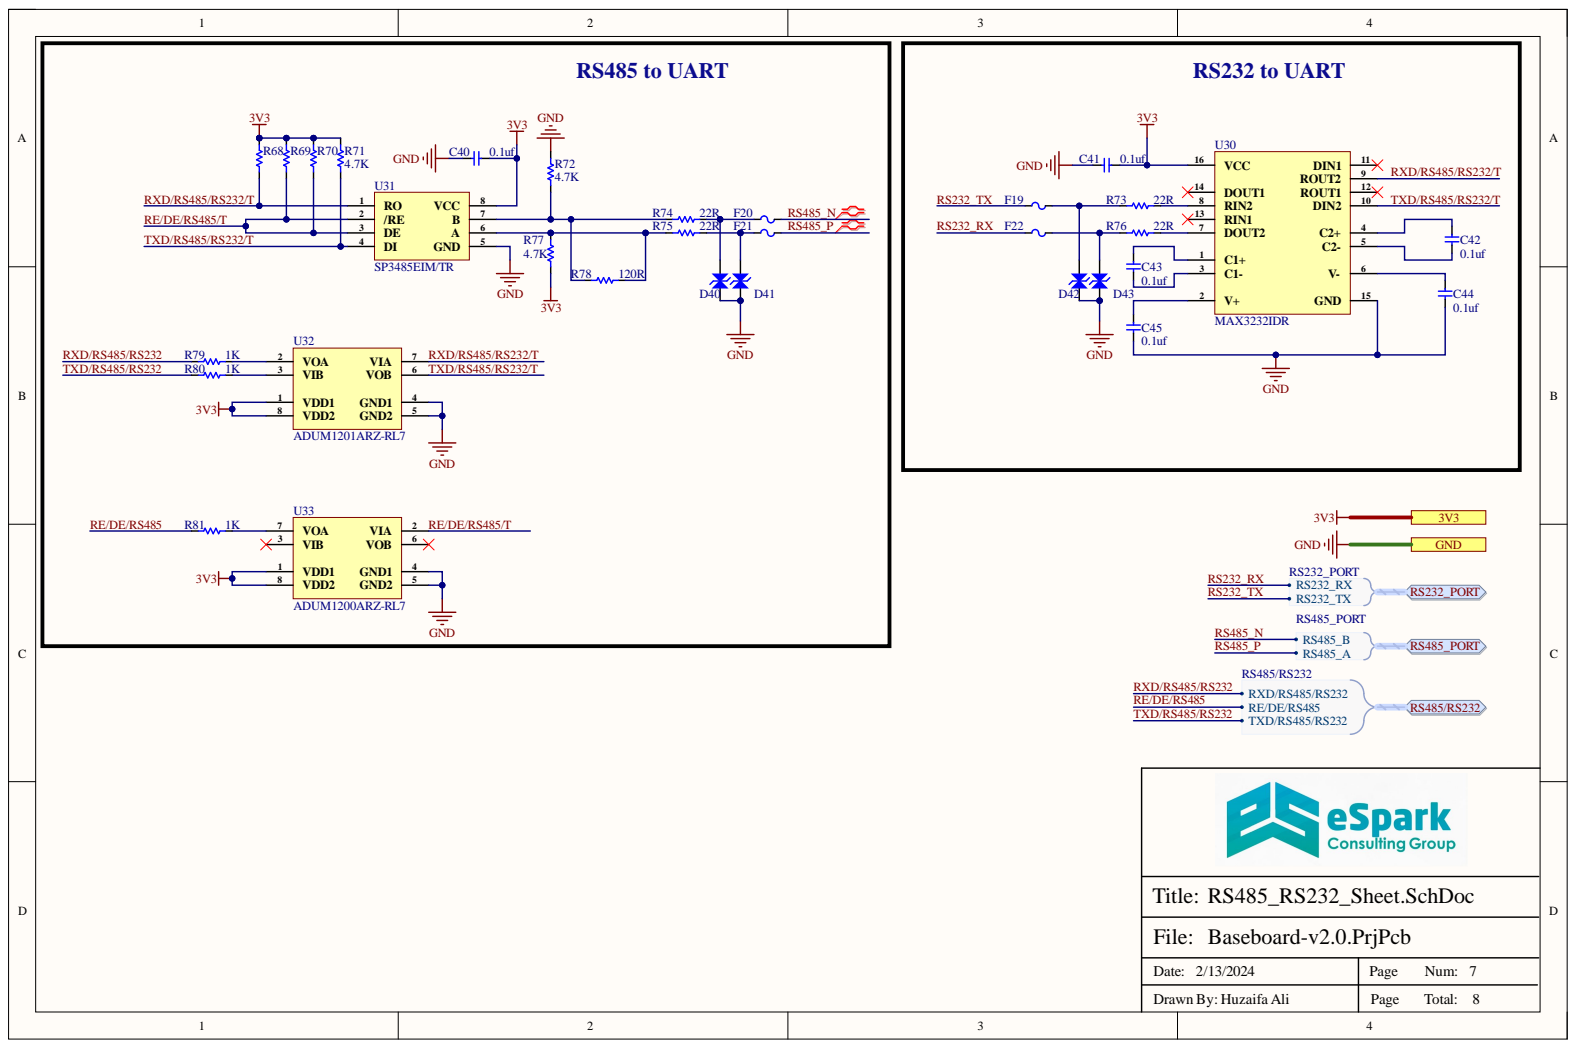
[picture p40: page 7]

Date: 2/13/2024 | Page Num: 7

Drawn By: Huzaifa Ali | Page Total: 8

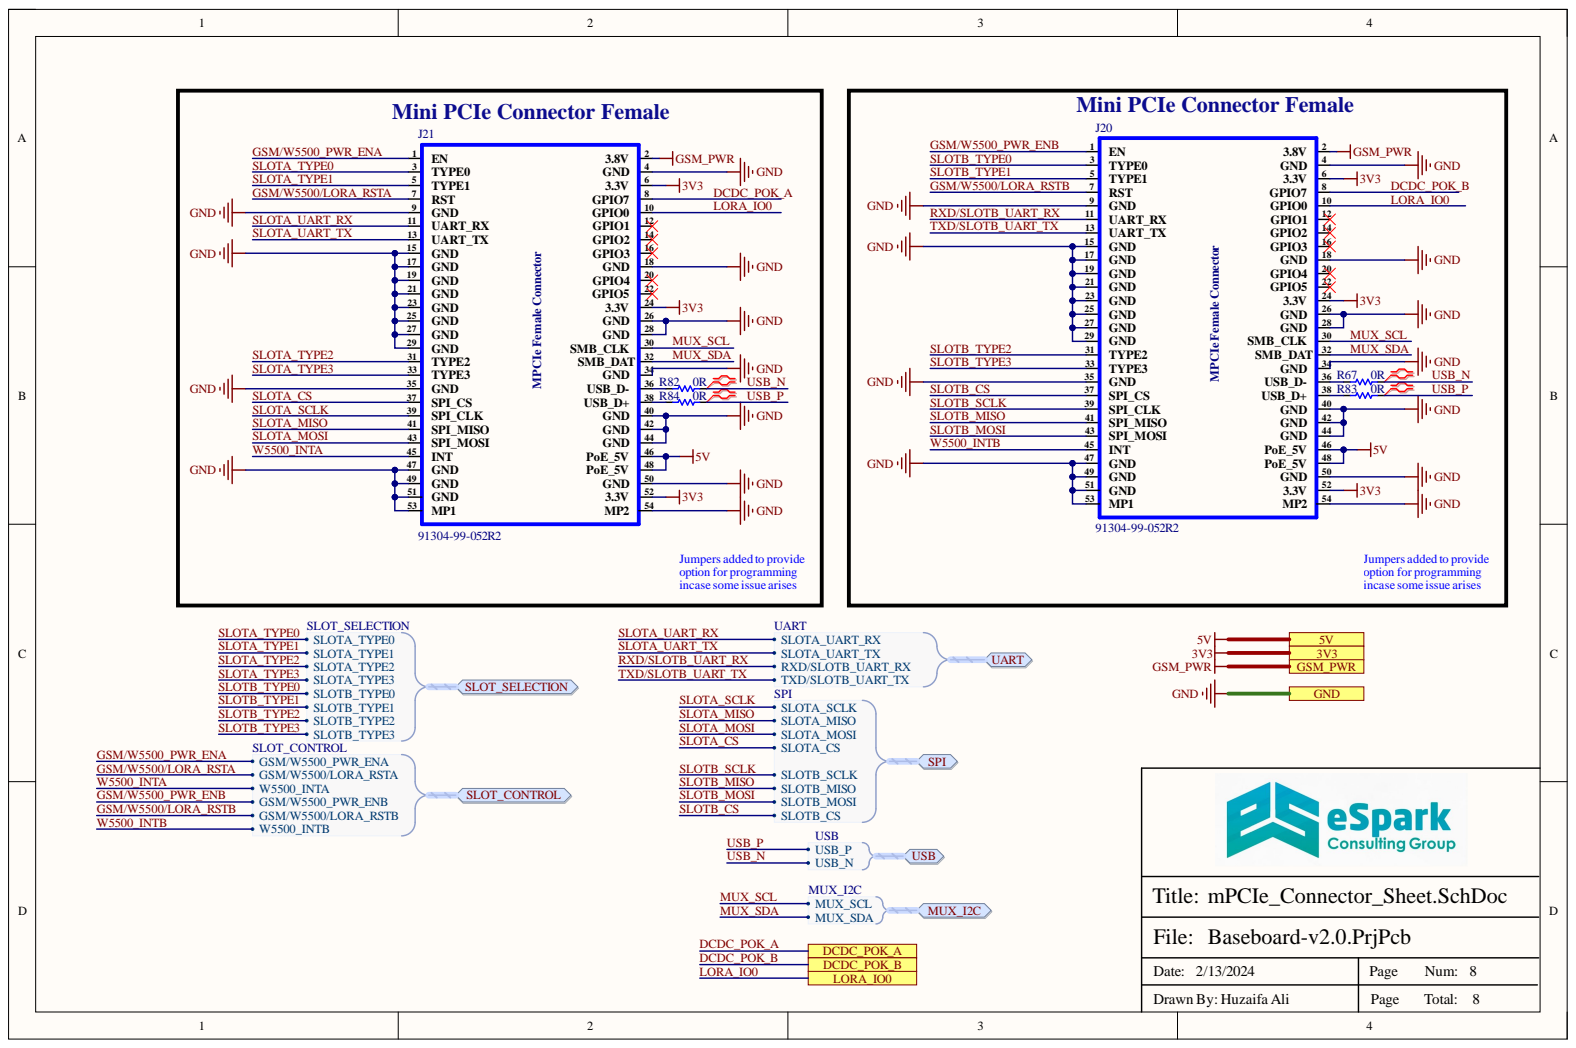
[picture p41: page 8]

Mini PCIe Connector Female

Jumpers added to provide
option for programming
incase some issue arises

Date: 2/13/2024 | Page Num: 8

Drawn By: Huzaifa Ali | Page Total: 8
