eSpark-Backup/chrisbyrd-esp32iotproduct/Design Files/Ethernet-Module-v2.0/Deliverables/Schematics/Ethernet-Module-v2.0.pdf

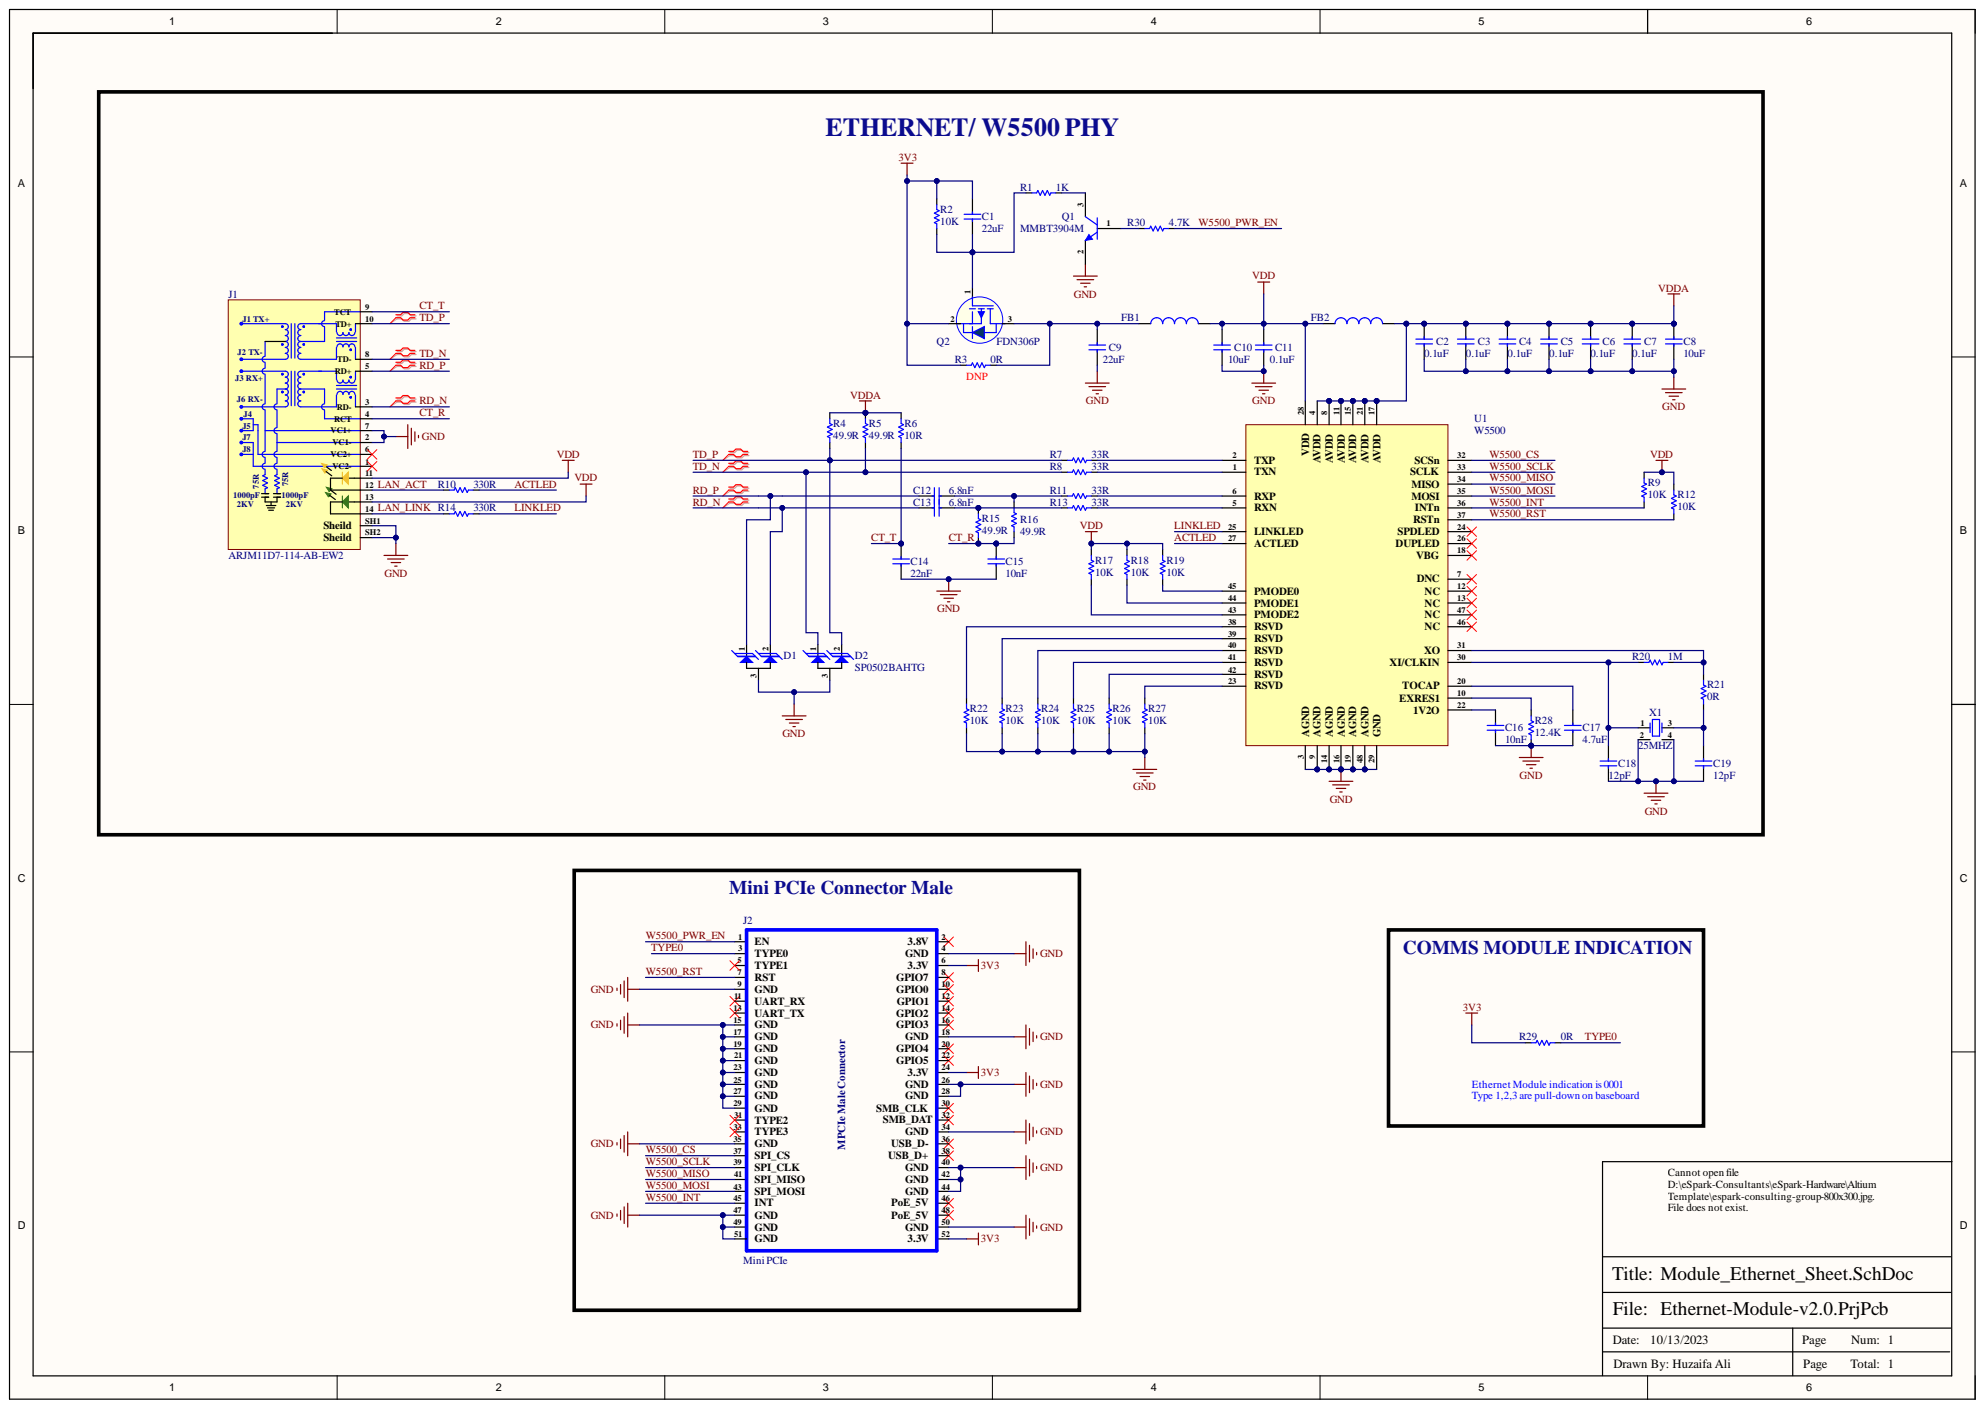
[picture p42: page 1]

Mini PCIe Connector Male

Ethernet Module indication is 0001
Type 1,2,3 are pull-down on baseboard

Cannot open file
D:\eSpark-Consultants\eSpark-Hardware\Altium
Template\espark-consulting-group-800x300.jpg.
File does not exist.

Date: 10/13/2023 | Page Num: 1

Drawn By: Huzaifa Ali | Page Total: 1

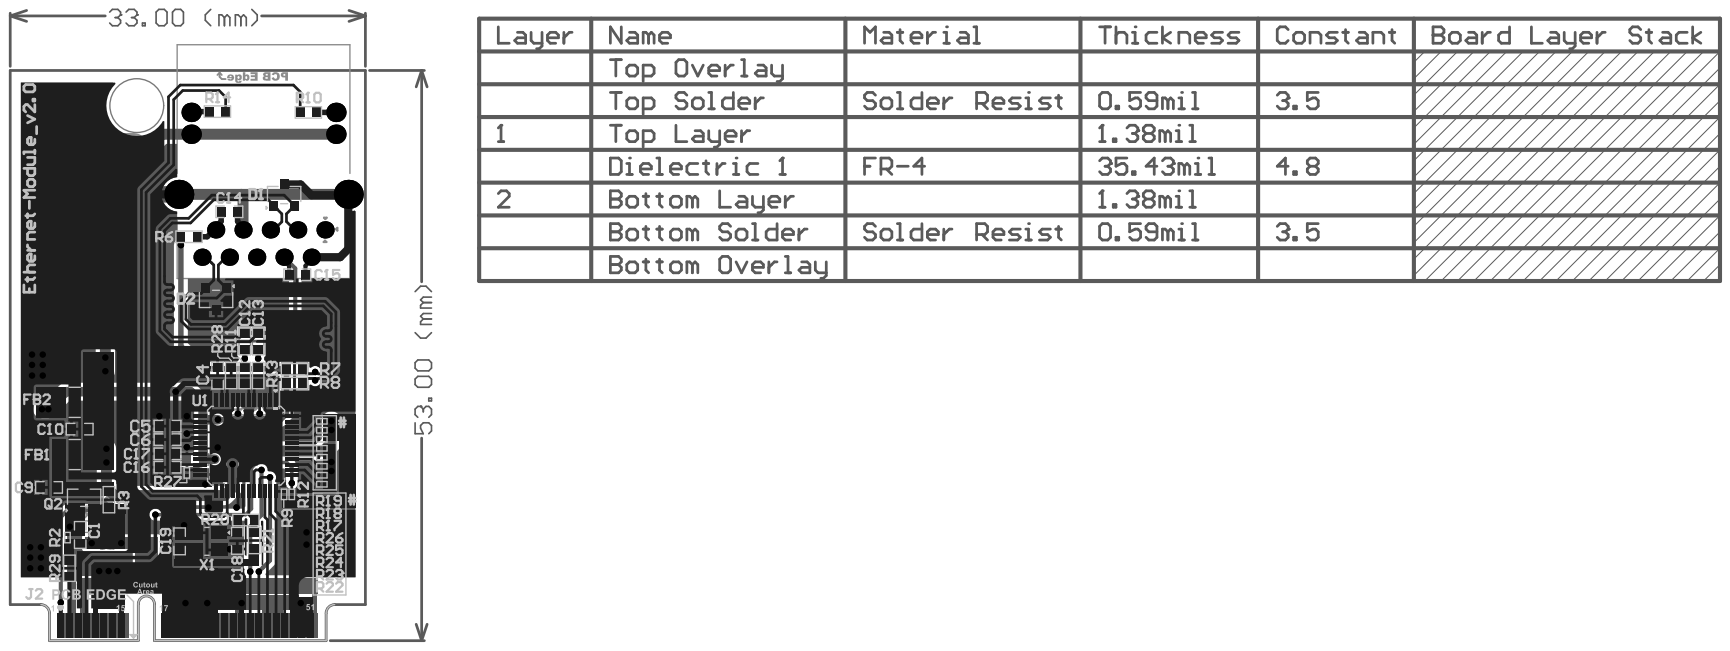
[picture p43: page 2]
