eSpark-Backup/chrisbyrd-esp32iotproduct/Design Files/LTE-Module-v2.0/Deliverables/Schematics/LTE_MODULE_v2.0.pdf

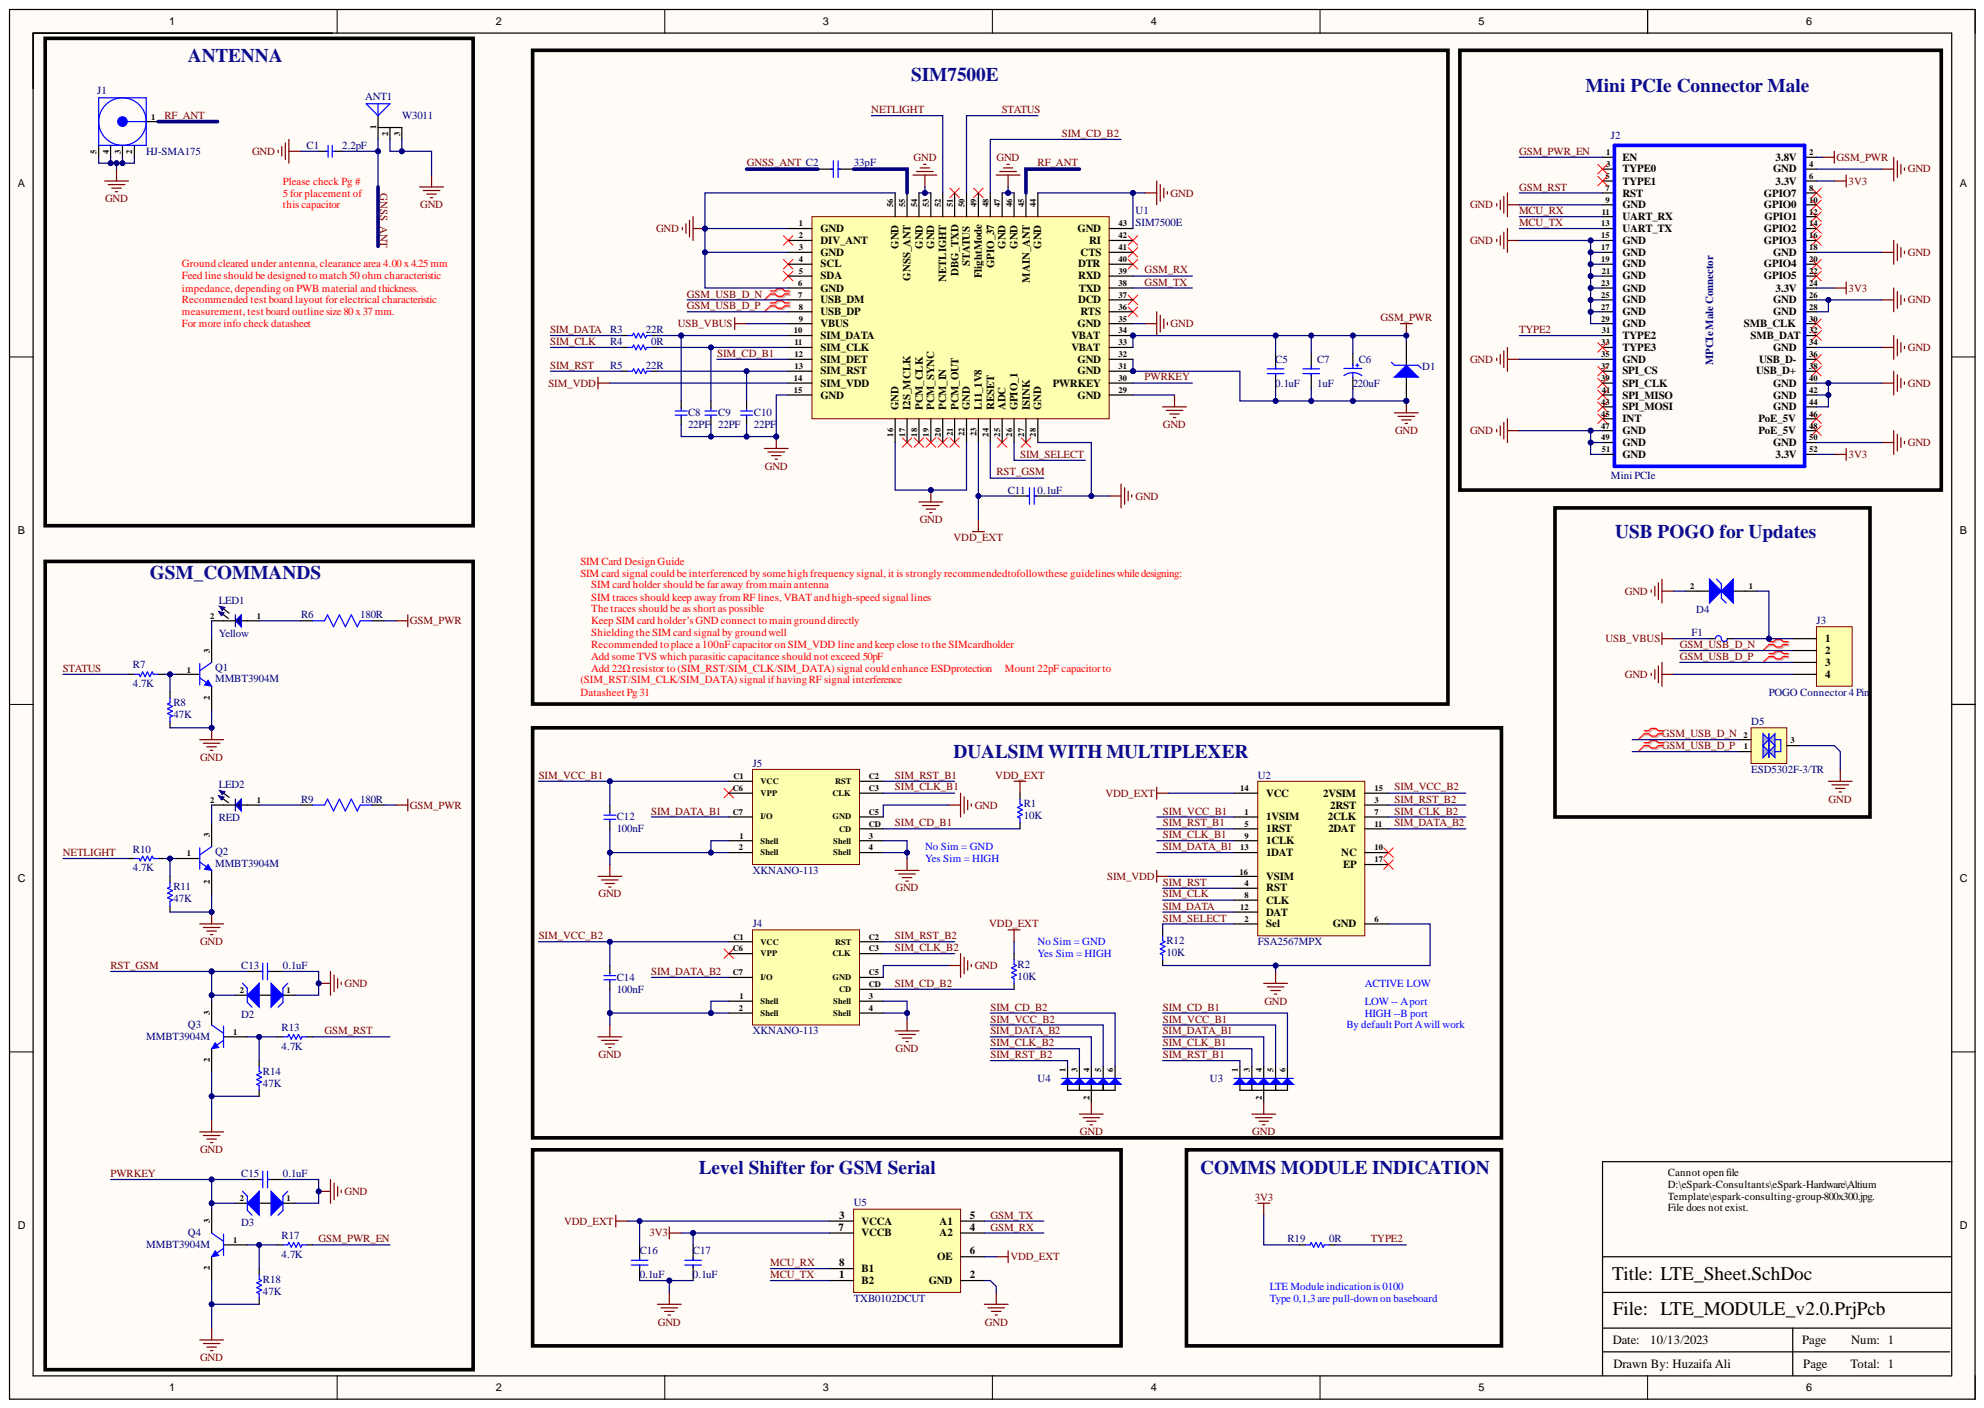
[picture p44: page 1]

Mini PCIe Connector Male

GND 44 MAIN_ANT 45 GND 46 GND 47 GPIO_37 48 FlightMode 49 STATUS 50 DBG_TXD 51 NETLIGHT 52 GND 53 GND 54 GNSS_ANT 55 GND 56

Ground cleared under antenna, clearance area 4.00 x 4.25 mm
Feed line should be designed to match 50 ohm characteristic
impedance, depending on PWB material and thickness.
Recommended test board layout for electrical characteristic
measurement, test board outline size 80 x 37 mm.
For more info check datasheet

USB POGO for Updates

SIM Card Design Guide
SIM card signal could be interferenced by some high frequency signal, it is strongly recommendedtofollowthese guidelines while designing:
SIM card holder should be far away from main antenna
SIM traces should keep away from RF lines, VBAT and high-speed signal lines
The traces should be as short as possible
Keep SIM card holder’s GND connect to main ground directly
Shielding the SIM card signal by ground well
Recommended to place a 100nF capacitor on SIM_VDD line and keep close to the SIMcardholder
Add some TVS which parasitic capacitance should not exceed 50pF
(SIM_RST/SIM_CLK/SIM_DATA) signal if having RF signal interference
Datasheet Pg 31

ACTIVE LOW
LOW -- Aport
HIGH --B port
By default Port Awill work

Level Shifter for GSM Serial

Cannot open file
D:\eSpark-Consultants\eSpark-Hardware\Altium
Template\espark-consulting-group-800x300.jpg.
File does not exist.

LTE Module indication is 0100
Type 0,1,3 are pull-down on baseboard

Date: 10/13/2023 | Page Num: 1

Drawn By: Huzaifa Ali | Page Total: 1

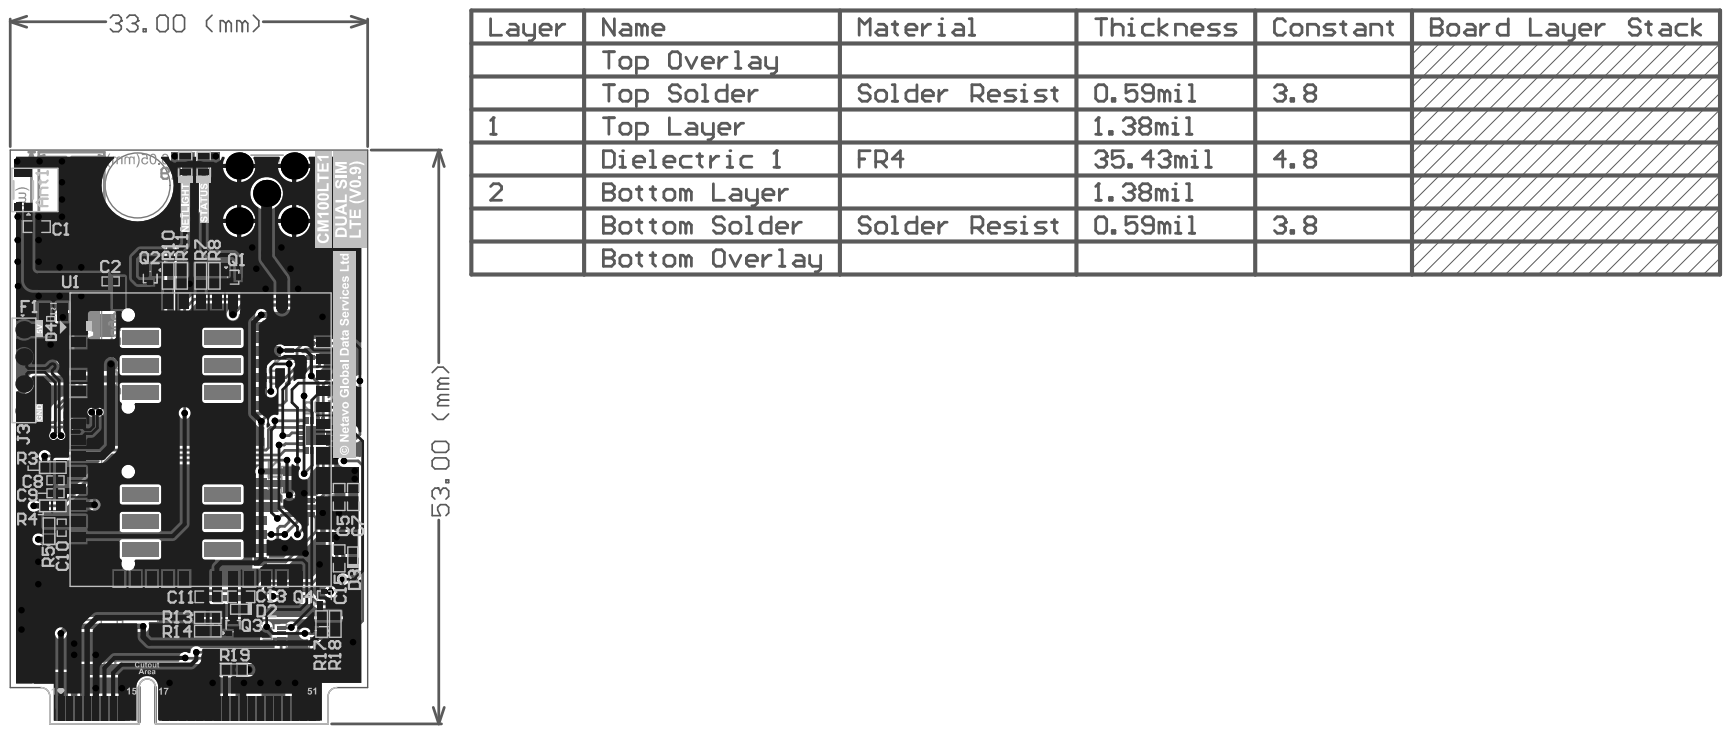
[picture p45: page 2]
