eSpark-Backup/chrisbyrd-esp32iotproduct/Design Files/Baseboard-v2.1/Deliverables/Schematics/Assembly Drawing.pdf

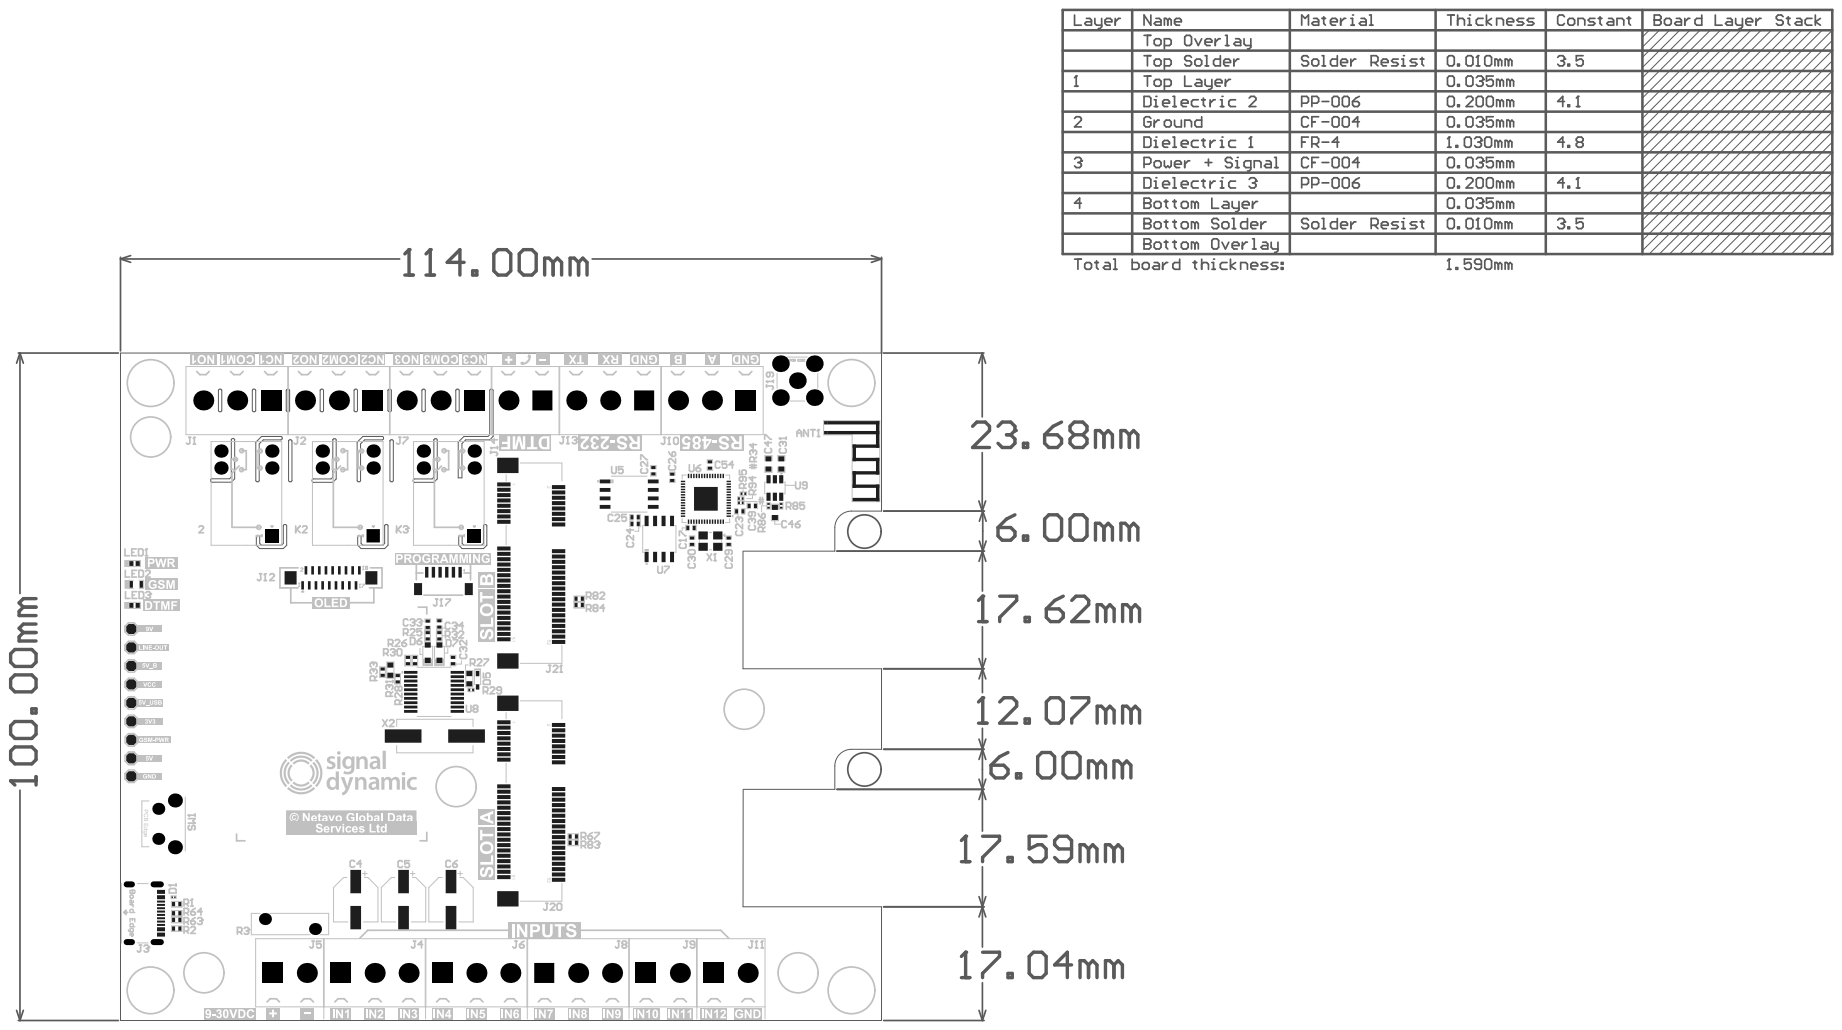
[picture p46: page 1]

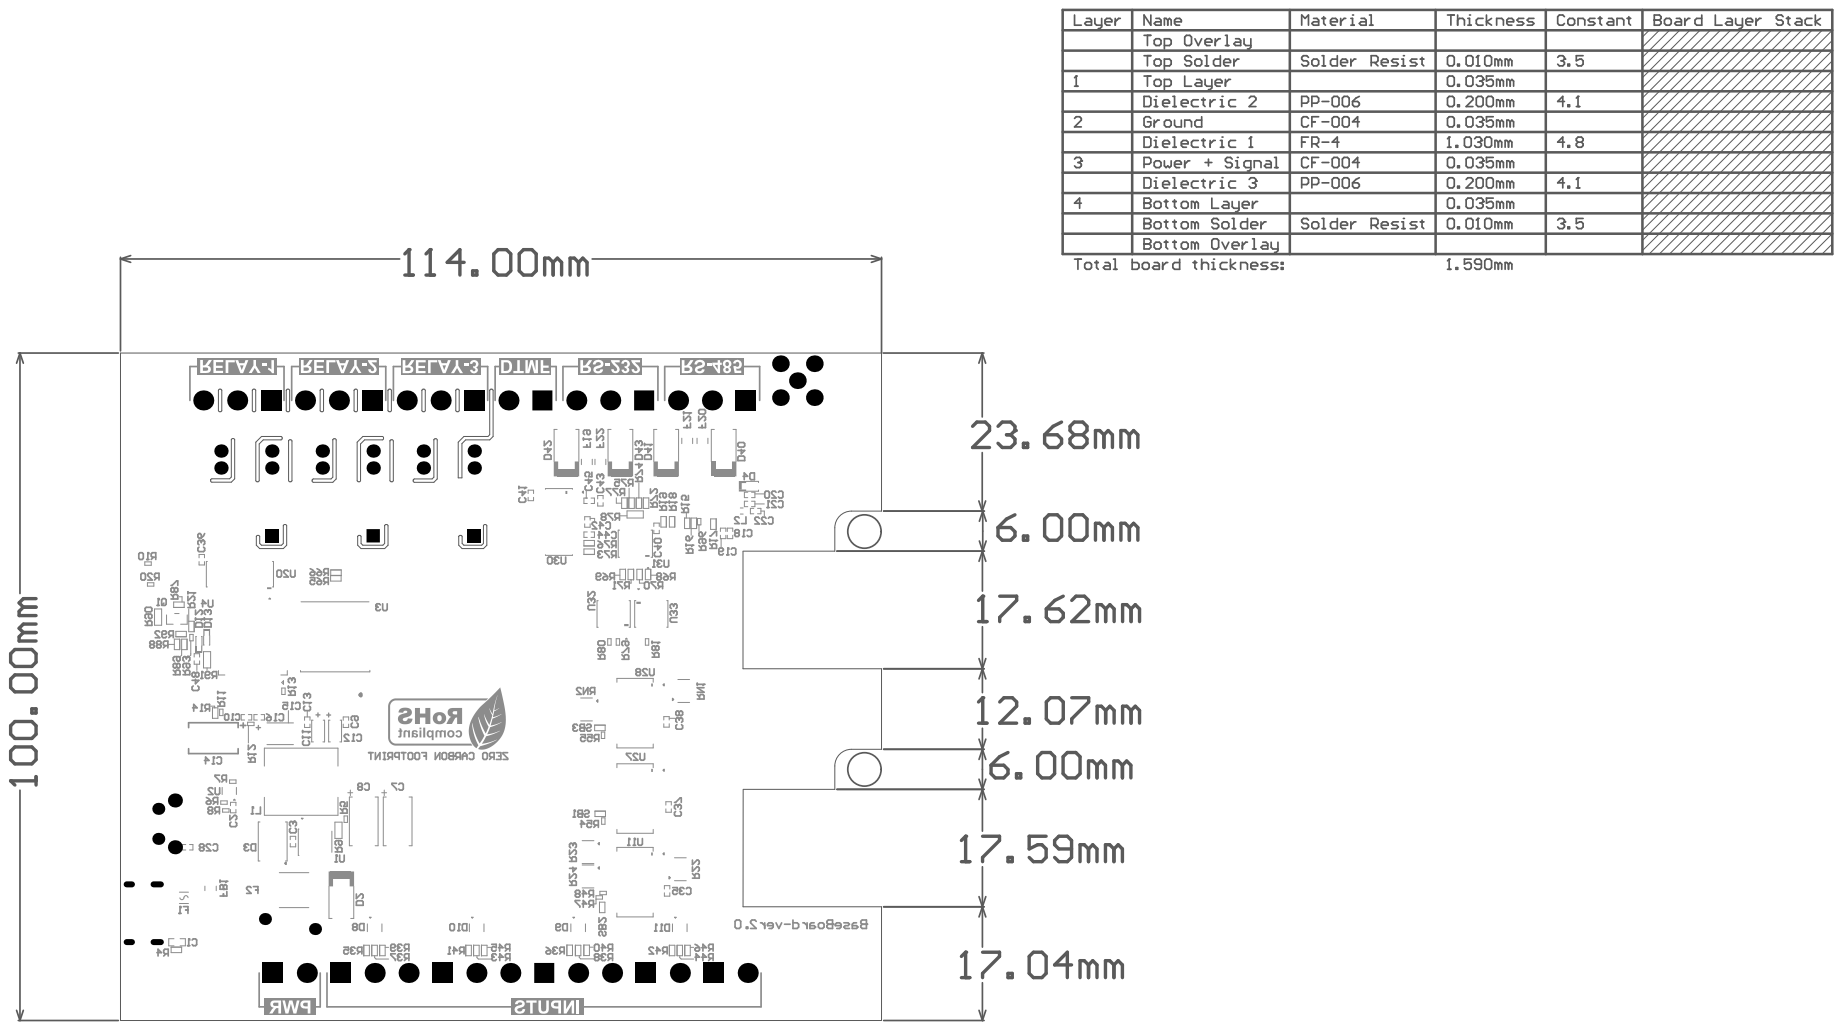
[picture p47: page 2]

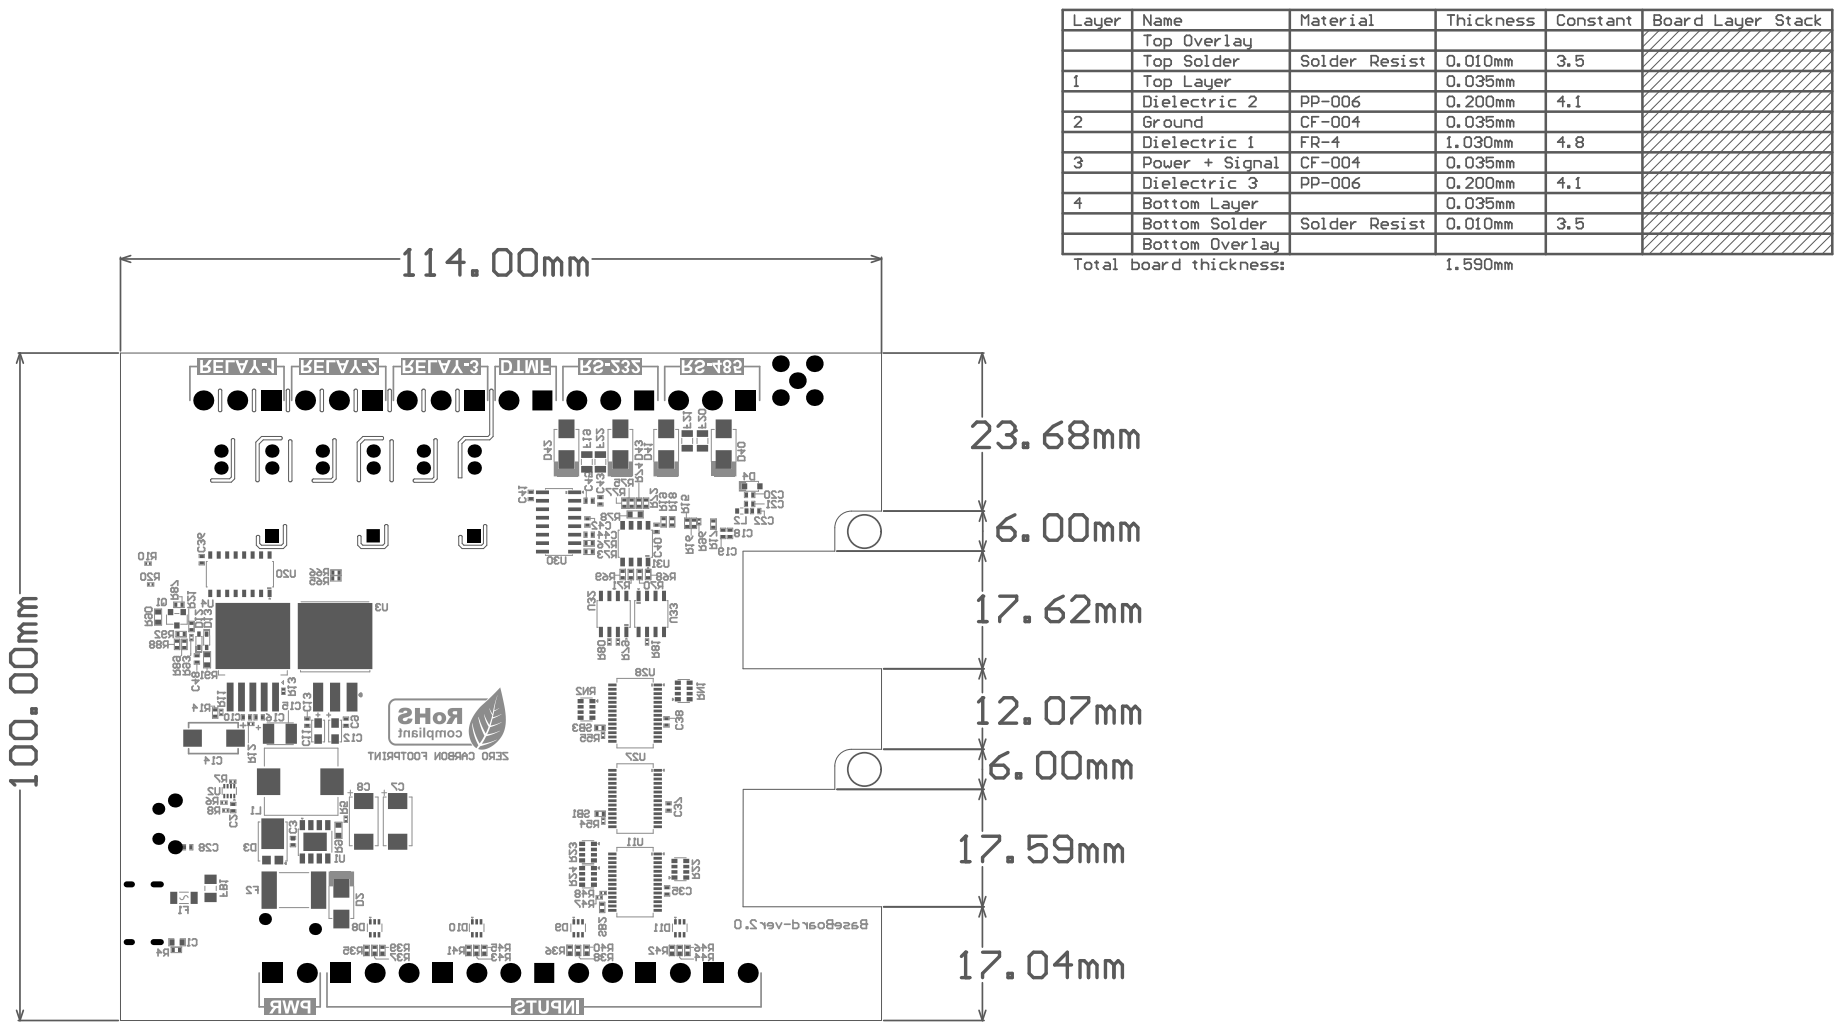
[picture p48: page 4]
