eSpark-Backup/chrisbyrd-esp32iotproduct/Design Files/Adv-OLED-v2.1/Deliverables/Schematics/Adv-OLED-v2.0.pdf

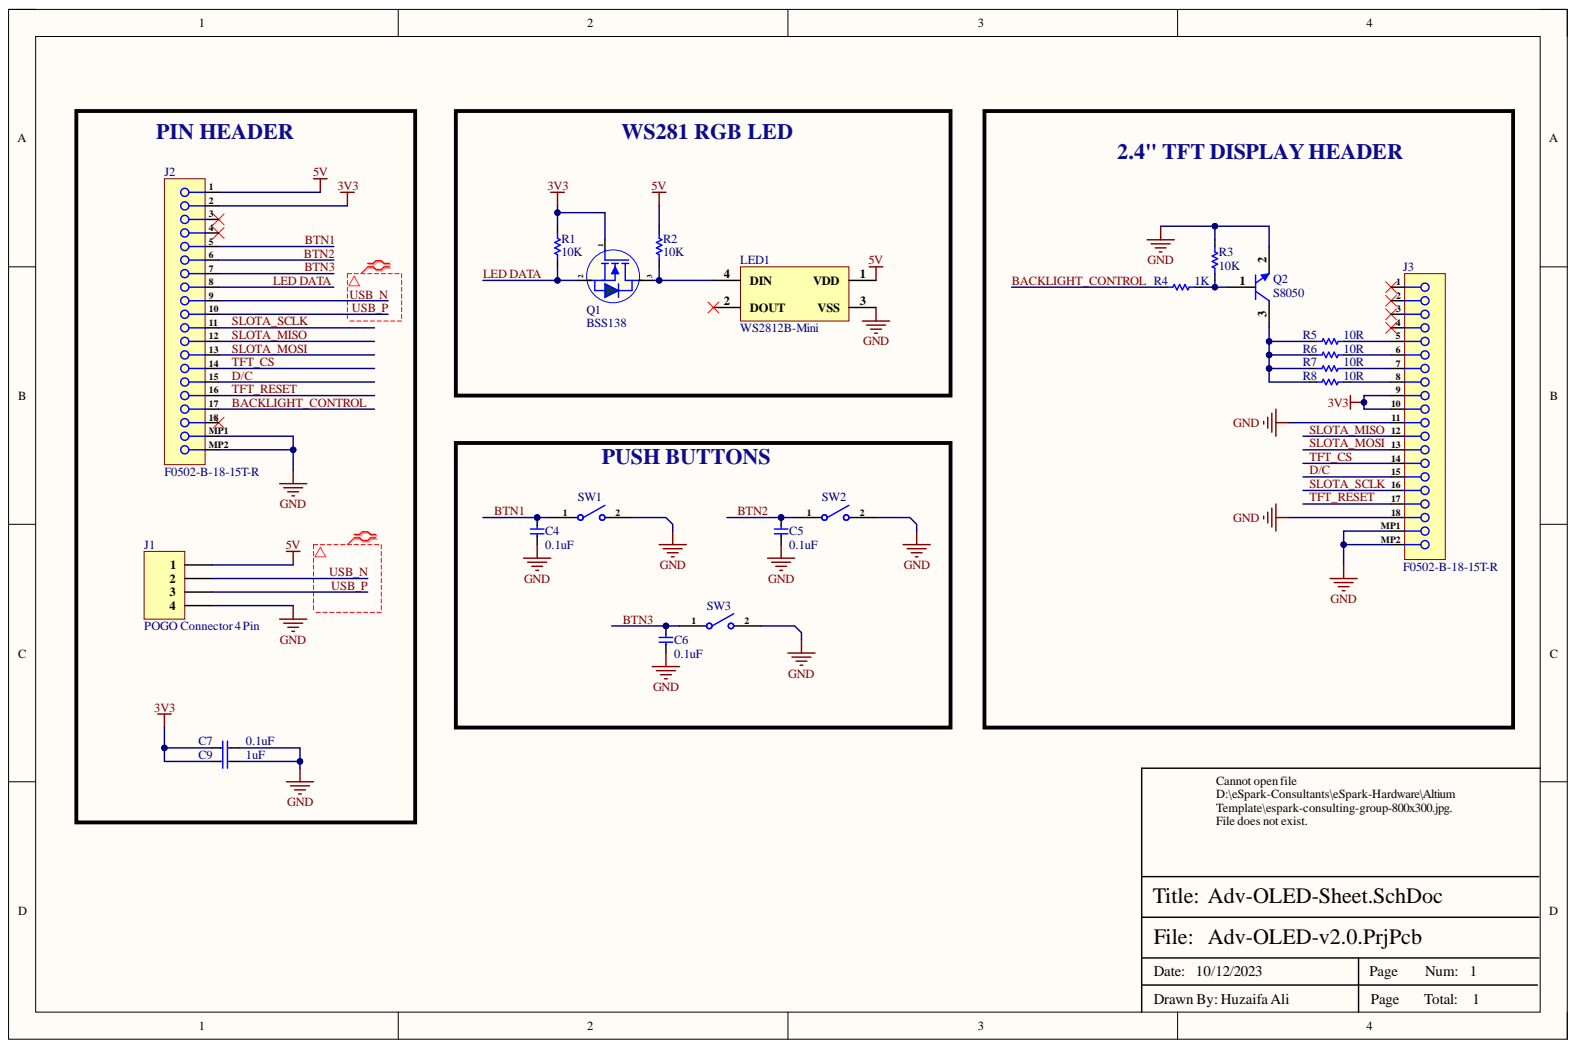
[picture p49: page 1]

Adv-OLED-Sheet.SchDoc

Dat e : 1 0 / 1 2 / 2 0 2 3 | Pag e N u m : 11

D raw n B y : H uzai fa A l i | Pag e To t al :
