eSpark-Backup/chrisbyrd-esp32iotproduct/Design Files/Adv-OLED-v2.1/Deliverables/Schematics/Assembly Drawings.pdf

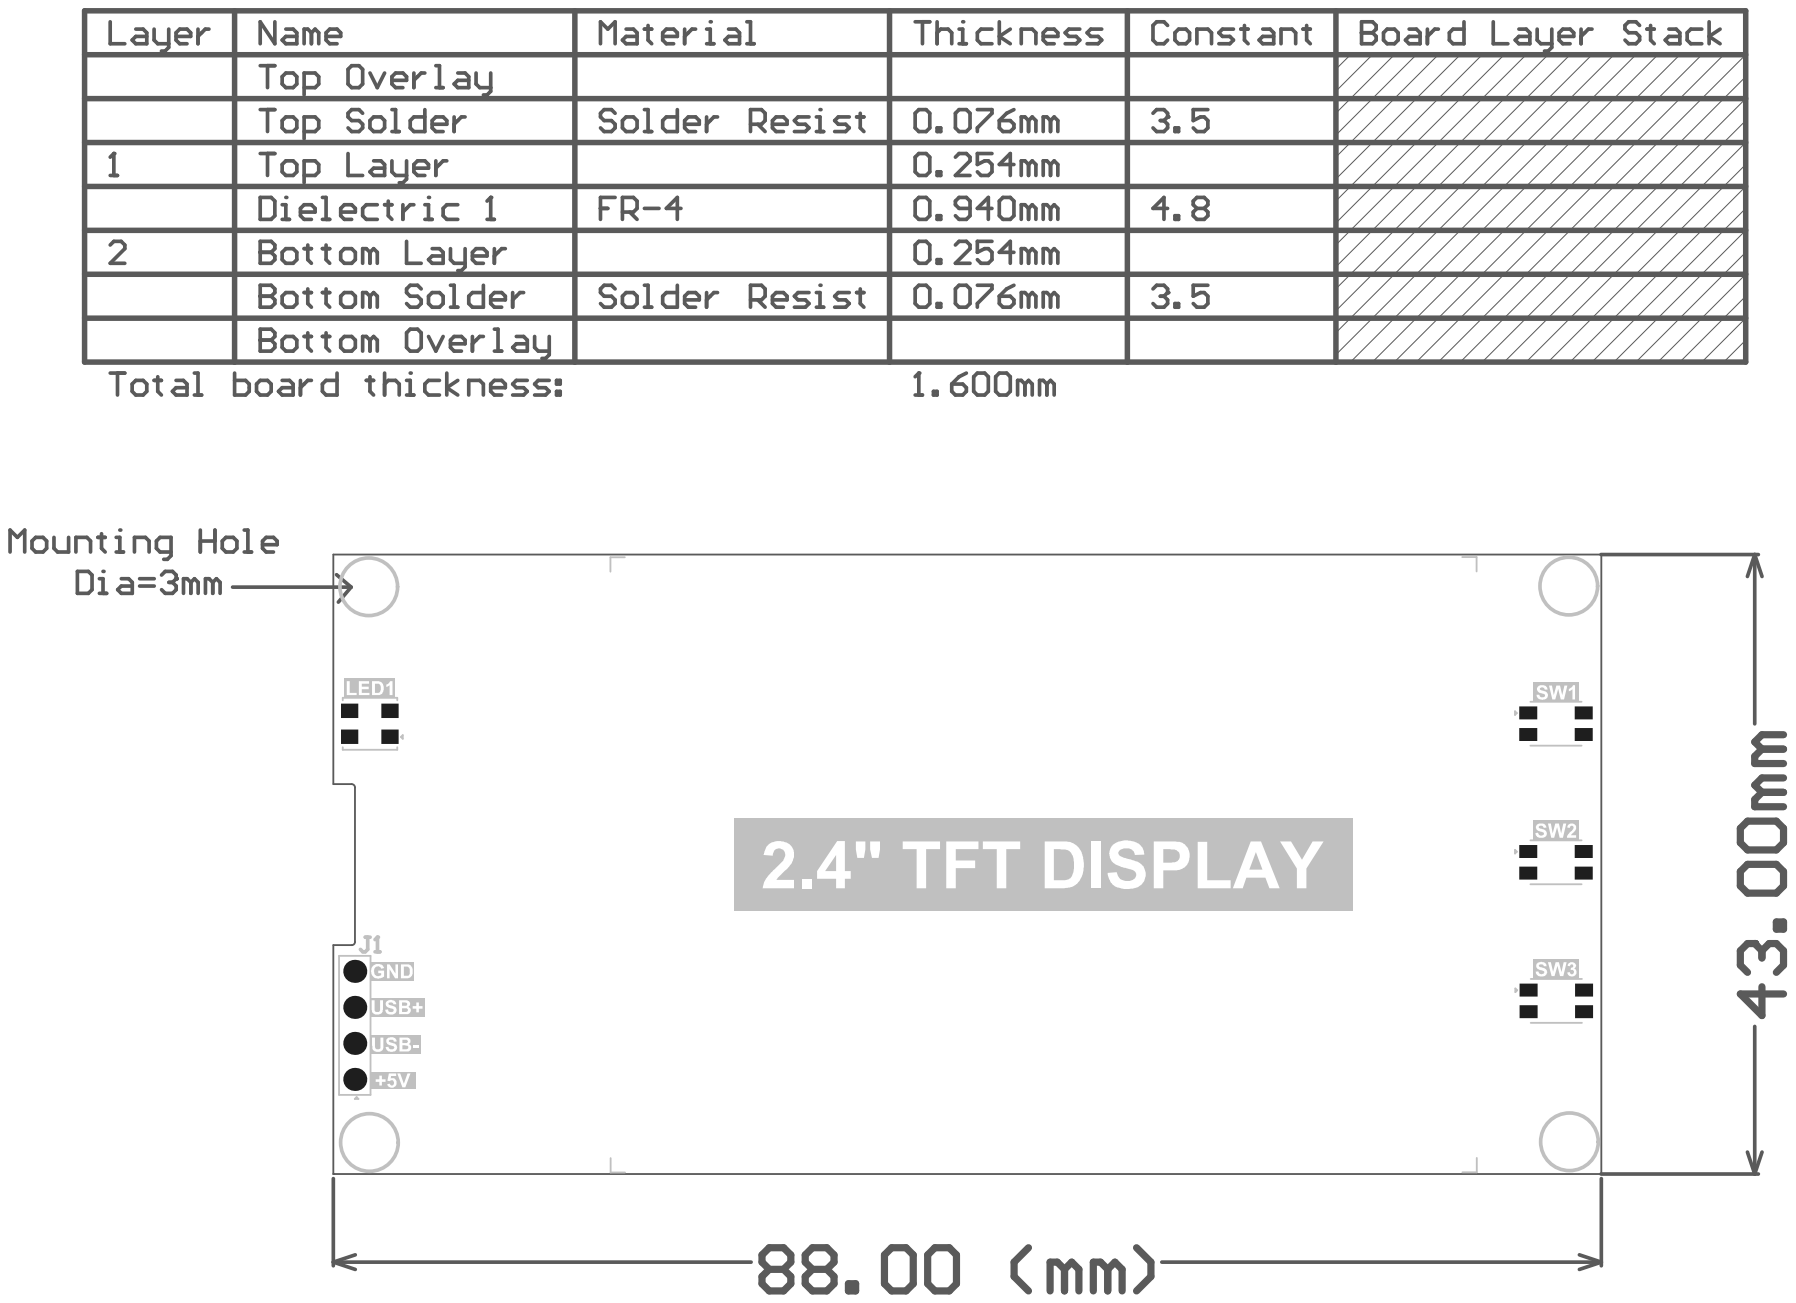
[picture p50: page 1]

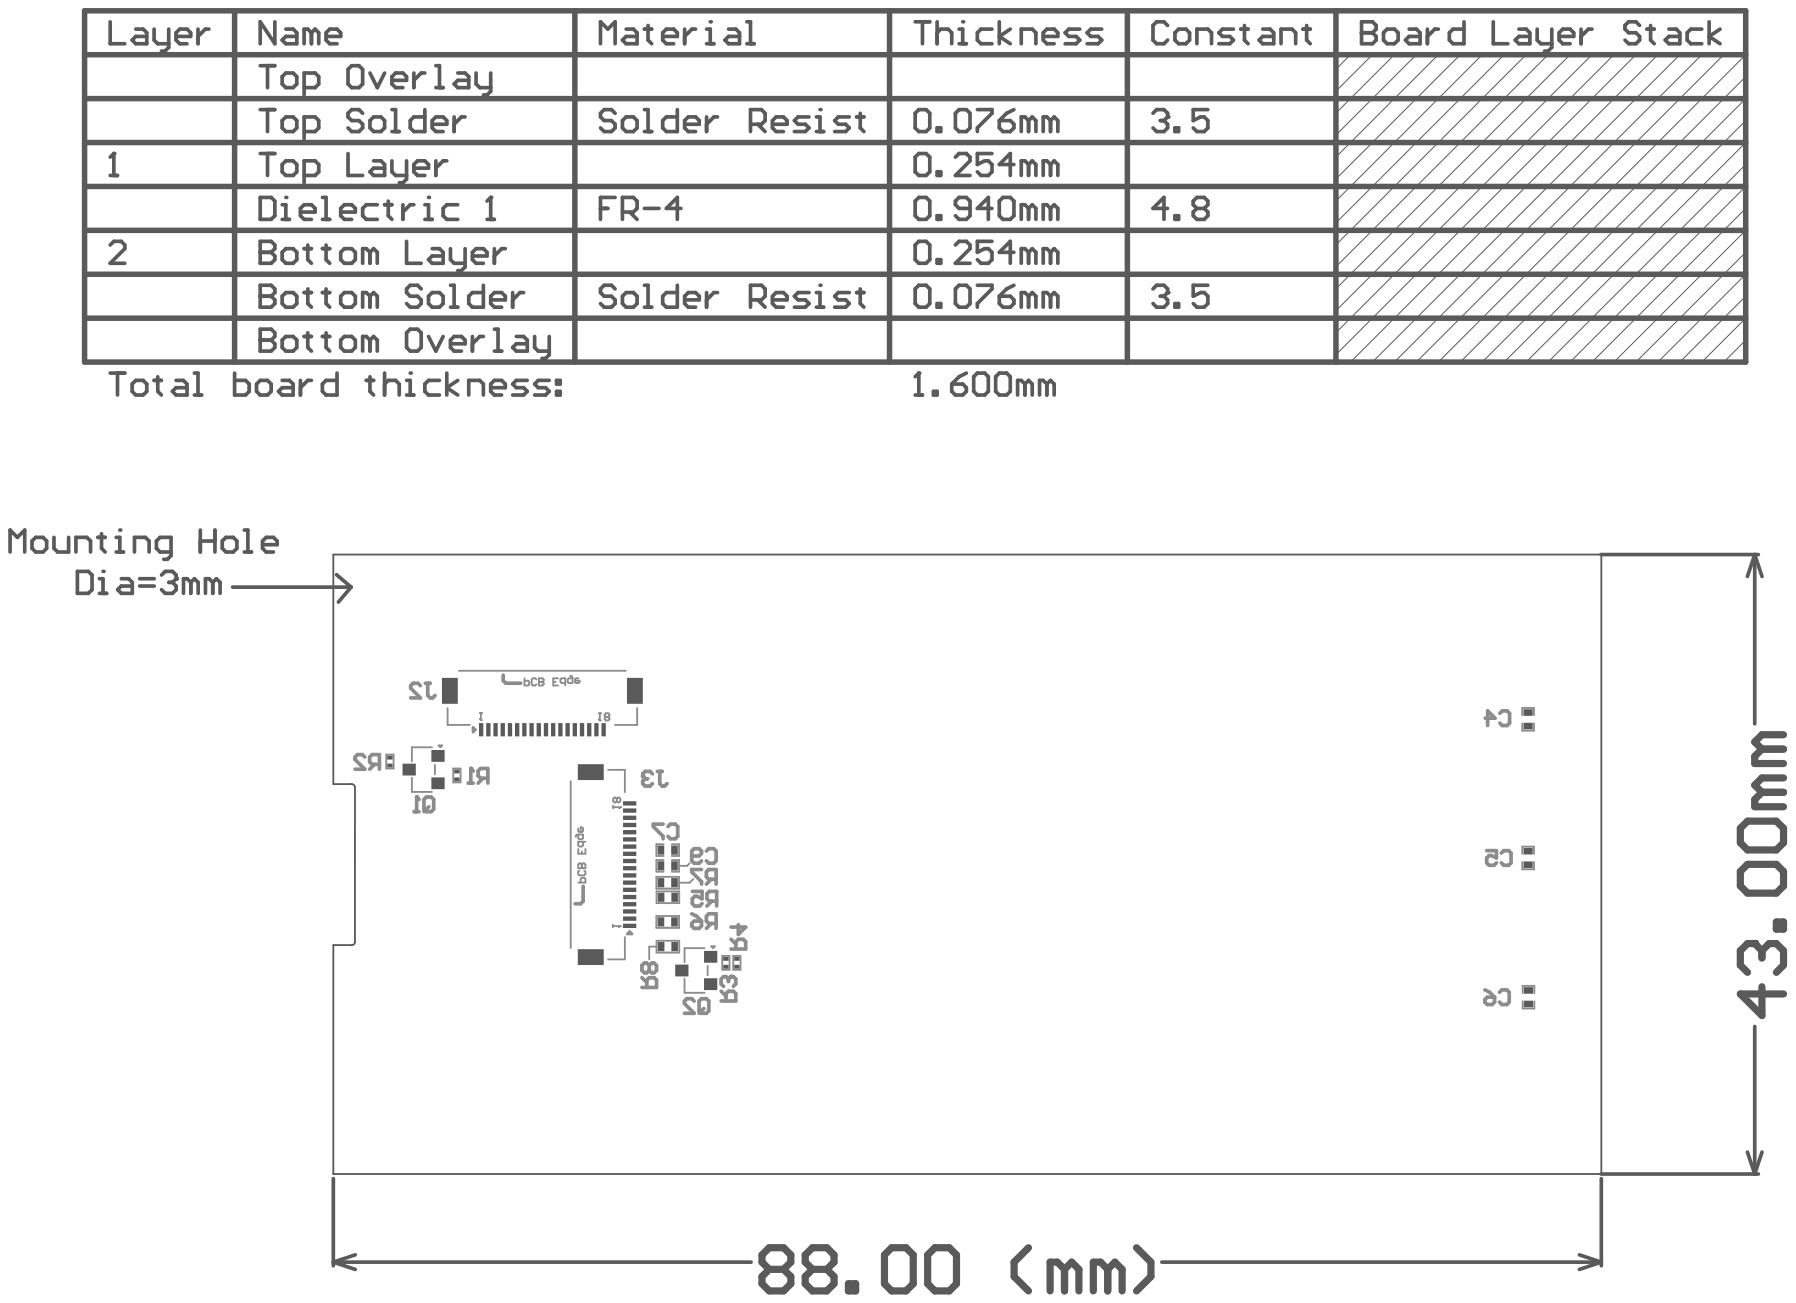
[picture p51: page 2]
