eSpark-Backup/chrisbyrd-esp32iotproduct/Design Files/OLED-v2.1/Deliverables/Schematics/Assembly Drawings.pdf

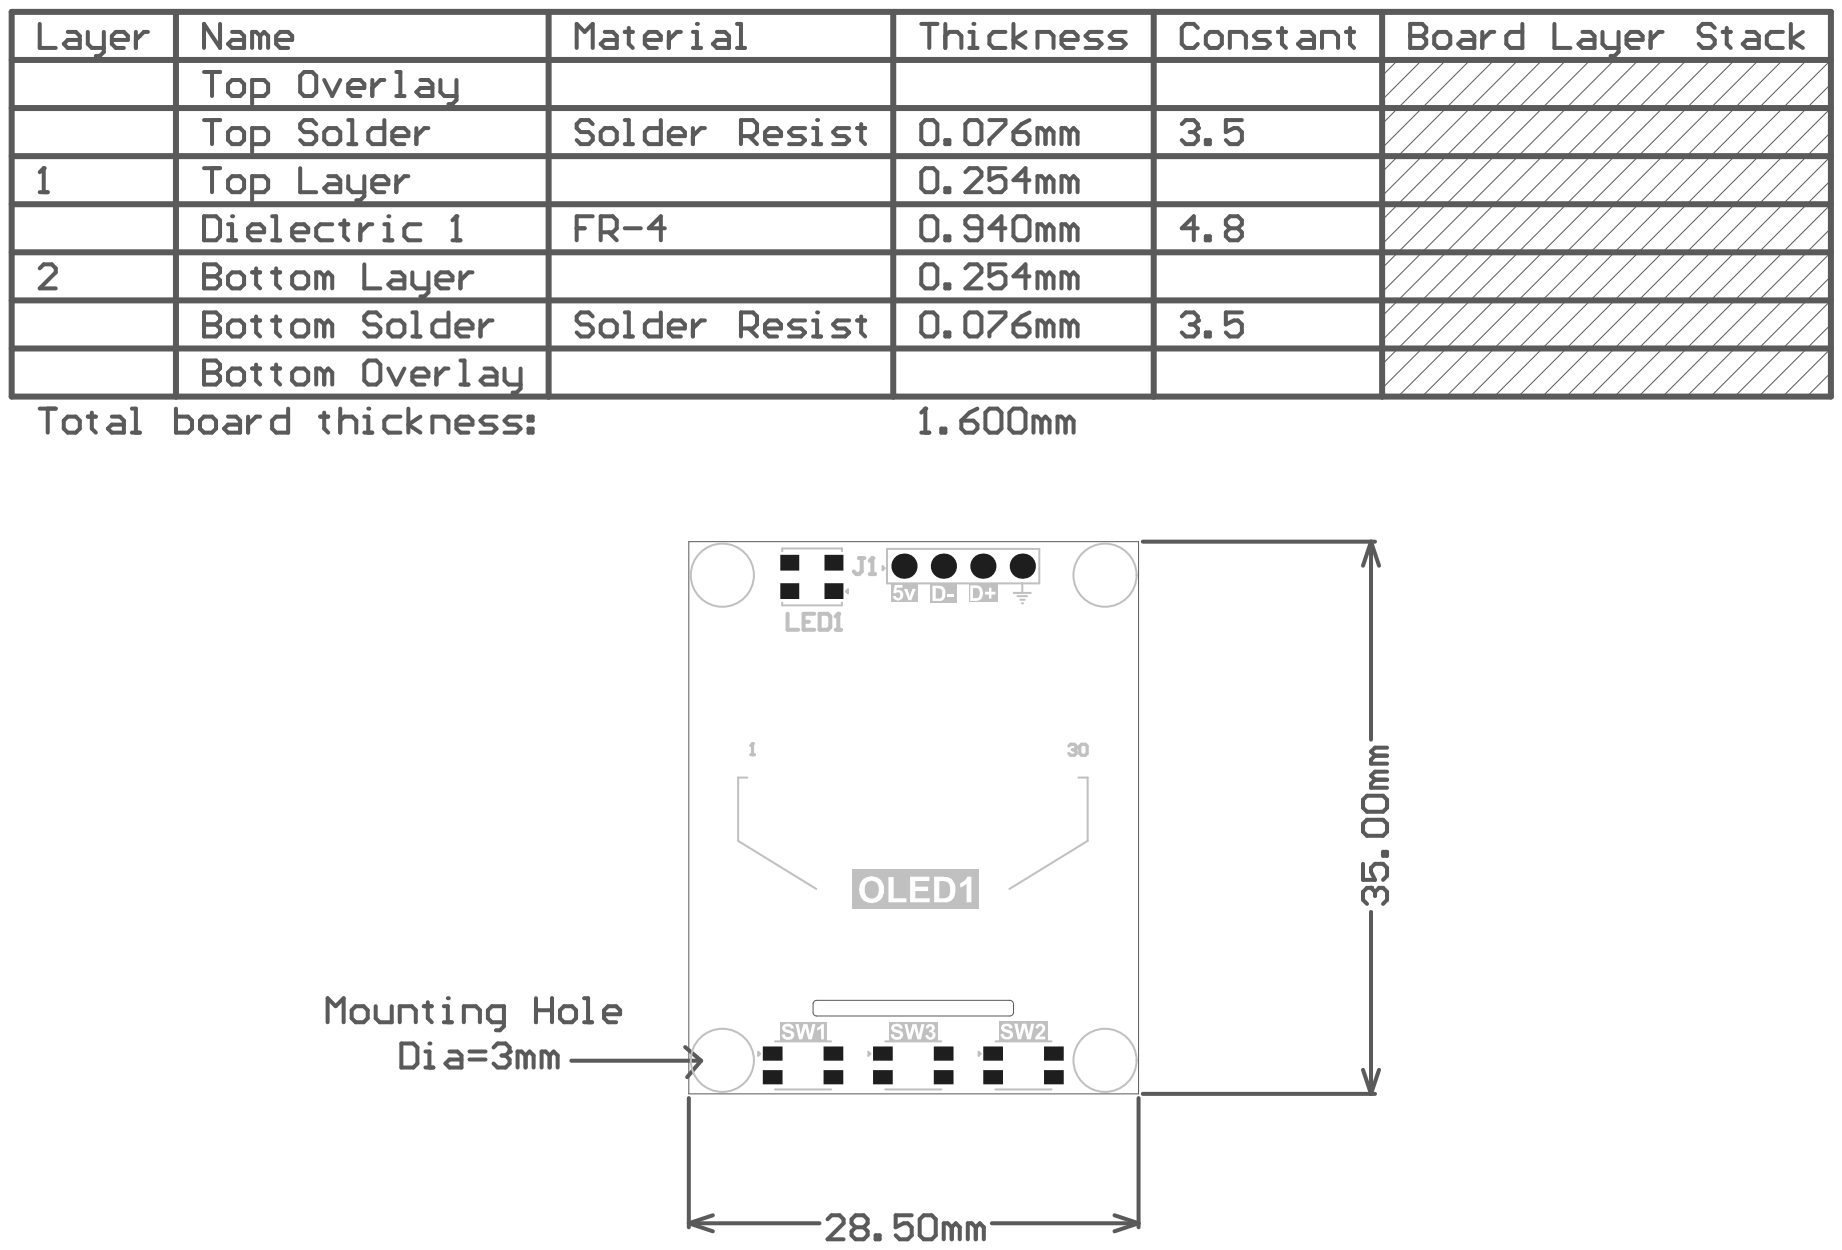
[picture p52: page 1]

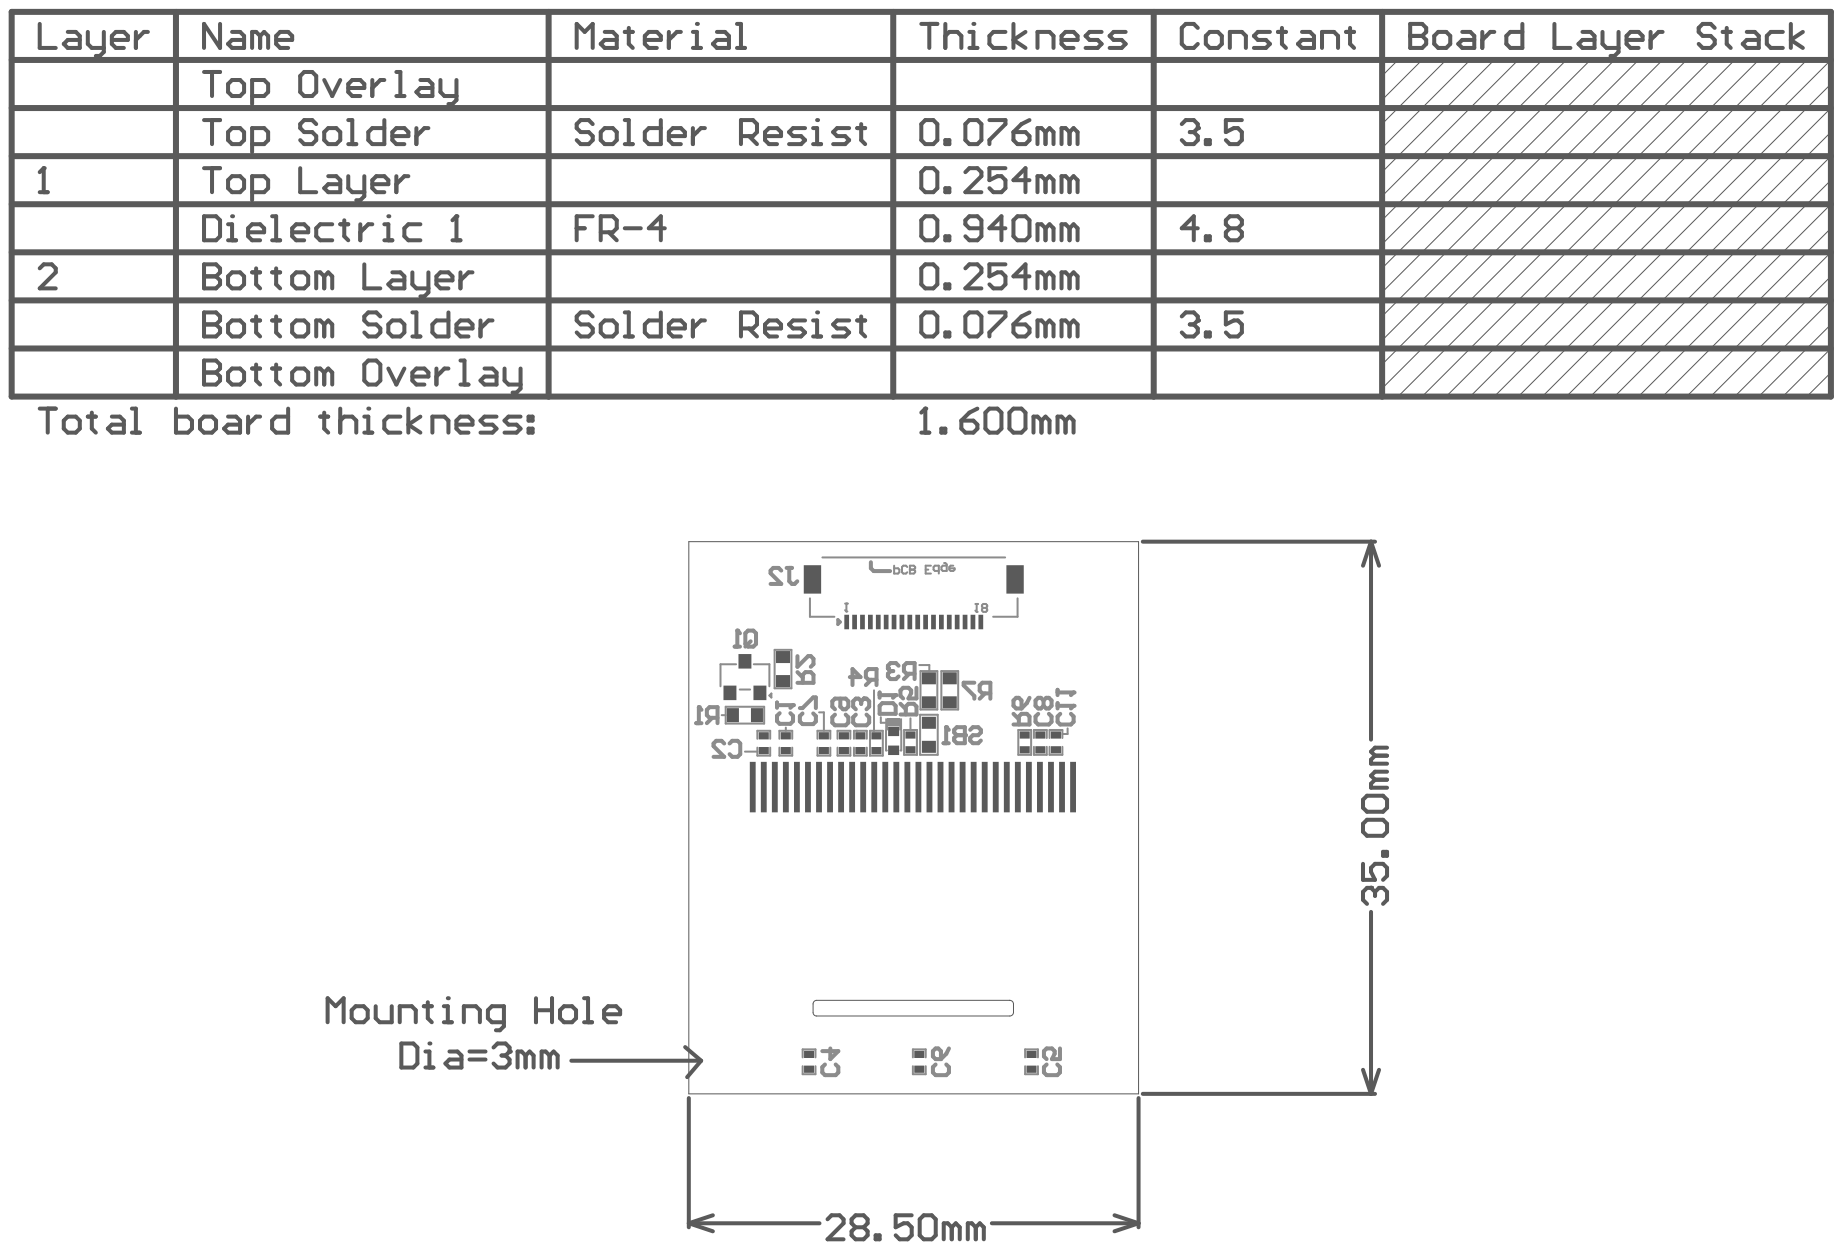
[picture p53: page 2]
