eSpark-Backup/chrisbyrd-esp32iotproduct/Design Files/LoRaWAN-Module-v2.0/Deliverables/Schematics/Assembly_Drawing.pdf

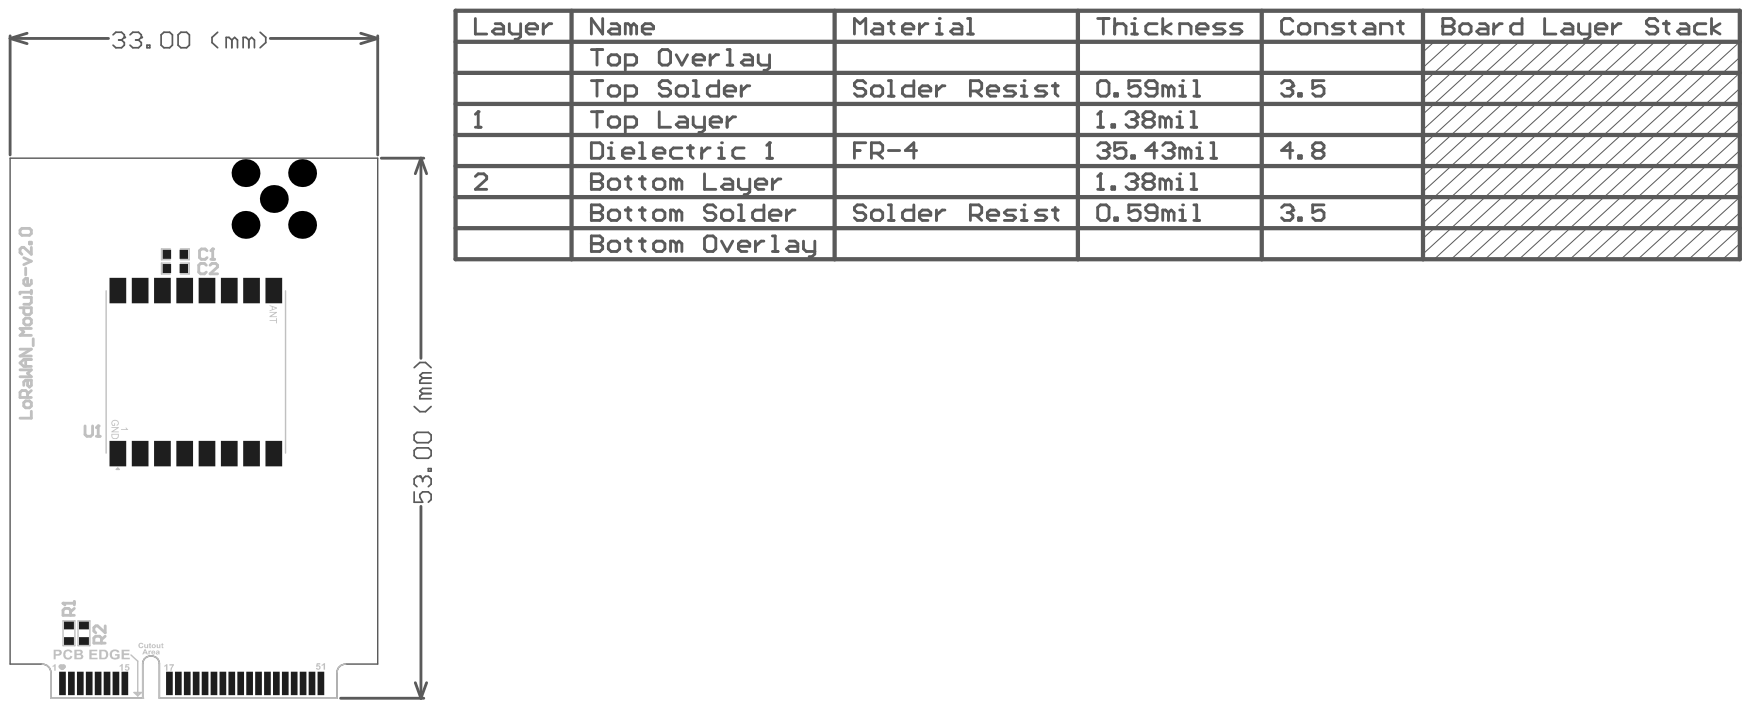
[picture p54: page 1]

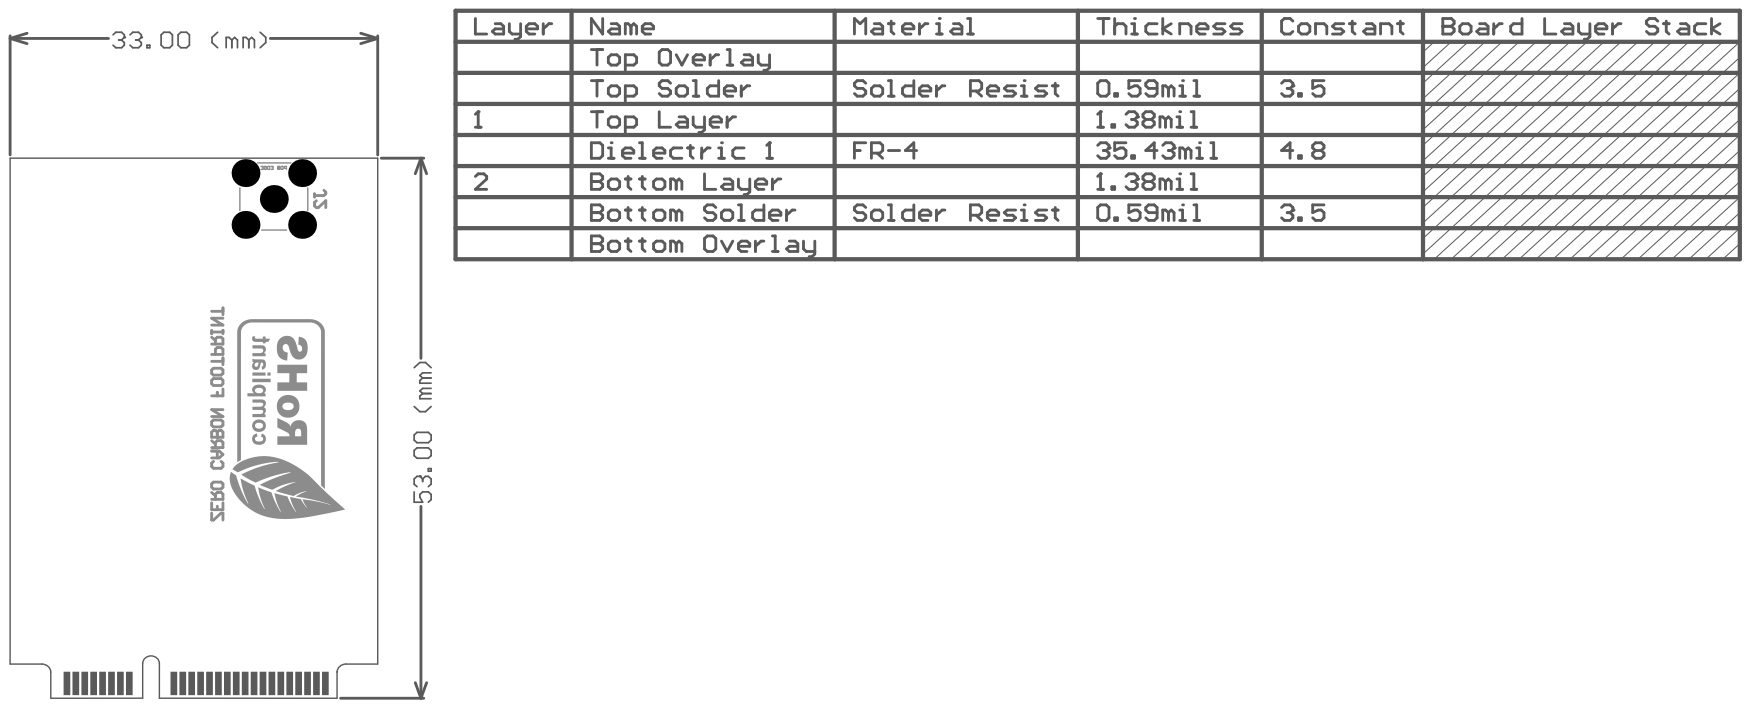
[picture p55: page 2]
