eSpark-Backup/chrisbyrd-esp32iotproduct/Design Files/LoRaWAN-Module-v2.0/Deliverables/Schematics/LoRaWAN-Module-v2.0.pdf

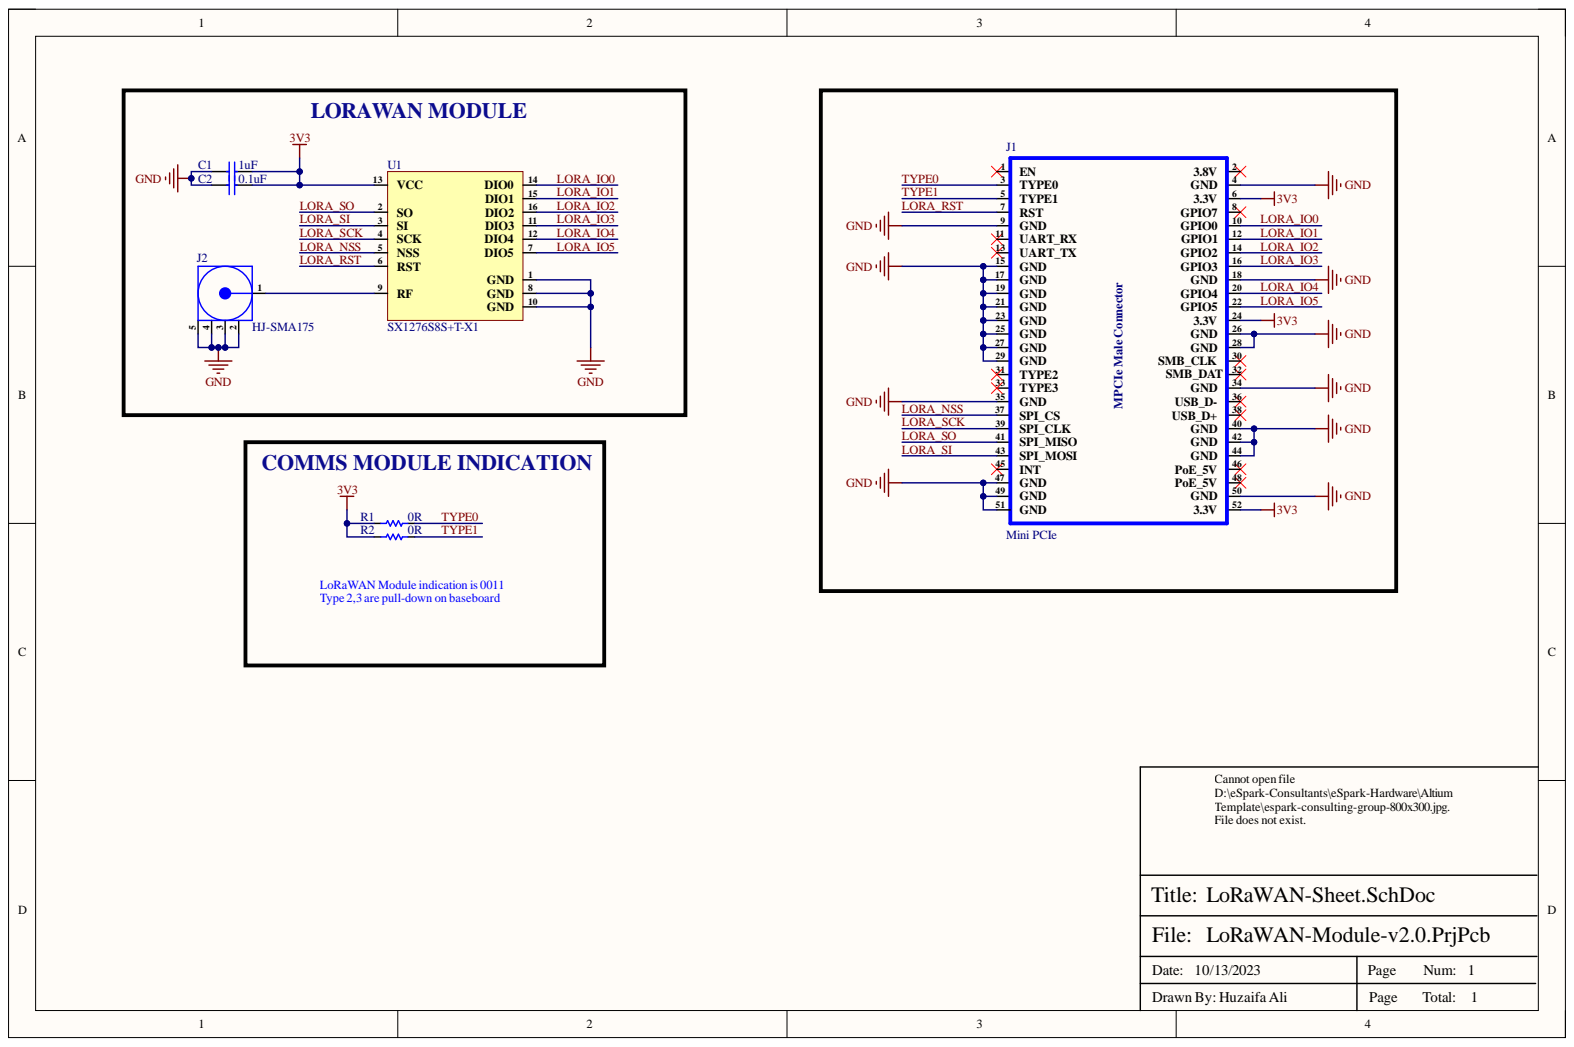
[picture p56: page 1]

e pull-down on baseboa

Dat e : 1 0 / 1 3 / 2 0 2 3 | Pag e N u m : 11

D raw n B y : H uzai fa A l i | Pag e To t al :

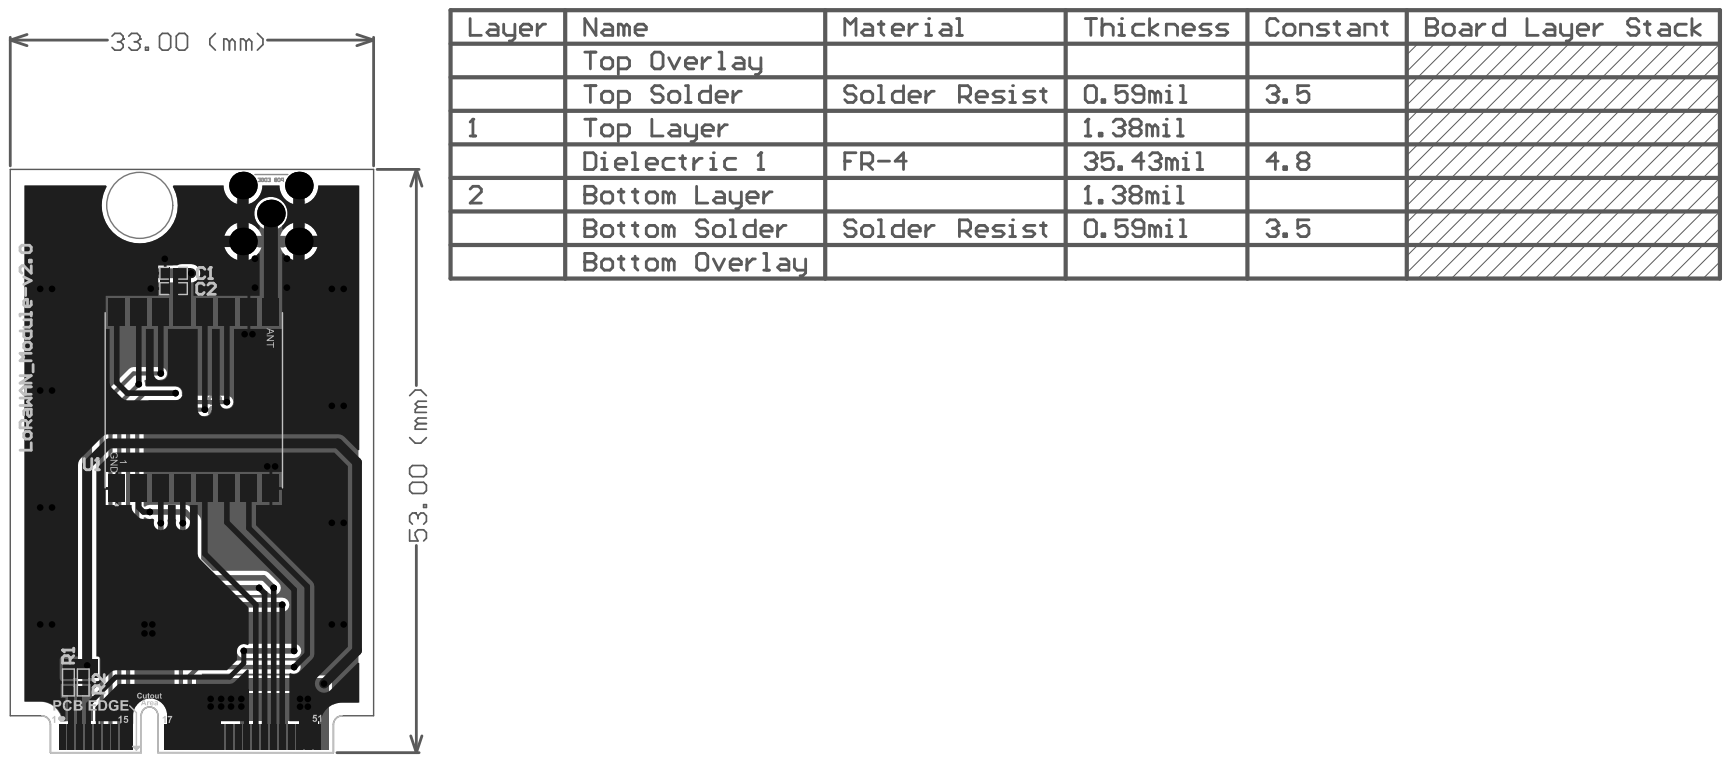
[picture p57: page 2]
