eSpark-Backup/chrisbyrd-esp32iotproduct/Design Files/EthPoE-Module-v2.0/Deliverables/Schematics/Assembly_Drawing.pdf

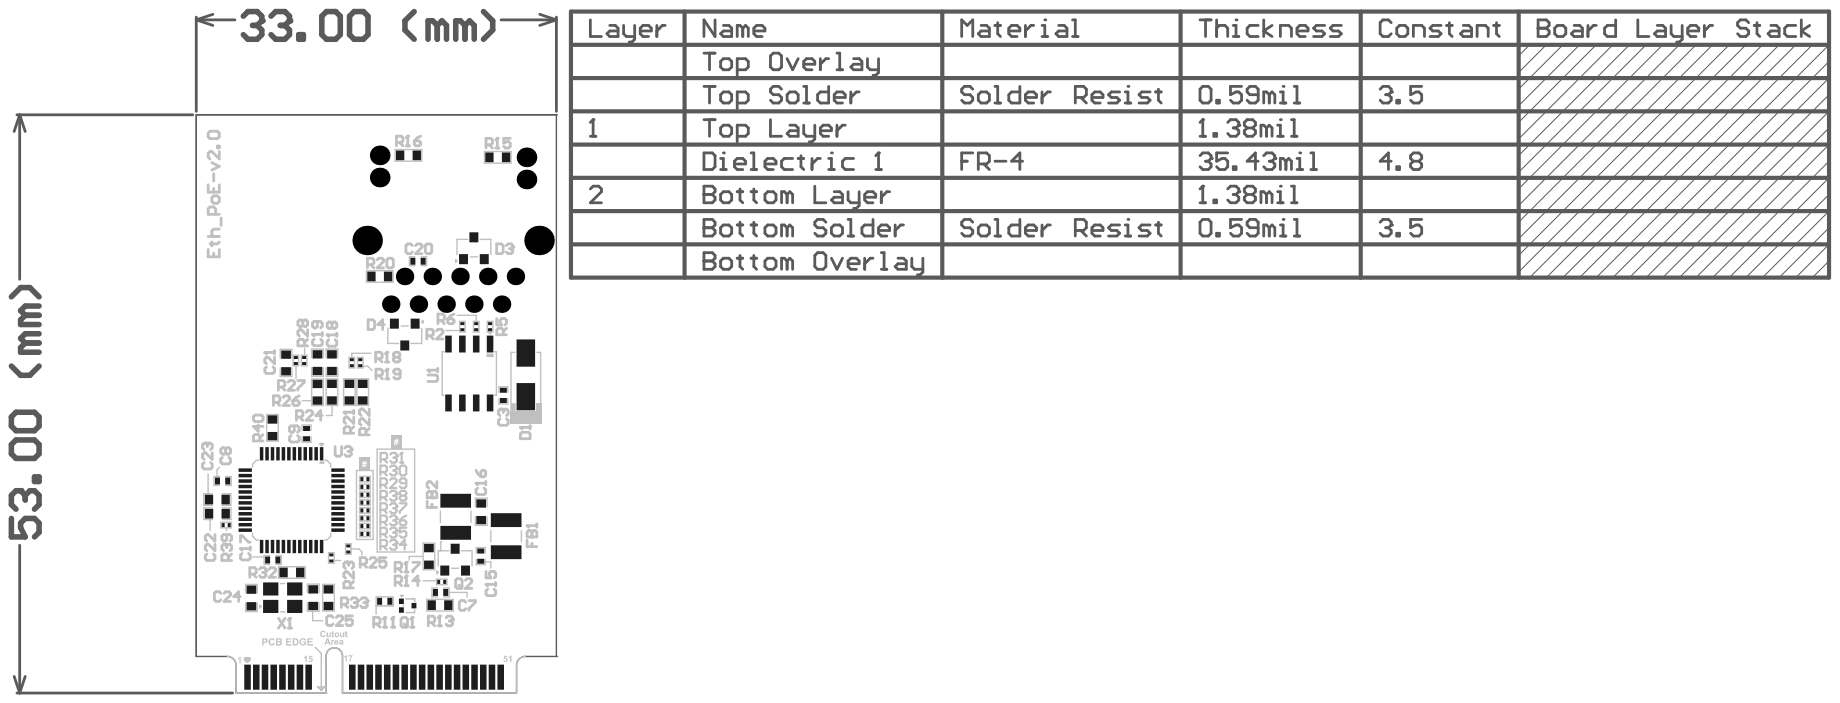
[picture p58: page 1]

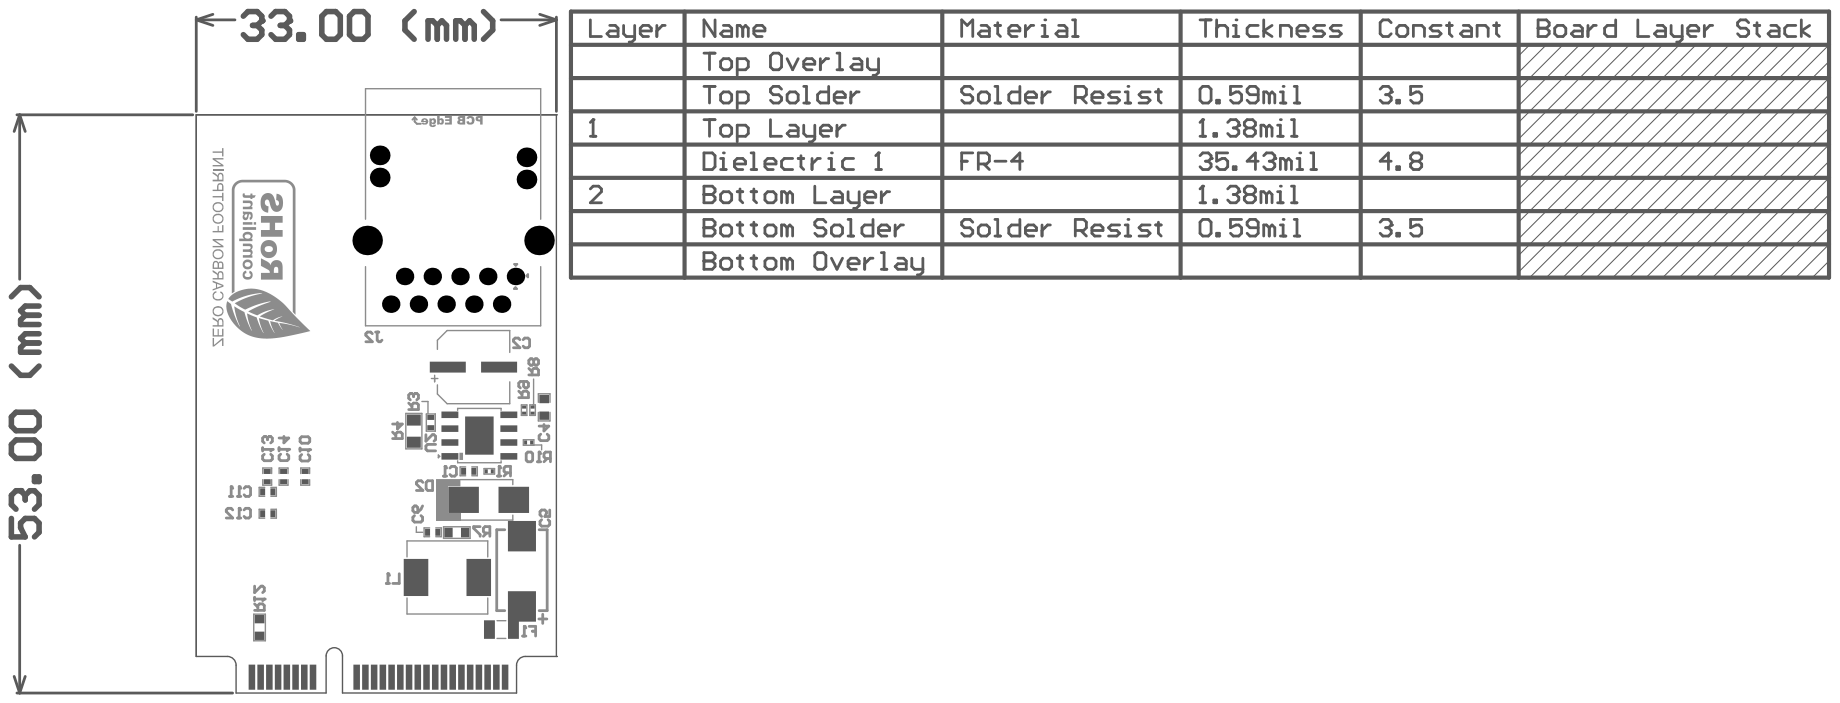
[picture p59: page 2]
