eSpark-Backup/chrisbyrd-esp32iotproduct/Design Files/EthPoE-Module-v2.0/Deliverables/Schematics/EthPoE-Module-v2.0.pdf

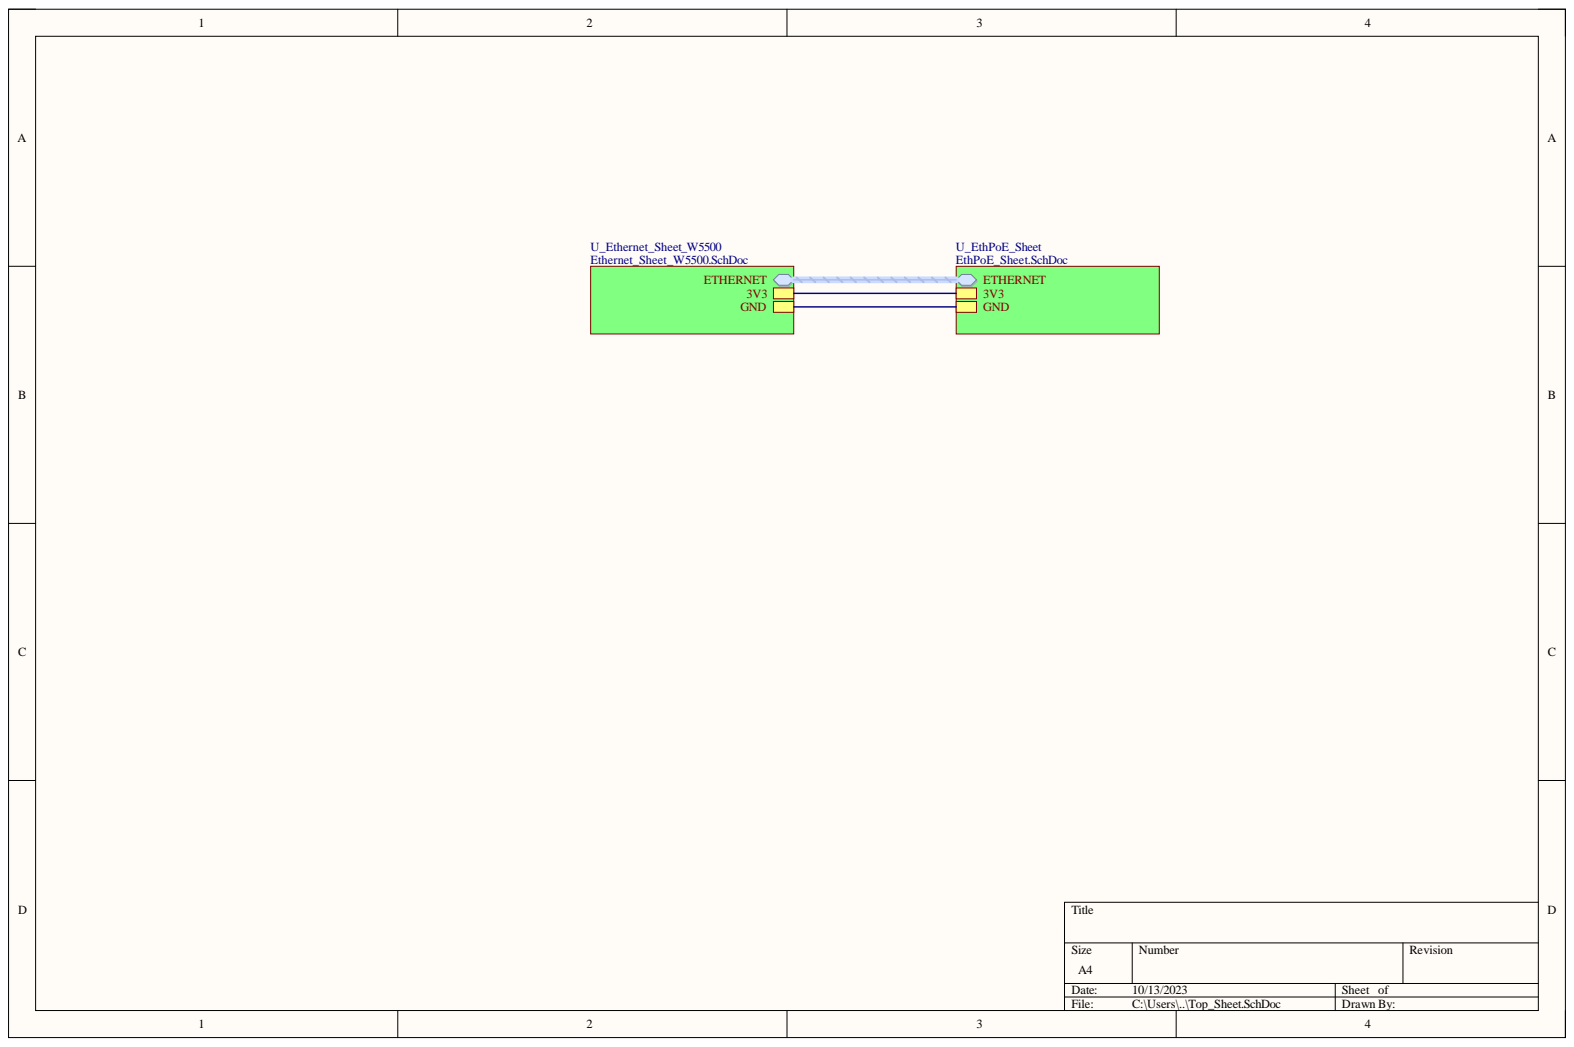
[picture p60: page 1]

Size A4 | Number | Revision

Date: 10/13/2023 | Sheet of
File: C:\Users\..\Top_Sheet.SchDoc | Drawn By:

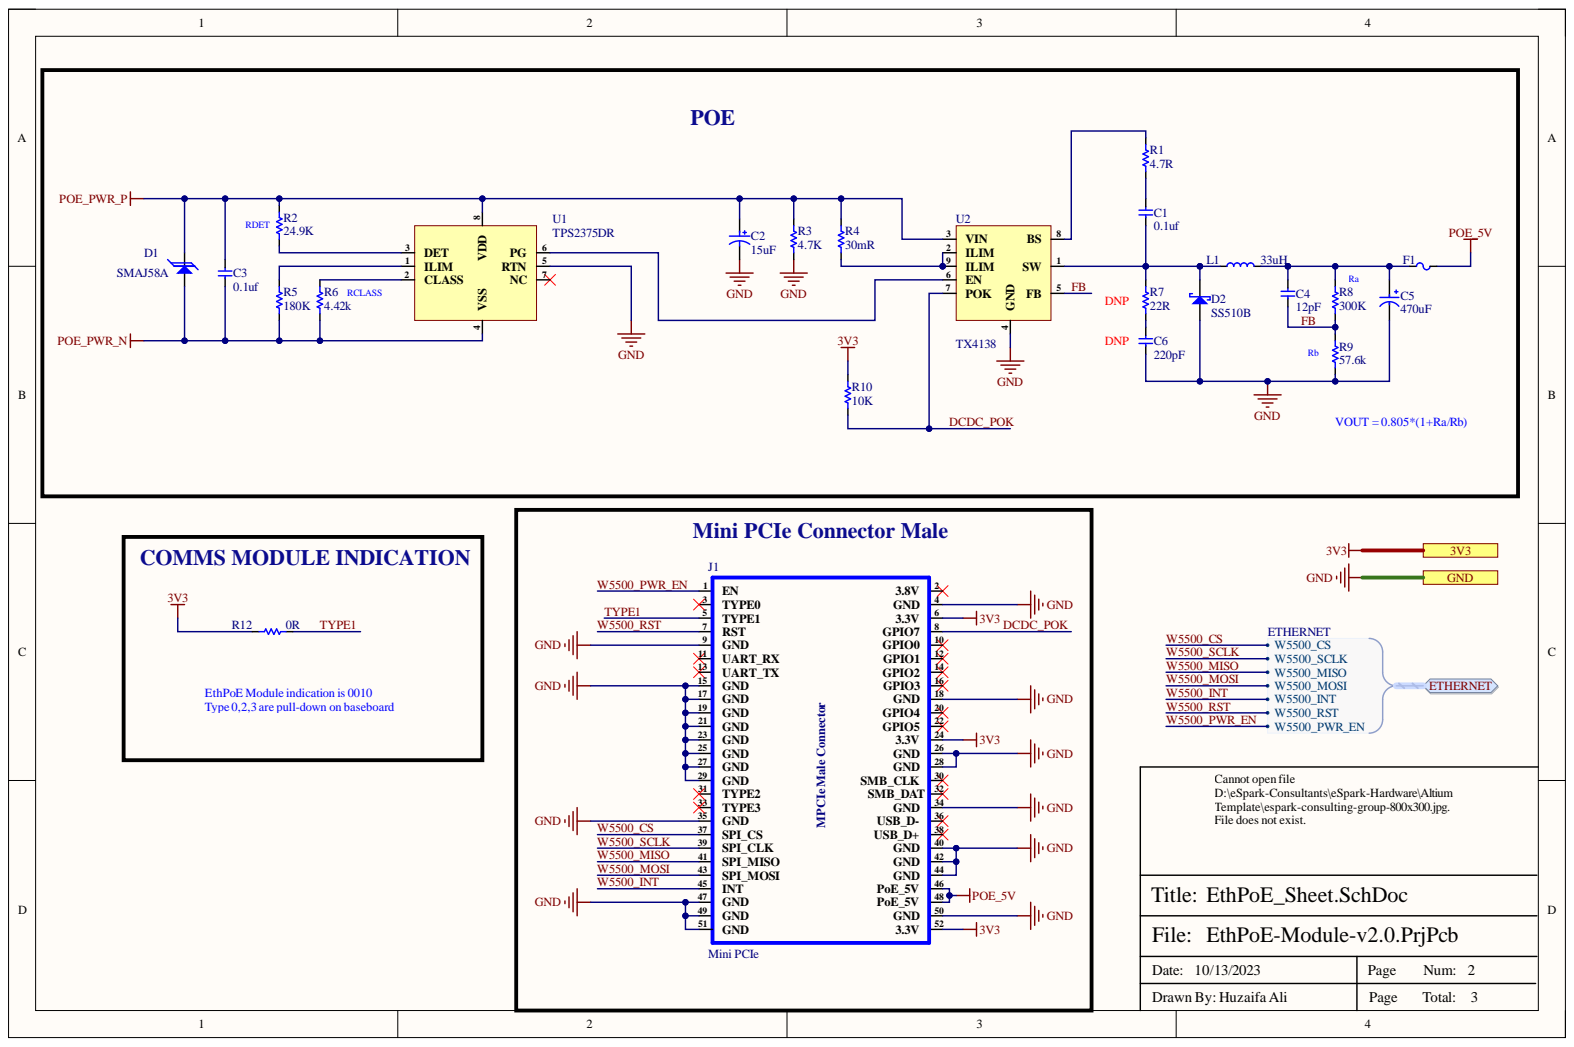
[picture p61: page 2]

Mini PCIe Connector Male

e pull-down on baseboa

Dat e : 1 0 / 1 3 / 2 0 2 3 | Pag e N u m : 23

D raw n B y : H uzai fa A l i | Pag e To t al :

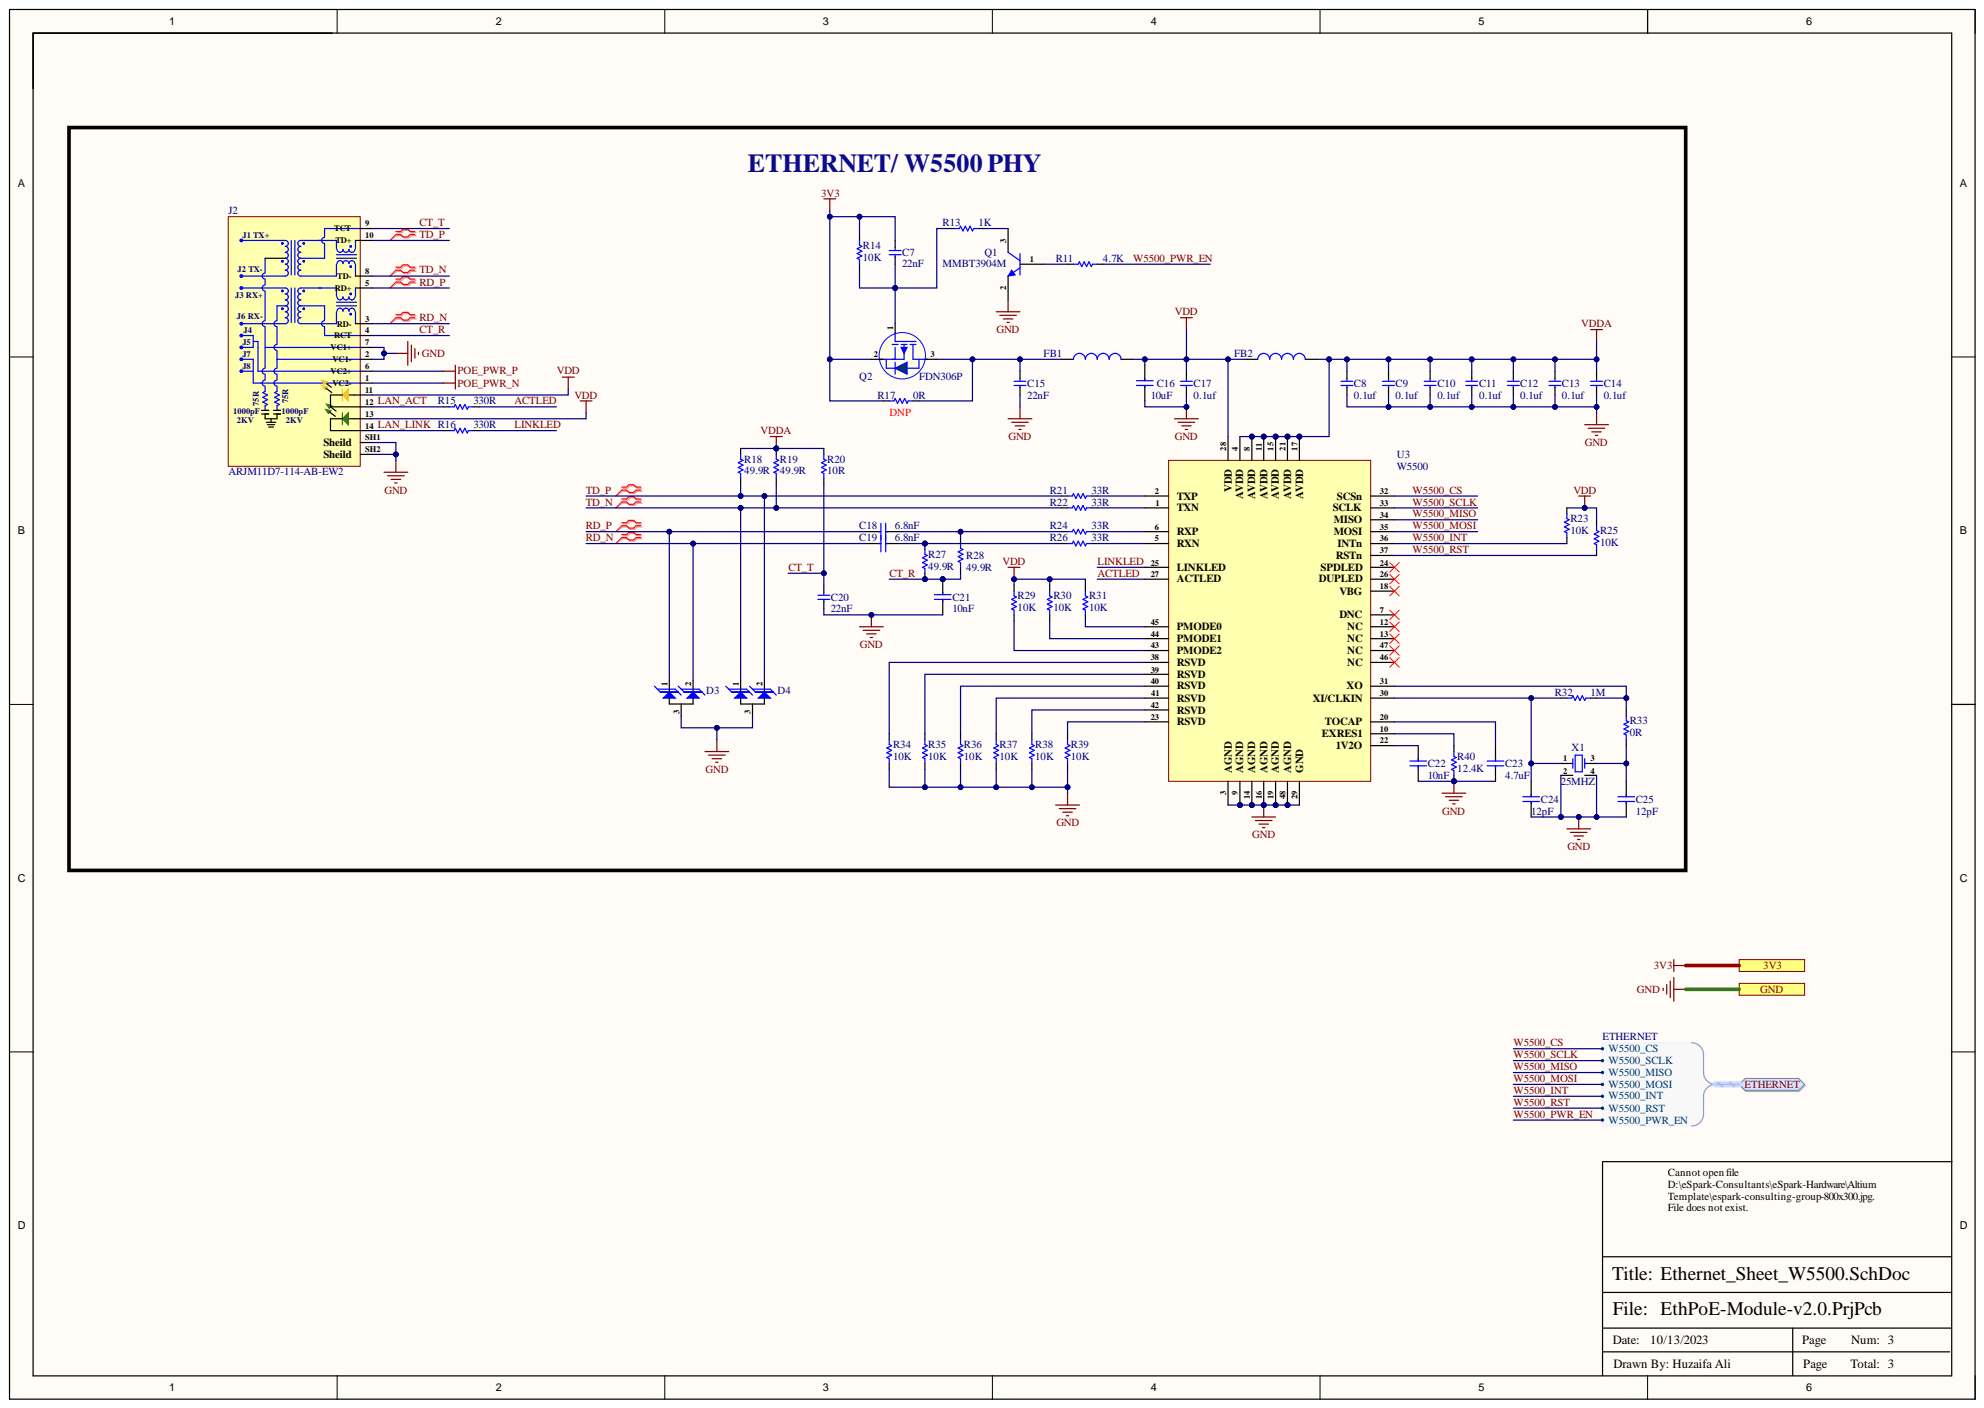
[picture p62: page 3]

Cannot open file
D:\eSpark-Consultants\eSpark-Hardware\Altium
Template\espark-consulting-group-800x300.jpg.
File does not exist.

Date: 10/13/2023 | Page Num: 3

Drawn By: Huzaifa Ali | Page Total: 3

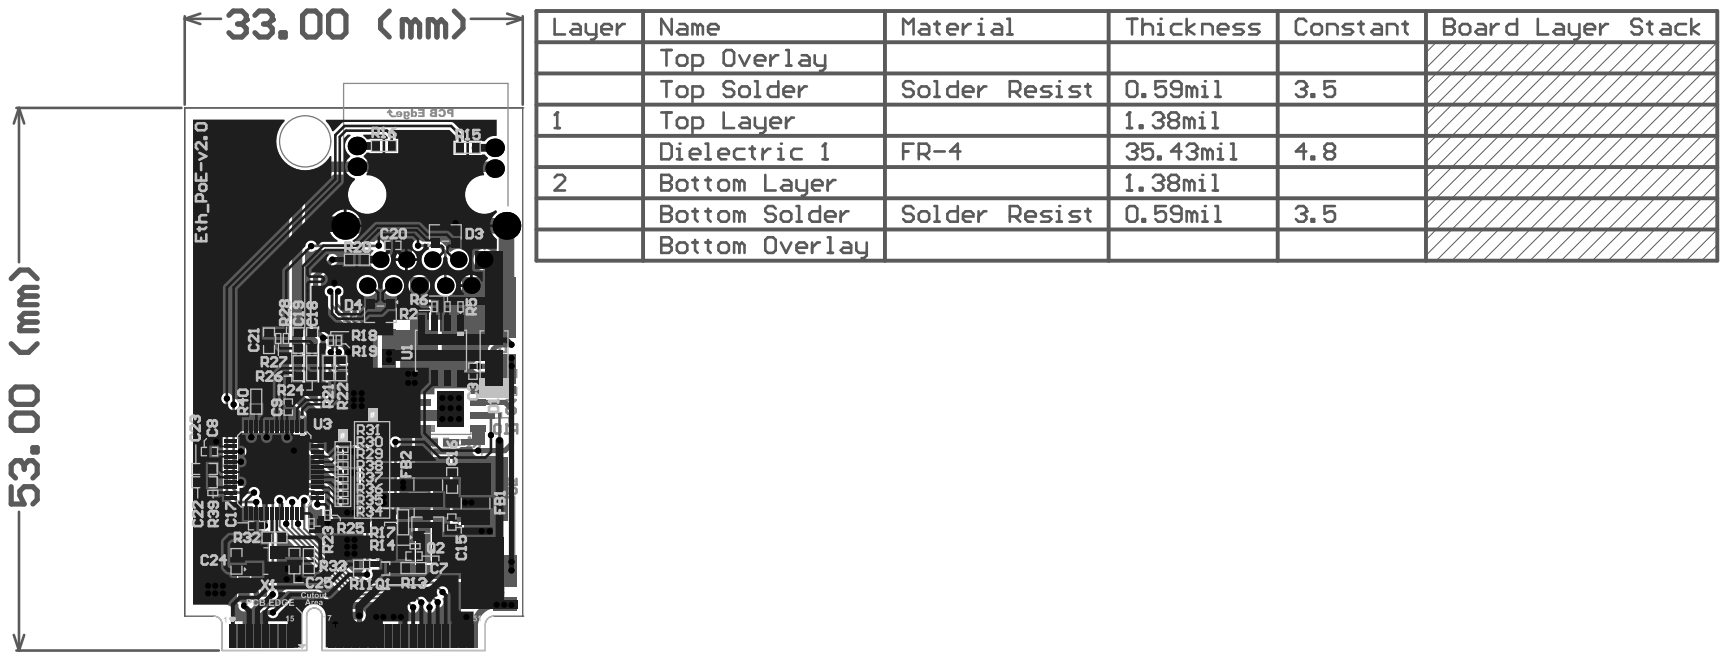
[picture p63: page 4]
