eSpark-Backup/chrisbyrd-esp32iotproduct/Design Files/Ethernet-Module-v2.0/Deliverables/Schematics/Assembly_Drawing.pdf

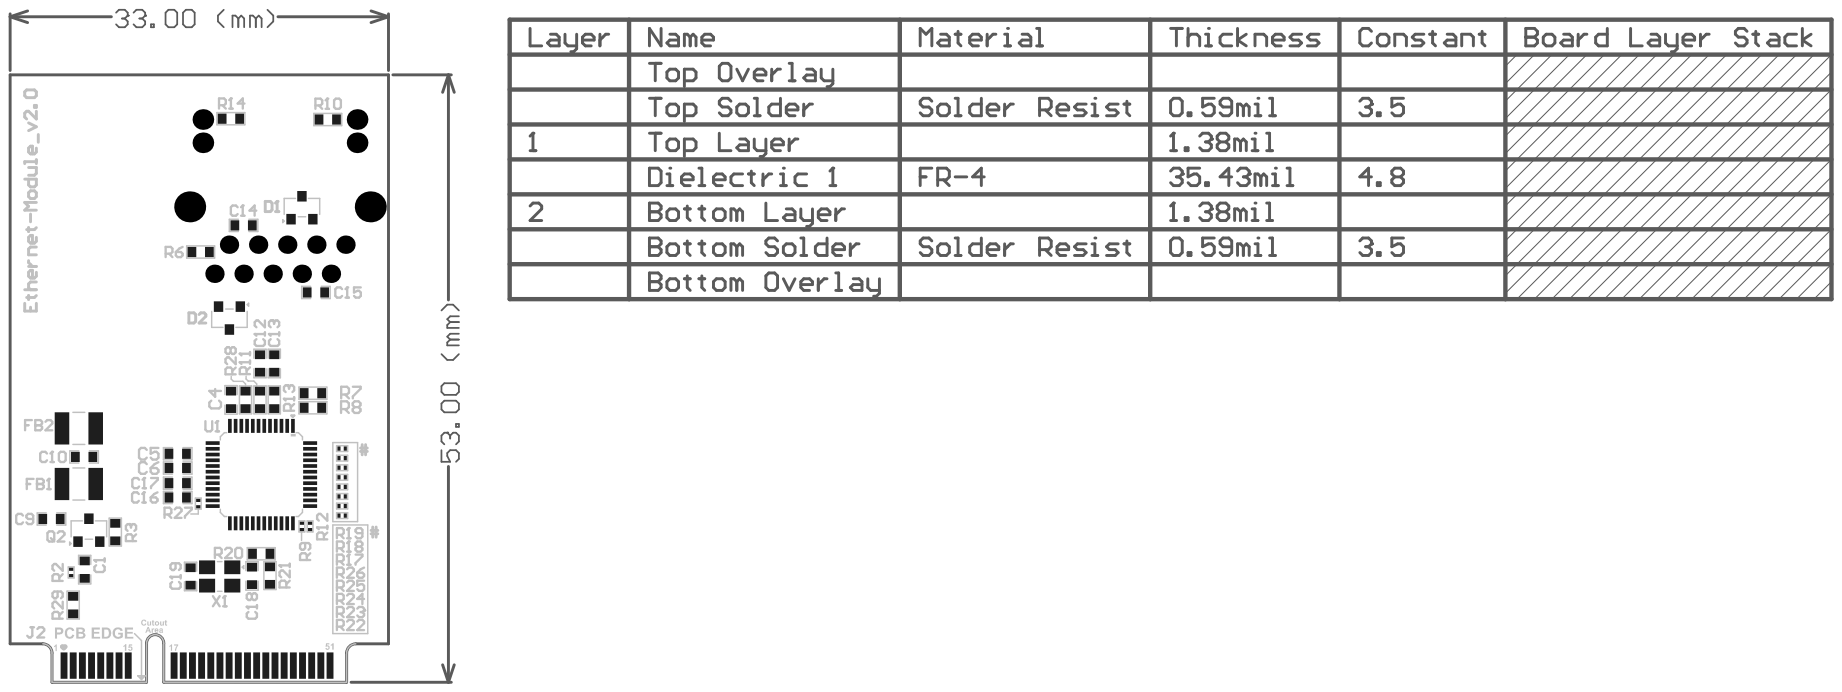
[picture p64: page 1]

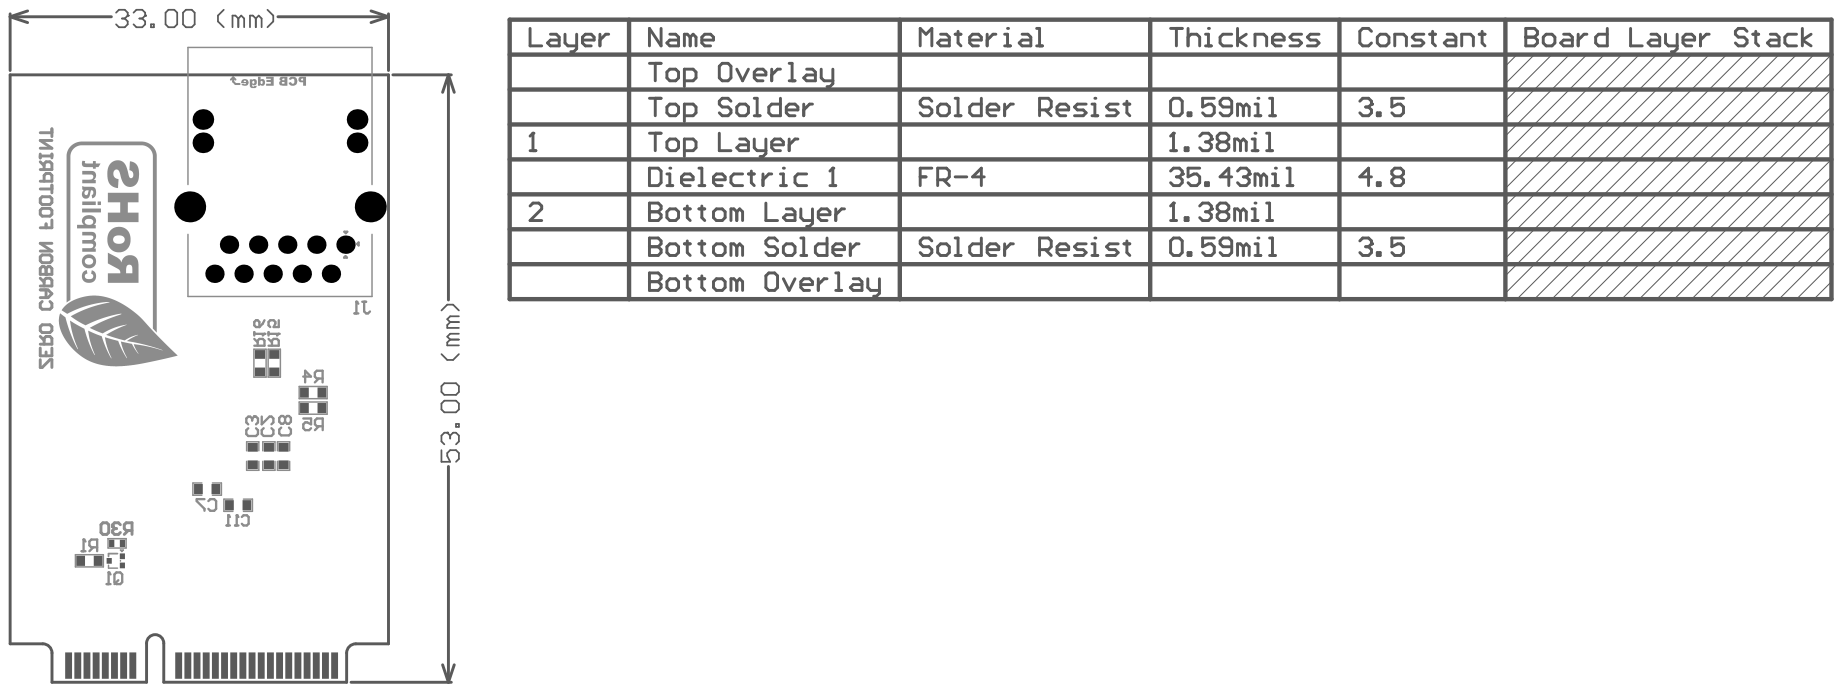
[picture p65: page 2]
