eSpark-Backup/chrisbyrd-esp32iotproduct/Design Files/LTE-Module-v2.0/Deliverables/Schematics/Assembly_Drawing.pdf

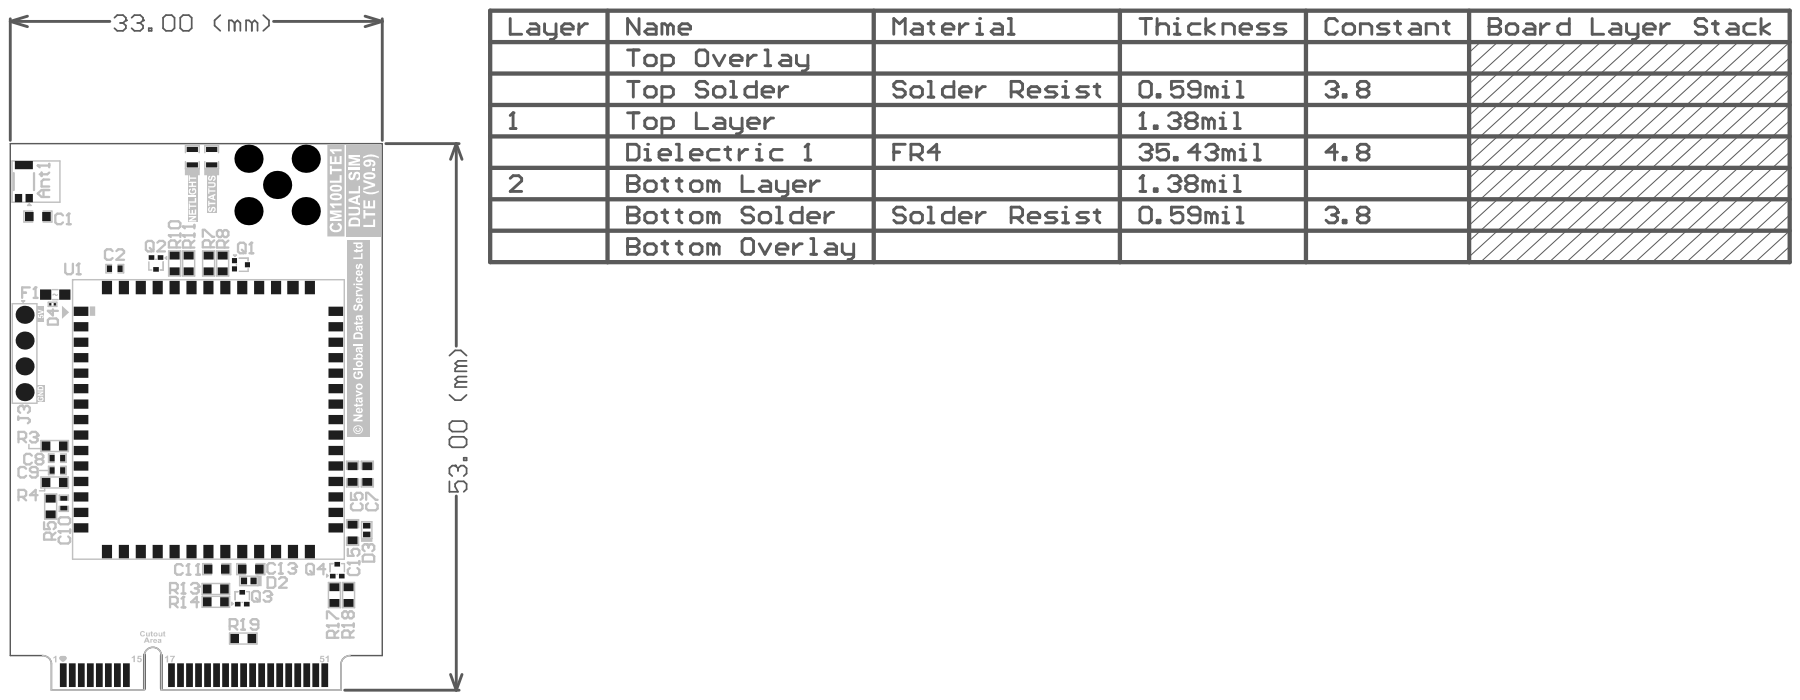
[picture p66: page 1]

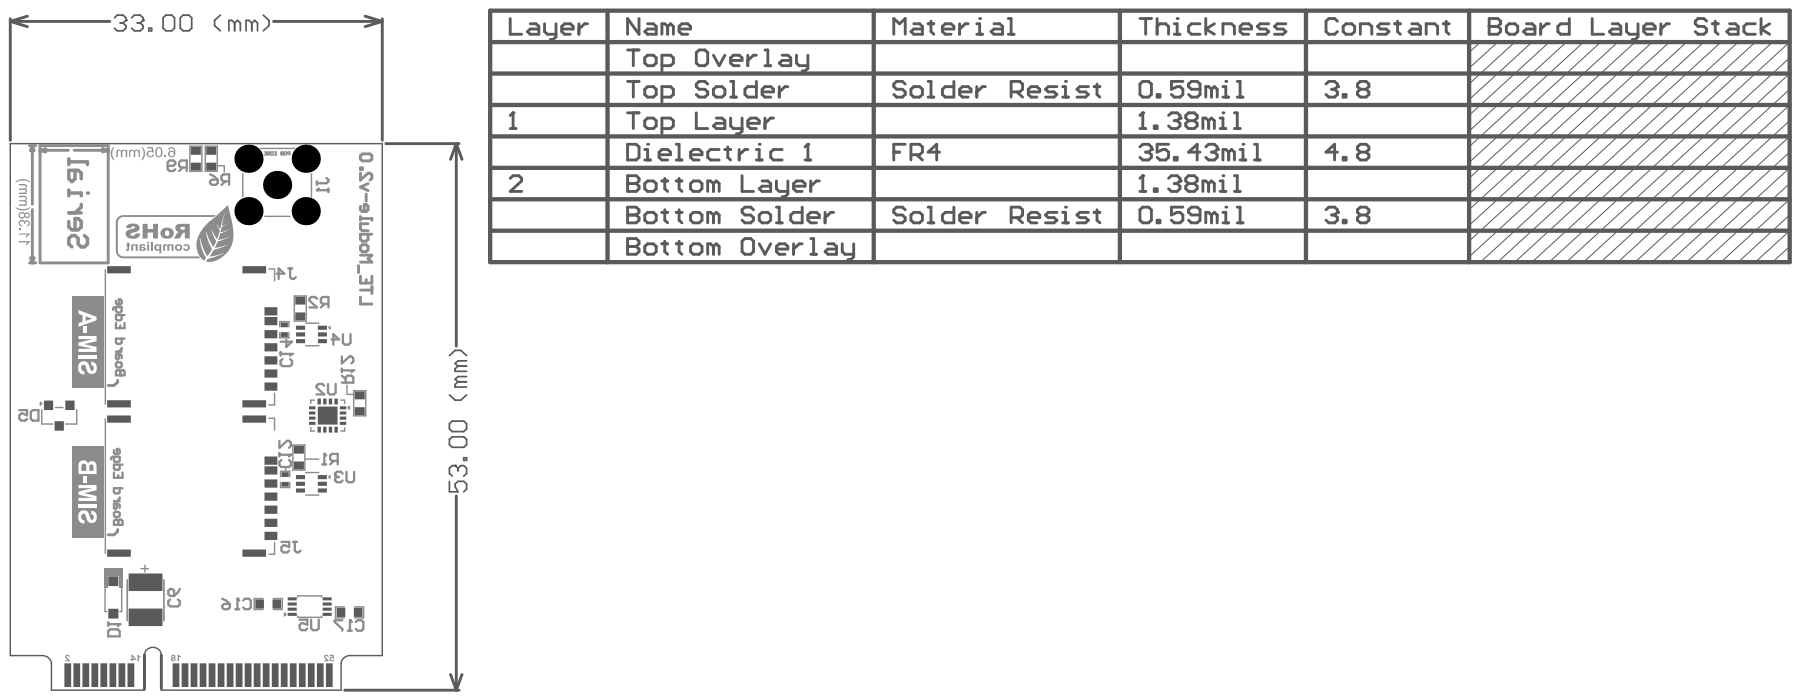
[picture p67: page 2]
