eSpark-Backup/chrisbyrd-esp32iotproduct/(list of files, drawings)

Other design files:
Design Files/Adv-OLED-v2.0/Adv-OLED-v2.0.PrjPcb
Design Files/Adv-OLED-v2.1/Adv-OLED-Sheet.SchDoc
Design Files/Adv-OLED-v2.1/Adv-OLED-v2.1.PrjPcb
Design Files/Adv-OLED-v2.1/Adv-OLED_v2.0.PcbDoc
Design Files/Baseboard-v2.0/Baseboard-v2.0.PrjPcb
Design Files/Baseboard-v2.1/Baseboard-v2.0.PcbDoc
Design Files/Baseboard-v2.1/Baseboard-v2.1.PrjPcb
Design Files/Baseboard-v2.1/Connector.SchDoc
Design Files/Baseboard-v2.1/Controller_Sheet.SchDoc
Design Files/Baseboard-v2.1/DTMF_Decoder_Sheet.SchDoc
Design Files/Baseboard-v2.1/GPIOs_Expander_Relay_Sheet.SchDoc
Design Files/Baseboard-v2.1/mPCIe_Connector_Sheet.SchDoc
Design Files/Baseboard-v2.1/Power_Sheet.SchDoc
Design Files/Baseboard-v2.1/RS485_RS232_Sheet.SchDoc
Design Files/Baseboard-v2.1/Top_Sheet.SchDoc
Design Files/Ethernet-Module-v2.0/Ethernet-Module-v2.0.PrjPcb
Design Files/Ethernet-Module-v2.0/Ethernet-Module.PcbDoc
Design Files/Ethernet-Module-v2.0/Module_Ethernet_Sheet.SchDoc
Design Files/EthPoE-Module-v2.0/Eth_PoE.PcbDoc
Design Files/EthPoE-Module-v2.0/Ethernet_Sheet_W5500.SchDoc
Design Files/EthPoE-Module-v2.0/EthPoE-Module-v2.0.PrjPcb
Design Files/EthPoE-Module-v2.0/EthPoE_Sheet.SchDoc
Design Files/EthPoE-Module-v2.0/Top_Sheet.SchDoc
Design Files/LoRaWAN-Module-v2.0/LoRaWAN-Module-v2.0.PrjPcb
Design Files/LoRaWAN-Module-v2.0/LoRaWAN-Sheet.SchDoc
Design Files/LoRaWAN-Module-v2.0/LoRaWAN_v2.0.PcbDoc
Design Files/LTE-Module-v2.0/LTE-Module.PcbDoc
Design Files/LTE-Module-v2.0/LTE_MODULE_v2.0.PrjPcb
Design Files/LTE-Module-v2.0/LTE_Sheet.SchDoc
Design Files/OLED-v2.0/OLED-v2.0.PrjPcb
Design Files/OLED-v2.1/OLED-Sheet.SchDoc
Design Files/OLED-v2.1/OLED-v2.1.PrjPcb
Design Files/OLED-v2.1/OLED_v2.0.PcbDoc
