eSpark-Backup/chrisbyrd-esp32iotproduct/(commit log)

2023-04-11 #1 Controller added with I2C OLED Connection and Voltlink programmer
    [ESP32IOTProduct.PrjPcb, Sheet1.SchDoc]
2023-04-12 #1 Parts Selected and power scheme in progress
    [Sheet1.SchDoc]
2023-04-13 #1 Power section completed with SIM in progress
    [ESP32IOTProduct.PrjPcb, Sheet1.SchDoc]
2023-04-17 #1 Ethernet completed, RS485 in progress
    [Sheet1.SchDoc]
2023-04-18 #1 RS485 to UART completed, GSM in progress
    [Sheet1.SchDoc]
2023-04-19 #1 SIM2 in GSM remaining
    [Connector_Sheet.SchDoc, Controller_Sheet.SchDoc, ESP32IOTProduct.PrjPcb, Ethernet_Sheet.SchDoc, GSM_Sheet.SchDoc, Power_Sheet.SchDoc, Sheet1.SchDoc]
2023-04-20 #1 All completed Except DTMF, Gpios and Oring Circuitry
    [Connector_Sheet.SchDoc, Controller_Sheet.SchDoc, ESP32IOTProduct.PrjPcb, Ethernet_Sheet.SchDoc, GSM_Sheet.SchDoc, Power_Sheet.SchDoc, RS485_Sheet.SchDoc, Sheet1.SchDoc]
2023-04-20 #1 Oring CIrcuitry updated
    [Power_Sheet.SchDoc]
2023-04-20 #1 Sheet1 saved
    [Sheet1.SchDoc]
2023-04-24 schematic sheets numbered
    [Connector_Sheet.SchDoc, Controller_Sheet.SchDoc, Ethernet_Sheet.SchDoc, GSM_Sheet.SchDoc, Power_Sheet.SchDoc]
2023-04-24 pdf generated
    [ESP32IOTProduct.PrjPcb, RS485_Sheet.SchDoc, Top_Sheet.SchDoc]
2023-04-26 #1 DTMF added, GSM command GPIO edit, Oring IC added
    [Connector_Sheet.SchDoc, Controller_Sheet.SchDoc, DTMF_Decoder_Sheet.SchDoc, ESP32IOTProduct.PrjPcb, Ethernet_Sheet.SchDoc, GSM_Sheet.SchDoc, Power_Sheet.SchDoc, RS485_Sheet.SchDoc]
2023-04-27 #1 Changes done
    [Connector_Sheet.SchDoc, Controller_Sheet.SchDoc, DTMF_Decoder_Sheet.SchDoc, ESP32IOTProduct.PrjPcb, GPIOs_Expander_Relay_Sheet.SchDoc, GSM_Sheet.SchDoc, Power_Sheet.SchDoc]
2023-04-28 #1 Rs232 to Uart Added, Topsheet finished and dying gasp functionality added
    [Connector_Sheet.SchDoc, Controller_Sheet.SchDoc, DTMF_Decoder_Sheet.SchDoc, ESP32IOTProduct.PrjPcb, Ethernet_Sheet.SchDoc, GPIOs_Expander_Relay_Sheet.SchDoc, GSM_Sheet.SchDoc, Power_Sheet.SchDoc]
2023-05-02 #1 LEDs Added and Schematic cleared
    [Controller_Sheet.SchDoc, DTMF_Decoder_Sheet.SchDoc, ESP32IOTProduct.PrjPcb, GPIOs_Expander_Relay_Sheet.SchDoc, GSM_Sheet.SchDoc, LEDs.SchDoc, Power_Sheet.SchDoc, RS485_RS232_Sheet.SchDoc]
2023-05-02 #1 LED sheet renamed
    [ESP32IOTProduct.PrjPcb, LEDs_Sheet.SchDoc, Sheet1.SchDoc, Top_Sheet.SchDoc]
2023-05-02 #1 Schematic cleaned
    [GPIOs_Expander_Relay_Sheet.SchDoc, LEDs_Sheet.SchDoc]
2023-05-02 #1 Footprint added
    [Controller_Sheet.SchDoc, ESP32IOTProduct.PrjPcb, GSM_Sheet.SchDoc]
2023-05-02 #1 ..
    [ESP32IOTProduct.PrjPcb]
2023-05-03 #1 GSM SIMPWR changed to 2 GPIO control and screw terminal replaced with all same pitch
    [Connector_Sheet.SchDoc, Controller_Sheet.SchDoc, ESP32IOTProduct.PrjPcb, GPIOs_Expander_Relay_Sheet.SchDoc, GSM_Sheet.SchDoc, Top_Sheet.SchDoc]
2023-05-03 #1 Secure element IC added
    [Controller_Sheet.SchDoc, GPIOs_Expander_Relay_Sheet.SchDoc, RS485_RS232_Sheet.SchDoc, Top_Sheet.SchDoc]
2023-05-03 #1 PDF removed
    [Connector_Sheet.SchDoc, ESP32IOTProduct.PrjPcb, RS485_RS232_Sheet.SchDoc]
2023-05-03 #1 PDF Added
    [ESP32IOTProduct.PrjPcb]
2023-05-05 #1 All changes done except safety related and top sheet
    [Connector_Sheet.SchDoc, Controller_Sheet.SchDoc, DTMF_Decoder_Sheet.SchDoc, ESP32IOTProduct.PrjPcb, Ethernet_Sheet.SchDoc, GPIOs_Expander_Relay_Sheet.SchDoc, GSM_Sheet.SchDoc, LEDs_Sheet.SchDoc]
2023-05-05 Buck regulator 5V/5A added #2
    [Controller_Sheet.SchDoc, ESP32IOTProduct.PrjPcb, Ethernet_Sheet.SchDoc, Power_Sheet.SchDoc]
2023-05-08 #2 #1 All required changes done
    [Connector_Sheet.SchDoc, Controller_Sheet.SchDoc, DTMF_Decoder_Sheet.SchDoc, Ethernet_Sheet.SchDoc, GPIOs_Expander_Relay_Sheet.SchDoc, GSM_Sheet.SchDoc, LEDs_Sheet.SchDoc, Power_Sheet.SchDoc]
2023-05-08 #2 Net label edited
    [Ethernet_Sheet.SchDoc]
2023-05-09 #2 #1 Editing done
    [Connector_Sheet.SchDoc, Controller_Sheet.SchDoc, DTMF_Decoder_Sheet.SchDoc, GPIOs_Expander_Relay_Sheet.SchDoc, GSM_Sheet.SchDoc, Power_Sheet.SchDoc, RS485_RS232_Sheet.SchDoc]
2023-05-09 #3 j12 and r46 replaced
    [Connector_Sheet.SchDoc, Power_Sheet.SchDoc]
2023-05-09 #3 Capacitors replaced
    [GPIOs_Expander_Relay_Sheet.SchDoc, GSM_Sheet.SchDoc, Power_Sheet.SchDoc]
2023-05-09 #3 Updated Files
    [eSpark BOM.xlsx]
2023-05-09 DIV_ANT connector changed; Transistor footprint corrected #1
    [Ethernet_Sheet.SchDoc, GSM_Sheet.SchDoc]
2023-05-10 RJ45 connector changed #1
    [Ethernet_Sheet.SchDoc]
2023-05-10 Relays changed #1
    [GPIOs_Expander_Relay_Sheet.SchDoc]
2023-05-11 #4 Placement is progress (connector placement done)
    [ChrisByrd-IoT_Product.PcbDoc, DTMF_Decoder_Sheet.SchDoc, ESP32IOTProduct.PrjPcb]
2023-05-12 #1 #4 Test points added
    [ChrisByrd-IoT_Product.PcbDoc, Controller_Sheet.SchDoc, GSM_Sheet.SchDoc, Power_Sheet.SchDoc, Top_Sheet.SchDoc]
2023-05-12 #4 Placement in progress.
    [ChrisByrd-IoT_Product.PcbDoc]
2023-05-15 #4 Placement in progress. Controller and LED sheet remaining
    [ChrisByrd-IoT_Product.PcbDoc]
2023-05-16 Put Dying Gasp in Compile Mask #1
    [Power_Sheet.SchDoc]
2023-05-16 #4 Placement of Active Antenna and Controller in final stage
    [ChrisByrd-IoT_Product.PcbDoc]
2023-05-17 #4 Placement in progress for SIM Module after Active Antenna Clearance
    [ChrisByrd-IoT_Product.PcbDoc, Controller_Sheet.SchDoc, GSM_Sheet.SchDoc]
2023-05-18 #2 Net label corrected for 3V3
    [Controller_Sheet.SchDoc, GSM_Sheet.SchDoc]
2023-05-18 #4 Placement Completed
    [ChrisByrd-IoT_Product.PcbDoc]
2023-05-22 #2 AUX antenna connector moved to Compile Mask.
    [GSM_Sheet.SchDoc]
2023-05-23 RS232 TVS short corrected #2
    [RS485_RS232_Sheet.SchDoc]
2023-05-23 #2 RJ-45 Conn changed, LED and Cap removed from RS485 Schematic. Fuses designators corrected
    [Ethernet_Sheet.SchDoc, RS485_RS232_Sheet.SchDoc]
2023-05-23 #4 Placement completed after Client's concern.
    [ChrisByrd-IoT_Product.PcbDoc]
2023-05-25 #2 Diff added for RS485, C2,C4,C5,C7.C8 and C10 changed. D5 symbol and footprint updated.
    [Connector_Sheet.SchDoc, DTMF_Decoder_Sheet.SchDoc, Power_Sheet.SchDoc, RS485_RS232_Sheet.SchDoc]
2023-05-25 #4 Placement completed. U9 on Top now.
    [ChrisByrd-IoT_Product.PcbDoc, Top_Sheet.SchDoc]
2023-05-26 #4 Designing in progress
    [ChrisByrd-IoT_Product.PcbDoc, Controller_Sheet.SchDoc, Power_Sheet.SchDoc]
2023-05-29 #4 Power and some ICs routed
    [ChrisByrd-IoT_Product.PcbDoc]
2023-05-29 board size info updated in readme v2.0
2023-05-30 LTE sheet updated
    [LTE_Sheet.SchDoc]
2023-05-31 #6 Connector pins edited
    [LTE_Sheet.SchDoc]
2023-05-31 #7 mPCIe pins added
    [Module_Ethernet_Sheet.SchDoc]
2023-06-01 #6 Pin changed, GNSS antenna and SMA antenna to be selected
    [LTE_Sheet.SchDoc]
2023-06-01 #8 Schematic in progress
    [EthPoE-Module-v2.0.SchDoc]
2023-06-02 #6 connector in progress
    [LTE_Sheet.SchDoc]
2023-06-02 #6 Schematic completed
    [LTE_MODULE_v2.0.PrjPcb, LTE_Sheet.SchDoc]
2023-06-02 #6 Headings Added
    [LTE_Sheet.SchDoc]
2023-06-02 #8 POE added, RJ45 connector needs to be added
    [EthPoE-Module-v2.0.PrjPcb, EthPoE-Module-v2.0.SchDoc, EthPoE_Sheet.SchDoc, Ethernet_W5500.SchDoc]
2023-06-05 #6 SMA connector and GNSS antenna replaced
    [LTE_Sheet.SchDoc]
2023-06-05 #6 C39 replaced and R3, R4 added
    [LTE_Sheet.SchDoc]
2023-06-05 #6 Annotations edited
    [LTE_MODULE_v2.0.PrjPcb, LTE_Sheet.SchDoc]
2023-06-05 #10 Placement started
    [LTE-Module.PcbDoc, LTE_MODULE_v2.0.PrjPcb]
2023-06-05 #8 Schematic Completed
    [EthPoE-Module-v2.0.PrjPcb, EthPoE_Sheet.SchDoc, Ethernet_W5500.SchDoc, Top_Sheet.SchDoc]
2023-06-06 #8 C2 replaced
    [EthPoE_Sheet.SchDoc, Ethernet_W5500.SchDoc]
2023-06-06 #8 Comments added
    [EthPoE_Sheet.SchDoc]
2023-06-06 #7 Schematic complete
    [Ethernet-Module-v2.0.PrjPcb, Module_Ethernet_Sheet.SchDoc]
2023-06-06 #6 ESD added on POGO Connector
    [LTE_Sheet.SchDoc]
2023-06-06 #8 C2 added with footprint
    [EthPoE_Sheet.SchDoc]
2023-06-06 #10 Placement done. Routing in progress
    [LTE-Module.PcbDoc]
2023-06-06 PCB Part Placement Complete #15, Routing Remaining
    [EthPoE-Module-v2.0.PrjPcb, EthPoE_Sheet.SchDoc, Eth_PoE.PcbDoc, Ethernet_W5500.SchDoc]
2023-06-06 #16 In progress
    [Client_BOM_v2.0.xlsx, eSpark_BOM_v2.0.xlsx]
2023-06-06 Routing of U2 done: Rest in-progress: #15
    [EthPoE-Module-v2.0.PrjPcb, EthPoE_Sheet.SchDoc, Eth_PoE.PcbDoc, Ethernet_W5500.SchDoc, Top_Sheet.SchDoc]
2023-06-07 Routing Completed, One DRC error and some formatting remaining #15
    [EthPoE-Module-v2.0.PrjPcb, Eth_PoE.PcbDoc, Top_Sheet.SchDoc]
2023-06-07 #10 Routing completed, couple of finishing need to be done
    [LTE-Module.PcbDoc, LTE_MODULE_v2.0.PrjPcb]
2023-06-07 #9 Schematic Completed
    [LoRaWAN-Module-v2.0.PrjPcb, LoRaWAN-Sheet.SchDoc]
2023-06-07 #15 In-progress: Designator formatting done. Length matching done.
    [EthPoE-Module-v2.0.PrjPcb, EthPoE_Sheet.SchDoc, Eth_PoE.PcbDoc, Ethernet_W5500.SchDoc, Top_Sheet.SchDoc]
2023-06-08 Module board dimensions
2023-06-08 #16 Completed
    [Client_BOM_v2.0.xlsx, eSpark_BOM_v2.0.xlsx]
2023-06-08 #6 Mini PCIe connector replaced
    [LTE_Sheet.SchDoc]
2023-06-08 #6 PRJPCB upadated
    [LTE_MODULE_v2.0.PrjPcb]
2023-06-08 #10 Annotations added
    [LTE_Sheet.SchDoc]
2023-06-08 #7 Mini PCIe replaced and RJ45 connector replaced
    [Module_Ethernet_Sheet.SchDoc]
2023-06-08 PCB placement info updated in PRD
2023-06-08 #12 mini PCIe and RJ45 Connector replaced
    [EthPoE-Module-v2.0.PrjPcb, EthPoE_Sheet.SchDoc, Ethernet_Sheet_W5500.SchDoc, Ethernet_W5500.SchDoc, Top_Sheet.SchDoc]
2023-06-08 #19 Schematic completed
    [OLED-Sheet.SchDoc, OLED-v2.0.PrjPcb]
2023-06-08 #10 Placement finalized after SIM Card Holder location changed
    [LTE-Module.PcbDoc, LTE_MODULE_v2.0.DXF]
2023-06-08 #15 Part placement of some components miscellaneous remaining
    [Eth_PoE.PcbDoc]
2023-06-08 #6 #10 SMA connector replaced
    [LTE_Sheet.SchDoc]
2023-06-08 #9 SMA connector and Mini PCIe replaced
    [LoRaWAN-Sheet.SchDoc]
2023-06-08 #17 Completed
    [Client_BOM_Ethernet-Module-v2.0.xlsx, eSpark_BOM_Ethernet-Module-v2.0.xlsx]
2023-06-08 #9 Connector pins changed
    [LoRaWAN-Module-v2.0.PrjPcb, LoRaWAN-Sheet.SchDoc]
2023-06-08 #6 PCIe connector replaced
    [LTE_Sheet.SchDoc]
2023-06-08 #7 PCIe connector replaced
    [Module_Ethernet_Sheet.SchDoc]
2023-06-08 #7 Annotation done
    [Module_Ethernet_Sheet.SchDoc]
2023-06-08 #8 PCIe connector replaced
    [EthPoE-Module-v2.0.PrjPcb, EthPoE_Sheet.SchDoc]
2023-06-08 #5 Schematic in progress
    [Baseboard-v2.0.PrjPcb, Baseboard_Sheet.SchDoc, Connector.SchDoc, Sheet2.SchDoc, Sheet3.SchDoc]
2023-06-08 #10 : Routing for J1, J3 and ANT1 done: Rest remaining.
    [LTE-Module.PcbDoc, LTE_MODULE_v2.0.PrjPcb, LTE_Sheet.SchDoc]
2023-06-09 #10 #6 C6 capacitor replaced with tantulum
    [LTE_Sheet.SchDoc]
2023-06-09 #16 Resistor added SMA Connector and Capacitor C6 Changed
    [Client_BOM_v2.0.xlsx, eSpark_BOM_v2.0.xlsx]
2023-06-09 #15 Routing in Progress
    [EthPoE_Sheet.SchDoc, Eth_PoE.PcbDoc, Ethernet_Sheet_W5500.SchDoc]
2023-06-09 #15 #8 0.1uf Capacitors replaced, other component replacement remaining
    [EthPoE_Sheet.SchDoc, Ethernet_Sheet_W5500.SchDoc]
2023-06-09 #19 Schematic in progress
    [OLED-Sheet.SchDoc]
2023-06-09 #10 PCB size reduced 53mm x 33mm
    [LTE-Module.PcbDoc]
2023-06-12 #8 #15 Components replaced with smaller ones
    [EthPoE_Sheet.SchDoc, Ethernet_Sheet_W5500.SchDoc]
2023-06-12 #15 #8 C5 replaced
    [EthPoE_Sheet.SchDoc]
2023-06-12 Antenna information updated
2023-06-12 #10 Finishing in progress
    [LTE-Module.PcbDoc]
2023-06-12 #10 Design Completed
    [LTE-Module.PcbDoc, LTE_MODULE_v2.0.PrjPcb]
2023-06-12 #10 U1 pin 1 Indication changed: Q2 designator position changed.
    [LTE-Module.PcbDoc, LTE_Sheet.SchDoc]
2023-06-12 PCB dimensions updated
2023-06-13 #10 Client's Amendments done. Mounting hole same as before.
    [LTE-Module.PcbDoc]
2023-06-13 mPCIE slot info updated in PRD
2023-06-13 #15 PCB routing Done
    [EthPoE-Module-v2.0.PrjPcb, Eth_PoE.PcbDoc]
2023-06-13 #14 Placement in progress
    [Ethernet-Module-v2.0.PrjPcb, Ethernet-Module.PcbDoc]
2023-06-13 #5 ESP32, Flash added
    [Baseboard-v2.0.PrjPcb, Connector.SchDoc, Controller_Sheet.SchDoc, GPIOs_Expander_Relay_Sheet.SchDoc, Sheet1.SchDoc, mPCIe_Connector_Sheet.SchDoc]
2023-06-13 #23 Done: Minor corrections in Routing and Designator done.
    [EthPoE-Module-v2.0.PrjPcb, EthPoE_Sheet.SchDoc, Eth_PoE.PcbDoc, Ethernet_Sheet_W5500.SchDoc, Top_Sheet.SchDoc]
2023-06-14 #24 PCB parts Placement and Routing Done( shielding vias are remaining for 1GHz)
    [LoRaWAN-Module-v2.0.PrjPcb, LoRaWAN-Sheet.SchDoc, LoRaWAN_v2.0.PcbDoc]
2023-06-14 #14 PCB in progress
    [Ethernet-Module-v2.0.PrjPcb, Ethernet-Module.PcbDoc]
2023-06-14 #7 #14 10k resistors replaced with 0201 package
    [Module_Ethernet_Sheet.SchDoc]
2023-06-14 #14 Routing in progress
    [Ethernet-Module.PcbDoc]
2023-06-14 #15 Correction done, (track for VDDA updated from FB to Controller, POE_5V trace width increase), Placement of U4 remaining
    [EthPoE-Module-v2.0.PrjPcb, Eth_PoE.PcbDoc]
2023-06-14 #5 pin placement done, Antenna remaining
    [Connector.SchDoc, Controller_Sheet.SchDoc, GPIOs_Expander_Relay_Sheet.SchDoc, mPCIe_Connector_Sheet.SchDoc]
2023-06-14 #24 Layer Stackup set for 1mm thickness.
    [LoRaWAN-Module-v2.0.PrjPcb, LoRaWAN-Sheet.SchDoc, LoRaWAN_v2.0.PcbDoc]
2023-06-14 #15 J1 Connector Updated: Custom Layer Stackup set for 1mm PCB Thickness.
    [EthPoE-Module-v2.0.PrjPcb, EthPoE_Sheet.SchDoc, Eth_PoE.PcbDoc, Ethernet_Sheet_W5500.SchDoc, Top_Sheet.SchDoc]
2023-06-15 #15 (ARJM11D7-114-AB-EW2) Ethernet connector in PCB
    [Eth_PoE.PcbDoc, Ethernet_Sheet_W5500.SchDoc]
2023-06-15 #24 Via shielding added for 1GHz on board and RF trace.
    [LoRaWAN_v2.0.PcbDoc]
2023-06-15 Unnecessary Polygon deleted
    [LoRaWAN_v2.0.PcbDoc]
2023-06-15 #24 #9 10k resistors replaced with 0201 package
    [LoRaWAN-Module-v2.0.PrjPcb, LoRaWAN-Sheet.SchDoc]
2023-06-15 #5 Pin placement done, antenna and top sheet remaining
    [Baseboard-v2.0.PrjPcb, Connector.SchDoc, Controller_Sheet.SchDoc, DTMF_Decoder_Sheet.SchDoc, GPIOs_Expander_Relay_Sheet.SchDoc, Power_Sheet.SchDoc, RS485_RS232_Sheet.SchDoc, Top_Sheet.SchDoc]
2023-06-15 #10 MH updated, GND via connect switched to Direct connect.
    [LTE-Module.PcbDoc]
2023-06-16 #24 10K resistors updated in PCB with 0201 package
    [LoRaWAN-Module-v2.0.PrjPcb, LoRaWAN_v2.0.PcbDoc]
2023-06-16 #10 Stackup and Differential route updated.
    [LTE-Module.PcbDoc]
2023-06-16 layer stack set to 1mm according to PRD
    [LoRaWAN_v2.0.PcbDoc]
2023-06-16 #5 Schematic completed but review remaining
    [Baseboard-v2.0.PrjPcb, Connector.SchDoc, Controller_Sheet.SchDoc, DTMF_Decoder_Sheet.SchDoc, GPIOs_Expander_Relay_Sheet.SchDoc, Power_Sheet.SchDoc, RS485_RS232_Sheet.SchDoc, Sheet1.SchDoc]
2023-06-16 #14 #7 #13 Connector Replaced and mini PCIe pin routing changed
    [Ethernet-Module-v2.0.PrjPcb, Module_Ethernet_Sheet.SchDoc]
2023-06-16 #12 #15 #8 Mini PCIe pins changed, connector replaced
    [EthPoE-Module-v2.0.PrjPcb, EthPoE_Sheet.SchDoc, Ethernet_Sheet_W5500.SchDoc]
2023-06-16 #24 #25 Mini PCIE connections edited
    [LoRaWAN-Module-v2.0.PrjPcb, LoRaWAN-Sheet.SchDoc]
2023-06-16 #5 Mini PCEIe female connector replaced with 9.9mm connector
    [mPCIe_Connector_Sheet.SchDoc]
2023-06-17 #24 Done: Changes in Routing for Mini PCIE updated in PCB.
    [LoRaWAN-Module-v2.0.PrjPcb, LoRaWAN-Sheet.SchDoc, LoRaWAN_v2.0.PcbDoc]
2023-06-17 #26 Done: Review done: Fresh Deliverables created.
    [Centroid Files.csv, LoRaWAN-Module-v2.0.PrjPcb, LoRaWAN-Sheet.SchDoc, LoRaWAN_v2.0.DWG, LoRaWAN_v2.0.DXF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]
2023-06-17 #22 Done: Extra Mounting Holes deleted: Fresh Deliverables generated.
    [Centroid Files.csv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]
2023-06-19 #14 MPci connection updated in PCB, RJ45 need to be updated.
    #
    [Ethernet-Module.PcbDoc]
2023-06-19 #15 MPCI connections updated in PCB, RJ45 needs to be updated
    [EthPoE-Module-v2.0.PrjPcb, EthPoE_Sheet.SchDoc, Eth_PoE.PcbDoc, Ethernet_Sheet_W5500.SchDoc, Top_Sheet.SchDoc]
2023-06-19 #25 #24 Mini PCIe replaced
    [LoRaWAN-Module-v2.0.PrjPcb, LoRaWAN-Sheet.SchDoc]
2023-06-19 #15 #12 Mini PCIe connector replaced
    [EthPoE_Sheet.SchDoc]
2023-06-19 #14 #13 Mini PCIe connector replaced
    [Module_Ethernet_Sheet.SchDoc]
2023-06-19 #15 #13 Mini PCIe connector Replaced
    [Module_Ethernet_Sheet.SchDoc]
2023-06-19 #5 All changes done except DTMF
    [Connector.SchDoc, Controller_Sheet.SchDoc, GPIOs_Expander_Relay_Sheet.SchDoc, Top_Sheet.SchDoc, mPCIe_Connector_Sheet.SchDoc]
2023-06-19 #11 #10 Antenna replaced
    [LTE_MODULE_v2.0.PrjPcb, LTE_Sheet.SchDoc]
2023-06-19 #24 #26 Done: Changes for MPCIE done: Fresh Deliverables created.
    [Centroid File.csv, LoRaWAN-Module-v2.0.PrjPcb, LoRaWAN-Sheet.SchDoc, LoRaWAN_v2.0.DWG, LoRaWAN_v2.0.DXF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]
2023-06-19 #10 #22 Done: Changes in PCB done and Fresh Deliverables created.
    [Centroid File.csv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]
2023-06-19 Extra folder removed #14
    [Client_BOM_Ethernet-Module-v2.0.xlsx, Ethernet-Module-v2.0.PrjPcb, Ethernet-Module.PcbDoc, Module_Ethernet_Sheet.SchDoc, eSpark_BOM_Ethernet-Module-v2.0.xlsx]
2023-06-20 #19 Schematic Design Complete - Footprint, component library change remaining
    [OLED-Sheet.SchDoc]
2023-06-21 #19 Schematic Updated
    Schematics Updated
    [OLED-Sheet.SchDoc]
2023-06-21 #14 #6 #13 RJ45 connector replaced
    [Module_Ethernet_Sheet.SchDoc]
2023-06-21 #15 #12 #8 RJ45 connector replaced
    [Ethernet_Sheet_W5500.SchDoc]
2023-06-21 #19 OLED Updated Schematics
    [OLED-Sheet.SchDoc]
2023-06-21 #19 Updated Schematics OLED
    [OLED-Sheet.SchDoc]
2023-06-21 #16 BOM update according to design CHanges.
    [Client_BOM_v2.0.xlsx, eSpark_BOM_v2.0.xlsx]
2023-06-21 #5 All changes done
    [Connector.SchDoc, Controller_Sheet.SchDoc, DTMF_Decoder_Sheet.SchDoc, GPIOs_Expander_Relay_Sheet.SchDoc, Power_Sheet.SchDoc, RS485_RS232_Sheet.SchDoc, Top_Sheet.SchDoc, mPCIe_Connector_Sheet.SchDoc]
2023-06-21 #18 eSpark and Client BOM Added
    [Client_BOM_EthPoE-Module-v2.0.xlsx, eSaprk_BOM_EthPoE-Module-v2.0.xlsx]
2023-06-22 #21 PCB parts Placement in Progress (GPIO and RS485 sheet remaining)
    [Baseboard-v2.0.PcbDoc, Baseboard-v2.0.PrjPcb, Connector.SchDoc, Controller_Sheet.SchDoc, DTMF_Decoder_Sheet.SchDoc, Power_Sheet.SchDoc, mPCIe_Connector_Sheet.SchDoc]
2023-06-23 Phone simulation circuit requirements updated
2023-06-23 PCB Part Placement in Progress
    [Baseboard-v2.0.PrjPcb]
2023-06-23 #5 DTMF PWM circuit added, RF switch changed
    [Baseboard-v2.0.PrjPcb, Controller_Sheet.SchDoc, DTMF_Decoder_Sheet.SchDoc]
2023-06-26 #19 Minor adjustments done
    [OLED-Sheet.SchDoc]
2023-06-26 #5 Pullup added for buttons
    [Controller_Sheet.SchDoc]
2023-06-26 #10 #6 Antenna changed and nano sim added
    [LTE_MODULE_v2.0.PrjPcb, LTE_Sheet.SchDoc]
2023-06-26 #6 ESD protection added
    [LTE_Sheet.SchDoc]
2023-06-26 #5 Antenna net label changed
    [Controller_Sheet.SchDoc]
2023-06-26 #5 PDF added for baseboard
    [Baseboard-v2.0.PrjPcb, Connector.SchDoc, Controller_Sheet.SchDoc, mPCIe_Connector_Sheet.SchDoc]
2023-06-26 #10 #11 #6 Chip select added for both SIM module
    [LTE_Sheet.SchDoc]
2023-06-26 #5 0R resistor replaced
    [Baseboard-v2.0.PrjPcb, DTMF_Decoder_Sheet.SchDoc]
2023-06-26 #21 Parts Placement completed
    [Baseboard-v2.0.PcbDoc]
2023-06-26 #21 Placement edited: Parts moved and Text edited.
    [Baseboard-v2.0.PcbDoc, Baseboard-v2.0.PrjPcb, Connector.SchDoc, Controller_Sheet.SchDoc, DTMF_Decoder_Sheet.SchDoc, GPIOs_Expander_Relay_Sheet.SchDoc, Power_Sheet.SchDoc, RS485_RS232_Sheet.SchDoc]
2023-06-26 #19 Placement And Routing Completed
    [OLED-Sheet.SchDoc, OLED-v2.0.PrjPcb, OLED_v2.0.PcbDoc]
2023-06-26 #29 eSpark BOM Completed
    [eSpark_BOM_Baseboard-v2.0.xlsx]
2023-06-27 #19 Rearrange Designator and Review Completed
    [OLED-Sheet.SchDoc, OLED_v2.0.PcbDoc]
2023-06-27 Baseboard SMA connector info updated in PRD
2023-06-27 #15 #12 #8 RJ45 connector replaced with ARJM11D7-114-AB-EW2 and U1 replaced with different package
    [EthPoE_Sheet.SchDoc, Ethernet_Sheet_W5500.SchDoc]
2023-06-27 #16 eSpark and Client BOM updates acc to design.
    [Client_BOM_v2.0.xlsx, eSpark_BOM_v2.0.xlsx]
2023-06-27 #14 #13 #7 RJ45 connector replaced with ARJM11D7-114-AB-EW2
    [Module_Ethernet_Sheet.SchDoc]
2023-06-27 #21 Board dimensions reduced horizontally and increased vertically , Components at bottom sifted at top, PCB Parts Placement completed, Some designator formatting Remaining
    [Baseboard-v2.0.PcbDoc]
2023-06-27 #5 #21 UFL antenna replaced with SMA antenna
    [Controller_Sheet.SchDoc]
2023-06-27 #17 eSpark and Client BOM Updated acc to design
    [Client_BOM_Ethernet-Module-v2.0.xlsx, eSpark_BOM_Ethernet-Module-v2.0.xlsx]
2023-06-27 #18 Client and eSpark BOM updated acc to Design
    [Client_BOM_EthPoE-Module-v2.0.xlsx, eSaprk_BOM_EthPoE-Module-v2.0.xlsx]
2023-06-27 #19 Mounting Hole Changed from 3mm to 2mm
    [OLED_v2.0.PcbDoc]
2023-06-27 #16 Supplier link added in eSpark BOM
    [eSpark_BOM_v2.0.xlsx]
2023-06-27 #15 RJ45, U1 updated in PCB, Routing completed , No DRC error
    [EthPoE-Module-v2.0.PrjPcb, Eth_PoE.PcbDoc]
2023-06-27 #31 eSpark and Client BOM Completed
    [Client_BOM_LoRaWAN-Module-v2.0.xlsx, eSpark_BOM_LoRaWAN-Module-v2.0.xlsx]
2023-06-27 Changed directories
    [Centroid File.csv, Client_BOM_LoRaWAN-Module-v2.0.xlsx, LoRaWAN-Module-v2.0.PrjPcb, LoRaWAN-Sheet.SchDoc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]
2023-06-27 Module address changed #10
    [LTE_Sheet.SchDoc]
2023-06-28 RJ45 updated, Routing completed, NO DRC error.
    [Ethernet-Module-v2.0.PrjPcb, Ethernet-Module.PcbDoc, Module_Ethernet_Sheet.SchDoc]
2023-06-28 SMA centralized acc to baseboard cutout, Shielding vias added to trace and PCB as well.
    [LoRaWAN-Module-v2.0.PrjPcb, LoRaWAN_v2.0.PcbDoc]
2023-06-28 Sim connectors Antenna updated in PCB, Routing done , NO DRC error
    [LTE-Module.PcbDoc, LTE_MODULE_v2.0.PrjPcb, LTE_Sheet.SchDoc]
2023-06-28 Overlay for cutout of MPCi placed inside the board
    [Ethernet-Module.PcbDoc]
2023-06-28 LTE board pdf generated #6
2023-06-28 Ethernet board pdf generated #7
2023-06-28 EthPoE board pdf generated #8
2023-06-28 OLED board pdf generated #19
2023-07-02 #10 Changes in PCB for Text of SIMA and SIMB and Old Gerbers and Pick n Place deleted.
    [Centroid File.csv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]
2023-07-02 #24 Components locked: Old Gerbers and Pick n Place files deleted.
    [Centroid File.csv, LoRaWAN-Module-v2.0.PrjPcb, LoRaWAN-Sheet.SchDoc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]
2023-07-02 #14 Components locked: DRC error removed.
    [Ethernet-Module-v2.0.PrjPcb, Ethernet-Module.PcbDoc, Module_Ethernet_Sheet.SchDoc]
2023-07-02 #15 Drill Table and Layer STack table added.
    [EthPoE-Module-v2.0.PrjPcb, EthPoE_Sheet.SchDoc, Eth_PoE.PcbDoc, Ethernet_Sheet_W5500.SchDoc, Top_Sheet.SchDoc]
2023-07-03 #5 J12, OLED right angled connector replaced with 90 degree connector
    [Controller_Sheet.SchDoc]
2023-07-03 #30 #5 C7,C8,C11,C14 replaced with tantulum, GND+ replaced with GND, Relays replaced with J102K1CS35VDC.20, zener diodes pin placement changed, DC_POK pin added
    [DTMF_Decoder_Sheet.SchDoc, GPIOs_Expander_Relay_Sheet.SchDoc, Power_Sheet.SchDoc, Top_Sheet.SchDoc, mPCIe_Connector_Sheet.SchDoc]
2023-07-03 #10 Changes in PCB for Text.
    [LTE-Module.PcbDoc, LTE_Sheet.SchDoc]
2023-07-03 #29 eSpark BOM updated
    [Client_BOM_Baseboard-v2.0.xlsx, eSpark_BOM_Baseboard-v2.0.xlsx]
2023-07-04 #30 #21 #5 Resistors added for slot indication
    [DTMF_Decoder_Sheet.SchDoc, GPIOs_Expander_Relay_Sheet.SchDoc, Power_Sheet.SchDoc]
2023-07-04 #10 #6 #16 Indication resistors removed
    [LTE_Sheet.SchDoc]
2023-07-04 #17 #14 #7 Indication resistors removed
    [Ethernet-Module-v2.0.PrjPcb, Module_Ethernet_Sheet.SchDoc]
2023-07-04 #18 #15 #8 Indication resistors removed
    [EthPoE-Module-v2.0.PrjPcb, EthPoE_Sheet.SchDoc]
2023-07-04 #31 #9 #24 Indication resistors removed
    [LoRaWAN-Module-v2.0.PrjPcb, LoRaWAN-Sheet.SchDoc]
2023-07-04 #5 #21 Crystal X2 changed and pins for RS485 and RS232 switched
    [Connector.SchDoc, DTMF_Decoder_Sheet.SchDoc, GPIOs_Expander_Relay_Sheet.SchDoc]
2023-07-04 #21 Placement In progress
    [Baseboard-v2.0.PcbDoc]
2023-07-04 #31 0R resistor added in BOM
    [Client_BOM_LoRaWAN-Module-v2.0.xlsx, eSpark_BOM_LoRaWAN-Module-v2.0.xlsx]
2023-07-04 #17 0R resistor added 10k resistor deleted.
    [Client_BOM_Ethernet-Module-v2.0.xlsx, eSpark_BOM_Ethernet-Module-v2.0.xlsx]
2023-07-04 #16 0R resistor added 10K resistor remove
    [Client_BOM_v2.0.xlsx, eSpark_BOM_v2.0.xlsx]
2023-07-04 #18 0R resistor Added 10K resistor remove
    [Client_BOM_EthPoE-Module-v2.0.xlsx, eSaprk_BOM_EthPoE-Module-v2.0.xlsx]
2023-07-04 #21 Placement is in Progress
    [Baseboard-v2.0.PcbDoc, Controller_Sheet.SchDoc, DTMF_Decoder_Sheet.SchDoc, GPIOs_Expander_Relay_Sheet.SchDoc]
2023-07-04 #29 eSpark BOM Updated Digikey remaining
    [Client_BOM_Baseboard-v2.0.xlsx, eSpark_BOM_Baseboard-v2.0.xlsx]
2023-07-05 J19 placed at top-left corner, controller circuitry moved accordingly.
    [Baseboard-v2.0.PcbDoc, Baseboard-v2.0.PrjPcb]
2023-07-05 #10 #6 Floating pins error removed
    [LTE_Sheet.SchDoc]
2023-07-05 #7 #14 Floating pins error removed
    [Module_Ethernet_Sheet.SchDoc]
2023-07-05 #8 #15 Floating pins error removed
    [EthPoE_Sheet.SchDoc]
2023-07-05 #9 #24 Floating pins error removed
    [LoRaWAN-Sheet.SchDoc]
2023-07-05 Resistor updated in PCB no DRC error.
    [EthPoE-Module-v2.0.PrjPcb, Eth_PoE.PcbDoc]
2023-07-05 Resistor updated, No drc error
    [LoRaWAN-Module-v2.0.PrjPcb, LoRaWAN_v2.0.PcbDoc]
2023-07-05 Resistor updated, serial text updated, No DRC error
    [LTE-Module.PcbDoc, LTE_MODULE_v2.0.PrjPcb]
2023-07-05 #10 #6 pullup for Sim Detection changed with 1.8V
    [LTE_Sheet.SchDoc]
2023-07-05 Connections updated in PCB, No DRC error
    [LTE-Module.PcbDoc]
2023-07-05 #21 Placement Completed
    [Baseboard-v2.0.PcbDoc, GPIOs_Expander_Relay_Sheet.SchDoc, Power_Sheet.SchDoc]
2023-07-05 #21 Latest Updated PCB Design
    [Baseboard-v2.0.PcbDoc]
2023-07-05 Placement complete; conflicts resolved #21
    [Baseboard-v2.0.PcbDoc, GPIOs_Expander_Relay_Sheet.SchDoc, Power_Sheet.SchDoc]
2023-07-05 #29 Digikey BOM Completed
    [Client_BOM_Baseboard-v2.0.xlsx]
2023-07-05 #28 eSpark and Client BOM Completed
    [Client_BOM_OLED-v2.0.xlsx, eSpark_BOM_OLED-v2.0.xlsx]
2023-07-06 #8 #15 #18 Fuse replaced and R11 added
    [EthPoE-Module-v2.0.PrjPcb, EthPoE_Sheet.SchDoc, Ethernet_Sheet_W5500.SchDoc]
2023-07-06 #7 #14 #17 4.7k Resistor added (R30)
    [Ethernet-Module-v2.0.PrjPcb, Module_Ethernet_Sheet.SchDoc]
2023-07-07 Antenna placement changed, Mounting hole displace 2mm in x-axis and 1mm in y-axis.
    [LTE-Module.PcbDoc]
2023-07-07 Resistor and fuse updated, Polygon cut placed under RJ45, mounting hole displaced.
    [EthPoE-Module-v2.0.PrjPcb, Eth_PoE.PcbDoc]
2023-07-07 Resistor updated, Polygon cutout placed under RJ45, Mounting hole displaced
    [Ethernet-Module-v2.0.PrjPcb, Ethernet-Module.PcbDoc, Module_Ethernet_Sheet.SchDoc]
2023-07-07 Mounting hole updated
    [LoRaWAN_v2.0.PcbDoc]
2023-07-07 RJ45 move further from 38.466mm to 39.106mm
    [Eth_PoE.PcbDoc]
2023-07-07 RJ45 moved from 38.466mm to 39.106mm
    [Ethernet-Module.PcbDoc]
2023-07-07 U4 moved upward (away from holes of Rj45)
    [Eth_PoE.PcbDoc]
2023-07-07 #18 Fuse and R11 added in BOM
    [Client_BOM_EthPoE-Module-v2.0.xlsx, eSaprk_BOM_EthPoE-Module-v2.0.xlsx, eSpark_BOM_EthPoE-Module-v2.0.xlsx]
2023-07-10 #17 4.7K Resistor Added (R30) in BOM
    [Client_BOM_Ethernet-Module-v2.0.xlsx, eSpark_BOM_Ethernet-Module-v2.0.xlsx]
2023-07-10 #5 #21 Replaced 10k resistor array with 100k array
    [GPIOs_Expander_Relay_Sheet.SchDoc]
2023-07-12 #32 Design in progress
    [OLED-Sheet.SchDoc]
2023-07-12 #32 Required changes in progress
    [OLED-Sheet.SchDoc, OLED-v2.0.PrjPcb]
2023-07-13 #32 Old files updated
    [Client_BOM_OLED-v2.0.xlsx, OLED-Sheet.SchDoc, OLED-v2.0.PrjPcb, eSpark_BOM_OLED-v2.0.xlsx]
2023-07-13 #32 Schematic completed (Connector pin placement remaining)
    [Adv-OLED-Sheet.SchDoc, Adv-OLED-v2.0.PrjPcb, Adv-OLED_v2.0.PcbDoc, Client_BOM_OLED-v2.0.xlsx, eSpark_BOM_OLED-v2.0.xlsx]
2023-07-13 #19 #28 J2 Connector changed
    [OLED-Sheet.SchDoc, OLED-v2.0.PrjPcb]
2023-07-13 #32 Schematic completed
    [Adv-OLED-Sheet.SchDoc]
2023-07-13 #29 #5 #21 J12 changed, R3 changed to DNP, C7,C8 replaced, SB3 added
    [Connector.SchDoc, Controller_Sheet.SchDoc, GPIOs_Expander_Relay_Sheet.SchDoc, Power_Sheet.SchDoc, Top_Sheet.SchDoc]
2023-07-13 #19 PCB Design Updated Including Updated Connector and its Routing
    [OLED-v2.0.PrjPcb, OLED_v2.0.PcbDoc, OLED_v2.0.step]
2023-07-14 RoHS logo added on Top layer
    [Ethernet-Module.PcbDoc]
2023-07-14 RoHS logo added on top overlay
    [Eth_PoE.PcbDoc]
2023-07-14 RoHS logo added in Top overlay
    [LoRaWAN_v2.0.PcbDoc]
2023-07-14 # Working on PCB Design
    [Adv-OLED-v2.0.PrjPcb, Adv-OLED_v2.0.PcbDoc, Adv-OLED_v2.0.step, Sample PCB.PcbDoc, Sample PCB.step]
2023-07-14 #33 Placement Completed
    [Adv-OLED_v2.0.PcbDoc]
2023-07-20 #33 Routing Completed.
    [Adv-OLED-v2.0.PrjPcb, Adv-OLED_v2.0.PcbDoc, Sample PCB.PcbDoc]
2023-07-20 #29 Changes update in eSpark and Client BOM
    [Client_BOM_Baseboard-v2.0.xlsx, eSpark_BOM_Baseboard-v2.0.xlsx]
2023-07-20 #28 eSpark and client BOM updated
    [Client_BOM_OLED-v2.0.xlsx, eSpark_BOM_OLED-v2.0.xlsx]
2023-07-24 #17 Peripheral Added
    [Client_BOM_Ethernet-Module-v2.0.xlsx, eSpark_BOM_Ethernet-Module-v2.0.xlsx]
2023-07-24 #31 Antenna Added in Peripheral
    [Client_BOM_LoRaWAN-Module-v2.0.xlsx, eSpark_BOM_LoRaWAN-Module-v2.0.xlsx]
2023-07-24 #29 peripheral added
    [Client_BOM_Baseboard-v2.0.xlsx, eSpark_BOM_Baseboard-v2.0.xlsx]
2023-07-24 #18 Peripheral added
    [Client_BOM_EthPoE-Module-v2.0.xlsx, eSpark_BOM_EthPoE-Module-v2.0.xlsx]
2023-07-25 #10 Changes in Progress (Based on Review)
    [LTE-Module.PcbDoc, LTE_Sheet.SchDoc]
2023-07-25 #31 Antenna Change in BOM.
    [Client_BOM_LoRaWAN-Module-v2.0.xlsx, eSpark_BOM_LoRaWAN-Module-v2.0.xlsx]
2023-07-25 #29 Antenna change in BOM.
    [Client_BOM_Baseboard-v2.0.xlsx, eSpark_BOM_Baseboard-v2.0.xlsx]
2023-07-25 #16 Antenna change in BOM
    [Client_BOM_v2.0.xlsx, eSpark_BOM_v2.0.xlsx]
2023-07-25 #21 Add 9X Mounting Holes, Increase board size from 110mm to 114mm
    [Baseboard-v2.0.PcbDoc]
2023-07-26 #10 LTE PCB Design Updated
    [LTE-Module.PcbDoc, LTE_MODULE_v2.0.PrjPcb]
2023-07-27 #10 #22 Design reviewed after @espark-asim modification.
    [LTE-Module.PcbDoc, LTE_MODULE_v2.0.PrjPcb]
2023-07-31 #15 Routing Completed
    [EthPoE-Module-v2.0.PrjPcb, Eth_PoE.PcbDoc, Ethernet_Sheet_W5500.SchDoc]
2023-08-01 #15 Added RoHS Logo
    [Eth_PoE.PcbDoc]
2023-08-01 #10 Added RoHS Logo and PCB Version
    [LTE-Module.PcbDoc]
2023-08-01 #24 Adding RoHS Logo, Version. Update Routing and Polygon
    [LoRaWAN-Module-v2.0.PrjPcb, LoRaWAN_v2.0.PcbDoc]
2023-08-02 #7 #14 #17 U2 replaced by D1 and D2
    [Module_Ethernet_Sheet.SchDoc]
2023-08-02 #18 #15 #8 U4 replaced with D3and D4
    [EthPoE-Module-v2.0.PrjPcb, Ethernet_Sheet_W5500.SchDoc]
2023-08-02 #29 #21 #5 J19 replaced with SMA175
    [Controller_Sheet.SchDoc]
2023-08-02 #16 #10 #6 J1 replaced with SMA175
    [LTE_MODULE_v2.0.PrjPcb, LTE_Sheet.SchDoc]
2023-08-02 #24 #9 #31 J2 replaced with SMA175
    [LoRaWAN-Sheet.SchDoc]
2023-08-02 #17 Client BOM Updated.
    [Client_BOM_Ethernet-Module-v2.0.xlsx, eSpark_BOM_Ethernet-Module-v2.0.xlsx]
2023-08-02 #18 Client BOM Updated.
    [Client_BOM_EthPoE-Module-v2.0.xlsx, eSpark_BOM_EthPoE-Module-v2.0.xlsx]
2023-08-02 #16 Client BOM Updated.
    [Client_BOM_v2.0.xlsx, eSpark_BOM_v2.0.xlsx]
2023-08-02 #29 Client BOM Updated.
    [Client_BOM_Baseboard-v2.0.xlsx, eSpark_BOM_Baseboard-v2.0.xlsx]
2023-08-02 #31 Client BOM Updated.
    [Client_BOM_LoRaWAN-Module-v2.0.xlsx, eSpark_BOM_LoRaWAN-Module-v2.0.xlsx]
2023-08-02 #17 Update Routing, Polygon, Designators and some Major changes after Review Like decoupling Cap, TVS Diode etc
    [Ethernet-Module-v2.0.PrjPcb, Ethernet-Module.PcbDoc, Module_Ethernet_Sheet.SchDoc]
2023-08-02 Revert "#17 Update Routing, Polygon, Designators and some Major changes after Review Like decoupling Cap, TVS Diode etc"
    This reverts commit 688d5b2962fcc22ab0c9fa9971c44eb8cc31306d.
    [Ethernet-Module-v2.0.PrjPcb, Ethernet-Module.PcbDoc, Module_Ethernet_Sheet.SchDoc]
2023-08-02 #14 Update Routing, Polygon, Designators and some Major changes after Review
    [Ethernet-Module-v2.0.PrjPcb, Ethernet-Module.PcbDoc]
2023-08-03 #24 J2 SMA508 connector replaced with SMA175
    [LoRaWAN-Module-v2.0.PrjPcb, LoRaWAN_v2.0.PcbDoc]
2023-08-03 #10 J1 SMA508 connector replaced with SMA175
    [LTE-Module.PcbDoc, LTE_MODULE_v2.0.PrjPcb]
2023-08-03 #15 U4 replaced with D3 and D4
    [EthPoE-Module-v2.0.PrjPcb, Eth_PoE.PcbDoc]
2023-08-03 #15 Designator Updated
    [Eth_PoE.PcbDoc]
2023-08-03 #17 eSpark BOM 20,50,100,500 and 1000 Quantity Added
    [eSpark_BOM_Ethernet-Module-v2.0.xlsx]
2023-08-03 #31 eSpark BOM 20,50,100,500 and 1000 Quantity Added
    [eSpark_BOM_LoRaWAN-Module-v2.0.xlsx]
2023-08-04 #24 #26 Design reviewed. Good to go!
    [LoRaWAN-Module-v2.0.PrjPcb, LoRaWAN_v2.0.PcbDoc]
2023-08-04 #29 eSpark BOM in progress
    [eSpark_BOM_Baseboard-v2.0.xlsx]
2023-08-04 #16 eSpark BOM in progress
    [eSpark_BOM_v2.0.xlsx]
2023-08-07 #21 Routing in Progress
    [Baseboard-v2.0.PcbDoc, Baseboard-v2.0.PrjPcb]
2023-08-08 #14 Design reviewed after @espark-asim changes. Good to go!
    [Ethernet-Module-v2.0.PrjPcb, Ethernet-Module.PcbDoc]
2023-08-08 #16 eSpark BOM Updated.
    [eSpark_BOM_EthPoE-Module-v2.0.xlsx]
2023-08-09 #15 #23 Design reviewed after @espark-asim changes. Good to go!
    [EthPoE-Module-v2.0.PrjPcb, Eth_PoE.PcbDoc]
2023-08-09 #13 D1 connections swaped
    [Module_Ethernet_Sheet.SchDoc]
2023-08-09 #27 D1 connection updated. Design good to go!
    [Ethernet-Module.PcbDoc]
2023-08-09 Routing completed with all net clear , Modification in Routing is in Progress
    [Baseboard-v2.0.PcbDoc, Baseboard-v2.0.PrjPcb]
2023-08-10 #33 STEP3D File Generated
    [Adv-OLED_v2.0.step]
2023-08-10 #21 Finalizing of Routing in Progress
    [Baseboard-v2.0.PcbDoc]
2023-08-10 #28 eSpark BOM updated.
    [eSpark_BOM_OLED-v2.0.xlsx]
2023-08-23 #21 finalizing in progress
    [Baseboard-v2.0.PcbDoc]
2023-08-24 #29 #21 C20 replaced by 10uf
    [Controller_Sheet.SchDoc]
2023-08-24 #21 PCB Design Completed
    [Baseboard-v2.0.PcbDoc]
2023-08-25 #24 Mounting Hole dia change from 2.1mm to 3mm
    [LoRaWAN_v2.0.PcbDoc]
2023-08-25 #10 Mounting Hole dia change from 2.1mm to 3mm
    [LTE-Module.PcbDoc]
2023-08-25 #15 Mounting Hole dia change from 2.1mm to 3mm
    [Eth_PoE.PcbDoc]
2023-08-25 #14 Mounting Hole dia change from 2.1mm to 3mm
    [Ethernet-Module.PcbDoc]
2023-08-25 #21 Mounting Hole dia change from 2.1mm to 3mm.
    [Baseboard-v2.0.PcbDoc, Controller_Sheet.SchDoc]
2023-08-29 #33 Moved connector J2 downwards (towards inside) of the board
    [Adv-OLED_v2.0.PcbDoc]
2023-10-06 #29 eSpark And Client BOM Updated.
    [Client_BOM_Baseboard-v2.0.xlsx, eSpark_BOM_Baseboard-v2.0.xlsx]
2023-10-06 #28 eSpark And Client BOM updated.
    [Client_BOM_OLED-v2.0.xlsx, eSpark_BOM_OLED-v2.0.xlsx]
2023-10-12 #21 changes in Placement note of R34,C28 and C39 in SCH and PCB
    [Baseboard-v2.0.PcbDoc, Controller_Sheet.SchDoc]
2023-10-12 #21 Fresh Deliverables generated.
    [Baseboard-v2.0.DWG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]
2023-10-12 Fresh Gerbers of OLEDV2.0 Generated.
    [Centroid_File_v2.0.csv, OLED-v2.0.PrjPcb, OLED_v2.0.DWG, OLED_v2.0.DXF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]
2023-10-12 #33 Fresh Deliverables Generated.
    [Adv-OLED-Sheet.SchDoc, Adv-OLED-v2.0.PrjPcb, Adv-OLED_v2.0.DWG, Adv-OLED_v2.0.DXF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]
2023-10-13 #23 Fresh Deliverables Generated for EthPoE board
    [Centroid.csv, Eth_PoE.DWG, Eth_PoE.DXF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]
2023-10-13 #27 Fresh Deliverables Generated for Ethernet Board
    [Centroid.csv, Ethernet-Module-v2.0.PrjPcb, Ethernet-Module.DWG, Ethernet-Module.DXF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]
2023-10-13 #22 Fresh Deliverables Generated for LTE Board
    [Centroid.csv, LTE-Module.DWG, LTE-Module.DXF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]
2023-10-13 #26 Fresh Deliverables Generated for Lorawan Board
    [Centroid.csv, LoRaWAN-Module-v2.0.PrjPcb, LoRaWAN_v2.0.DWG, LoRaWAN_v2.0.DXF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]
2023-10-13 Extra Files Deleted.
    [ChrisByrd-IoT_Product.PcbDoc, Connector_Sheet.SchDoc, Controller_Sheet.SchDoc, DTMF_Decoder_Sheet.SchDoc, ESP32IOTProduct.PrjPcb, Ethernet_Sheet.SchDoc, GPIOs_Expander_Relay_Sheet.SchDoc, GSM_Sheet.SchDoc]
2023-12-20 #31 Client BOM Updated
    [Client_BOM_v2.0.xlsx]
2023-12-20 #29 Glass Pipe added
    [Client_BOM_Baseboard-v2.0.xlsx, eSpark_BOM_Baseboard-v2.0.xlsx]
2023-12-20 #16 Extra Row Delete in BOM
    [eSpark_BOM_v2.0.xlsx]
2023-12-22 #29 Client BOM Final
    [Client_BOM_Baseboard-v2.0.xlsx]
2023-12-22 adv Oled eSpark and Client BOM Tft Link added
    [Client_BOM_OLED-v2.0.xlsx, eSpark_BOM_OLED-v2.0.xlsx]
2023-12-22 #17 Final Client BOM
    [Client_BOM_Ethernet-Module-v2.0.xlsx]
2023-12-22 #18 POE Injector added In Client BOM
    [Client_BOM_EthPoE-Module-v2.0.xlsx, eSpark_BOM_EthPoE-Module-v2.0.xlsx]
2023-12-22 #16 Client BOM Final
    [Client_BOM_v2.0.xlsx]
2023-12-22 #28 Client BOM 10 Boards Quantity Updated
    [Client_BOM_OLED-v2.0.xlsx]
2023-12-26 #18 eSpark BOM periperal added
    [Client_BOM_EthPoE-Module-v2.0.xlsx, eSpark_BOM_EthPoE-Module-v2.0.xlsx]
2024-02-13 #42 Order placement in progress
    [Centroid.csv, JLCPCB-BOM-EthPoE-Module-v2.0.xlsx, JLCPCB-BOM-Ethernet-Module-v2.0.xlsx, JLCPCB-BOM-LTE_MODULE_v2.0.xlsx, JLCPCB-BOM-OLED-v2.0.xlsx]
2024-02-14 #41 Baseboardv2.1 Changes Completed.
    [Baseboard-v2.0.DWG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]
2024-02-16 #42 Main Baseboard Board order 10 PCS.
    [Centroid.csv, JLCPCB-BOM-Baseboard-v2.0.xlsx]
2024-04-05 #41 All required changes done
    [Adv-OLED-Sheet.SchDoc, Adv-OLED-v2.1.PrjPcb, Adv-OLED_v2.0.DWG, Adv-OLED_v2.0.DXF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]
